diademal/nyc-tlc-wav/drawings/FF-1.pdf

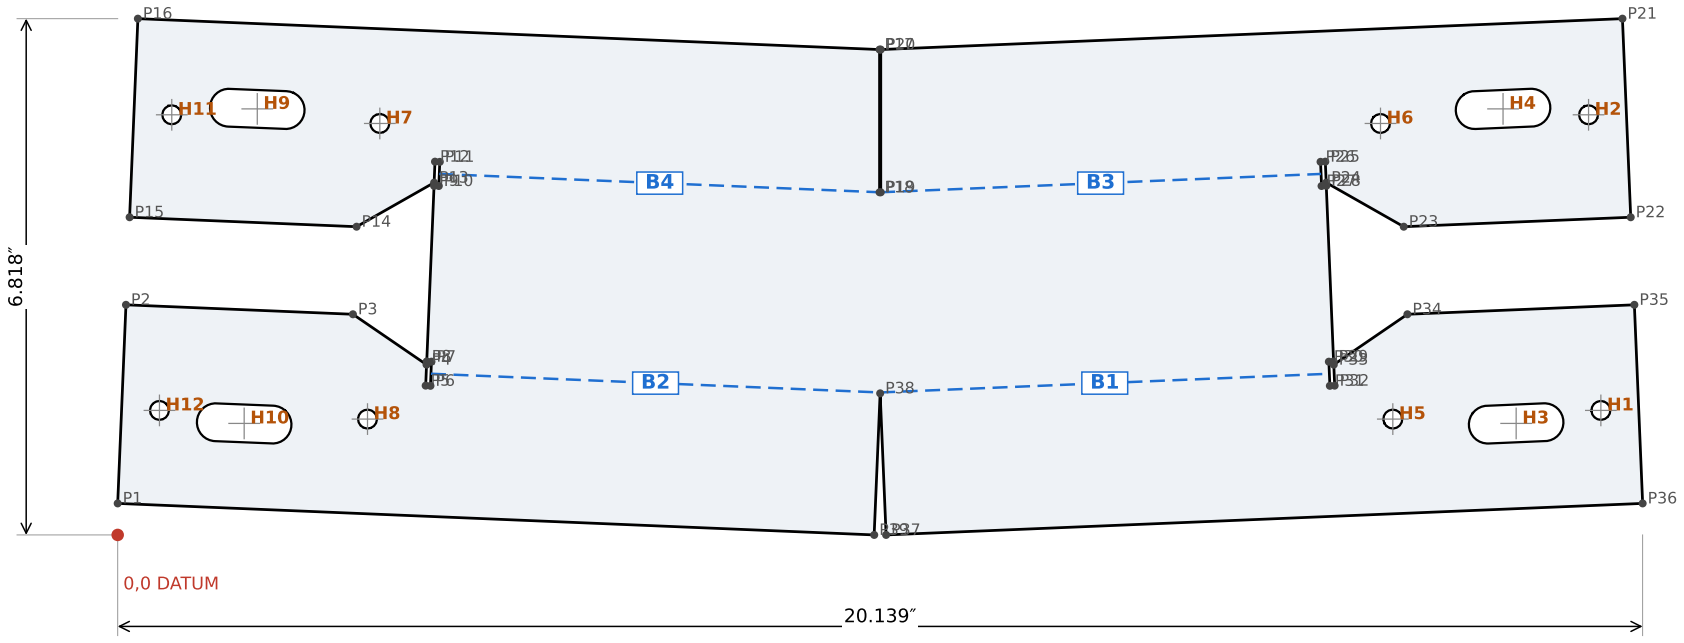
[picture p1: figure]
0,0 DATUM

FF-1 | blank 1 of 1
Channel with ears | flat pattern, one piece (4 bends 90°, web on top)

HR steel sheet 10 ga (0.135 )

QTY: 1 per vehicle

inches · flat blank, 1:1 in DXF

cut ±0.010 · bends ±1° · IR = t

Sienna WAV frame · 2026-10-02

## SHEET 1 / 1

FF-1 | blank 1 of 1
Channel with ears | flat pattern, one piece (4 bends 90°, web on top) · blank 20.139 × 6.818 · HR steel sheet 10 ga (0.135 ) · 1 per vehicle

### HOLES (centre X, Y from datum)

H1 Ø0.250 | X 19.588 | Y 1.644
H2 Ø0.250 | X 19.425 | Y 5.548
H3 slot 1.250 × 0.500 @2° X 18.469 Y 1.473 H4 slot 1.250 × 0.500 @2° X 18.296 Y 5.627
H5 Ø0.250 | X 16.840 | Y 1.530
H6 Ø0.250 | X 16.678 | Y 5.434
H7 Ø0.250 | X 3.462 | Y 5.434
H8 Ø0.250 | X 3.299 | Y 1.530
H9 slot 1.250 × 0.500 @-2° X 1.844 Y 5.627 H10 slot 1.250 × 0.500 @-2° X 1.670 Y 1.473
H11 Ø0.250 | X 0.714 | Y 5.548
H12 Ø0.250 | X 0.552 | Y 1.644

### BENDS (bend centre line, from datum) IR = t = 10 ga (0.135 )

B1 (1)/(3) 90° | (10.070, 1.881) | (16.002, 2.129)
B2 (2)/(4) 90° | (4.137, 2.129) | (10.070, 1.881)
B3 radius-bend edge | (10.070, 4.525) | (15.892, 4.768)
B4 radius-bend edge | (4.247, 4.768) | (10.070, 4.525)
radius-bend edge = start/end of a large-radius bend (bump bend between them)

### OUTLINE POINTS (X, Y from datum)

P1 | 0.000 | 0.416
P2 | 0.109 | 3.039
P3 | 3.107 | 2.914
P4 | 4.079 | 2.249
P5 | 4.067 | 1.972
P6 | 4.131 | 1.969
P7 | 4.144 | 2.288
P8 | 4.082 | 2.291
P9 | 4.178 | 4.610
P10 | 4.241 | 4.608
P11 | 4.254 | 4.927
P12 | 4.191 | 4.930
P13 | 4.179 | 4.653
P14 | 3.155 | 4.071
P15 | 0.158 | 4.196
P16 | 0.267 | 6.818
P17 | 10.062 | 6.410
P18 | 10.062 | 4.525
P19 | 10.078 | 4.525
P20 | 10.078 | 6.410
P21 | 19.873 | 6.818
P22 | 19.982 | 4.196
P23 | 16.985 | 4.071
P24 | 15.960 | 4.653
P25 | 15.949 | 4.930
P26 | 15.886 | 4.927
P27 | 15.899 | 4.608
P28 | 15.961 | 4.610
P29 | 16.058 | 2.291
P30 | 15.995 | 2.288
P31 | 16.009 | 1.969
P32 | 16.072 | 1.971
P33 | 16.061 | 2.249
P34 | 17.033 | 2.914
P35 | 20.030 | 3.039
P36 | 20.140 | 0.416
P37 | 10.148 | 0.000
P38 | 10.070 | 1.870
P39 | 9.991 | 0.000

NOTES

1. Cut from the DXF file (1:1, inches). This sheet is for checking.
2. Material: HR steel sheet 10 ga (0.135 ) (t). Inside bend radius = t.
3. Flat pattern already includes bend allowance (K = 0.44, R = t).
4. Blue dashed = bend centre lines (B1, B2 ...). = bend DOWN (away from you), no arrow = bend UP. Red dashed = drill later.
5. Deburr all edges. Curved edges: smooth arcs per DXF.
* one blank: the web is a chevron 6 +6 (ends ¼ out); bend the walls 90° down on the dashed lines, each in 2 hits (6
to the middle); outer wall has a V-notch | closes after bending, weld it; inner wall has a slit | opens ~0.16 after
bending, weld it; the ears reach past the bend line; 1/16 relief slit at the bend end
