diademal/nyc-tlc-wav/drawings/FR-2-bent.pdf

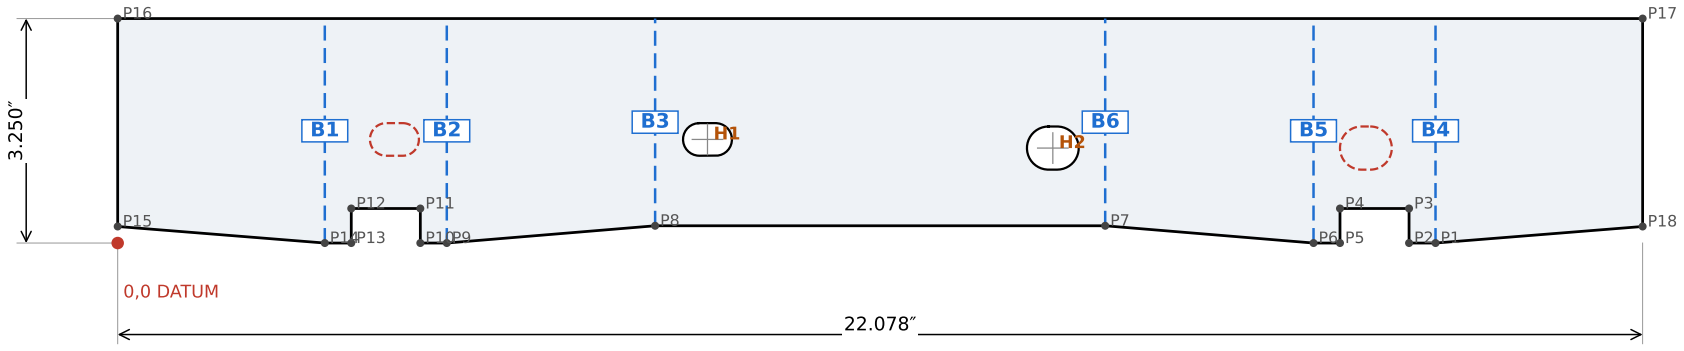
[picture p2: figure]
0,0 DATUM

## FR-2 (bent version) blank 1 of 1

FR-2 one piece (top + 2 U legs)

### HR steel sheet 10 ga (0.135 )

QTY: 1 per side · FR + FL (mirror) = 2 per vehicle inches · flat blank, 1:1 in DXF

cut ±0.010 · bends ±1° · IR = t

Sienna WAV frame · 2026-10-02

### SHEET 1 / 1

# FR-2 (bent version) blank 1 of 1

FR-2 one piece (top + 2 U legs) · blank 22.078 × 3.250 · HR steel sheet 10 ga (0.135 ) · 1 per side · FR + FL (mirror) = 2 per vehicle

HOLES (centre X, Y from datum)

## H1 slot 0.709 × 0.472 @0° X 8.539 Y 1.500 H2 slot 0.750 × 0.625 @0° X 13.539 Y 1.375

DRILL AFTER WELDING (red dashed | do NOT laser cut)
D1 slot 0.709 × 0.472 | X 4.007 Y 1.500
D2 slot 0.750 × 0.625 | X 18.072 Y 1.375

BENDS (bend centre line, from datum) IR = t = 10 ga (0.135 )
B1 (1) 90° | (2.999, 0.000) | (2.999, 3.250)
B2 (3) 90° | (4.765, 0.000) | (4.765, 3.250)
B3 (5) 90° | (7.781, 0.250) | (7.781, 3.250)
B4 (2) 90° | (19.080, 0.000) | (19.080, 3.250)
B5 (4) 90° | (17.314, 0.000) | (17.314, 3.250)
B6 (6) 90° | (14.297, 0.250) | (14.297, 3.250)

OUTLINE POINTS (X, Y from datum)
P1 | 19.080 | 0.000
P2 | 18.697 | 0.000
P3 | 18.697 | 0.500
P4 | 17.697 | 0.500
P5 | 17.697 | 0.000
P6 | 17.314 | 0.000
P7 | 14.297 | 0.250
P8 | 7.781 | 0.250
P9 | 4.765 | 0.000
P10 | 4.382 | 0.000
P11 | 4.382 | 0.500
P12 | 3.382 | 0.500
P13 | 3.382 | 0.000
P14 | 2.999 | 0.000
P15 | 0.000 | 0.240
P16 | 0.000 | 3.250
P17 | 22.078 | 3.250
P18 | 22.078 | 0.240

NOTES
1. Cut from the DXF file (1:1, inches). This sheet is for checking.
2. Material: HR steel sheet 10 ga (0.135 ) (t). Inside bend radius = t.
3. Flat pattern already includes bend allowance (K = 0.44, R = t).
4. Blue dashed = bend centre lines (B1, B2 ...). = bend DOWN (away from you), no arrow = bend UP. Red dashed = drill later.
5. Deburr all edges. Curved edges: smooth arcs per DXF.
6. FR side as drawn; FL side = mirror image (flip the blank).
* one blank, 6 bends 90° the same way (R = t): inner walls first, then the bottoms, then the outer walls; top ovals laser cut; do NOT cut the leg-bottom ovals drill after welding through the top ovals; ½ notch at the front edge of
