diademal/nyc-tlc-wav/drawings/FR-7-bent.pdf

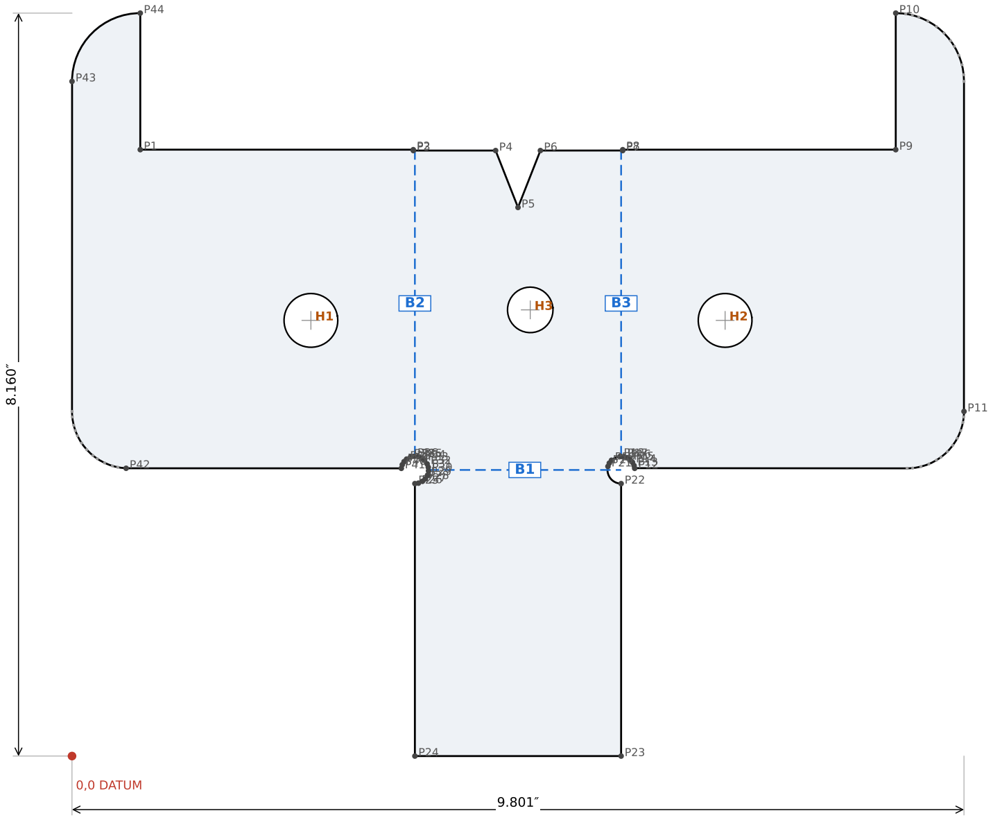
[picture p3: figure]
0,0 DATUM

## FR-7 (bent version) blank 1 of 1

FR-7 one piece (back + bottom + 2 sides)

HR steel sheet 10 ga (0.135 )

QTY: 1 per side · FR + FL (mirror) = 2 per vehicle inches · flat blank, 1:1 in DXF

cut ±0.010 · bends ±1° · IR = t

Sienna WAV frame · 2026-10-02

### SHEET 1 / 1

# FR-7 (bent version) blank 1 of 1

FR-7 one piece (back + bottom + 2 sides) · blank 9.801 × 8.160 · HR steel sheet 10 ga (0.135 ) · 1 per side · FR + FL (mirror) = 2 per vehicle

HOLES (centre X, Y from datum)
H1 Ø0.591 | X 2.625 | Y 4.785
H2 Ø0.591 | X 7.176 | Y 4.785
H3 Ø0.500 | X 5.035 | Y 4.901
BENDS (bend centre line, from datum) IR = t = 10 ga (0.135 )
B1 (1) 90° | (3.918, 3.143) | (6.034, 3.143)
B2 (2) 90° | (3.768, 3.293) | (3.768, 6.651)
B3 (3) 90° | (6.034, 3.293) | (6.034, 6.651)
CURVED EDGES (radius, centre X, Y)
R1 R 0.150 | centre 6.034, 3.143
R2 R 0.150 | centre 6.034, 3.143
R3 R 0.750 | centre 0.750, 7.410
OUTLINE POINTS (X, Y from datum)
P1 | 0.750 | 6.660
P2 | 3.750 | 6.660
P3 | 3.750 | 6.651
P4 | 4.655 | 6.651
P5 | 4.901 | 6.026
P6 | 5.147 | 6.651
P7 | 6.051 | 6.651
P8 | 6.051 | 6.660
P9 | 9.051 | 6.660
P10 | 9.052 | 8.160
P11 | 9.802 | 3.785
P12 | 6.183 | 3.160
P13 | 6.176 | 3.191
P14 | 6.159 | 3.226
P15 | 6.133 | 3.255
P16 | 6.100 | 3.277
P17 | 6.063 | 3.290
P18 | 6.024 | 3.292
P19 | 5.928 | 3.249
P20 | 5.904 | 3.218
P21 | 5.889 | 3.181
P22 | 6.034 | 2.993
P23 | 6.034 | 0.000
P24 | 3.768 | 0.000
P25 | 3.768 | 2.993
P26 | 3.806 | 2.998
P27 | 3.851 | 3.018
P28 | 3.880 | 3.044
P29 | 3.906 | 3.085
P30 | 3.917 | 3.133
P31 | 3.915 | 3.172
P32 | 3.902 | 3.209
P33 | 3.874 | 3.249
P34 | 3.843 | 3.272
P35 | 3.806 | 3.288
P36 | 3.758 | 3.292
P37 | 3.719 | 3.285
P38 | 3.676 | 3.262
P39 | 3.649 | 3.234
P40 | 3.629 | 3.200
P41 | 3.619 | 3.160
P42 | 0.594 | 3.161
P43 | 0.000 | 7.410
P44 | 0.750 | 8.160
FREE-FORM CURVE 1 (grey dots, follow DXF) | points X, Y
9.162 | 8.152
9.234 | 8.138
9.304 | 8.116
9.405 | 8.072

NOTES

1. Cut from the DXF file (1:1, inches). This sheet is for checking.
2. Material: HR steel sheet 10 ga (0.135 ) (t). Inside bend radius = t.
3. Flat pattern already includes bend allowance (K = 0.44, R = t).
4. Blue dashed = bend centre lines (B1, B2 ...). = bend DOWN (away from you), no arrow = bend UP. Red dashed = drill later.
5. Deburr all edges. Curved edges: smooth arcs per DXF.
6. FR side as drawn; FL side = mirror image (flip the blank).
* one blank, 3 bends 90° the same way (R = t): bottom first, then the sides; Ø0.3 round reliefs in the two corners; after bending weld the side-to-bottom seams; V notch and Ø0.5 hole in the back, Ø0.591 holes in the sides

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
