diademal/nyc-tlc-wav/drawings/FR-6.pdf

FR-6 tubes | | inches · flat blank, 1:1 in DXF | Sienna WAV frame · 2026-10-02
Tube 3×3 cut 14 ¼ | QTY: 1 per side · FR + FL (mirror) = 2 per vehicle | cut ±0.010 · bends ±1° · IR = t | SHEET 1 / 1

# FR-6 cut list (tubes)

# Tube 3×3 cut 14 ¼

Stock: Square tube 3 × 3 , wall 3/16 | · cut length 14.250 | · QTY 1 per side · FR + FL (mirror) = 2 per vehicle

wall 3/16

Cut square, ±1/32 . Deburr. Lengths in inches.
