diademal/nyc-tlc-wav/drawings/LASER/STAINLESS_18ga_sheet1_of1_12x24.pdf

STAINLESS 18ga — sheet 1 of 1 — 12 x 24 in — 1 parts — 1 vehicle set (RA-9) — Stainless 304 brushed (#4), 18 ga, t = 0.048 in (1.2 mm)

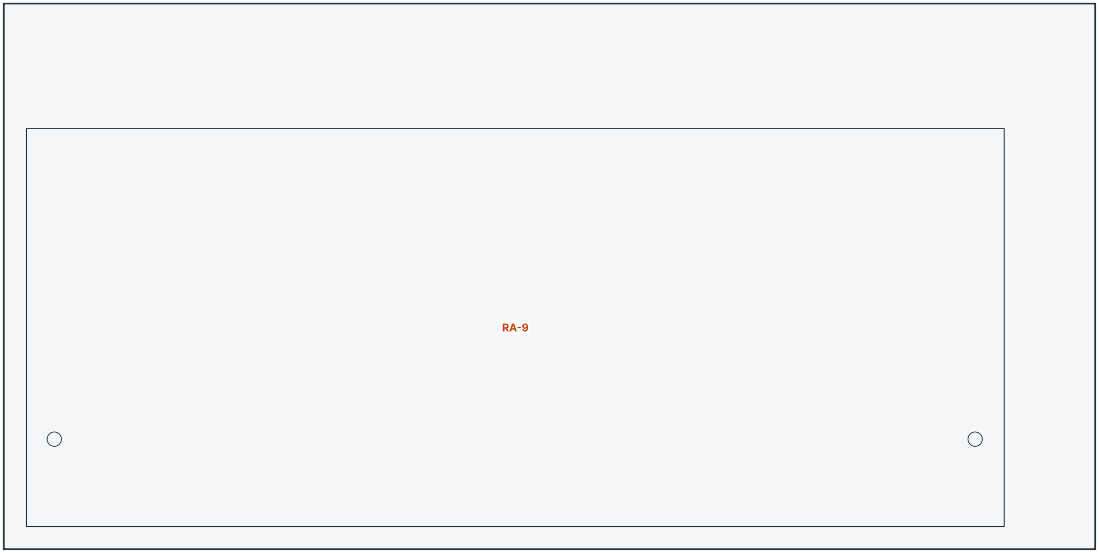
[picture p4: figure]
