diademal/nyc-tlc-wav/drawings/MFG/00_INDEX.pdf

Item | Material / thickness | Flat (in) | Bend lines | Qty / vehicle | lb each | Process
FR-1 | HR steel A1011 CS, 11 ga 0.1196″ (3.04 mm) | 8.538 × 13.853 | 2 | 1 FR + 1 FL | 2.04 | laser + 2 bends
FR-2 | HR steel A1011 CS, 11 ga 0.1196″ (3.04 mm) | 22.264 × 3.250 | 6 | 1 FR + 1 FL | 2.27 | laser + 6 bends + weld
FR-3 | HR steel A1011 CS, 11 ga 0.1196″ (3.04 mm) | 4.084 × 8.000 | 2 | 1 FR + 1 FL | 1.03 | laser + 2 bends
FR-4-1 strip | HR steel A1011 CS, 11 ga 0.1196″ (3.04 mm) | 18.827 × 2.746 | 9 | 1 FR + 1 FL | 1.63 | laser + 5 bends (2 radius)
FR-4-2 side A | HR steel A1011 CS, 11 ga 0.1196″ (3.04 mm) | 6.500 × 6.875 | 0 | 1 FR + 1 FL | 0.71 | laser
FR-4-3 side B | HR steel A1011 CS, 11 ga 0.1196″ (3.04 mm) | 6.500 × 6.875 | 0 | 1 FR + 1 FL | 0.71 | laser
FR-5 | HR steel A1011 CS, 11 ga 0.1196″ (3.04 mm) | 10.694 × 6.198 | 2 | 1 FR + 1 FL | 1.41 | laser + 2 bends
FR-7 | HR steel A1011 CS, 11 ga 0.1196″ (3.04 mm) | 9.853 × 8.186 | 3 | 1 FR + 1 FL | 1.45 | laser + 3 bends + weld
FR-8 | HR steel A1011 CS, 11 ga 0.1196″ (3.04 mm) | 6.209 × 12.000 | 2 | 1 FR + 1 FL | 1.79 | laser + 2 bends
FR-10-1 U-body | HR steel A1011 CS, 11 ga 0.1196″ (3.04 mm) | 12.374 × 11.235 | 3 | 1 FR + 1 FL | 2.29 | laser + 3 bends + drill
FR-10-2 strip | HR steel A1011 CS, 11 ga 0.1196″ (3.04 mm) | 12.560 × 2.746 | 3 | 1 FR + 1 FL | 1.05 | laser + 3 bends
FR-11 | HR steel A1011 CS, 11 ga 0.1196″ (3.04 mm) | 5.125 × 2.000 | 0 | 2 FR + 2 FL | 0.25 | laser
FF-1 | HR steel A1011 CS, 11 ga 0.1196″ (3.04 mm) | 20.142 × 6.870 | 4 | 1 | 3.89 | laser + 4 bends + weld
FF-3-1 top | HR steel A1011 CS, 11 ga 0.1196″ (3.04 mm) | 39.403 × 15.073 | 10 | 1 | 17.70 | laser + 10 bends
FF-3-2 lower | HR steel A1011 CS, 11 ga 0.1196″ (3.04 mm) | 39.000 × 14.595 | 2 | 1 | 16.12 | laser + 2 bends
FF-3-3 wall | HR steel A1011 CS, 11 ga 0.1196″ (3.04 mm) | 4.687 × 1.125 | 0 | 2 | 0.18 | laser
FF-3-4 wall | HR steel A1011 CS, 11 ga 0.1196″ (3.04 mm) | 5.013 × 1.125 | 0 | 2 | 0.19 | laser
RA-1 | Aluminum 5052-H32, 0.125″ (3.18 mm) | 22.000 × 34.566 | 2 | 1 | 8.07 | laser + bends
RA-2 | Aluminum 5052-H32, 0.125″ (3.18 mm) | 23.533 × 34.941 | 3 | 1 | 9.87 | laser + bends
RA-3 | Aluminum 5052-H32, 0.125″ (3.18 mm) | 19.658 × 45.066 | 3 | 1 | 9.10 | laser + bends
RA-4 | Aluminum 5052-H32, 0.125″ (3.18 mm) | 6.691 × 33.500 | 2 | 1 | 2.69 | laser + bends
RA-5 | Aluminum 5052-H32, 0.125″ (3.18 mm) | 9.783 × 33.500 | 1 | 1 | 2.37 | laser + bends
RA-6 | Aluminum 5052-H32, 0.125″ (3.18 mm) | 3.066 × 30.000 | 2 | 1 | 1.11 | laser + bends
RA-7 | Aluminum 5052-H32, 0.125″ (3.18 mm) | 40.631 × 22.556 | 4 | 1 | 10.30 | laser + bends
RA-8 | Aluminum 5052-H32, 0.125″ (3.18 mm) | 4.625 × 4.066 | 2 | 2 | 0.18 | laser + bends
FR-4 tube | DOM OD 1.500 × ID 1.181 (wall 0.160″) | cut 3.689 | — | 1 FR + 1 FL | | saw
FR-6 | Sq. tube 3×3 A500, wall 11 ga 0.120″ | cut 14.250 | — | 1 FR + 1 FL | | saw
FR-9 | Sq. tube 3×3 A500, wall 11 ga 0.120″ | cut 8.000 | — | 1 FR + 1 FL | | saw
FR-10 tube | DOM OD 1.500 × ID 1.181 (wall 0.160″) | cut 3.407 | — | 1 FR + 1 FL | | saw
FF-4 | Sq. tube 1½×1½ A500, wall 11 ga 0.120″ | cut 39.000 | — | 1 | | saw

# Sienna WAV — manufacturing package REV B (2026-10-31): frame + ramp

Frame: everything that was 10 ga is now 11 ga (0.1196″); square tubes 11 ga wall. Ramp: aluminum 5052-H32 0.125″. Units inch. Inside bend radius = t, K = 0.44.
