diademal/nyc-tlc-wav/drawings/MFG/FR-5_drawing.pdf

## MATERIAL: HR steel sheet A1011 CS THICKNESS: 11 ga t = 0.1196″ (3.04 mm)

2.056

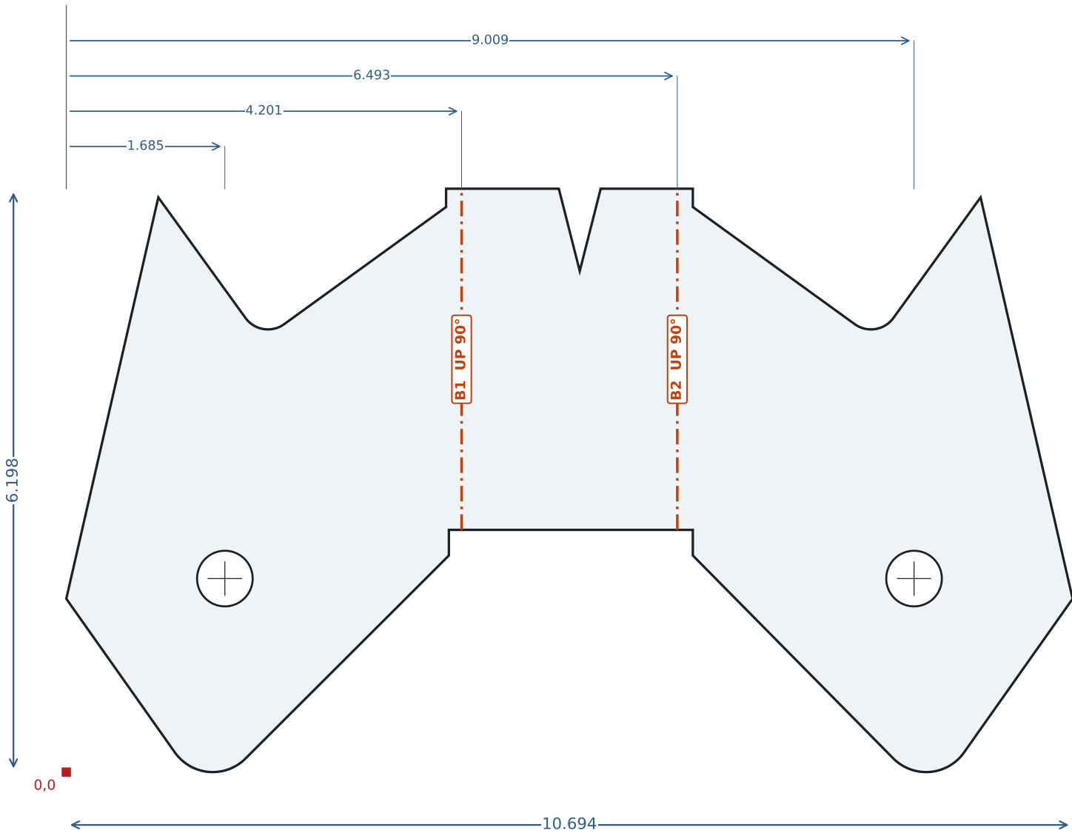
[picture p21: figure]

### FR-5 · 11 ga 0.120″ (3.04 mm) · HR steel sheet A1011 CS

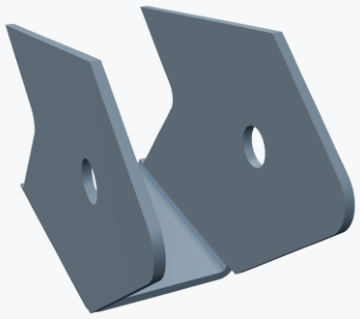
[picture p22: figure]

(shape; thickness now 11 ga 0.120″)

FR-5 | U-body bracket

FR-5 · U-body (2 sides + plate A-C)

HR steel sheet A1011 CS 11 ga 0.120″ (3.04 mm)

QTY 1 FR + 1 FL = 2 per vehicle

Units: inch · NOT TO SCALE

Tol.: cut ±0.010″ · bend ±1° · IR = t

Sienna WAV frame

2026-10-31

## REV B

### SHEET 1/1

# FR-5 · U-body (2 sides + plate A-C)

11 ga 0.120″ (3.04 mm) · HR steel sheet A1011 CS · flat blank 10.694″ × 6.198″ · ≈ 1.41 lb each · QTY 1 FR + 1 FL = 2 per vehicle

FLAT PATTERN (as laser-cut, marked side up) | FORMED PART (after bending)

## BEND TABLE

Bend | Angle | Direction | Inside R | Order | Bend line position
B1 | 90.0° | UP (toward) | R=t 0.120 | 1 | X = 4.201
B2 | 90.0° | UP (toward) | R=t 0.120 | 2 | X = 6.493

## HOLES (centre from 0,0)

Hole | Size | X | Y | Made by
H1 | Ø0.591 | 1.685 | 2.056 | laser
H2 | Ø0.591 | 9.009 | 2.056 | laser

## FILES

- FR-5_FR_cut.dxf (right, qty 1 / vehicle)
- FR-5_FL_cut.dxf (left = mirror, qty 1 / vehicle)
- FR-5_ref.dxf (reference: + bend lines, drill-later, material notes)

## NOTES

1. Laser cut from the *_cut.dxf file (1:1, inch). The DXF governs the geometry; dimensions here are for checking.
2. MATERIAL HR steel sheet A1011 CS, 11 ga t = 0.1196″ (3.04 mm). Bend allowance (K = 0.44, inside radius = t) is already in the flat.

Bend on the orange lines; UP = toward you when the part lies as drawn.
3. Holes marked DRILL LATER (red dashed) are not laser cut - drill after bending/welding.
4. Deburr all edges, remove dross.
5. Right part (FR) shown. Left part (FL) = mirror: cut *_FL_cut.dxf, bend the same UP/DOWN. * 90° bends, R = t
