diademal/nyc-tlc-wav/drawings/MFG/FR-7_drawing.pdf

## MATERIAL: HR steel sheet A1011 CS THICKNESS: 11 ga t = 0.1196″ (3.04 mm)

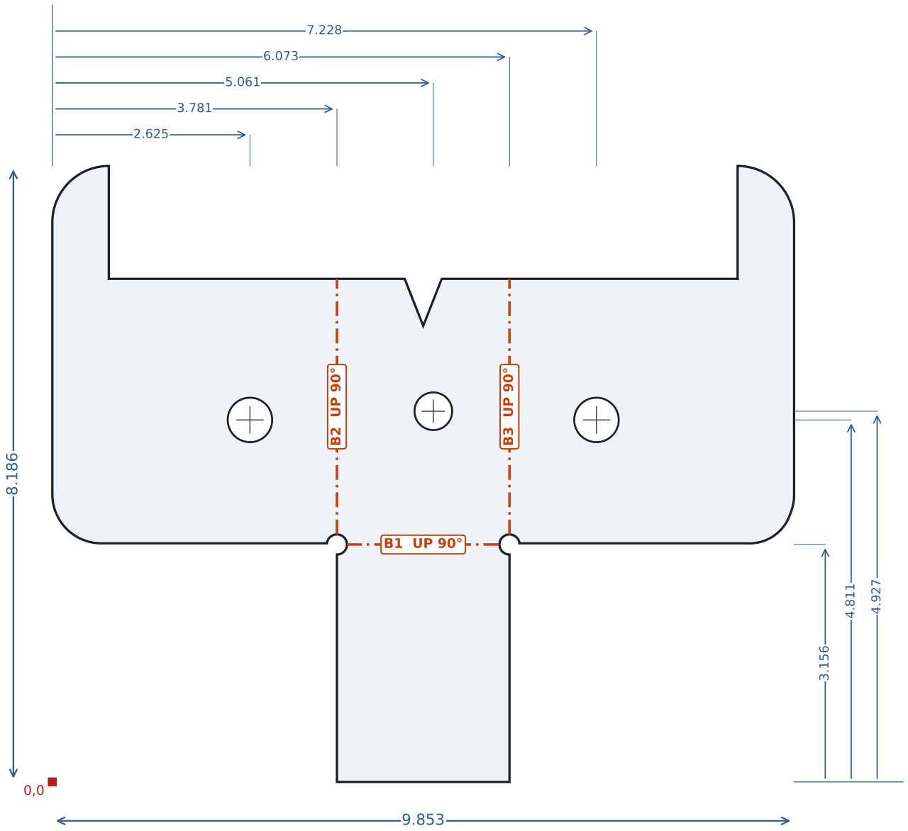
[picture p23: figure]

### FR-7 · 11 ga 0.120″ (3.04 mm) · HR steel sheet A1011 CS

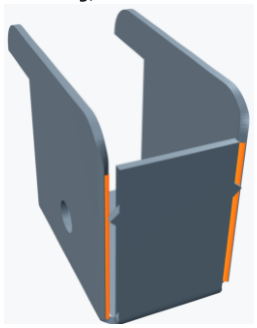
[picture p24: figure]

(shape; thickness now 11 ga 0.120″)

FR-7 | Tray bracket (back + bottom + 2 sides)

FR-7 · FR-7 one piece (back + bottom + 2 sides)

HR steel sheet A1011 CS 11 ga 0.120″ (3.04 mm)

QTY 1 FR + 1 FL = 2 per vehicle

Units: inch · NOT TO SCALE

Tol.: cut ±0.010″ · bend ±1° · IR = t

Sienna WAV frame

2026-10-31

## REV B

### SHEET 1/1

# FR-7 · FR-7 one piece (back + bottom + 2 sides)

11 ga 0.120″ (3.04 mm) · HR steel sheet A1011 CS · flat blank 9.853″ × 8.186″ · ≈ 1.45 lb each · QTY 1 FR + 1 FL = 2 per vehicle

FLAT PATTERN (as laser-cut, marked side up) | FORMED PART (after bending)

## BEND TABLE

Bend | Angle | Direction | Inside R | Order | Bend line position
B1 | 90.0° | UP (toward) | R=t 0.120 | 1 | Y = 3.156
B2 | 90.0° | UP (toward) | R=t 0.120 | 2 | X = 3.781
B3 | 90.0° | UP (toward) | R=t 0.120 | 3 | X = 6.073

## HOLES (centre from 0,0)

Hole | Size | X | Y | Made by
H1 | Ø0.591 | 2.625 | 4.811 | laser
H2 | Ø0.500 | 5.061 | 4.927 | laser
H3 | Ø0.591 | 7.228 | 4.811 | laser

## FILES

- FR-7_FR_cut.dxf (right, qty 1 / vehicle)
- FR-7_FL_cut.dxf (left = mirror, qty 1 / vehicle)
- FR-7_ref.dxf (reference: + bend lines, drill-later, material notes)

## NOTES

1. Laser cut from the *_cut.dxf file (1:1, inch). The DXF governs the geometry; dimensions here are for checking.
2. MATERIAL HR steel sheet A1011 CS, 11 ga t = 0.1196″ (3.04 mm). Bend allowance (K = 0.44, inside radius = t) is already in the flat.

Bend on the orange lines; UP = toward you when the part lies as drawn.
3. Holes marked DRILL LATER (red dashed) are not laser cut - drill after bending/welding.
4. Deburr all edges, remove dross.
5. Right part (FR) shown. Left part (FL) = mirror: cut *_FL_cut.dxf, bend the same UP/DOWN.
* one blank, 3 bends 90° the same way (R = t): bottom first, then the sides; Ø0.3 round reliefs in the two corners; after bending weld the side-to-

bottom seams; V notch and Ø0.5 hole in the back, Ø0.591 holes in the sides
