diademal/nyc-tlc-wav/drawings/LASER/ALUMINUM_0.125_sheet1_of1_48x96.webp

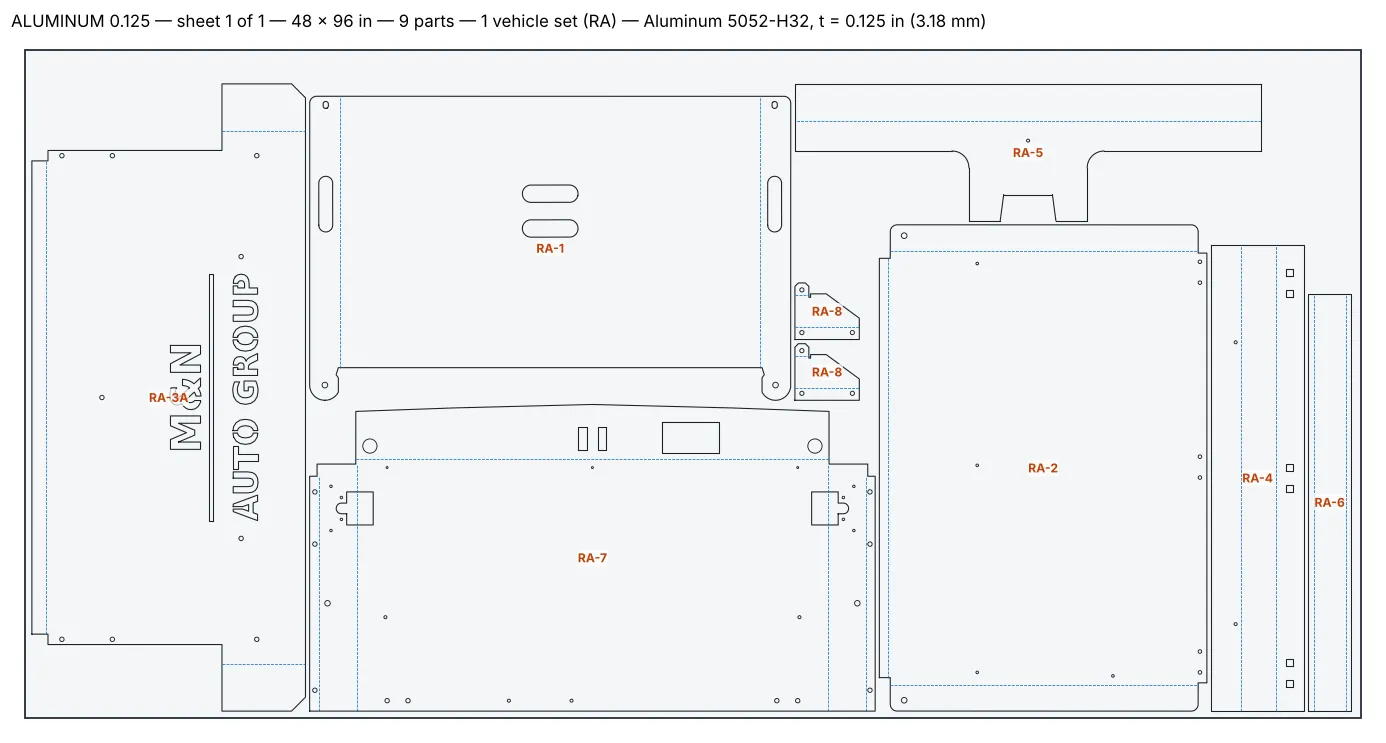
drawings/LASER/ALUMINUM_0.125_sheet1_of1_48x96.webp
