diademal/nyc-tlc-wav/drawings/LASER/STAINLESS_18ga_sheet1_of1_12x24.webp

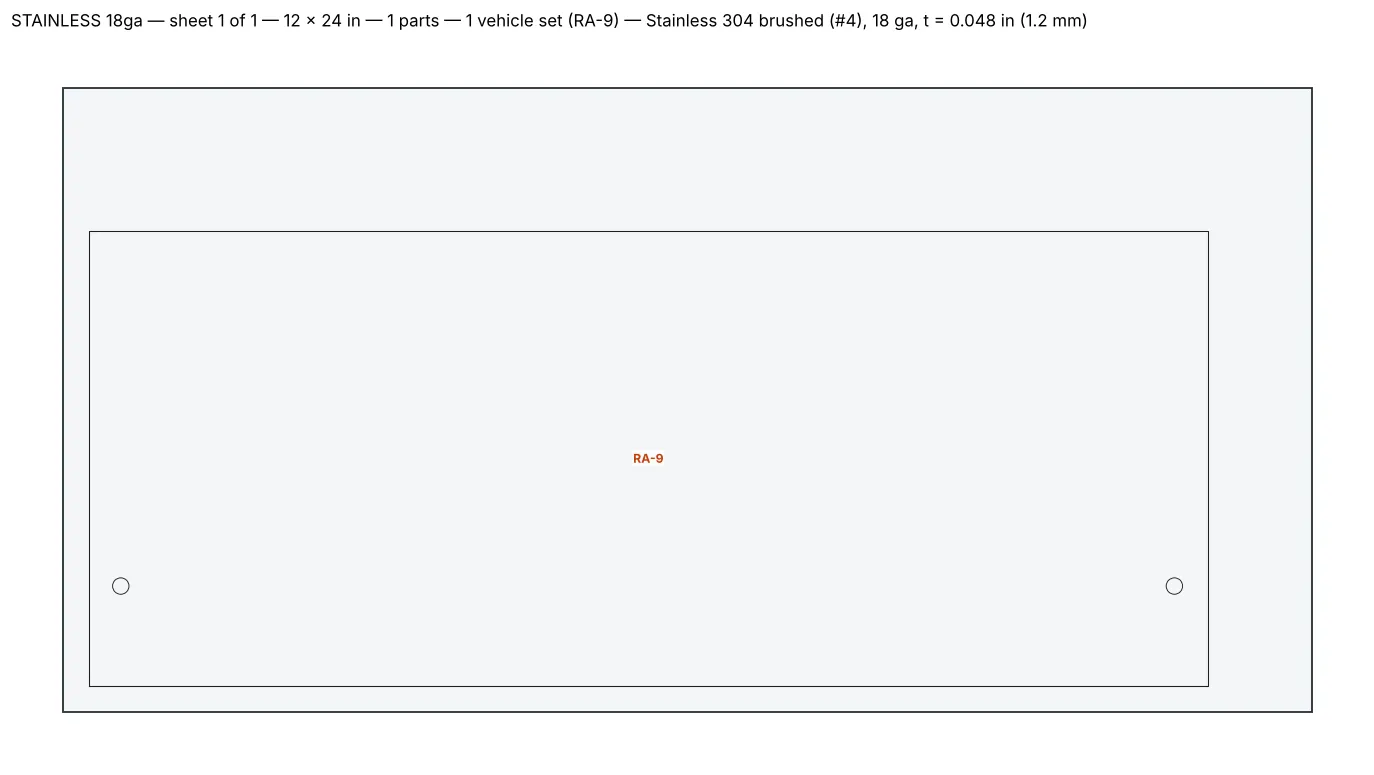
drawings/LASER/STAINLESS_18ga_sheet1_of1_12x24.webp
