diademal/nyc-tlc-wav/drawings/LASER/STEEL_11ga_sheet1_of1_48x96.webp

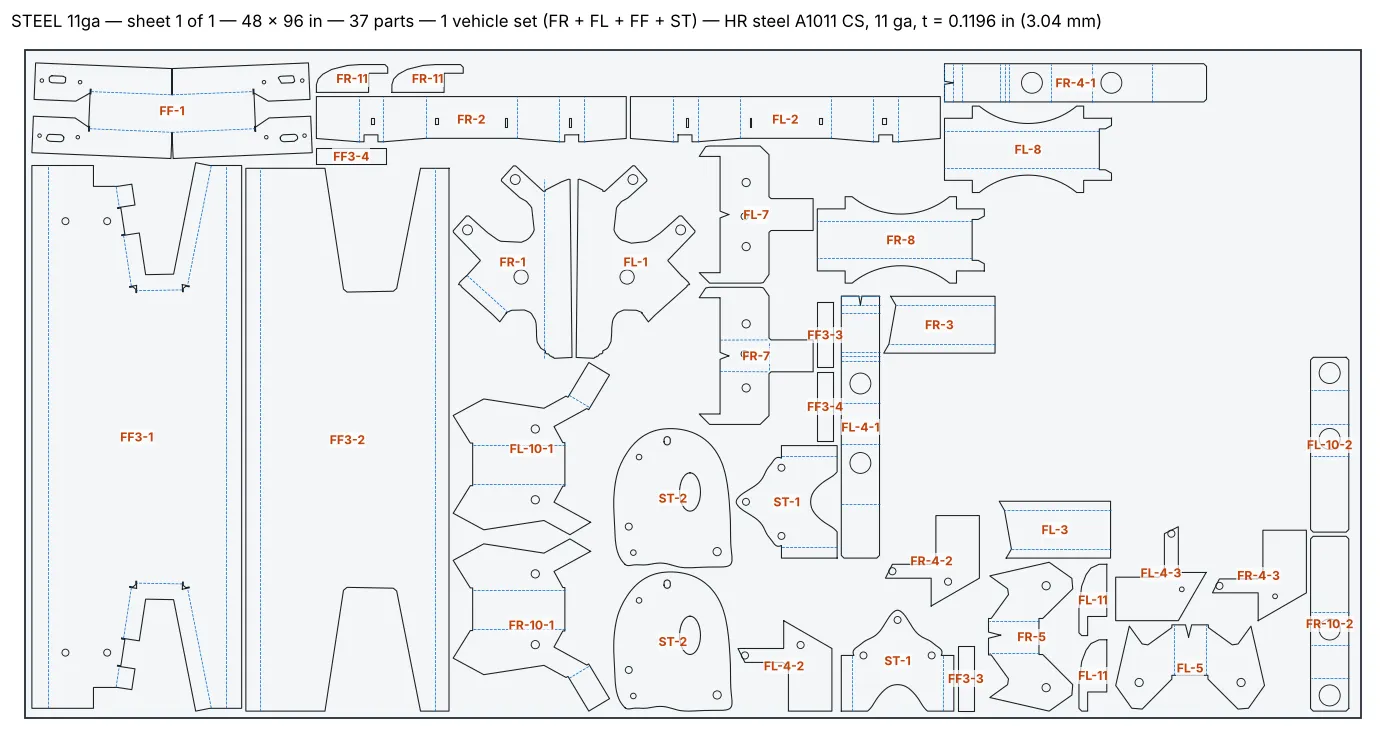
drawings/LASER/STEEL_11ga_sheet1_of1_48x96.webp
