diademal/nyc-tlc-wav/drawings/MFG/RA-1_preview.webp

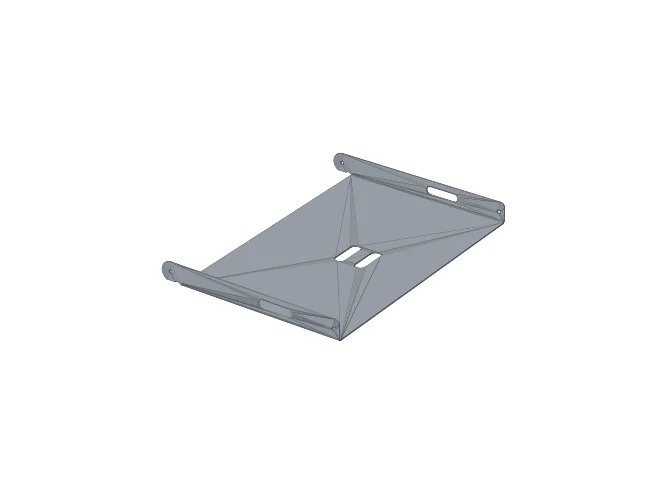
drawings/MFG/RA-1_preview.webp
