diademal/nyc-tlc-wav/drawings/MFG/RA-3_preview.webp

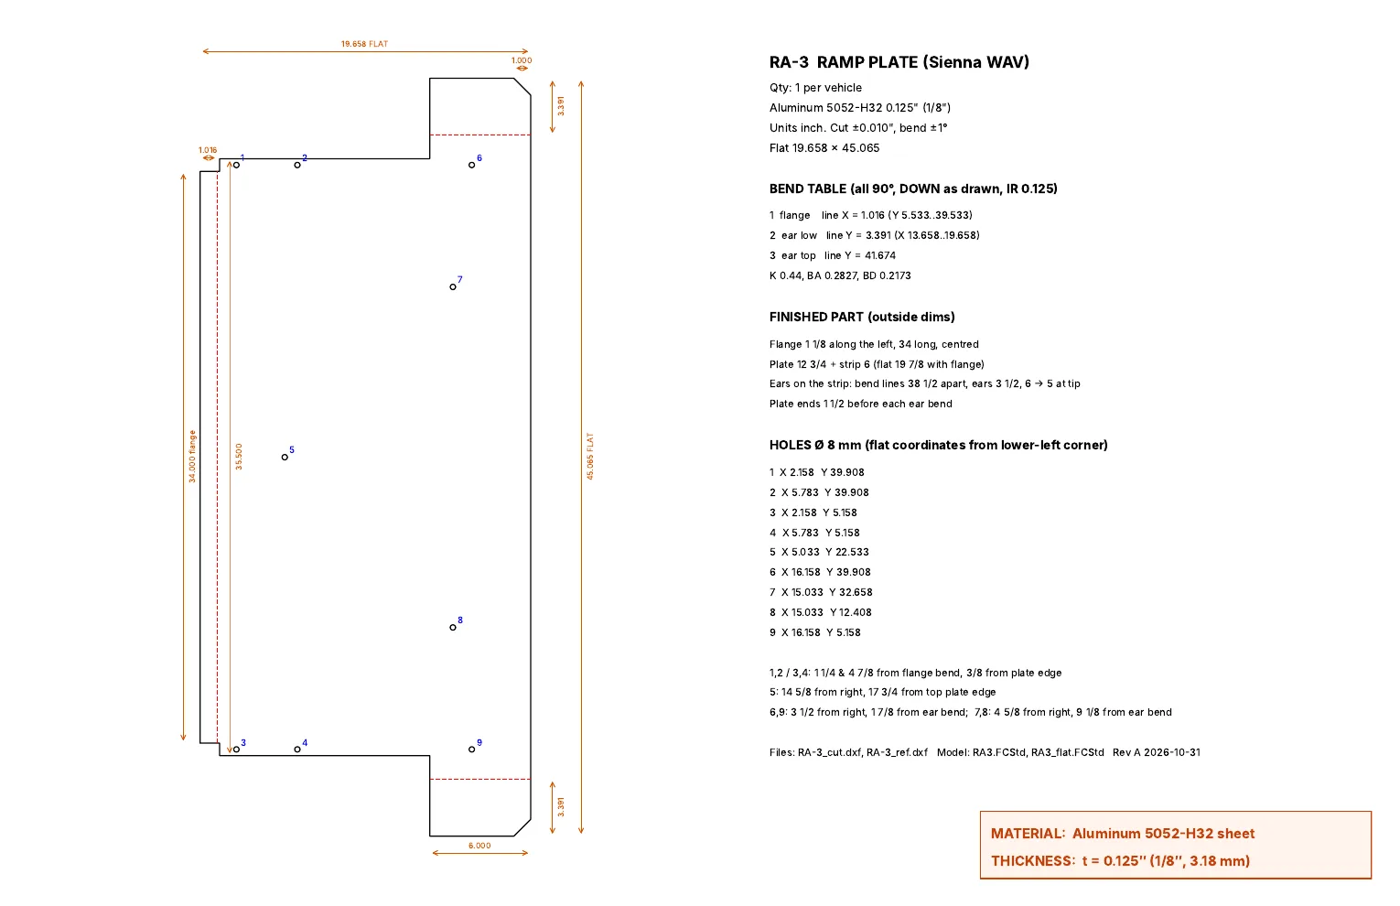
drawings/MFG/RA-3_preview.webp
