diademal/nyc-tlc-wav/drawings/MFG/RA-3A_preview.webp

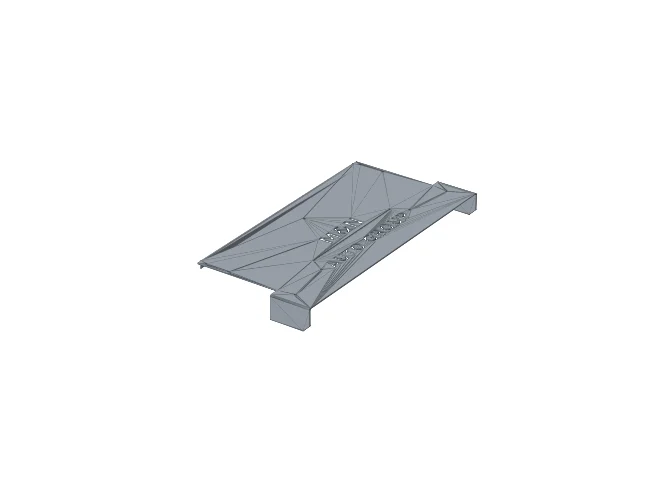
drawings/MFG/RA-3A_preview.webp
