diademal/nyc-tlc-wav/drawings/MFG/RA-4_preview.webp

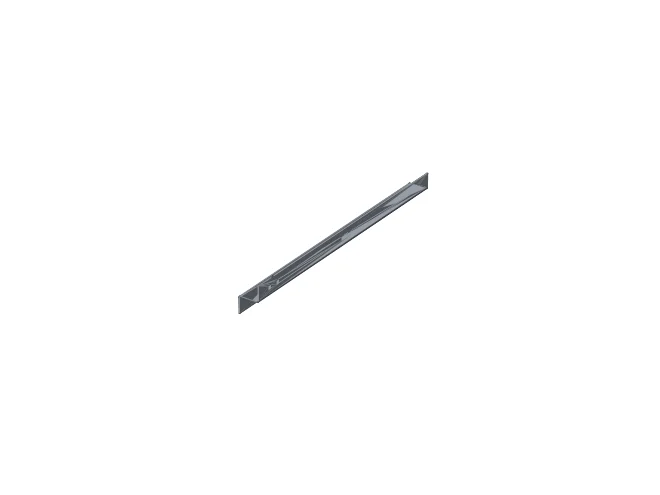
drawings/MFG/RA-4_preview.webp
