diademal/nyc-tlc-wav/drawings/MFG/RA-5_preview.webp

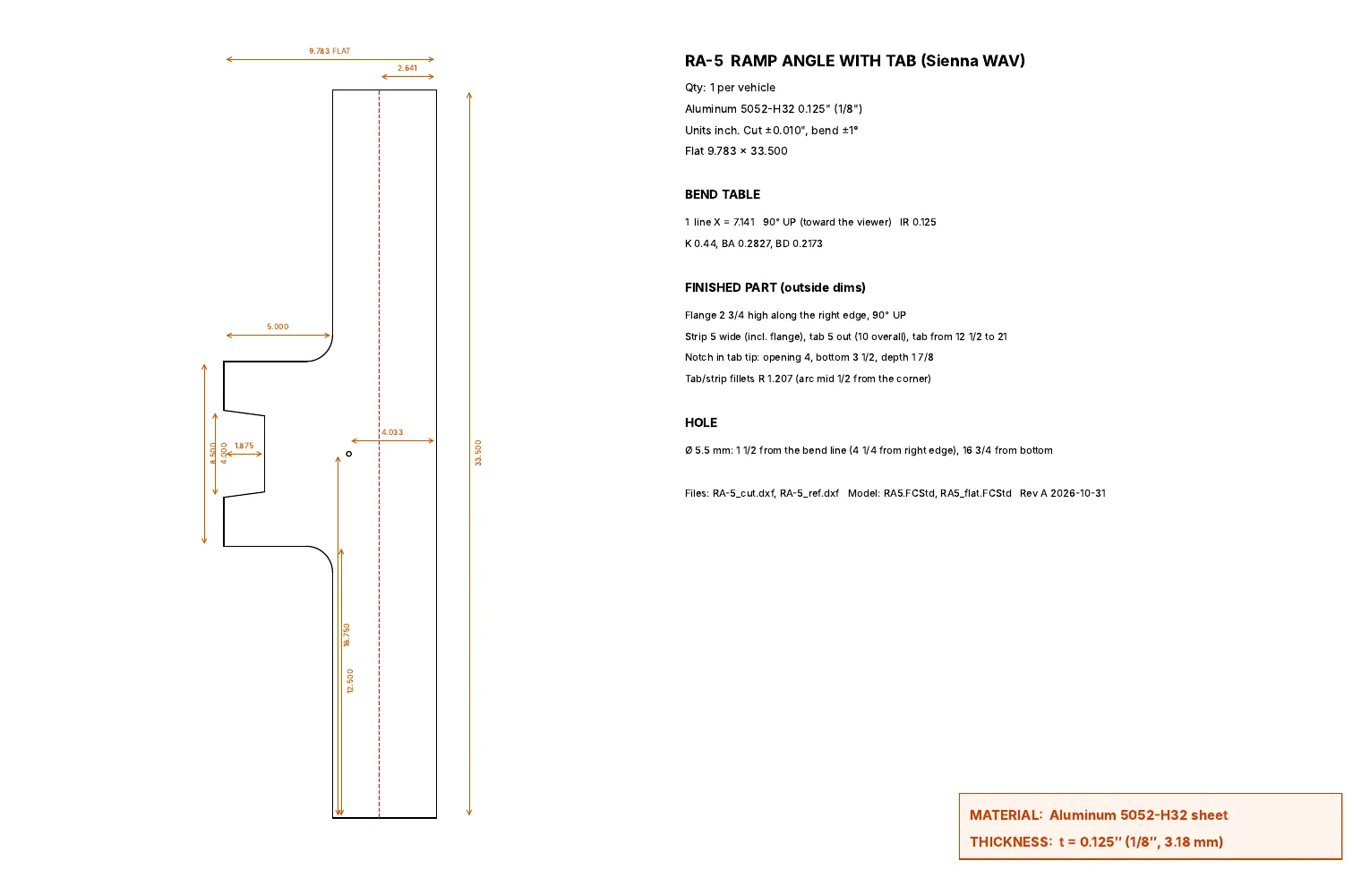
drawings/MFG/RA-5_preview.webp
