diademal/nyc-tlc-wav/drawings/MFG/RA-6_preview.webp

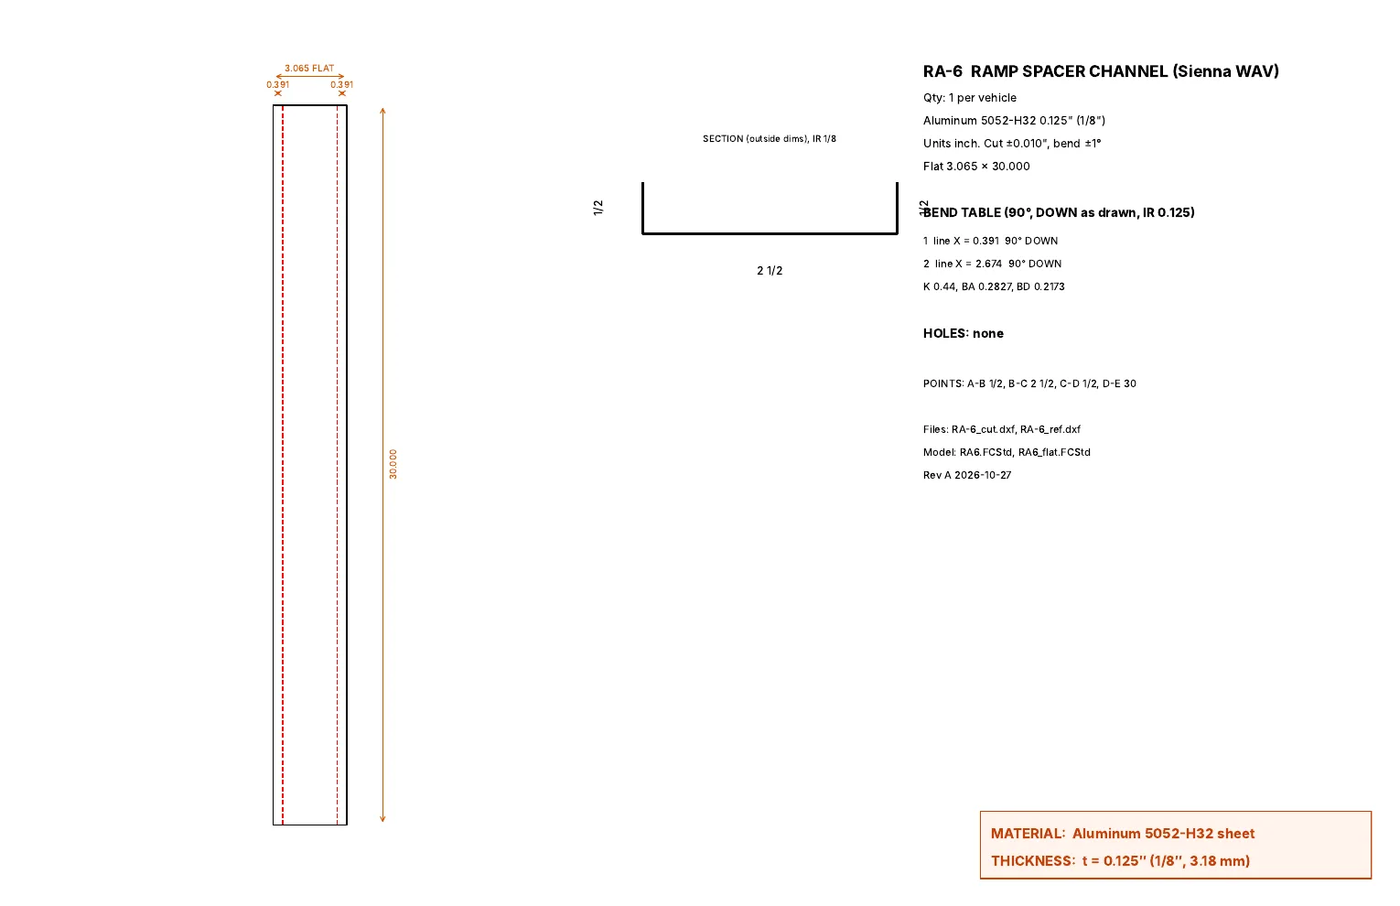
drawings/MFG/RA-6_preview.webp
