diademal/nyc-tlc-wav/drawings/MFG/RA-7_preview.webp

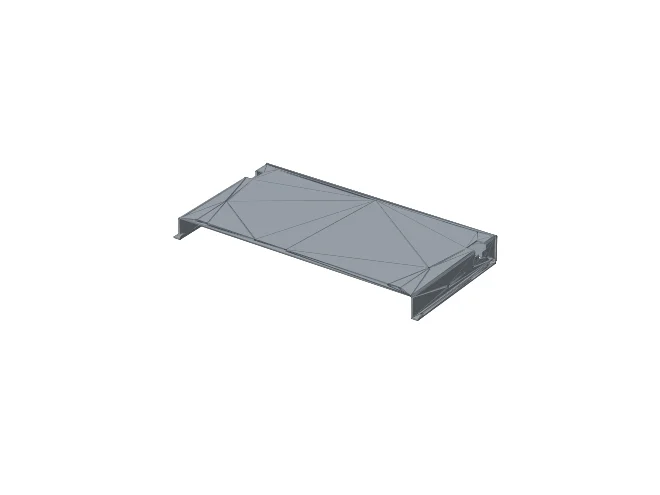
drawings/MFG/RA-7_preview.webp
