diademal/nyc-tlc-wav/drawings/MFG/RA-8_preview.webp

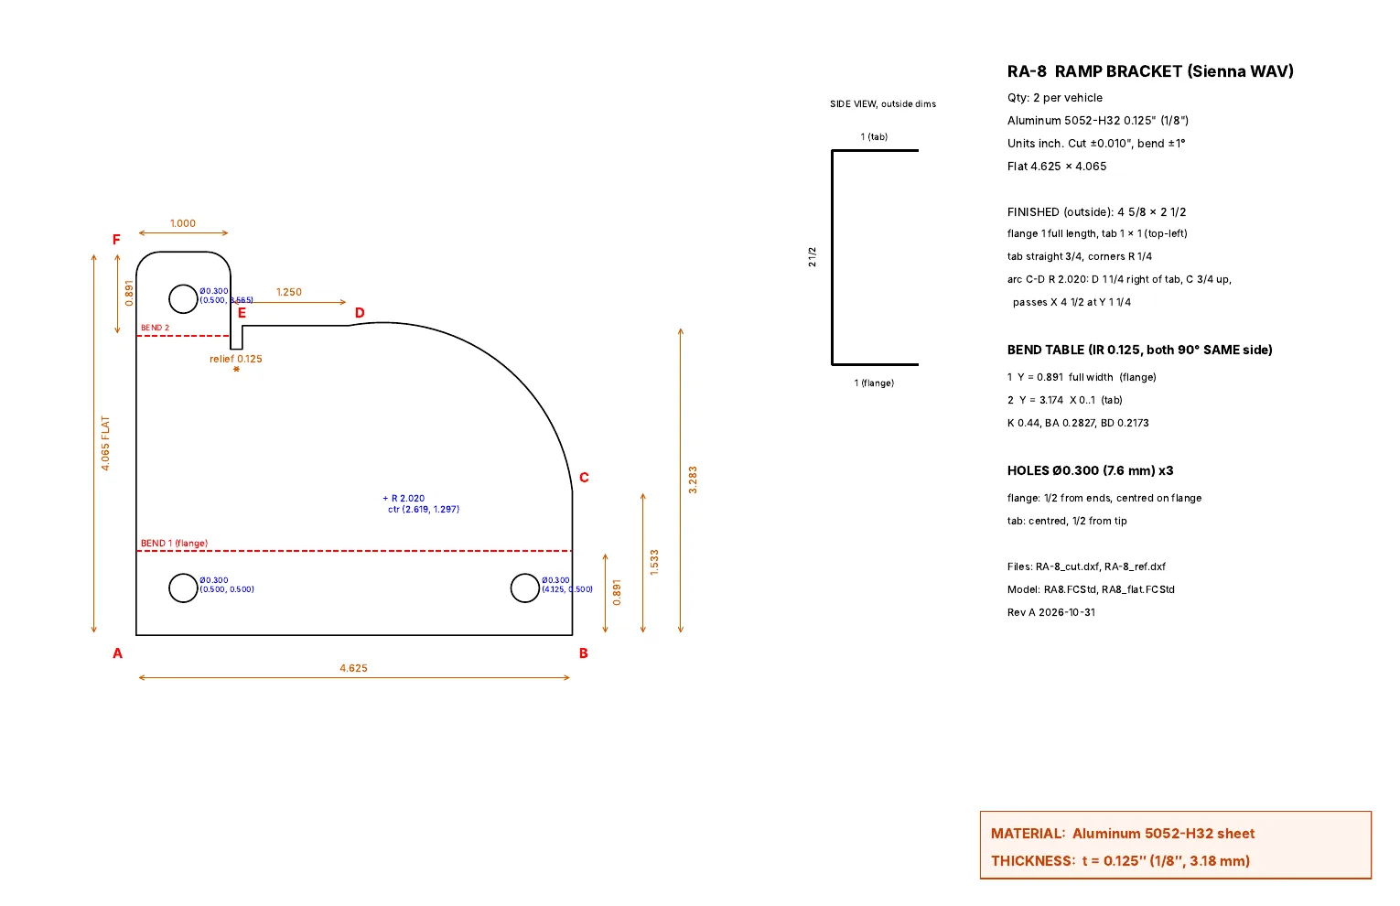
drawings/MFG/RA-8_preview.webp
