diademal/nyc-tlc-wav/drawings/LASER/ALUMINUM_0.125_parts.csv

part | qty_per_vehicle
RA-1 | 1
RA-2 | 1
RA-3A | 1
RA-4 | 1
RA-5 | 1
RA-6 | 1
RA-7 | 1
RA-8 | 2
