diademal/nyc-tlc-wav/drawings/LASER/STAINLESS_18ga_parts.csv

part | qty_per_vehicle
RA-9 | 1
