diademal/nyc-tlc-wav/drawings/LASER/STEEL_11ga_parts.csv

part | qty_per_vehicle
FR-1 | 1
FL-1 | 1
FR-2 | 1
FL-2 | 1
FR-3 | 1
FL-3 | 1
FR-4-1 | 1
FL-4-1 | 1
FR-4-2 | 1
FL-4-2 | 1
FR-4-3 | 1
FL-4-3 | 1
FR-5 | 1
FL-5 | 1
FR-7 | 1
FL-7 | 1
FR-8 | 1
FL-8 | 1
FR-10-1 | 1
FL-10-1 | 1
FR-10-2 | 1
FL-10-2 | 1
FR-11 | 2
FL-11 | 2
FF-1 | 1
FF3-1 | 1
FF3-2 | 1
FF3-3 | 2
FF3-4 | 2
ST-1 | 2
ST-2 | 2
