diademal/nyc-tlc-wav/drawings/FR-7-bent_1.dxf

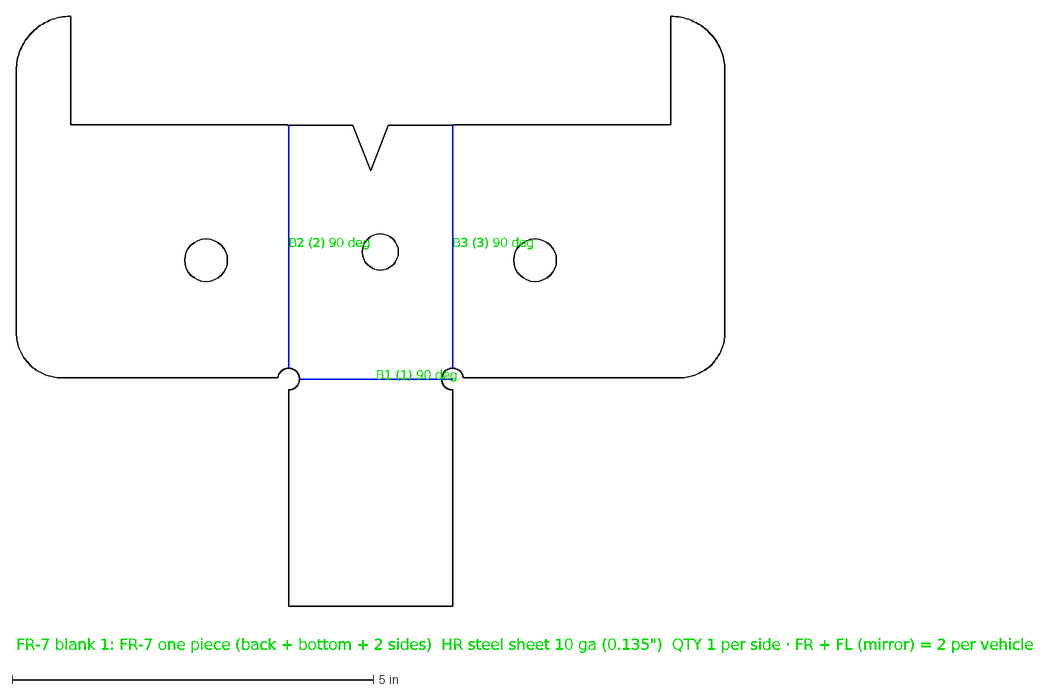
[picture p37: CAD file, 2026-10-03]
drawings/FR-7-bent_1.dxf
B1 (1) 90 deg
B2 (2) 90 deg
B3 (3) 90 deg
FR-7 blank 1: FR-7 one piece (back + bottom + 2 sides) HR steel sheet 10 ga (0.135") QTY 1 per side · FR + FL (mirror) = 2 per vehicle
