diademal/nyc-tlc-wav/drawings/FR-10_5.dxf

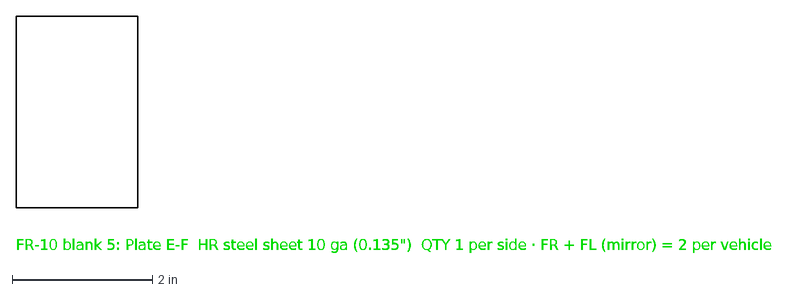
[picture p39: CAD file, 2026-10-03]
drawings/FR-10_5.dxf
FR-10 blank 5: Plate E-F HR steel sheet 10 ga (0.135") QTY 1 per side · FR + FL (mirror) = 2 per vehicle
