diademal/nyc-tlc-wav/drawings/LASER/STAINLESS_18ga_sheet1_of1_12x24_CUT.dxf

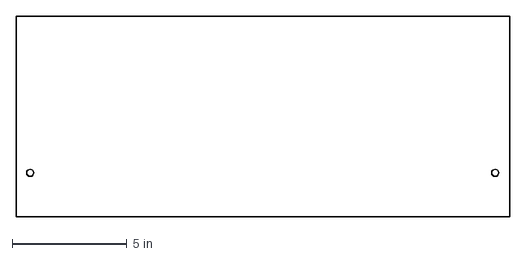
[picture p40: CAD file, 2026-11-02]
drawings/LASER/STAINLESS_18ga_sheet1_of1_12x24_CUT.dxf
21.5 x 8.75 in
