diademal/nyc-tlc-wav/drawings/FR-10_1.dxf

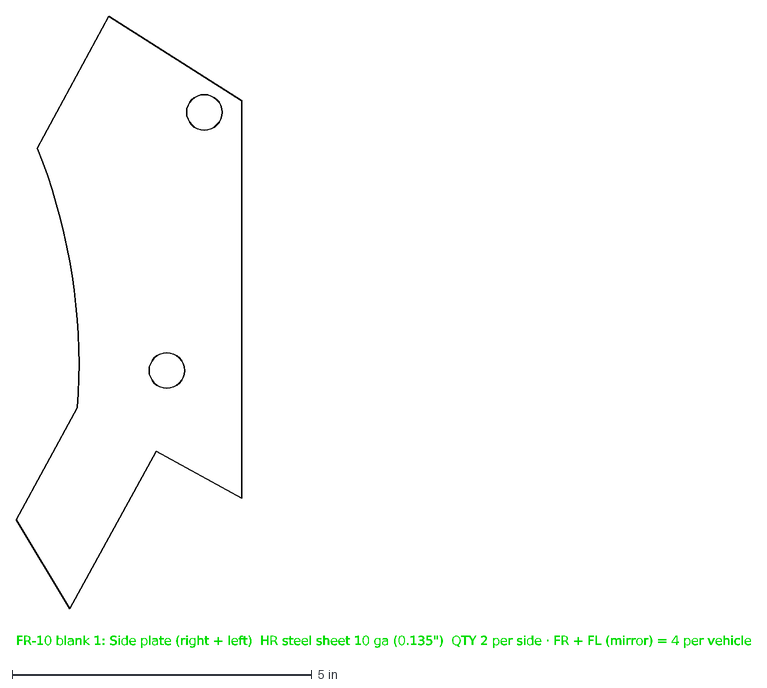
[picture p41: CAD file, 2026-10-03]
drawings/FR-10_1.dxf
FR-10 blank 1: Side plate (right + left) HR steel sheet 10 ga (0.135") QTY 2 per side · FR + FL (mirror) = 4 per vehicle
