diademal/nyc-tlc-wav/drawings/MFG/RA-9_ref.dxf

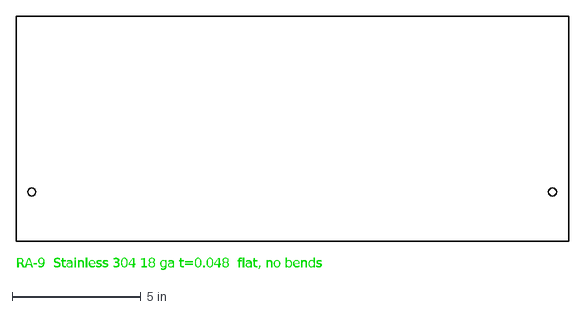
[picture p42: CAD file, 2026-11-02]
drawings/MFG/RA-9_ref.dxf
RA-9 Stainless 304 18 ga t=0.048 flat, no bends
