diademal/nyc-tlc-wav/drawings/FR-10-bent_1.dxf

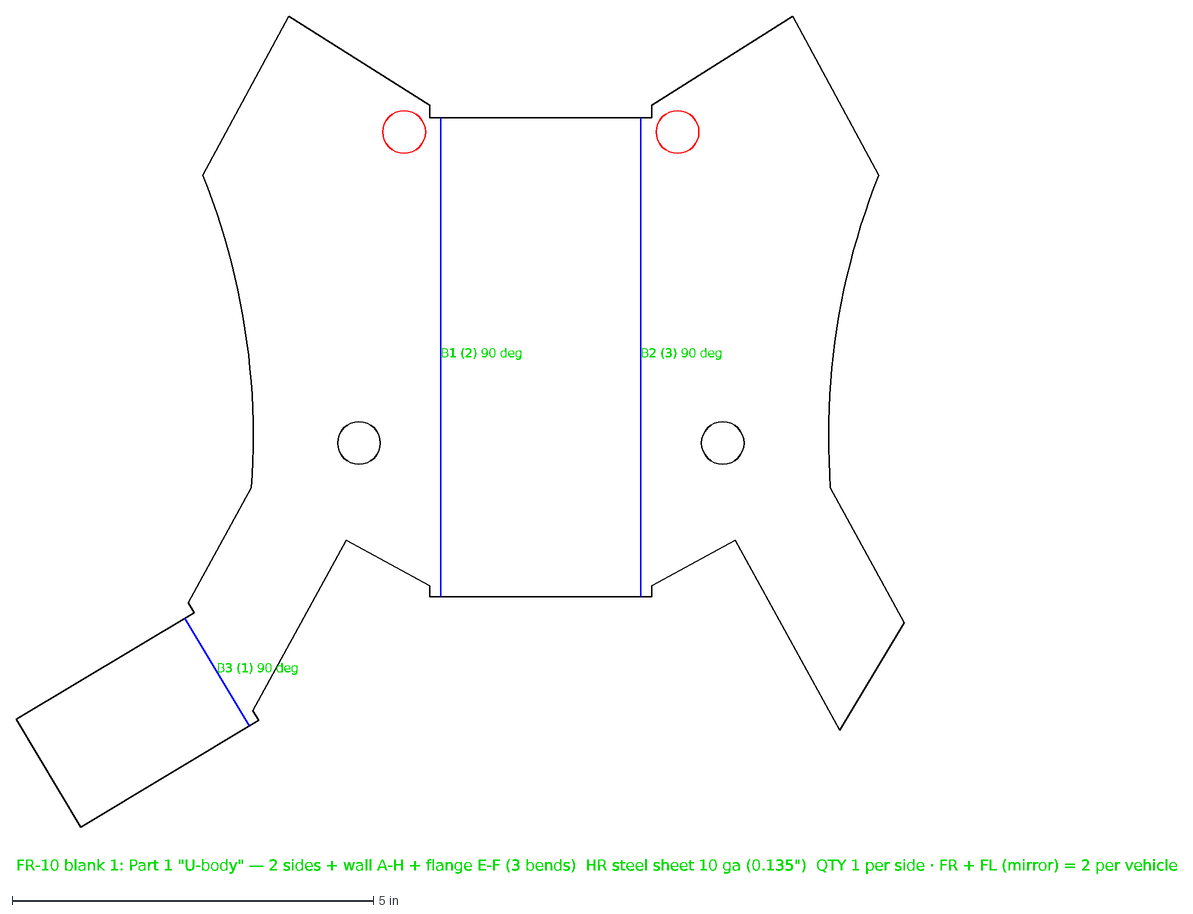
[picture p43: CAD file, 2026-10-03]
drawings/FR-10-bent_1.dxf
B1 (2) 90 deg
B2 (3) 90 deg
B3 (1) 90 deg
FR-10 blank 1: Part 1 "U-body" — 2 sides + wall A-H + flange E-F (3 bends) HR steel sheet 10 ga (0.135") QTY 1 per side · FR + FL (mirror) = 2 per vehicle
