diademal/nyc-tlc-wav/drawings/LASER/STAINLESS_18ga_sheet1_of1_12x24_MARKED.dxf

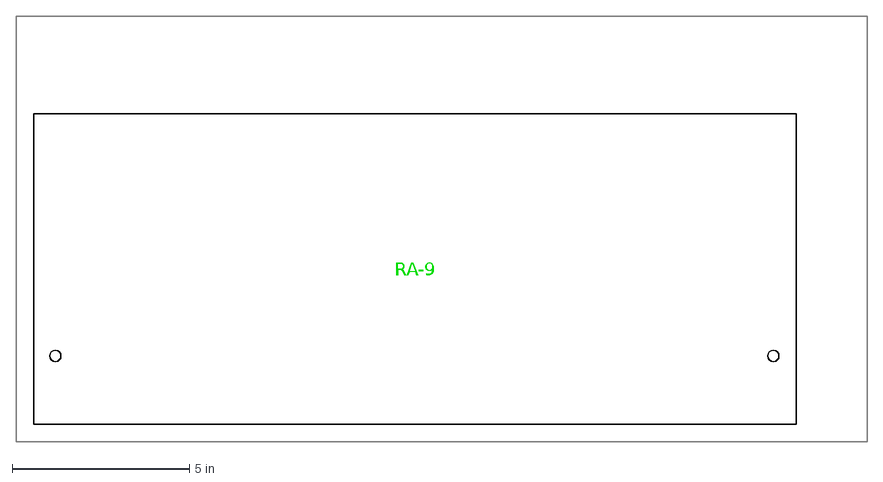
[picture p44: CAD file, 2026-11-02]
drawings/LASER/STAINLESS_18ga_sheet1_of1_12x24_MARKED.dxf
RA-9
