diademal/nyc-tlc-wav/drawings/MFG/RA-9_cut.dxf

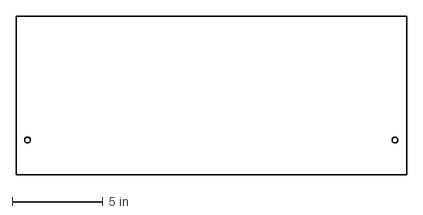
[picture p45: CAD file, 2026-11-02]
drawings/MFG/RA-9_cut.dxf
21.5 x 8.75 in
