diademal/nyc-tlc-wav/drawings/FR-2-bent_1.dxf

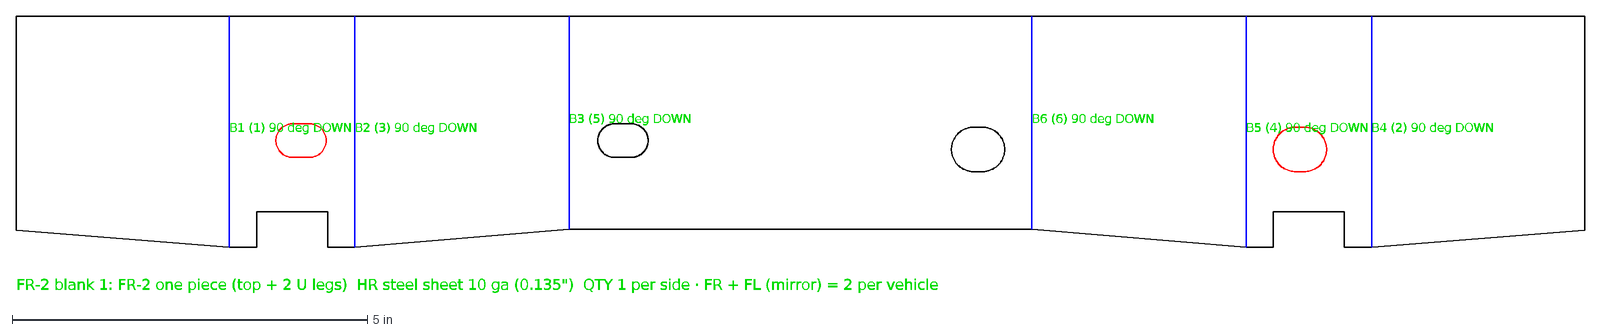
[picture p46: CAD file, 2026-10-03]
drawings/FR-2-bent_1.dxf
B1 (1) 90 deg DOWN
B2 (3) 90 deg DOWN
B3 (5) 90 deg DOWN
B4 (2) 90 deg DOWN
B5 (4) 90 deg DOWN
B6 (6) 90 deg DOWN
FR-2 blank 1: FR-2 one piece (top + 2 U legs) HR steel sheet 10 ga (0.135") QTY 1 per side · FR + FL (mirror) = 2 per vehicle
