diademal/nyc-tlc-wav/drawings/FR-10-bent_2.dxf

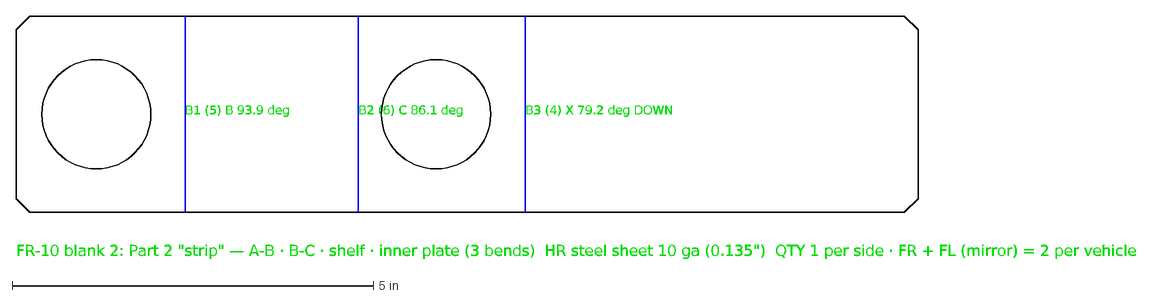
[picture p47: CAD file, 2026-10-03]
drawings/FR-10-bent_2.dxf
B1 (5) B 93.9 deg
B2 (6) C 86.1 deg
B3 (4) X 79.2 deg DOWN
FR-10 blank 2: Part 2 "strip" — A-B · B-C · shelf · inner plate (3 bends) HR steel sheet 10 ga (0.135") QTY 1 per side · FR + FL (mirror) = 2 per vehicle
