diademal/nyc-tlc-wav/drawings/FR-10_3.dxf

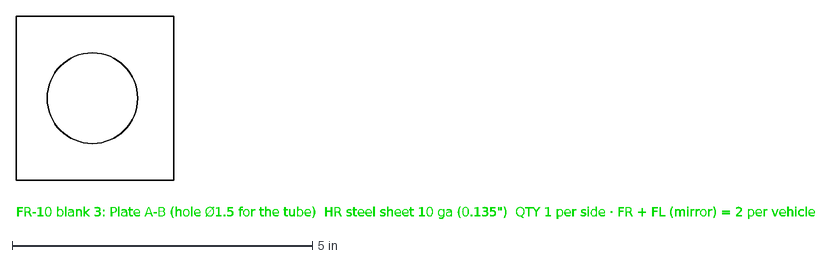
[picture p48: CAD file, 2026-10-03]
drawings/FR-10_3.dxf
FR-10 blank 3: Plate A-B (hole Ø1.5 for the tube) HR steel sheet 10 ga (0.135") QTY 1 per side · FR + FL (mirror) = 2 per vehicle
