diademal/nyc-tlc-wav/drawings/MFG/RA-1_ref.dxf

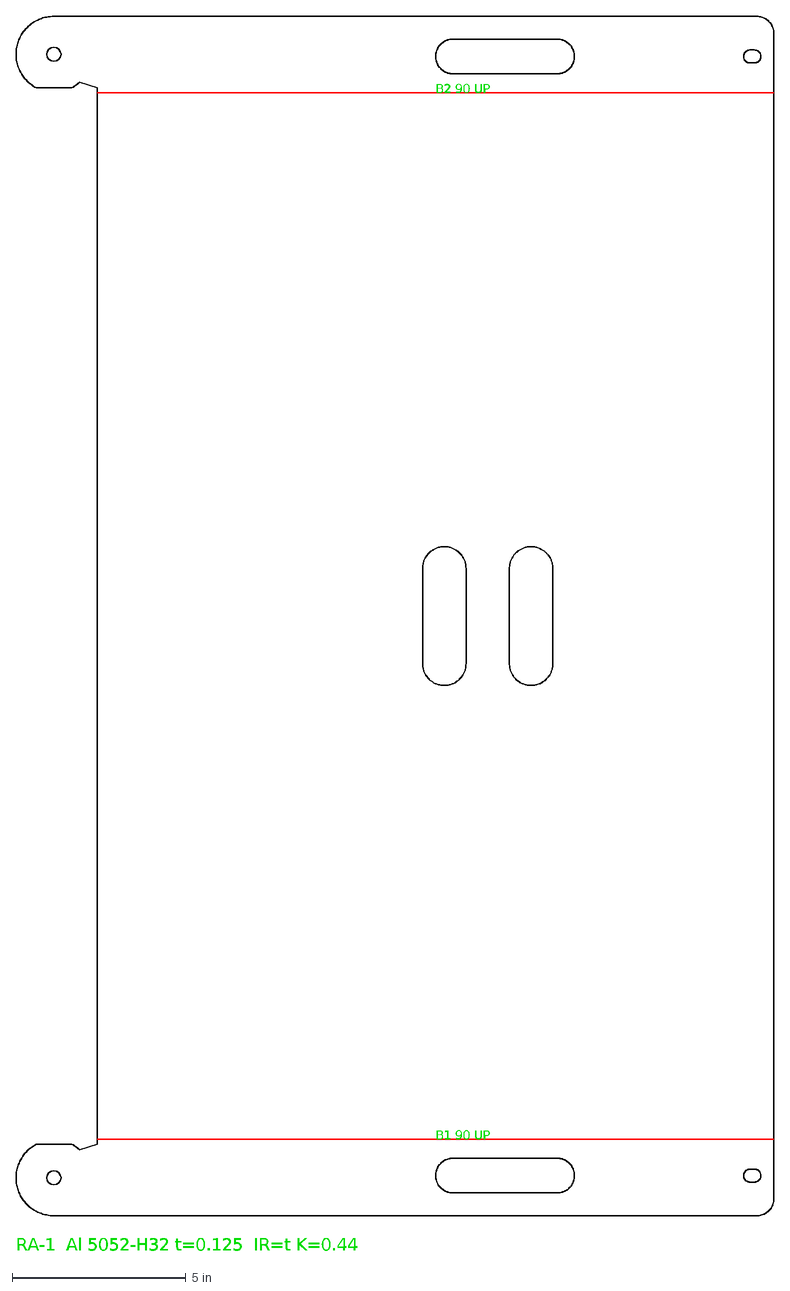
[picture p49: CAD file, 2026-11-02]
drawings/MFG/RA-1_ref.dxf
B1 90 UP
B2 90 UP
RA-1 Al 5052-H32 t=0.125 IR=t K=0.44
