diademal/nyc-tlc-wav/drawings/FF-1_1.dxf

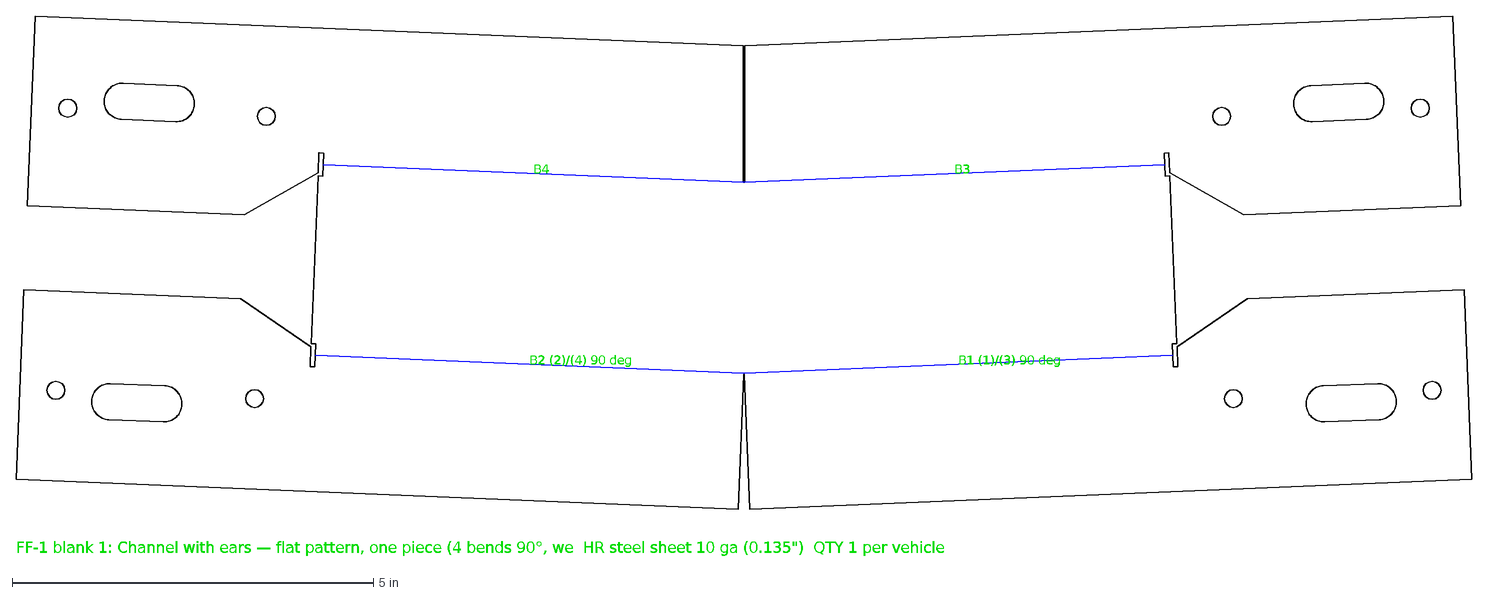
[picture p50: CAD file, 2026-10-03]
drawings/FF-1_1.dxf
B1 (1)/(3) 90 deg
B2 (2)/(4) 90 deg
B3
B4
FF-1 blank 1: Channel with ears — flat pattern, one piece (4 bends 90°, we HR steel sheet 10 ga (0.135") QTY 1 per vehicle
