diademal/nyc-tlc-wav/drawings/FR-10_2.dxf

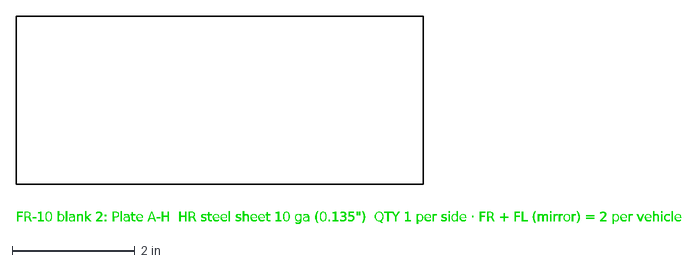
[picture p51: CAD file, 2026-10-03]
drawings/FR-10_2.dxf
FR-10 blank 2: Plate A-H HR steel sheet 10 ga (0.135") QTY 1 per side · FR + FL (mirror) = 2 per vehicle
