diademal/nyc-tlc-wav/drawings/FR-10_7.dxf

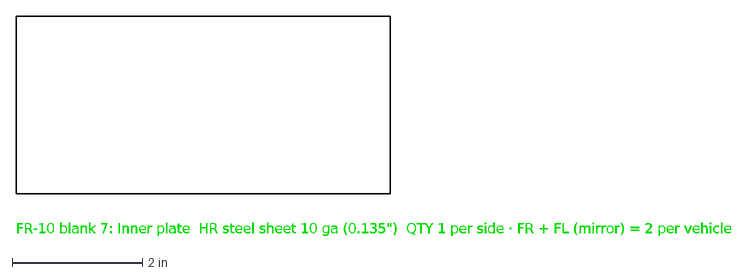
[picture p53: CAD file, 2026-10-03]
drawings/FR-10_7.dxf
FR-10 blank 7: Inner plate HR steel sheet 10 ga (0.135") QTY 1 per side · FR + FL (mirror) = 2 per vehicle
