diademal/nyc-tlc-wav/drawings/MFG/ST-1_cut.dxf

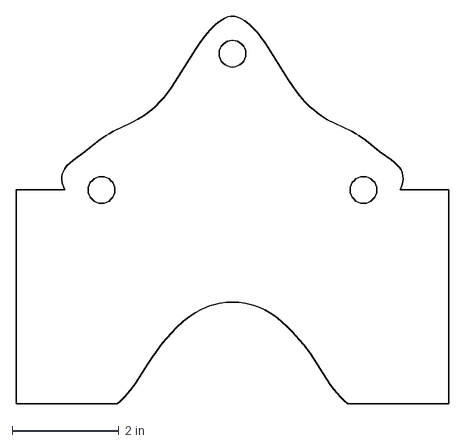
[picture p54: CAD file, 2026-11-02]
drawings/MFG/ST-1_cut.dxf
8.08 x 7.25 in
