diademal/nyc-tlc-wav/drawings/FR-4_1.dxf

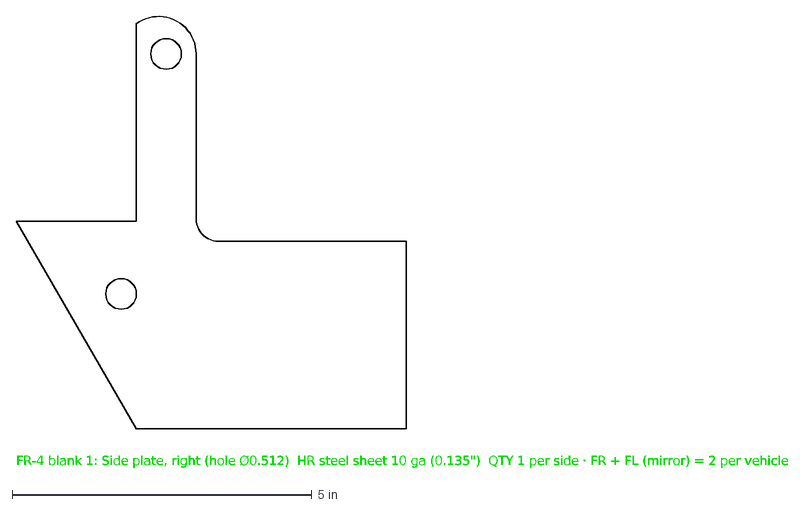
[picture p55: CAD file, 2026-10-03]
drawings/FR-4_1.dxf
FR-4 blank 1: Side plate, right (hole Ø0.512) HR steel sheet 10 ga (0.135") QTY 1 per side · FR + FL (mirror) = 2 per vehicle
