diademal/nyc-tlc-wav/drawings/MFG/RA-4_cut.dxf

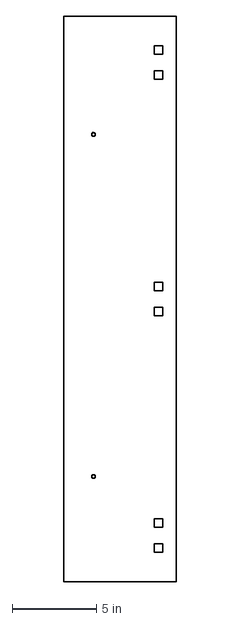
[picture p56: CAD file, 2026-11-02]
drawings/MFG/RA-4_cut.dxf
6.69 x 33.5 in
