diademal/nyc-tlc-wav/drawings/FR-8_1.dxf

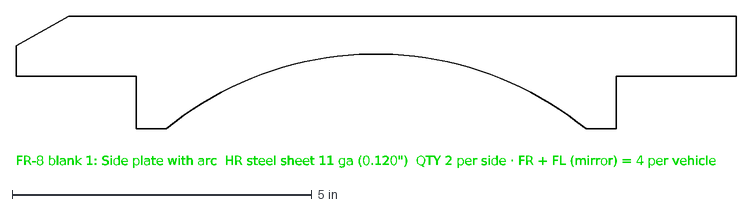
[picture p57: CAD file, 2026-10-03]
drawings/FR-8_1.dxf
FR-8 blank 1: Side plate with arc HR steel sheet 11 ga (0.120") QTY 2 per side · FR + FL (mirror) = 4 per vehicle
