diademal/nyc-tlc-wav/drawings/MFG/RA-1_cut.dxf

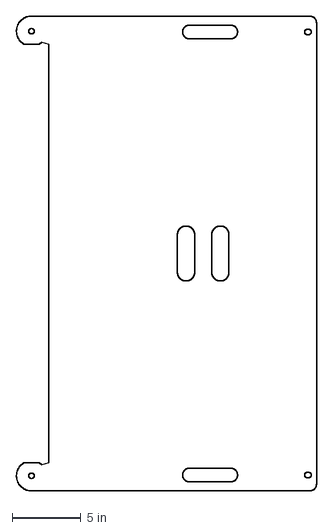
[picture p58: CAD file, 2026-11-02]
drawings/MFG/RA-1_cut.dxf
21.8 x 34.6 in
