diademal/nyc-tlc-wav/drawings/FR-2_3.dxf

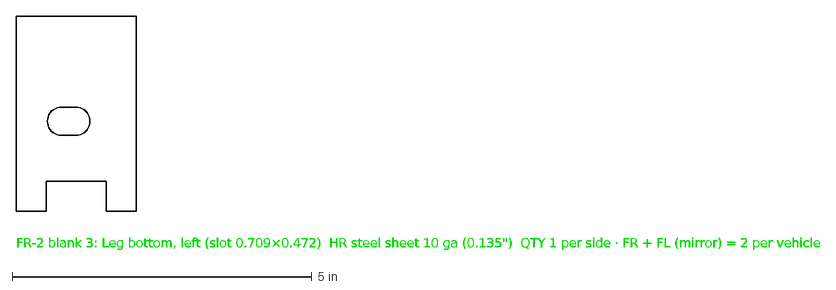
[picture p59: CAD file, 2026-10-03]
drawings/FR-2_3.dxf
FR-2 blank 3: Leg bottom, left (slot 0.709×0.472) HR steel sheet 10 ga (0.135") QTY 1 per side · FR + FL (mirror) = 2 per vehicle
