diademal/nyc-tlc-wav/drawings/MFG/RA-2_ref.dxf

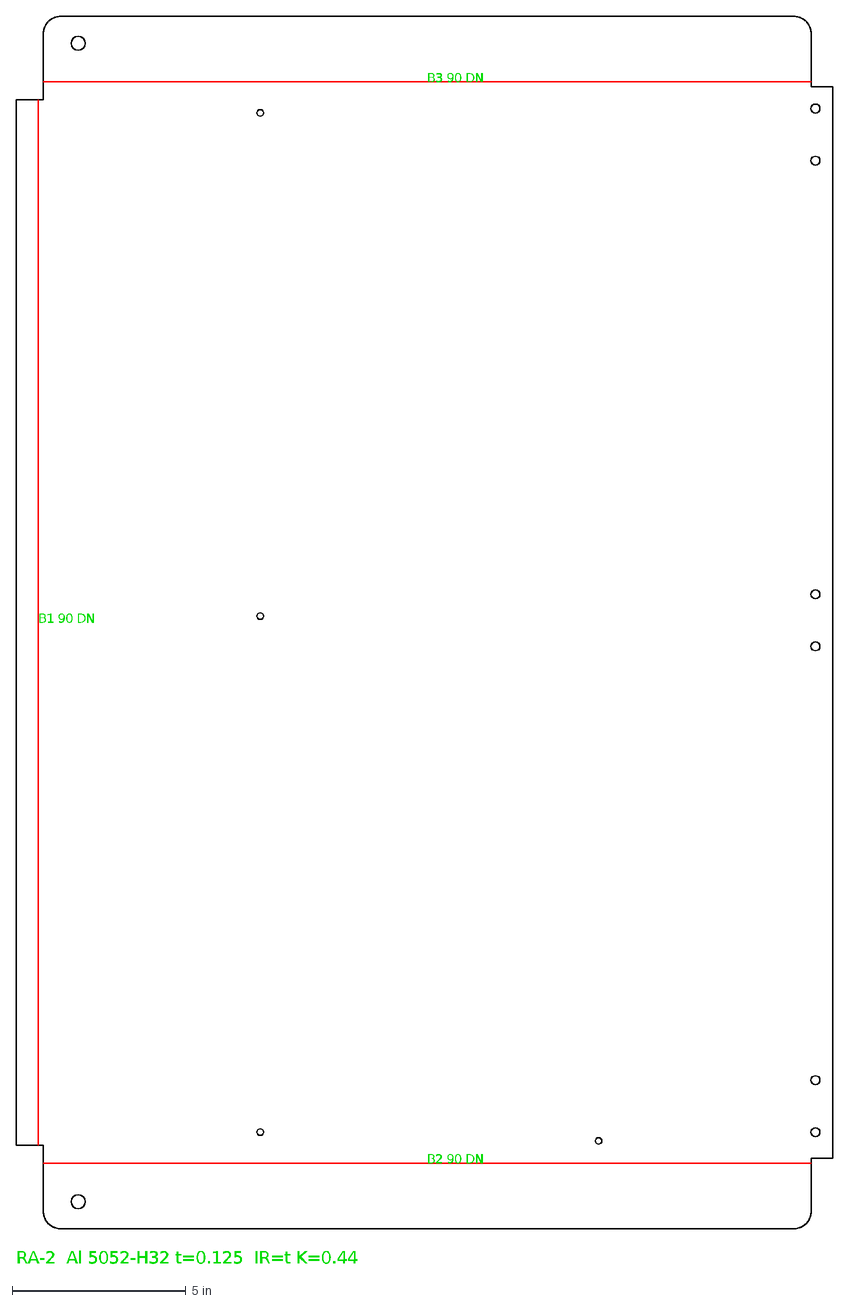
[picture p60: CAD file, 2026-11-02]
drawings/MFG/RA-2_ref.dxf
B1 90 DN
B2 90 DN
B3 90 DN
RA-2 Al 5052-H32 t=0.125 IR=t K=0.44
