diademal/nyc-tlc-wav/drawings/FR-5-bent_1.dxf

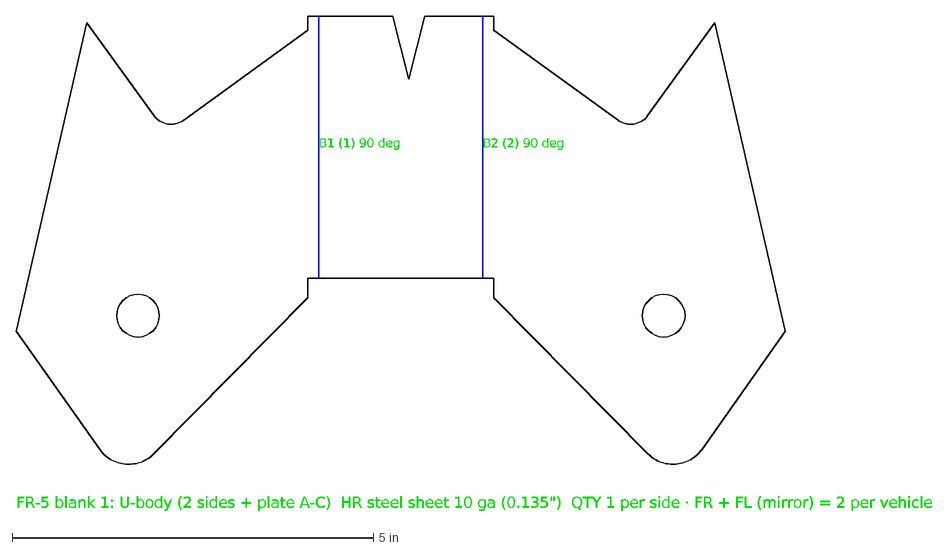
[picture p61: CAD file, 2026-10-03]
drawings/FR-5-bent_1.dxf
B1 (1) 90 deg
B2 (2) 90 deg
FR-5 blank 1: U-body (2 sides + plate A-C) HR steel sheet 10 ga (0.135") QTY 1 per side · FR + FL (mirror) = 2 per vehicle
