diademal/nyc-tlc-wav/drawings/MFG/ST-2_cut.dxf

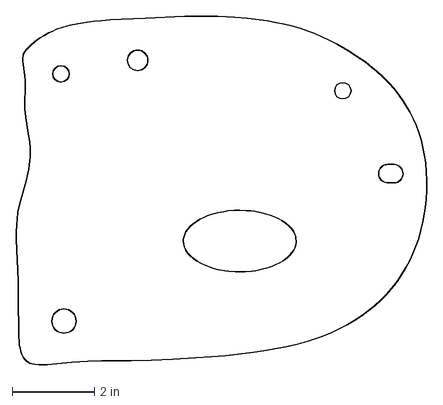
[picture p62: CAD file, 2026-11-02]
drawings/MFG/ST-2_cut.dxf
10.00 x 8.50 in
