diademal/nyc-tlc-wav/drawings/FR-1_1.dxf

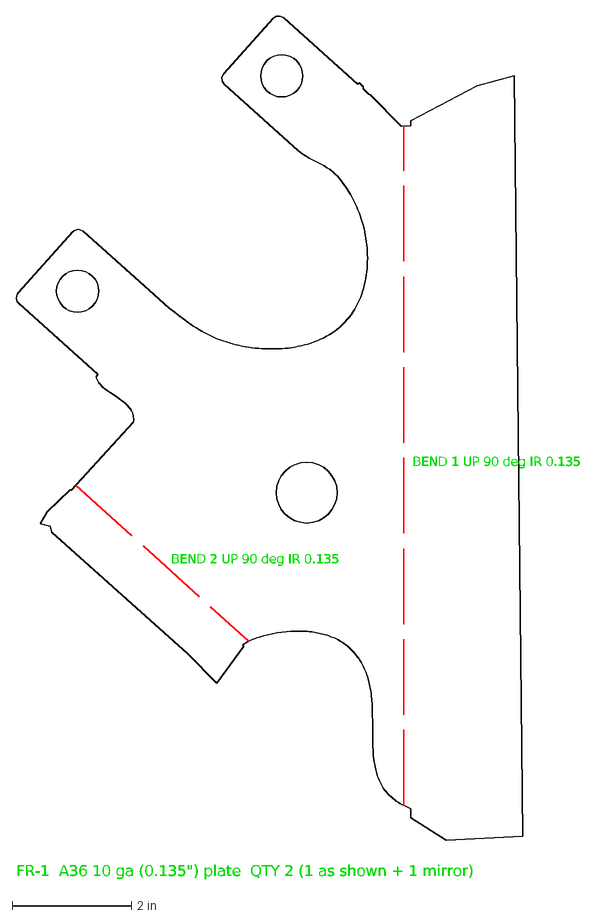
[picture p63: CAD file, 2026-10-03]
drawings/FR-1_1.dxf
BEND 1 UP 90 deg IR 0.135
BEND 2 UP 90 deg IR 0.135
FR-1 A36 10 ga (0.135") plate QTY 2 (1 as shown + 1 mirror)
