diademal/nyc-tlc-wav/drawings/MFG/RA-4_ref.dxf

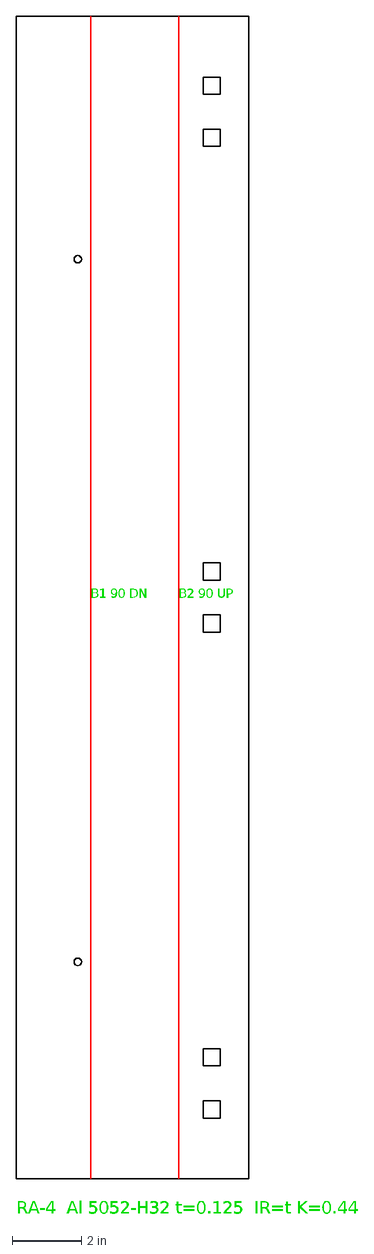
[picture p64: CAD file, 2026-11-02]
drawings/MFG/RA-4_ref.dxf
B1 90 DN
B2 90 UP
RA-4 Al 5052-H32 t=0.125 IR=t K=0.44
