diademal/nyc-tlc-wav/drawings/FR-7-bent_3.dxf

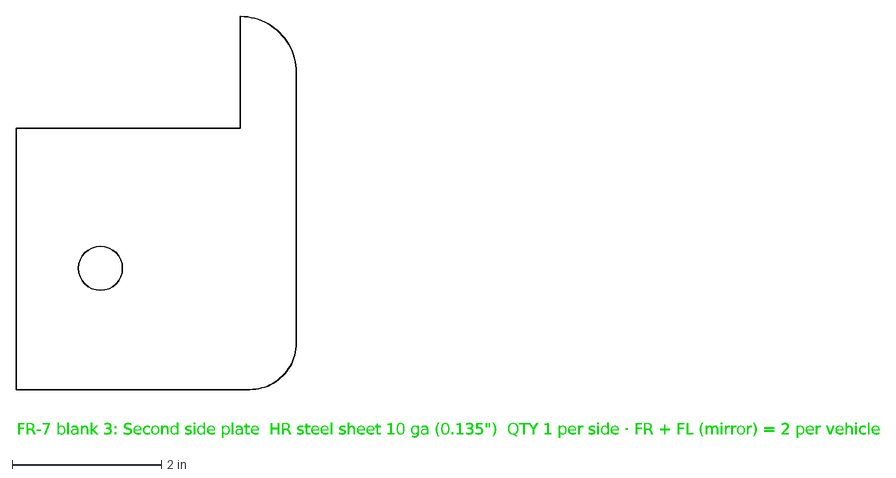
[picture p65: CAD file, 2026-10-03]
drawings/FR-7-bent_3.dxf
FR-7 blank 3: Second side plate HR steel sheet 10 ga (0.135") QTY 1 per side · FR + FL (mirror) = 2 per vehicle
