diademal/nyc-tlc-wav/drawings/MFG/ST-1_ref.dxf

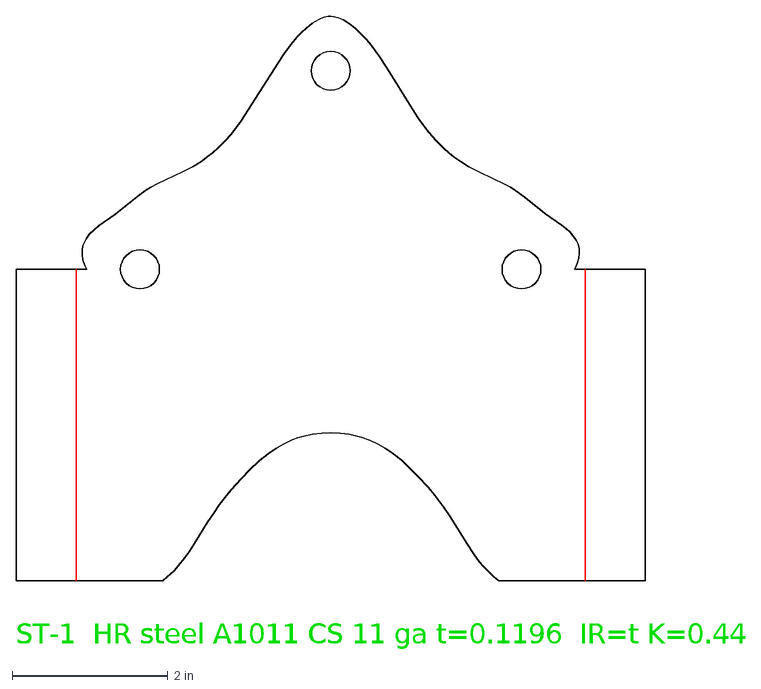
[picture p66: CAD file, 2026-11-02]
drawings/MFG/ST-1_ref.dxf
ST-1 HR steel A1011 CS 11 ga t=0.1196 IR=t K=0.44
