diademal/nyc-tlc-wav/drawings/FR-8_2.dxf

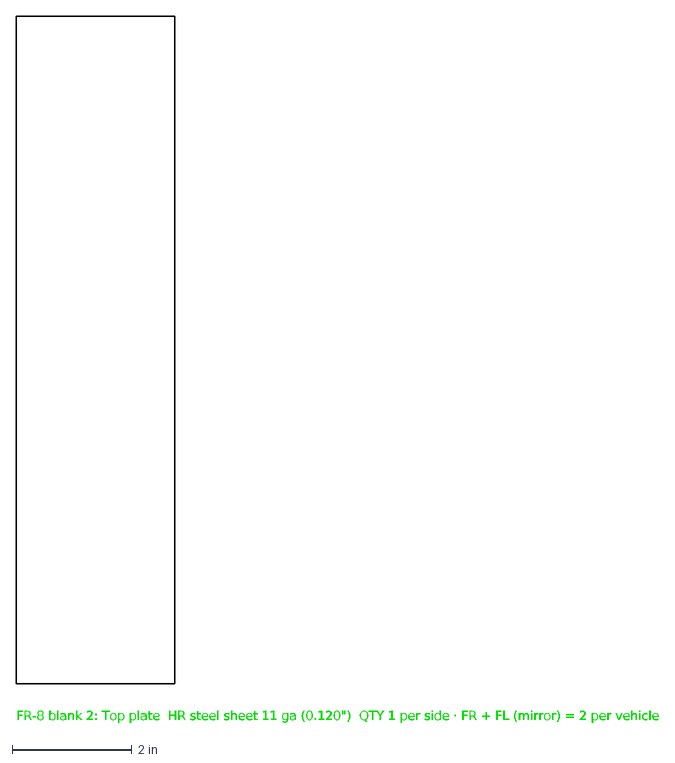
[picture p67: CAD file, 2026-10-03]
drawings/FR-8_2.dxf
FR-8 blank 2: Top plate HR steel sheet 11 ga (0.120") QTY 1 per side · FR + FL (mirror) = 2 per vehicle
