diademal/nyc-tlc-wav/drawings/MFG/RA-2_cut.dxf

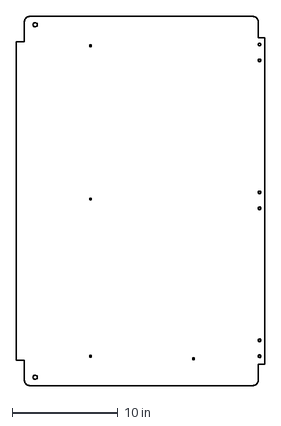
[picture p68: CAD file, 2026-11-02]
drawings/MFG/RA-2_cut.dxf
23.5 x 34.9 in
