diademal/nyc-tlc-wav/drawings/FR-4_7.dxf

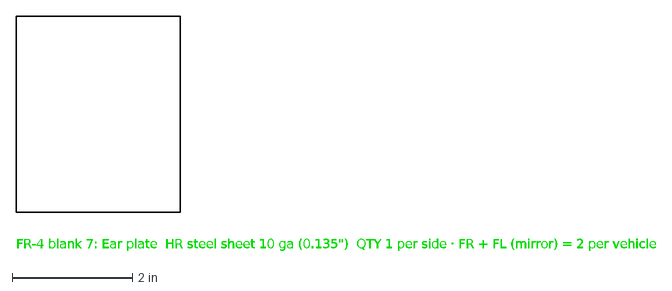
[picture p69: CAD file, 2026-10-03]
drawings/FR-4_7.dxf
FR-4 blank 7: Ear plate HR steel sheet 10 ga (0.135") QTY 1 per side · FR + FL (mirror) = 2 per vehicle
