diademal/nyc-tlc-wav/drawings/MFG/FR-8_FR_cut.dxf

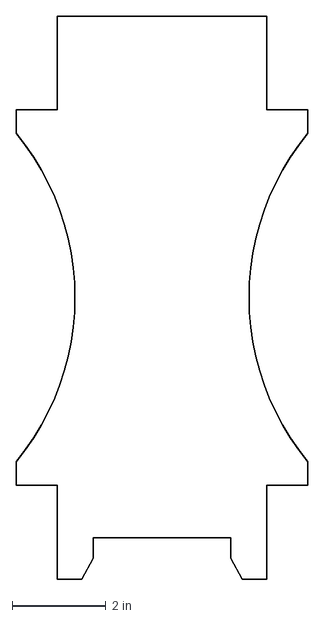
[picture p70: CAD file, 2026-10-31]
drawings/MFG/FR-8_FR_cut.dxf
6.21 x 12.0 in
