diademal/nyc-tlc-wav/drawings/FR-7_2.dxf

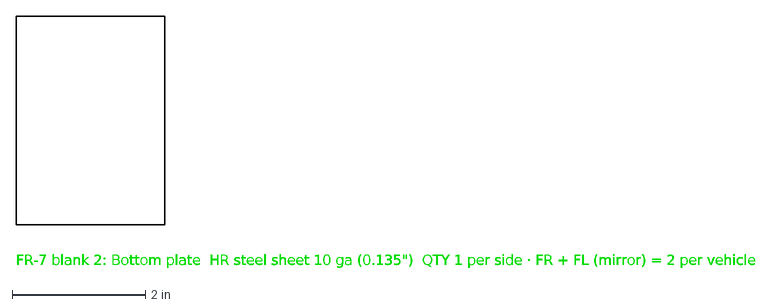
[picture p71: CAD file, 2026-10-03]
drawings/FR-7_2.dxf
FR-7 blank 2: Bottom plate HR steel sheet 10 ga (0.135") QTY 1 per side · FR + FL (mirror) = 2 per vehicle
