diademal/nyc-tlc-wav/drawings/FR-4_2.dxf

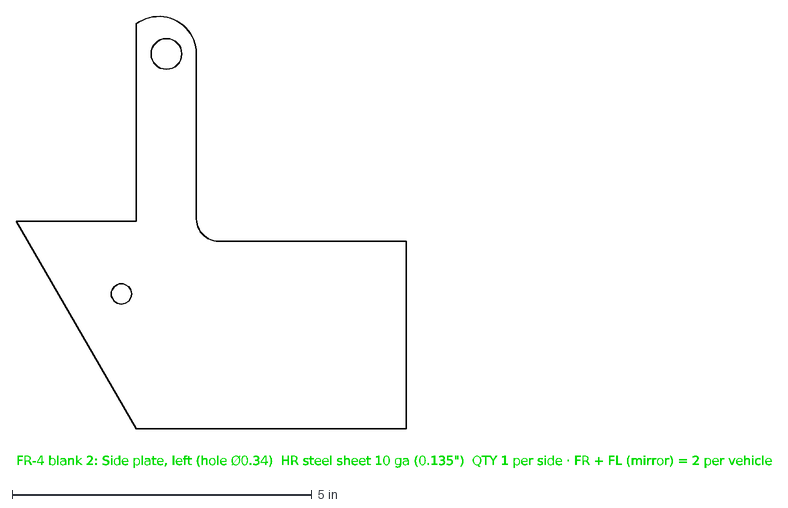
[picture p73: CAD file, 2026-10-03]
drawings/FR-4_2.dxf
FR-4 blank 2: Side plate, left (hole Ø0.34) HR steel sheet 10 ga (0.135") QTY 1 per side · FR + FL (mirror) = 2 per vehicle
