diademal/nyc-tlc-wav/drawings/FR-5_1.dxf

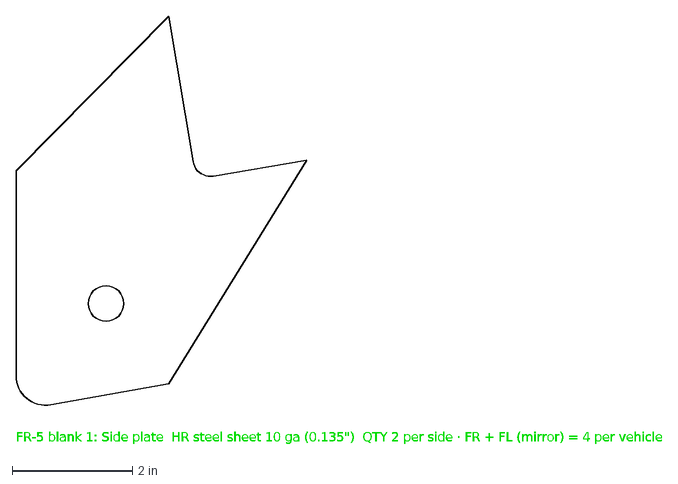
[picture p75: CAD file, 2026-10-03]
drawings/FR-5_1.dxf
FR-5 blank 1: Side plate HR steel sheet 10 ga (0.135") QTY 2 per side · FR + FL (mirror) = 4 per vehicle
