diademal/nyc-tlc-wav/drawings/MFG/FR-2_FR_cut.dxf

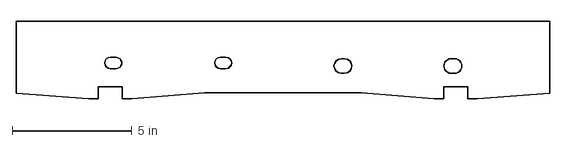
[picture p76: CAD file, 2026-10-31]
drawings/MFG/FR-2_FR_cut.dxf
22.3 x 3.25 in
