diademal/nyc-tlc-wav/drawings/FF-3_4.dxf

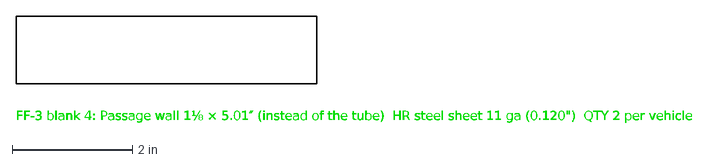
[picture p77: CAD file, 2026-10-03]
drawings/FF-3_4.dxf
FF-3 blank 4: Passage wall 1⅛ × 5.01″ (instead of the tube) HR steel sheet 11 ga (0.120") QTY 2 per vehicle
