diademal/nyc-tlc-wav/drawings/FR-4_6.dxf

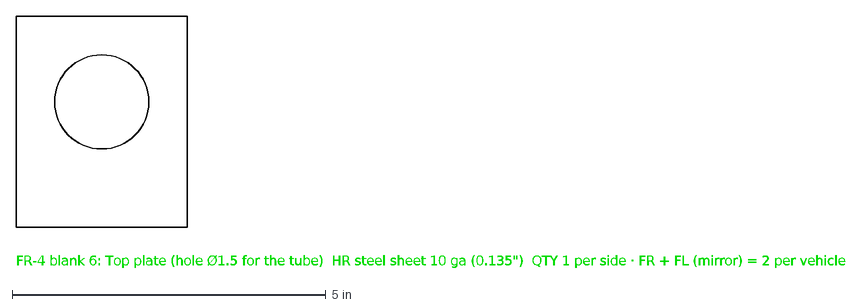
[picture p78: CAD file, 2026-10-03]
drawings/FR-4_6.dxf
FR-4 blank 6: Top plate (hole Ø1.5 for the tube) HR steel sheet 10 ga (0.135") QTY 1 per side · FR + FL (mirror) = 2 per vehicle
