diademal/nyc-tlc-wav/drawings/FR-2_4.dxf

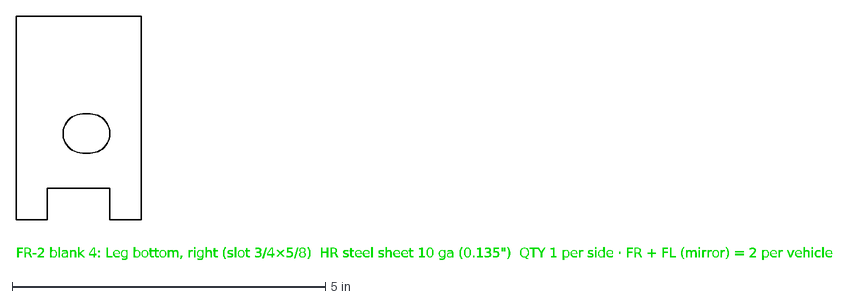
[picture p80: CAD file, 2026-10-03]
drawings/FR-2_4.dxf
FR-2 blank 4: Leg bottom, right (slot 3/4×5/8) HR steel sheet 10 ga (0.135") QTY 1 per side · FR + FL (mirror) = 2 per vehicle
