diademal/nyc-tlc-wav/drawings/MFG/FR-5_FR_cut.dxf

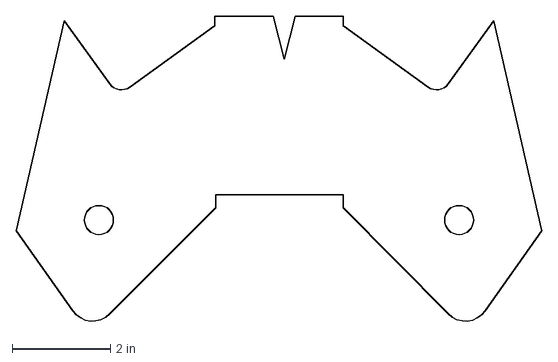
[picture p81: CAD file, 2026-10-31]
drawings/MFG/FR-5_FR_cut.dxf
10.7 x 6.21 in
