diademal/nyc-tlc-wav/drawings/FR-5_2.dxf

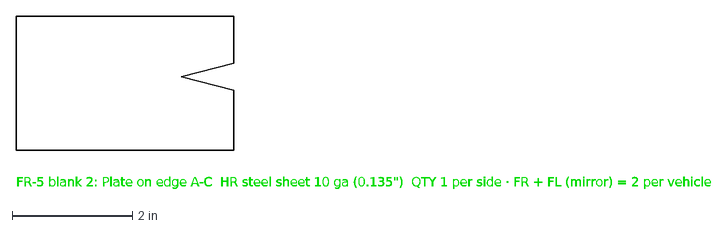
[picture p82: CAD file, 2026-10-03]
drawings/FR-5_2.dxf
FR-5 blank 2: Plate on edge A-C HR steel sheet 10 ga (0.135") QTY 1 per side · FR + FL (mirror) = 2 per vehicle
