diademal/nyc-tlc-wav/drawings/MFG/FR-5_ref.dxf

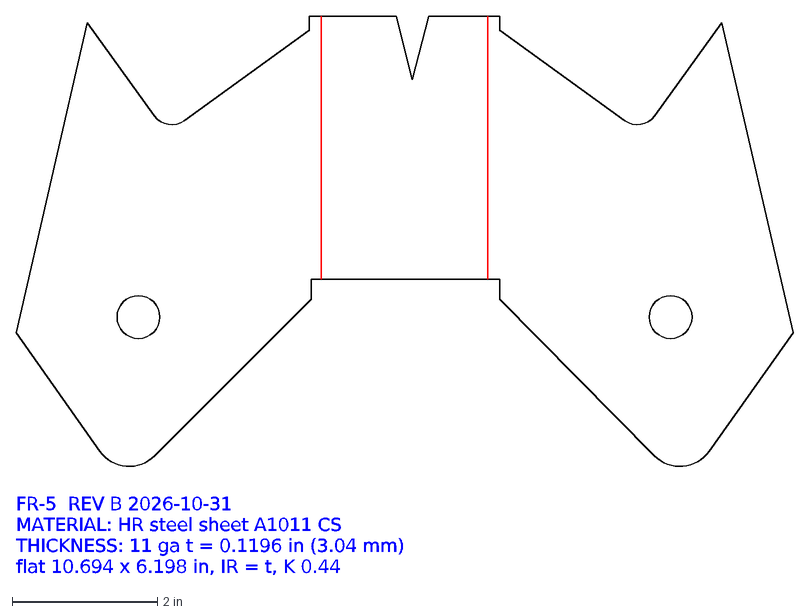
[picture p83: CAD file, 2026-10-31]
drawings/MFG/FR-5_ref.dxf
FR-5 REV B 2026-10-31
MATERIAL: HR steel sheet A1011 CS
THICKNESS: 11 ga t = 0.1196 in (3.04 mm)
flat 10.694 x 6.198 in, IR = t, K 0.44
