diademal/nyc-tlc-wav/drawings/FR-2-bent_2.dxf

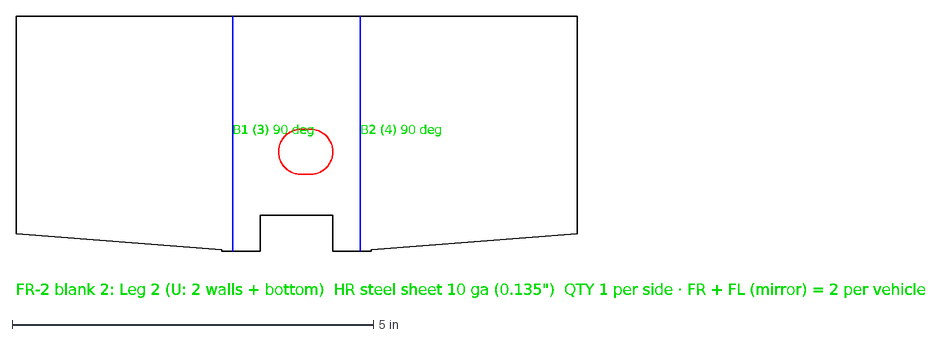
[picture p84: CAD file, 2026-10-03]
drawings/FR-2-bent_2.dxf
B1 (3) 90 deg
B2 (4) 90 deg
FR-2 blank 2: Leg 2 (U: 2 walls + bottom) HR steel sheet 10 ga (0.135") QTY 1 per side · FR + FL (mirror) = 2 per vehicle
