diademal/nyc-tlc-wav/drawings/MFG/FF-1_ref.dxf

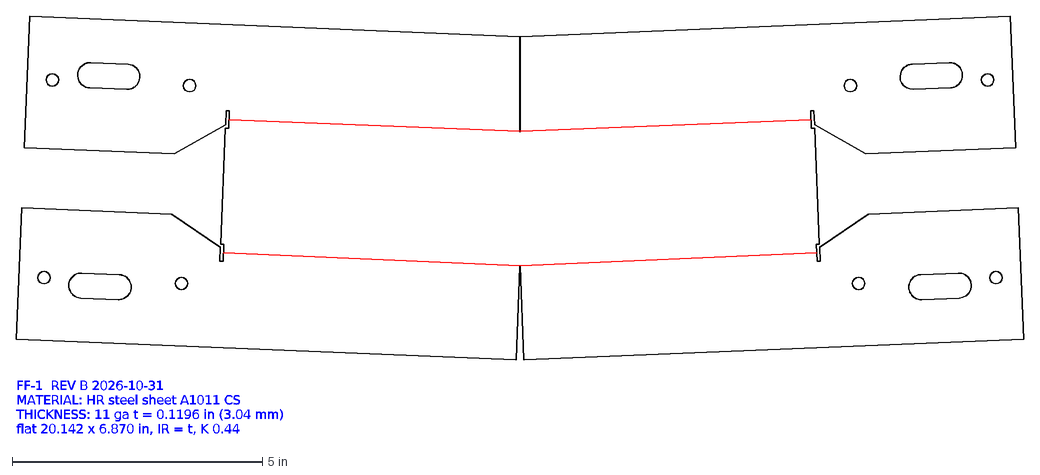
[picture p85: CAD file, 2026-10-31]
drawings/MFG/FF-1_ref.dxf
FF-1 REV B 2026-10-31
MATERIAL: HR steel sheet A1011 CS
THICKNESS: 11 ga t = 0.1196 in (3.04 mm)
flat 20.142 x 6.870 in, IR = t, K 0.44
