diademal/nyc-tlc-wav/drawings/FR-4_8.dxf

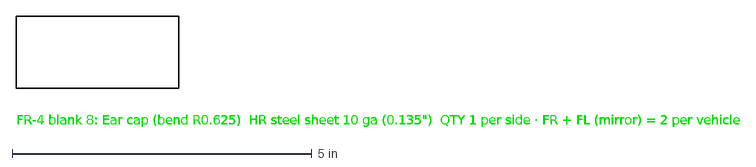
[picture p86: CAD file, 2026-10-03]
drawings/FR-4_8.dxf
FR-4 blank 8: Ear cap (bend R0.625) HR steel sheet 10 ga (0.135") QTY 1 per side · FR + FL (mirror) = 2 per vehicle
