diademal/nyc-tlc-wav/drawings/MFG/FR-10-1_FL_cut.dxf

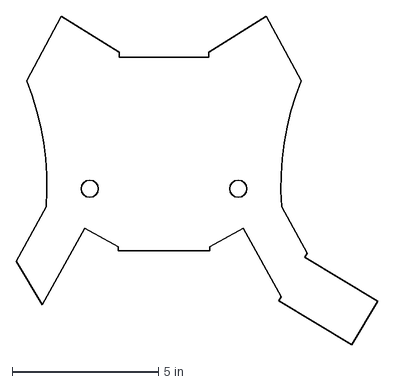
[picture p87: CAD file, 2026-10-31]
drawings/MFG/FR-10-1_FL_cut.dxf
12.4 x 11.2 in
