diademal/nyc-tlc-wav/drawings/FR-4_3.dxf

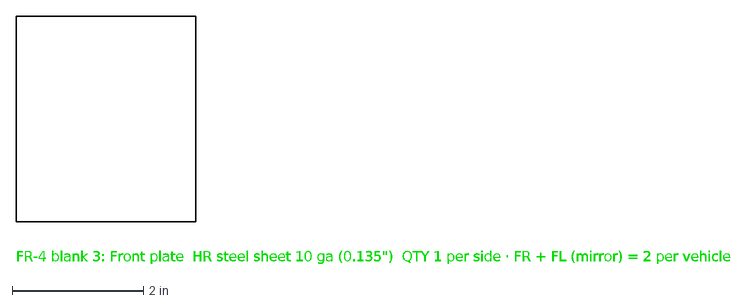
[picture p88: CAD file, 2026-10-03]
drawings/FR-4_3.dxf
FR-4 blank 3: Front plate HR steel sheet 10 ga (0.135") QTY 1 per side · FR + FL (mirror) = 2 per vehicle
