diademal/nyc-tlc-wav/drawings/MFG/FR-3_ref.dxf

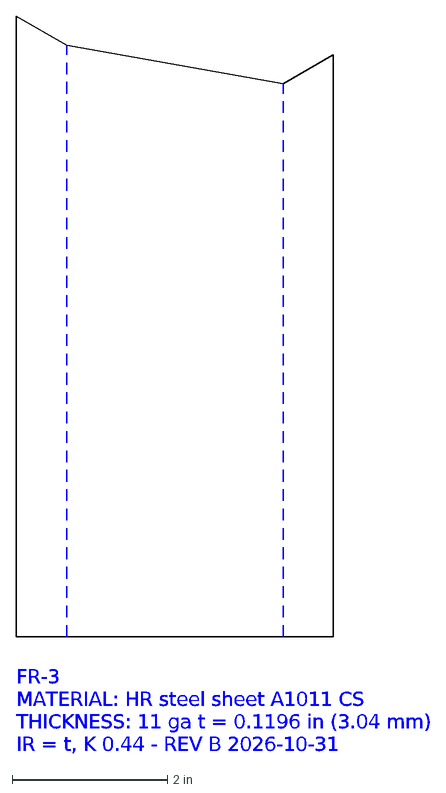
[picture p89: CAD file, 2026-10-31]
drawings/MFG/FR-3_ref.dxf
FR-3
MATERIAL: HR steel sheet A1011 CS
THICKNESS: 11 ga t = 0.1196 in (3.04 mm)
IR = t, K 0.44 - REV B 2026-10-31
