diademal/nyc-tlc-wav/drawings/FR-2_1.dxf

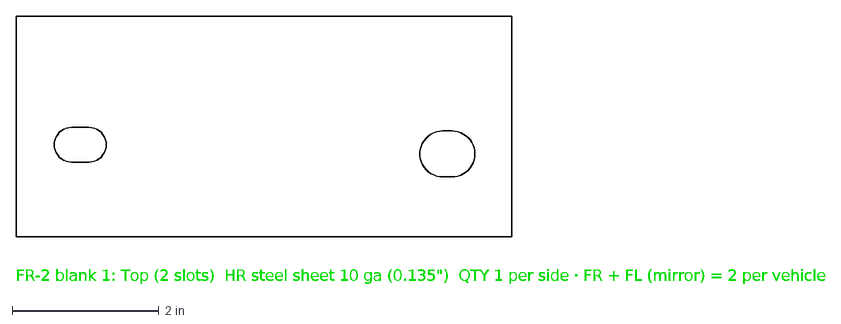
[picture p90: CAD file, 2026-10-03]
drawings/FR-2_1.dxf
FR-2 blank 1: Top (2 slots) HR steel sheet 10 ga (0.135") QTY 1 per side · FR + FL (mirror) = 2 per vehicle
