diademal/nyc-tlc-wav/drawings/MFG/FF-3-4_cut.dxf

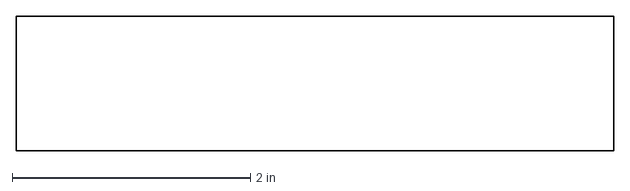
[picture p91: CAD file, 2026-10-31]
drawings/MFG/FF-3-4_cut.dxf
5.01 x 1.12 in
