diademal/nyc-tlc-wav/drawings/MFG/RA-8_ref.dxf

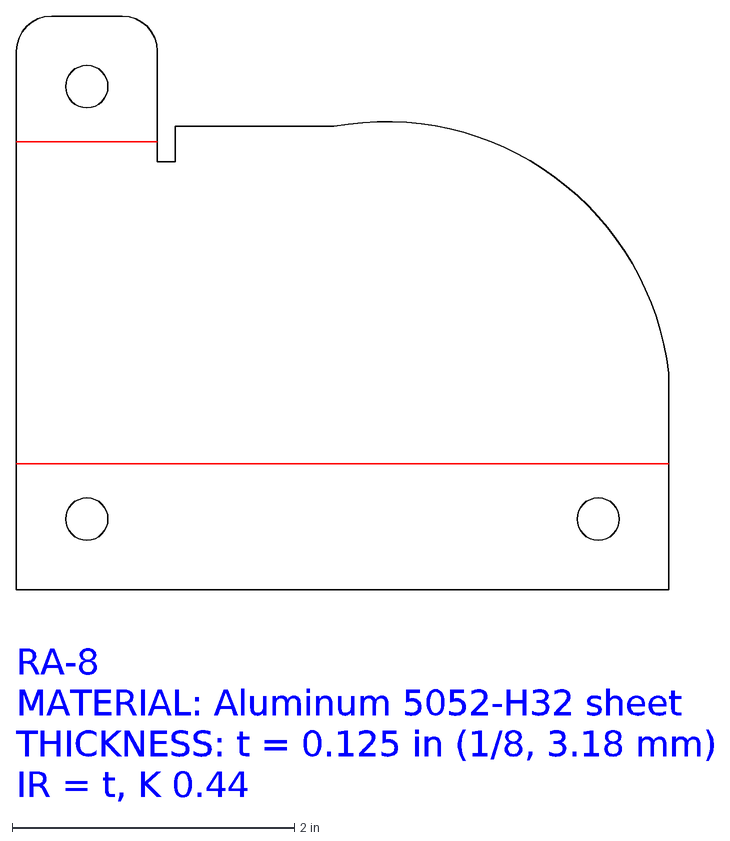
[picture p93: CAD file, 2026-10-31]
drawings/MFG/RA-8_ref.dxf
RA-8
MATERIAL: Aluminum 5052-H32 sheet
THICKNESS: t = 0.125 in (1/8, 3.18 mm)
IR = t, K 0.44
