diademal/nyc-tlc-wav/drawings/FR-2_2.dxf

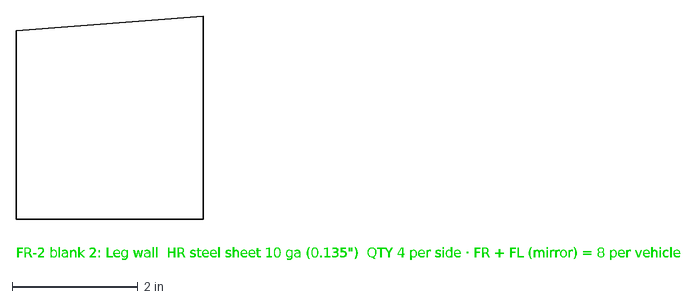
[picture p94: CAD file, 2026-10-03]
drawings/FR-2_2.dxf
FR-2 blank 2: Leg wall HR steel sheet 10 ga (0.135") QTY 4 per side · FR + FL (mirror) = 8 per vehicle
