diademal/nyc-tlc-wav/drawings/MFG/FR-7_ref.dxf

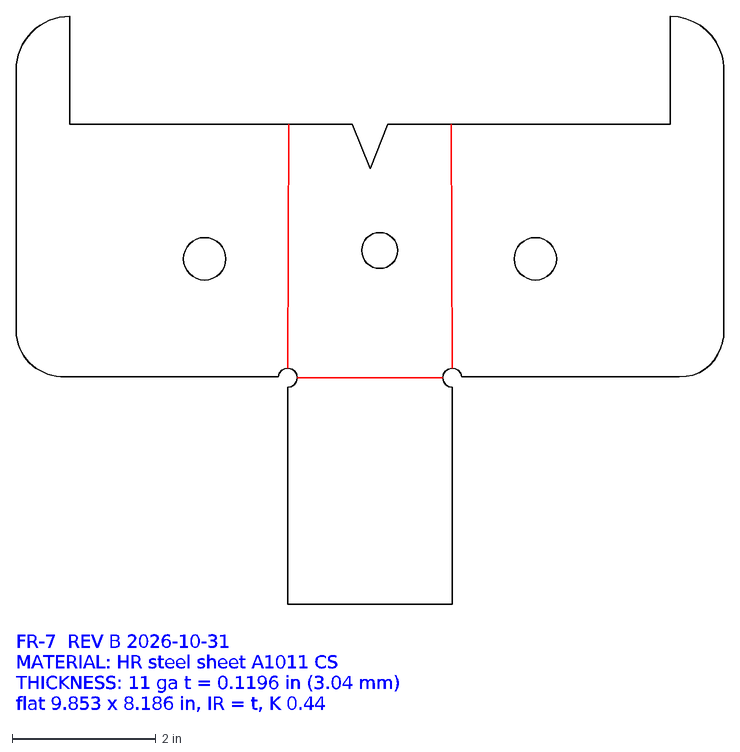
[picture p95: CAD file, 2026-10-31]
drawings/MFG/FR-7_ref.dxf
FR-7 REV B 2026-10-31
MATERIAL: HR steel sheet A1011 CS
THICKNESS: 11 ga t = 0.1196 in (3.04 mm)
flat 9.853 x 8.186 in, IR = t, K 0.44
