diademal/nyc-tlc-wav/drawings/FR-4_4.dxf

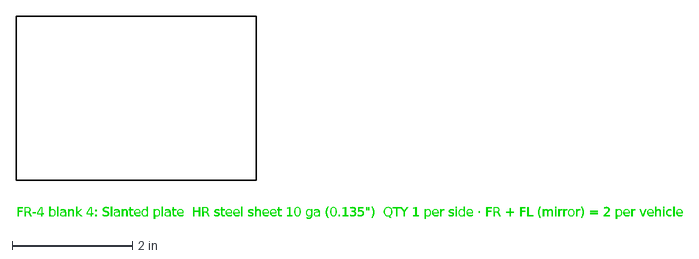
[picture p96: CAD file, 2026-10-03]
drawings/FR-4_4.dxf
FR-4 blank 4: Slanted plate HR steel sheet 10 ga (0.135") QTY 1 per side · FR + FL (mirror) = 2 per vehicle
