diademal/nyc-tlc-wav/drawings/FF-3_3.dxf

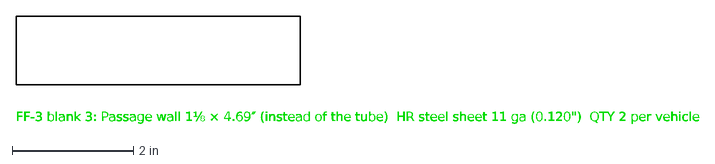
[picture p98: CAD file, 2026-10-03]
drawings/FF-3_3.dxf
FF-3 blank 3: Passage wall 1⅛ × 4.69″ (instead of the tube) HR steel sheet 11 ga (0.120") QTY 2 per vehicle
