diademal/nyc-tlc-wav/drawings/MFG/FF-3-1_cut.dxf

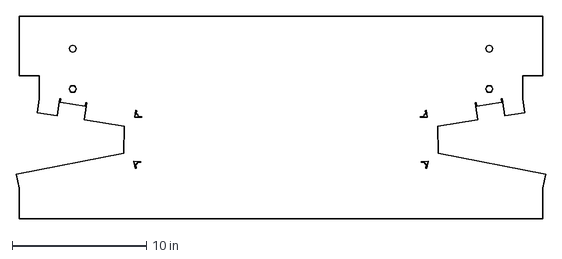
[picture p99: CAD file, 2026-10-31]
drawings/MFG/FF-3-1_cut.dxf
39.4 x 15.1 in
