diademal/nyc-tlc-wav/drawings/FR-8-bent_1.dxf

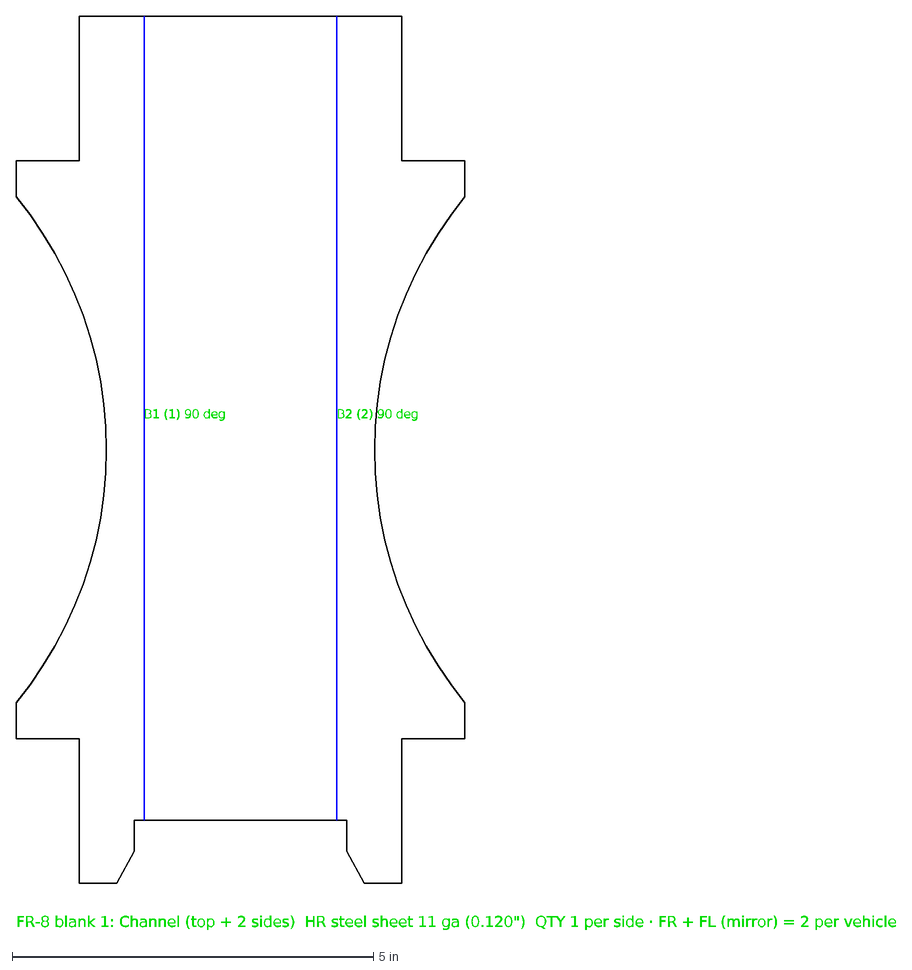
[picture p100: CAD file, 2026-10-03]
drawings/FR-8-bent_1.dxf
B1 (1) 90 deg
B2 (2) 90 deg
FR-8 blank 1: Channel (top + 2 sides) HR steel sheet 11 ga (0.120") QTY 1 per side · FR + FL (mirror) = 2 per vehicle
