diademal/nyc-tlc-wav/drawings/MFG/FR-7_FL_cut.dxf

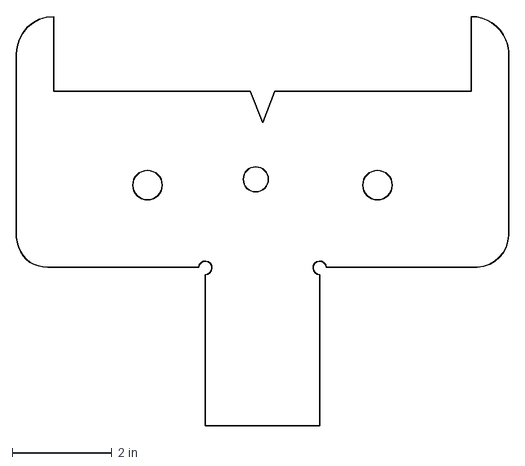
[picture p101: CAD file, 2026-10-31]
drawings/MFG/FR-7_FL_cut.dxf
9.85 x 8.19 in
