diademal/nyc-tlc-wav/drawings/FR-4-bent_3.dxf

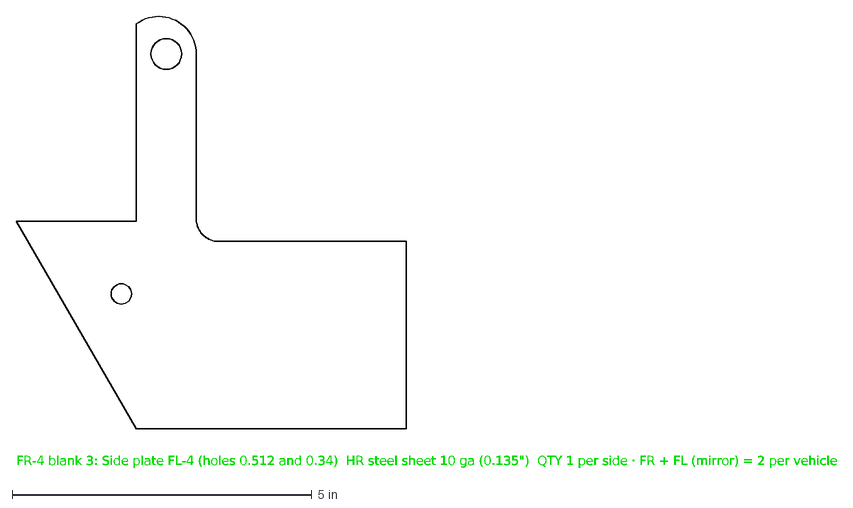
[picture p102: CAD file, 2026-10-03]
drawings/FR-4-bent_3.dxf
FR-4 blank 3: Side plate FL-4 (holes 0.512 and 0.34) HR steel sheet 10 ga (0.135") QTY 1 per side · FR + FL (mirror) = 2 per vehicle
