diademal/nyc-tlc-wav/drawings/MFG/FF-3-3_cut.dxf

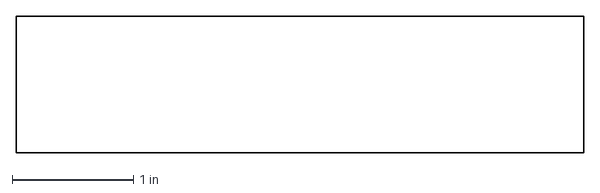
[picture p103: CAD file, 2026-10-31]
drawings/MFG/FF-3-3_cut.dxf
4.69 x 1.12 in
