diademal/nyc-tlc-wav/drawings/FR-7_1.dxf

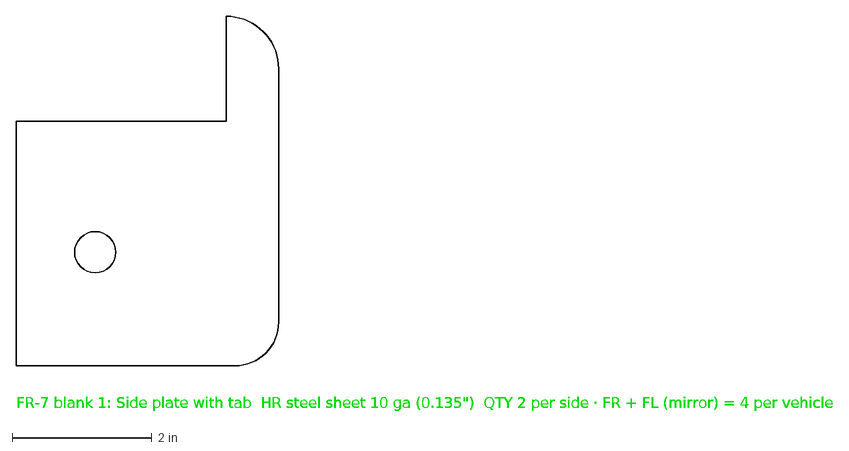
[picture p104: CAD file, 2026-10-03]
drawings/FR-7_1.dxf
FR-7 blank 1: Side plate with tab HR steel sheet 10 ga (0.135") QTY 2 per side · FR + FL (mirror) = 4 per vehicle
