diademal/nyc-tlc-wav/drawings/MFG/FR-4-2_FR_cut.dxf

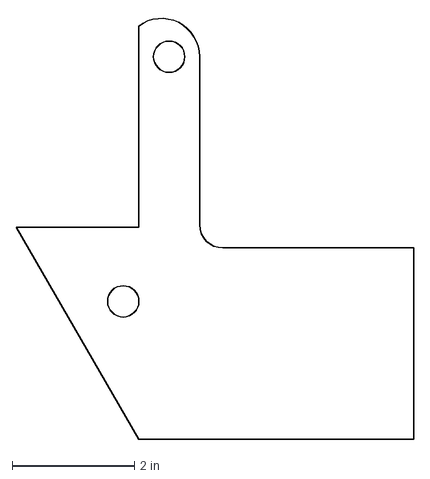
[picture p105: CAD file, 2026-10-31]
drawings/MFG/FR-4-2_FR_cut.dxf
6.50 x 6.91 in
