diademal/nyc-tlc-wav/drawings/MFG/FF-3-2_cut.dxf

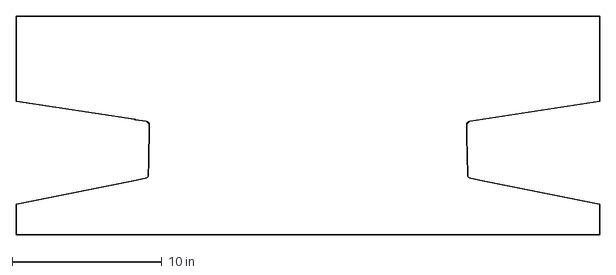
[picture p107: CAD file, 2026-10-31]
drawings/MFG/FF-3-2_cut.dxf
39.0 x 14.6 in
