diademal/nyc-tlc-wav/drawings/MFG/FR-2_FL_cut.dxf

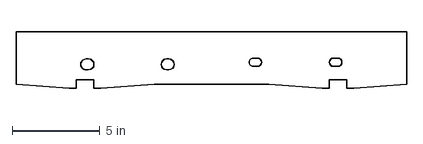
[picture p108: CAD file, 2026-10-31]
drawings/MFG/FR-2_FL_cut.dxf
22.3 x 3.25 in
