diademal/nyc-tlc-wav/drawings/FR-2-bent_3.dxf

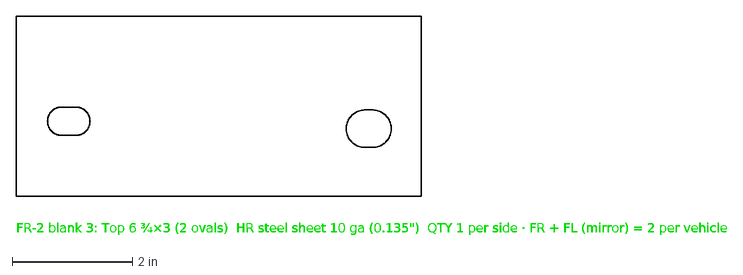
[picture p109: CAD file, 2026-10-03]
drawings/FR-2-bent_3.dxf
FR-2 blank 3: Top 6 ¾×3 (2 ovals) HR steel sheet 10 ga (0.135") QTY 1 per side · FR + FL (mirror) = 2 per vehicle
