diademal/nyc-tlc-wav/drawings/MFG/FR-11_FR_cut.dxf

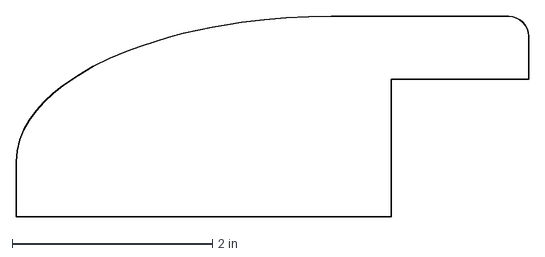
[picture p110: CAD file, 2026-10-31]
drawings/MFG/FR-11_FR_cut.dxf
5.12 x 2.00 in
