diademal/nyc-tlc-wav/drawings/FR-4-bent_1.dxf

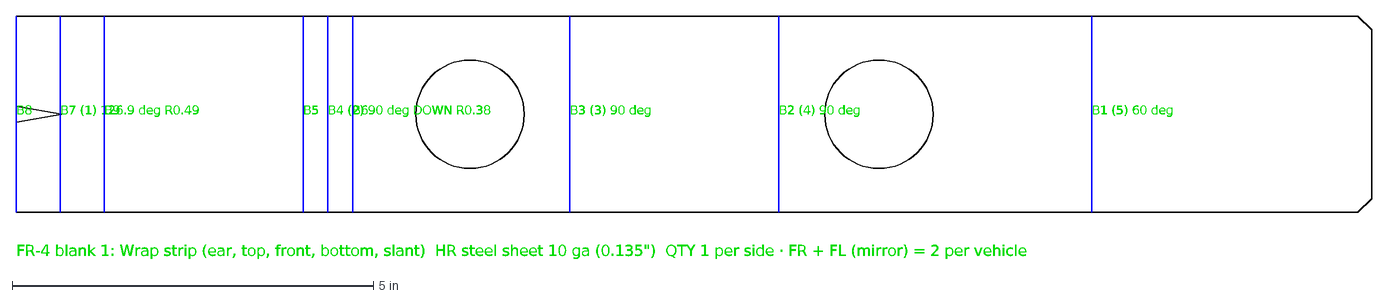
[picture p111: CAD file, 2026-10-03]
drawings/FR-4-bent_1.dxf
B1 (5) 60 deg
B2 (4) 90 deg
B3 (3) 90 deg
B4 (2) 90 deg DOWN R0.38
B5
B6
B7 (1) 126.9 deg R0.49
B8
B9
FR-4 blank 1: Wrap strip (ear, top, front, bottom, slant) HR steel sheet 10 ga (0.135") QTY 1 per side · FR + FL (mirror) = 2 per vehicle
