diademal/nyc-tlc-wav/drawings/FR-7-bent_2.dxf

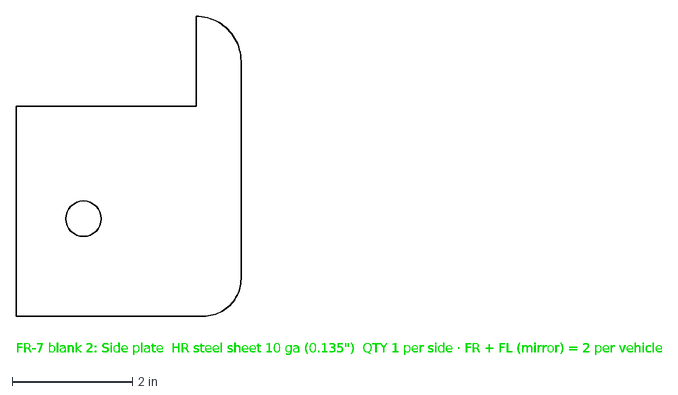
[picture p113: CAD file, 2026-10-03]
drawings/FR-7-bent_2.dxf
FR-7 blank 2: Side plate HR steel sheet 10 ga (0.135") QTY 1 per side · FR + FL (mirror) = 2 per vehicle
