diademal/nyc-tlc-wav/drawings/FR-7_3.dxf

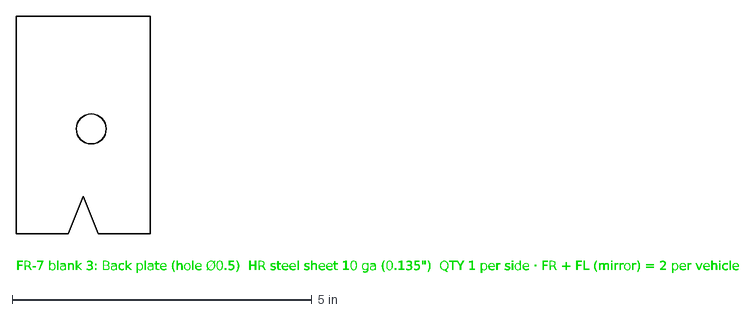
[picture p115: CAD file, 2026-10-03]
drawings/FR-7_3.dxf
FR-7 blank 3: Back plate (hole Ø0.5) HR steel sheet 10 ga (0.135") QTY 1 per side · FR + FL (mirror) = 2 per vehicle
