diademal/nyc-tlc-wav/drawings/MFG/FR-4-1_FL_cut.dxf

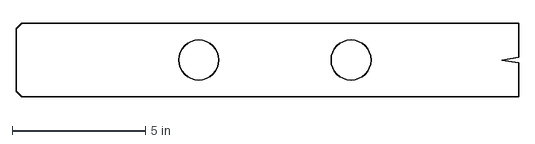
[picture p116: CAD file, 2026-10-31]
drawings/MFG/FR-4-1_FL_cut.dxf
18.8 x 2.75 in
