diademal/nyc-tlc-wav/drawings/FR-3_1.dxf

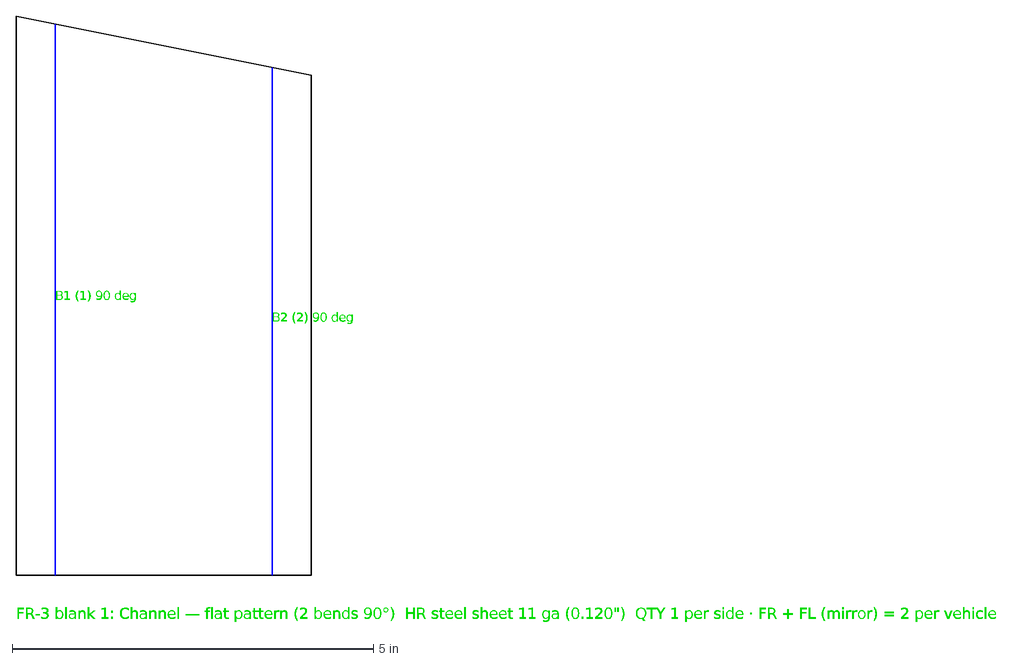
[picture p117: CAD file, 2026-10-03]
drawings/FR-3_1.dxf
B1 (1) 90 deg
B2 (2) 90 deg
FR-3 blank 1: Channel — flat pattern (2 bends 90°) HR steel sheet 11 ga (0.120") QTY 1 per side · FR + FL (mirror) = 2 per vehicle
