diademal/nyc-tlc-wav/drawings/MFG/RA-8_cut.dxf

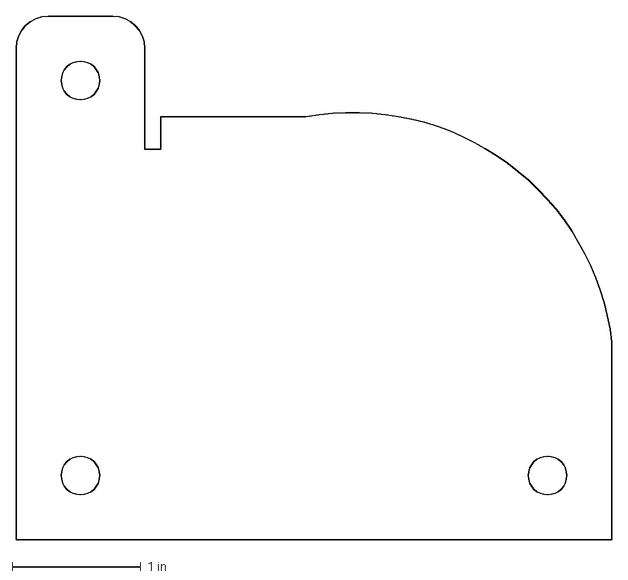
[picture p118: CAD file, 2026-10-31]
drawings/MFG/RA-8_cut.dxf
4.62 x 4.07 in
