diademal/nyc-tlc-wav/drawings/MFG/FR-3_FR_cut.dxf

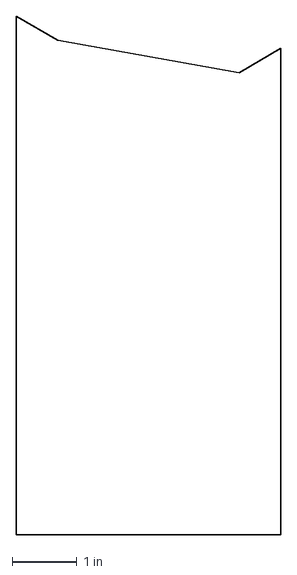
[picture p119: CAD file, 2026-10-31]
drawings/MFG/FR-3_FR_cut.dxf
4.08 x 8.00 in
