diademal/nyc-tlc-wav/drawings/MFG/FR-11_FL_cut.dxf

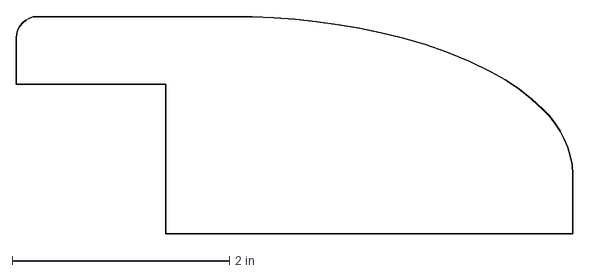
[picture p120: CAD file, 2026-10-31]
drawings/MFG/FR-11_FL_cut.dxf
5.12 x 2.00 in
