diademal/nyc-tlc-wav/drawings/MFG/FR-4-3_ref.dxf

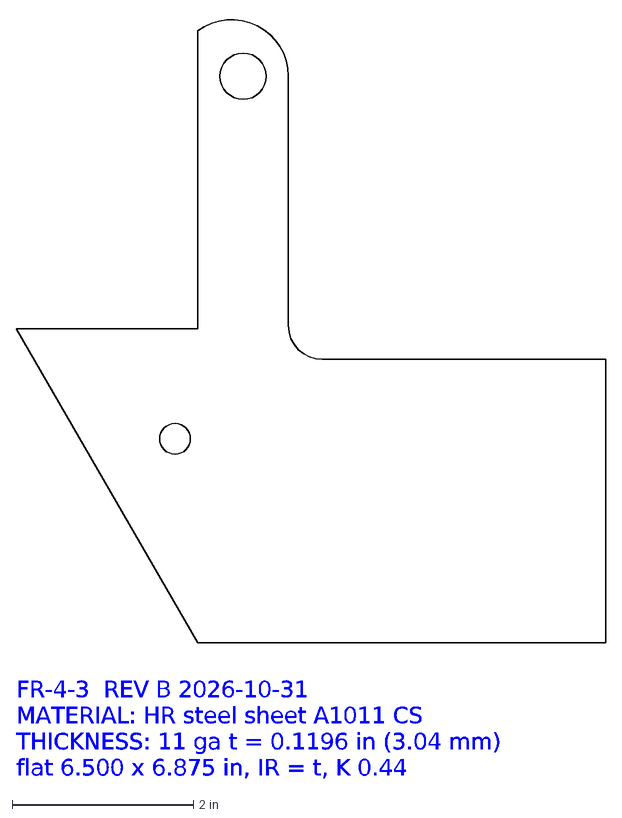
[picture p121: CAD file, 2026-10-31]
drawings/MFG/FR-4-3_ref.dxf
FR-4-3 REV B 2026-10-31
MATERIAL: HR steel sheet A1011 CS
THICKNESS: 11 ga t = 0.1196 in (3.04 mm)
flat 6.500 x 6.875 in, IR = t, K 0.44
