diademal/nyc-tlc-wav/drawings/MFG/RA-6_cut.dxf

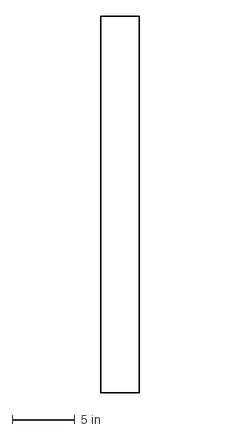
[picture p122: CAD file, 2026-10-31]
drawings/MFG/RA-6_cut.dxf
3.07 x 30.0 in
