diademal/nyc-tlc-wav/drawings/MFG/FR-10-1_ref.dxf

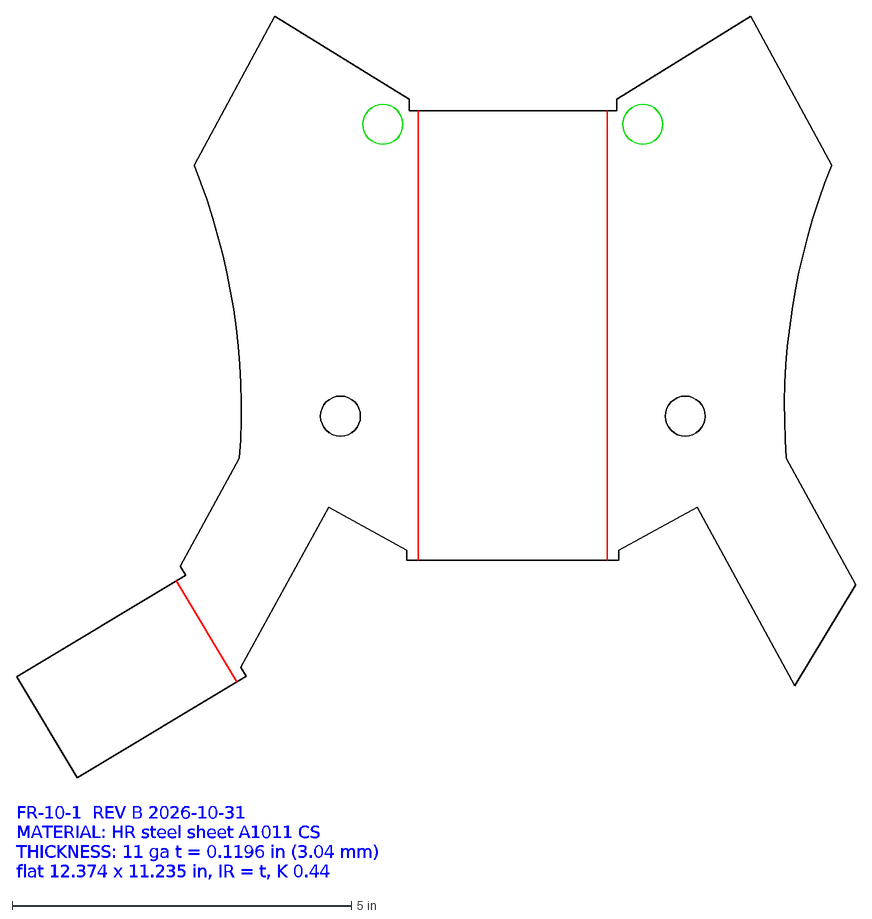
[picture p123: CAD file, 2026-10-31]
drawings/MFG/FR-10-1_ref.dxf
FR-10-1 REV B 2026-10-31
MATERIAL: HR steel sheet A1011 CS
THICKNESS: 11 ga t = 0.1196 in (3.04 mm)
flat 12.374 x 11.235 in, IR = t, K 0.44
