diademal/nyc-tlc-wav/drawings/MFG/FR-7_FR_cut.dxf

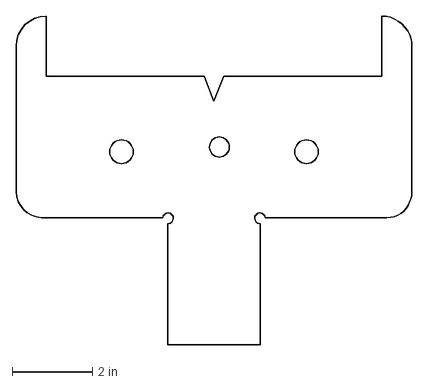
[picture p124: CAD file, 2026-10-31]
drawings/MFG/FR-7_FR_cut.dxf
9.85 x 8.19 in
