diademal/nyc-tlc-wav/drawings/MFG/FF-1_cut.dxf

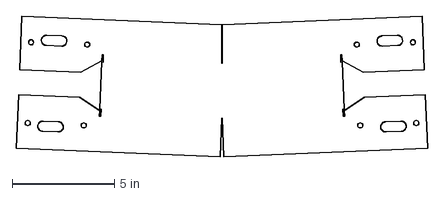
[picture p125: CAD file, 2026-10-31]
drawings/MFG/FF-1_cut.dxf
20.1 x 6.87 in
