diademal/nyc-tlc-wav/drawings/MFG/FR-4-3_FL_cut.dxf

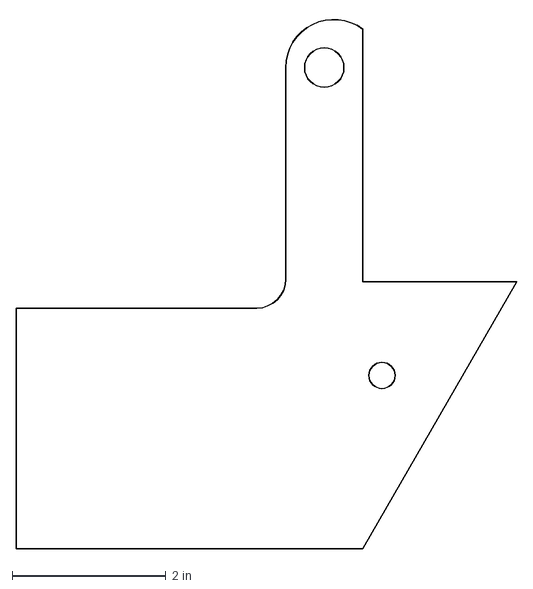
[picture p126: CAD file, 2026-10-31]
drawings/MFG/FR-4-3_FL_cut.dxf
6.50 x 6.91 in
