diademal/nyc-tlc-wav/drawings/MFG/FR-10-2_FR_cut.dxf

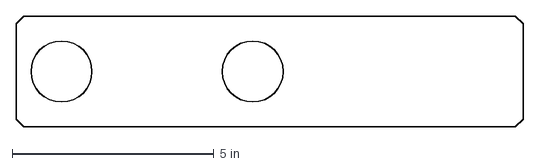
[picture p127: CAD file, 2026-10-31]
drawings/MFG/FR-10-2_FR_cut.dxf
12.6 x 2.75 in
