diademal/nyc-tlc-wav/drawings/MFG/RA-5_cut.dxf

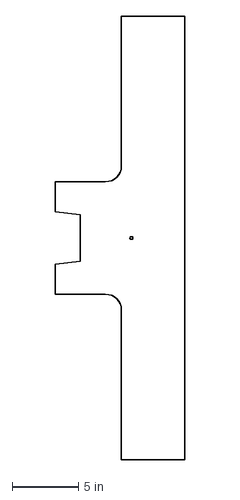
[picture p128: CAD file, 2026-10-31]
drawings/MFG/RA-5_cut.dxf
9.78 x 33.5 in
