diademal/nyc-tlc-wav/drawings/MFG/FR-2_ref.dxf

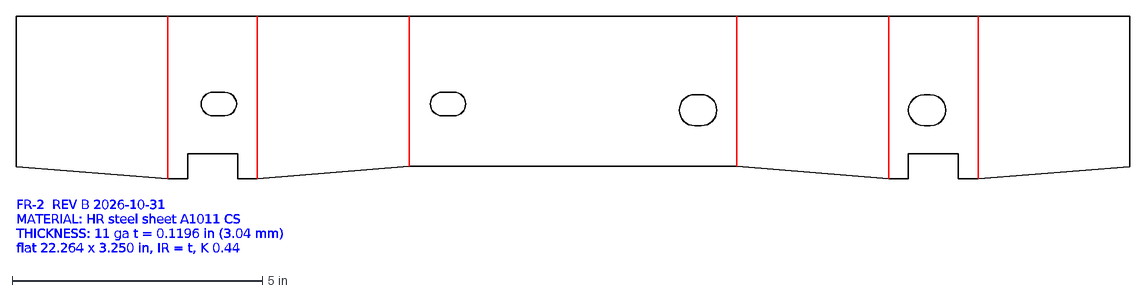
[picture p130: CAD file, 2026-10-31]
drawings/MFG/FR-2_ref.dxf
FR-2 REV B 2026-10-31
MATERIAL: HR steel sheet A1011 CS
THICKNESS: 11 ga t = 0.1196 in (3.04 mm)
flat 22.264 x 3.250 in, IR = t, K 0.44
