diademal/nyc-tlc-wav/drawings/MFG/FR-10-2_ref.dxf

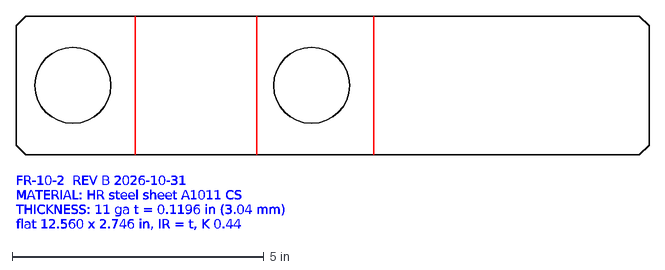
[picture p132: CAD file, 2026-10-31]
drawings/MFG/FR-10-2_ref.dxf
FR-10-2 REV B 2026-10-31
MATERIAL: HR steel sheet A1011 CS
THICKNESS: 11 ga t = 0.1196 in (3.04 mm)
flat 12.560 x 2.746 in, IR = t, K 0.44
