diademal/nyc-tlc-wav/drawings/MFG/FR-8_ref.dxf

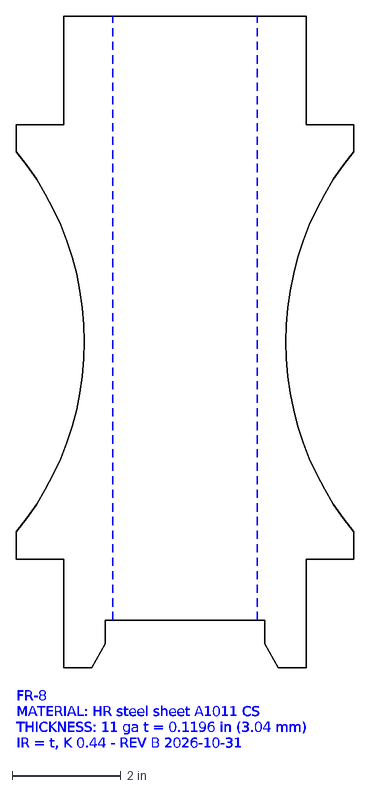
[picture p133: CAD file, 2026-10-31]
drawings/MFG/FR-8_ref.dxf
FR-8
MATERIAL: HR steel sheet A1011 CS
THICKNESS: 11 ga t = 0.1196 in (3.04 mm)
IR = t, K 0.44 - REV B 2026-10-31
