diademal/nyc-tlc-wav/drawings/MFG/FR-10-1_FR_cut.dxf

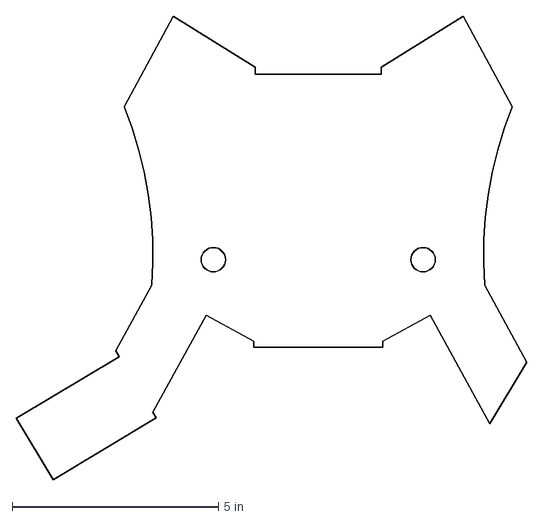
[picture p138: CAD file, 2026-10-31]
drawings/MFG/FR-10-1_FR_cut.dxf
12.4 x 11.2 in
