diademal/nyc-tlc-wav/drawings/MFG/FR-1_FR_cut.dxf

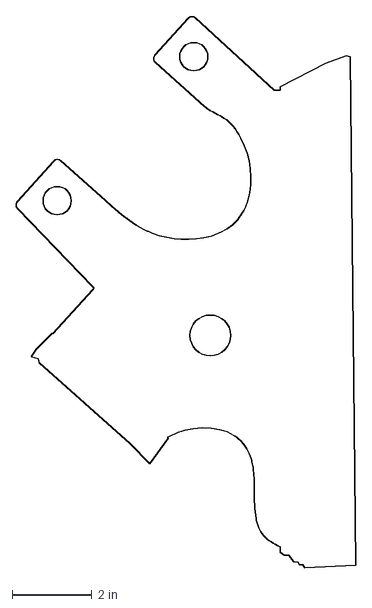
[picture p141: CAD file, 2026-10-31]
drawings/MFG/FR-1_FR_cut.dxf
8.54 x 13.9 in
