diademal/nyc-tlc-wav/(list of files, cad)

Other CAD files:
drawings/LASER/ALUMINUM_0.125_sheet1_of1_48x96_MARKED.dxf
drawings/MFG/RA-3A_cut.dxf
drawings/LASER/STEEL_11ga_sheet1_of1_48x96_MARKED.dxf
drawings/MFG/RA-3A_ref.dxf
drawings/LASER/STEEL_11ga_sheet1_of1_48x96_CUT.dxf
drawings/MFG/RA-3B_cut.dxf
drawings/MFG/RA-3B_ref.dxf
drawings/LASER/ALUMINUM_0.125_sheet1_of1_48x96_CUT.dxf
drawings/MFG/RA-3L_cut.dxf
drawings/MFG/RA-3L_ref.dxf
drawings/MFG/RA-7_ref.dxf
drawings/MFG/RA-7_cut.dxf
drawings/FF-3_1.dxf
drawings/MFG/RA-3_cut.dxf
drawings/FF-3_2.dxf
drawings/MFG/RA-3_ref.dxf
