diademal/nyc-tlc-wav/build.txt

build 2026-10-31T18:35:33Z v32: ramp 3D overview + 3D/Flat toggle like frame
