diademal/nyc-tlc-wav/drawings/ALL_shop_drawings.pdf

0,0 DATUM

FF-1 | blank 1 of 1
Channel with ears | flat pattern, one piece (4 bends 90°, web on top)

### HR steel sheet 10 ga (0.135 )

QTY: 1 per vehicle

inches · flat blank, 1:1 in DXF

cut ±0.010 · bends ±1° · IR = t

Sienna WAV frame · 2026-10-02

# SHEET 1 / 1

FF-1 | blank 1 of 1
Channel with ears | flat pattern, one piece (4 bends 90°, web on top) · blank 20.139 × 6.818 · HR steel sheet 10 ga (0.135 ) · 1 per vehicle

## HOLES (centre X, Y from datum)

H1 Ø0.250 | X 19.588 | Y 1.644
H2 Ø0.250 | X 19.425 | Y 5.548

### H3 slot 1.250 × 0.500 @2° X 18.469 Y 1.473 H4 slot 1.250 × 0.500 @2° X 18.296 Y 5.627

H5 Ø0.250 | X 16.840 | Y 1.530
H6 Ø0.250 | X 16.678 | Y 5.434
H7 Ø0.250 | X 3.462 | Y 5.434
H8 Ø0.250 | X 3.299 | Y 1.530

### H9 slot 1.250 × 0.500 @-2° X 1.844 Y 5.627 H10 slot 1.250 × 0.500 @-2° X 1.670 Y 1.473

H11 Ø0.250 | X 0.714 | Y 5.548
H12 Ø0.250 | X 0.552 | Y 1.644

## BENDS (bend centre line, from datum) IR = t = 10 ga (0.135 )

B1 (1)/(3) 90° | (10.070, 1.881) | (16.002, 2.129)
B2 (2)/(4) 90° | (4.137, 2.129) | (10.070, 1.881)
B3 radius-bend edge | (10.070, 4.525) | (15.892, 4.768)
B4 radius-bend edge | (4.247, 4.768) | (10.070, 4.525)

### radius-bend edge = start/end of a large-radius bend (bump bend between them)

## OUTLINE POINTS (X, Y from datum)

P1 | 0.000 | 0.416
P2 | 0.109 | 3.039
P3 | 3.107 | 2.914
P4 | 4.079 | 2.249
P5 | 4.067 | 1.972
P6 | 4.131 | 1.969
P7 | 4.144 | 2.288
P8 | 4.082 | 2.291
P9 | 4.178 | 4.610
P10 | 4.241 | 4.608
P11 | 4.254 | 4.927
P12 | 4.191 | 4.930
P13 | 4.179 | 4.653
P14 | 3.155 | 4.071
P15 | 0.158 | 4.196
P16 | 0.267 | 6.818
P17 | 10.062 | 6.410
P18 | 10.062 | 4.525
P19 | 10.078 | 4.525
P20 | 10.078 | 6.410
P21 | 19.873 | 6.818
P22 | 19.982 | 4.196
P23 | 16.985 | 4.071
P24 | 15.960 | 4.653
P25 | 15.949 | 4.930
P26 | 15.886 | 4.927
P27 | 15.899 | 4.608
P28 | 15.961 | 4.610
P29 | 16.058 | 2.291
P30 | 15.995 | 2.288
P31 | 16.009 | 1.969
P32 | 16.072 | 1.971
P33 | 16.061 | 2.249
P34 | 17.033 | 2.914
P35 | 20.030 | 3.039
P36 | 20.140 | 0.416
P37 | 10.148 | 0.000
P38 | 10.070 | 1.870
P39 | 9.991 | 0.000

## NOTES

1. Cut from the DXF file (1:1, inches). This sheet is for checking.
2. Material: HR steel sheet 10 ga (0.135 ) (t). Inside bend radius = t.
3. Flat pattern already includes bend allowance (K = 0.44, R = t).
4. Blue dashed = bend centre lines (B1, B2 ...). = bend DOWN (away from you), no arrow = bend UP. Red dashed = drill later.
5. Deburr all edges. Curved edges: smooth arcs per DXF.
* one blank: the web is a chevron 6 +6 (ends ¼ out); bend the walls 90° down on the dashed lines, each in 2 hits (6
to the middle); outer wall has a V-notch | closes after bending, weld it; inner wall has a slit | opens ~0.16 after
bending, weld it; the ears reach past the bend line; 1/16 relief slit at the bend end

FF-3 | blank 1 of 4
FF3-1 top plate | flat pattern, 10 bends 90° down · blank 39.403 × 15.073 · HR steel sheet 11 ga (0.120 ) · 1 per vehicle

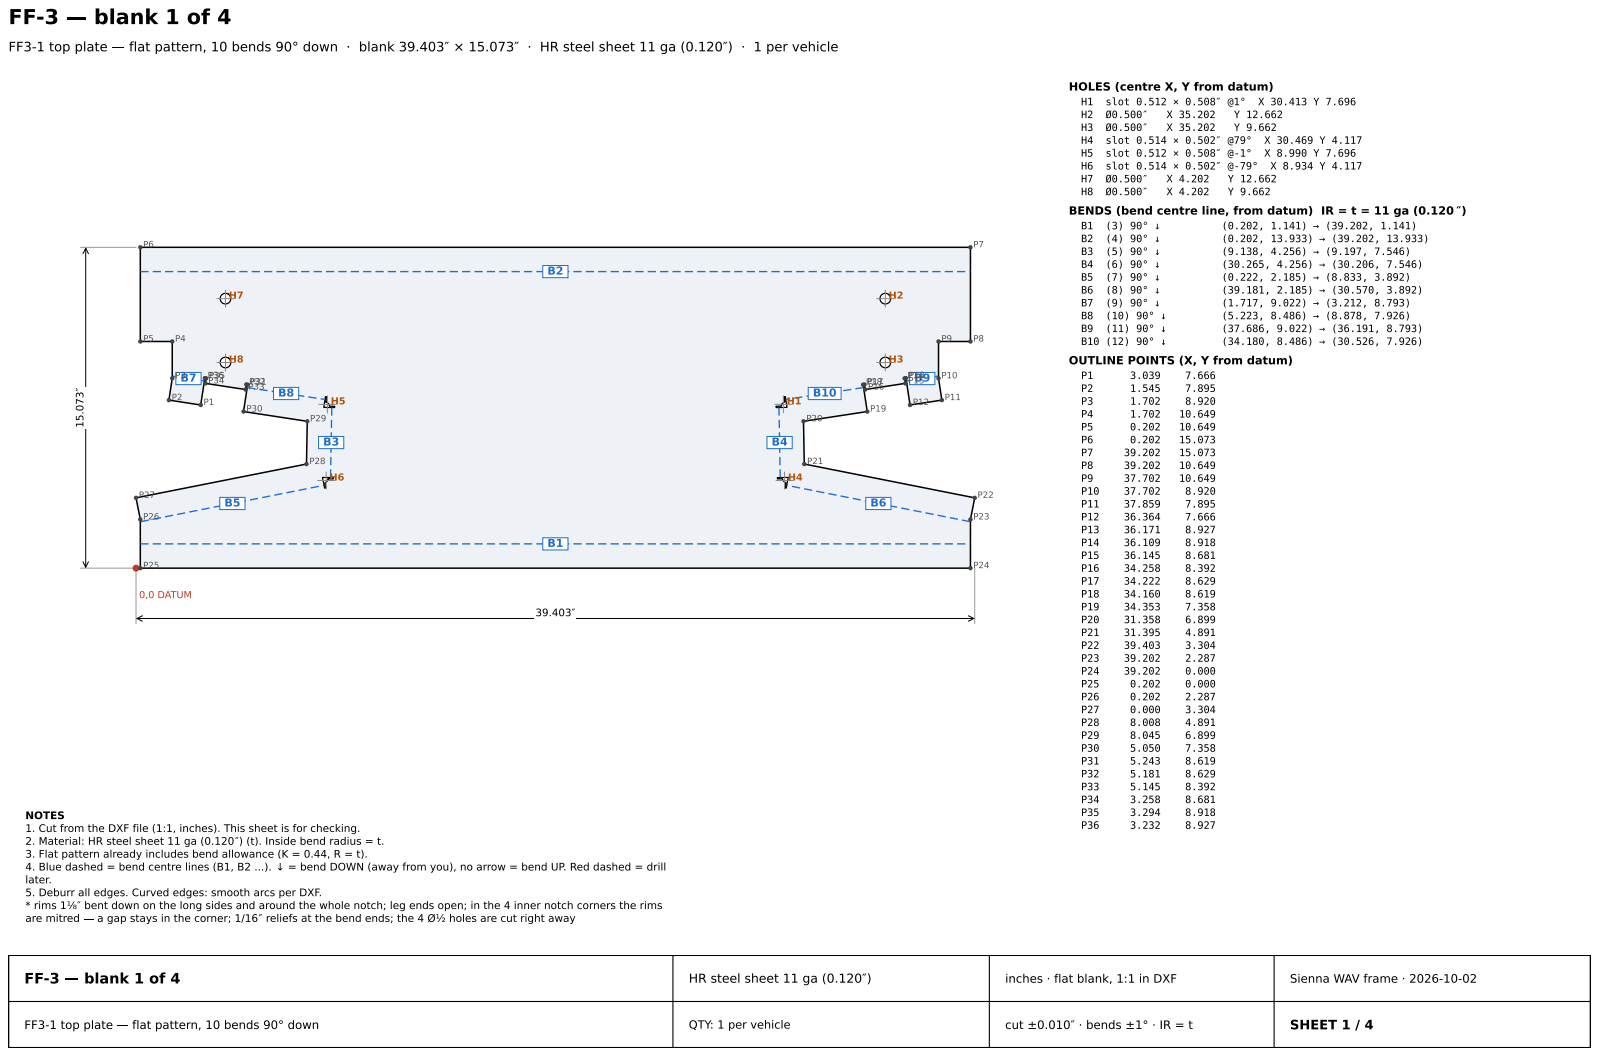
[picture p143: page 2]

HOLES (centre X, Y from datum)
H1 slot 0.512 × 0.508 @1° X 30.413 Y 7.696
H4 slot 0.514 × 0.502 @79° X 30.469 Y 4.117
H5 slot 0.512 × 0.508 @-1° X 8.990 Y 7.696
H6 slot 0.514 × 0.502 @-79° X 8.934 Y 4.117
BENDS (bend centre line, from datum) IR = t = 11 ga (0.120 )
OUTLINE POINTS (X, Y from datum)

NOTES
1. Cut from the DXF file (1:1, inches). This sheet is for checking.
2. Material: HR steel sheet 11 ga (0.120 ) (t). Inside bend radius = t.
3. Flat pattern already includes bend allowance (K = 0.44, R = t).
later.
5. Deburr all edges. Curved edges: smooth arcs per DXF.

HR steel sheet 11 ga (0.120 )

inches · flat blank, 1:1 in DXF

FF-3 | blank 2 of 4
FF3-2 lower plate | flat pattern, 2 bends 90° up · blank 39.000 × 14.595 · HR steel sheet 11 ga (0.120 ) · 1 per vehicle

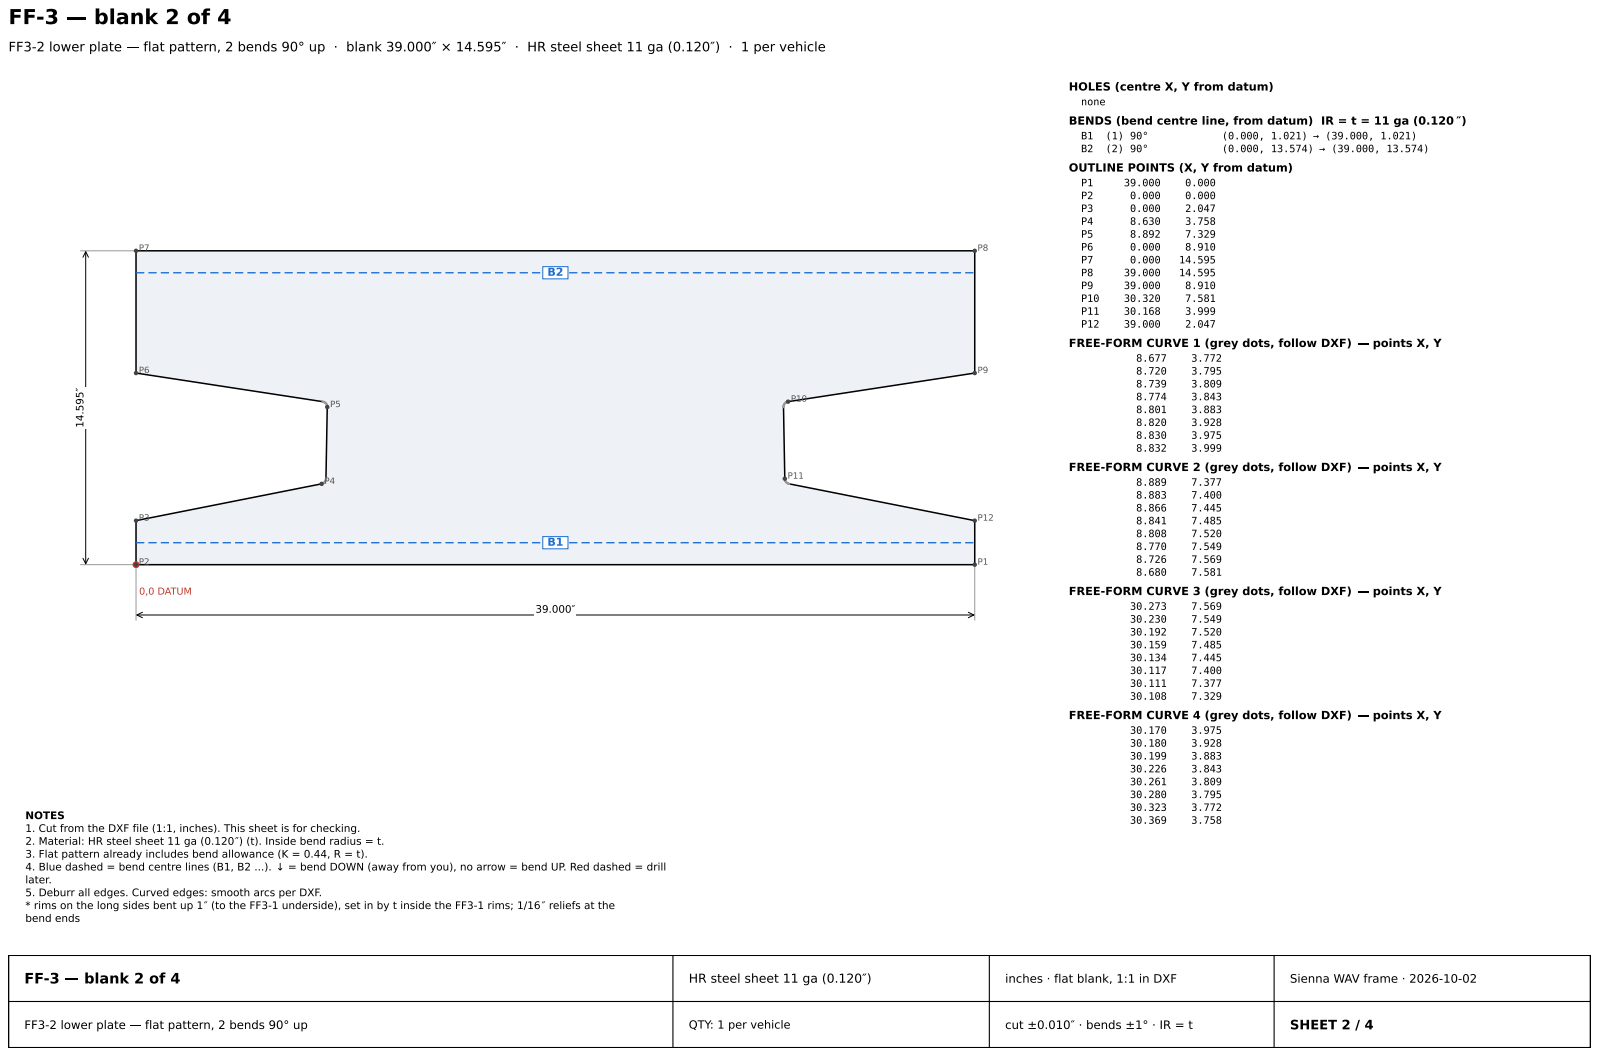
[picture p144: page 3]

HOLES (centre X, Y from datum)
none
BENDS (bend centre line, from datum) IR = t = 11 ga (0.120 )
OUTLINE POINTS (X, Y from datum)

1. Cut from the DXF file (1:1, inches). This sheet is for checking.
2. Material: HR steel sheet 11 ga (0.120 ) (t). Inside bend radius = t.
3. Flat pattern already includes bend allowance (K = 0.44, R = t).
later.
5. Deburr all edges. Curved edges: smooth arcs per DXF.
* rims on the long sides bent up 1 (to the FF3-1 underside), set in by t inside the FF3-1 rims; 1/16 reliefs at the
bend ends

FF-3 blank 2 of 4 | HR steel sheet 11 ga (0.120 ) | inches · flat blank, 1:1 in DXF | Sienna WAV frame · 2026-10-02

FF3-2 lower plate flat pattern, 2 bends 90° up | QTY: 1 per vehicle | | SHEET 2 / 4

FF-3 | blank 3 of 4
Passage wall 1 | × 4.69 (instead of the tube) · blank 4.687 × 1.125 · HR steel sheet 11 ga (0.120 ) · 2 per vehicle

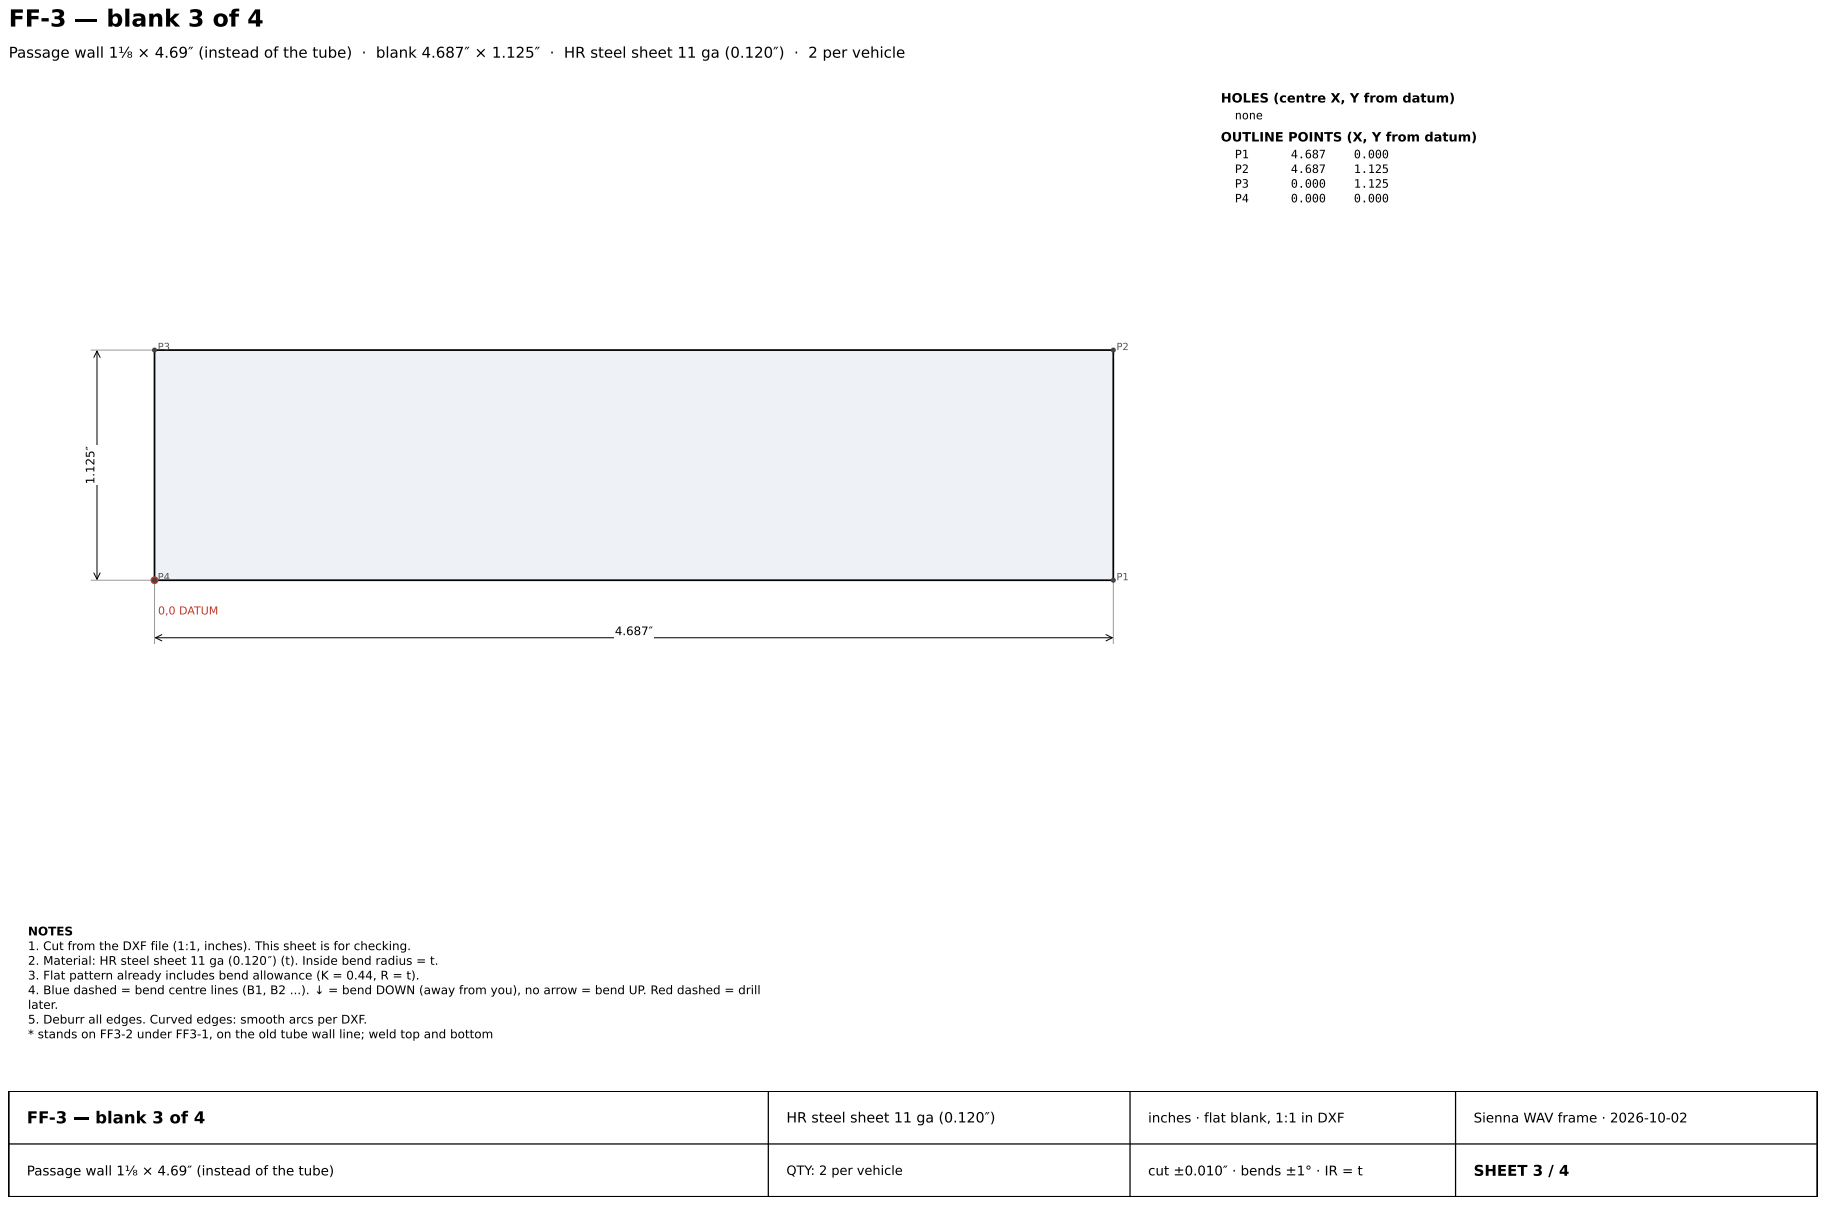
[picture p145: page 4]
0,0 DATUM; 4. Blue dashed = bend centre lines (B1, B2 ...).; = bend DOWN (away from you), no arrow = bend UP. Red dashed = drill

HOLES (centre X, Y from datum)
none
OUTLINE POINTS (X, Y from datum)

NOTES
1. Cut from the DXF file (1:1, inches). This sheet is for checking.
2. Material: HR steel sheet 11 ga (0.120 ) (t). Inside bend radius = t.
3. Flat pattern already includes bend allowance (K = 0.44, R = t).
later.
5. Deburr all edges. Curved edges: smooth arcs per DXF.
* stands on FF3-2 under FF3-1, on the old tube wall line; weld top and bottom

FF-3 blank 3 of 4 | HR steel sheet 11 ga (0.120 ) | inches · flat blank, 1:1 in DXF | Sienna WAV frame · 2026-10-02

Passage wall 1 × 4.69 (instead of the tube) | QTY: 2 per vehicle | | SHEET 3 / 4

FF-3 | blank 4 of 4
Passage wall 1 | × 5.01 (instead of the tube) · blank 5.013 × 1.125 · HR steel sheet 11 ga (0.120 ) · 2 per vehicle

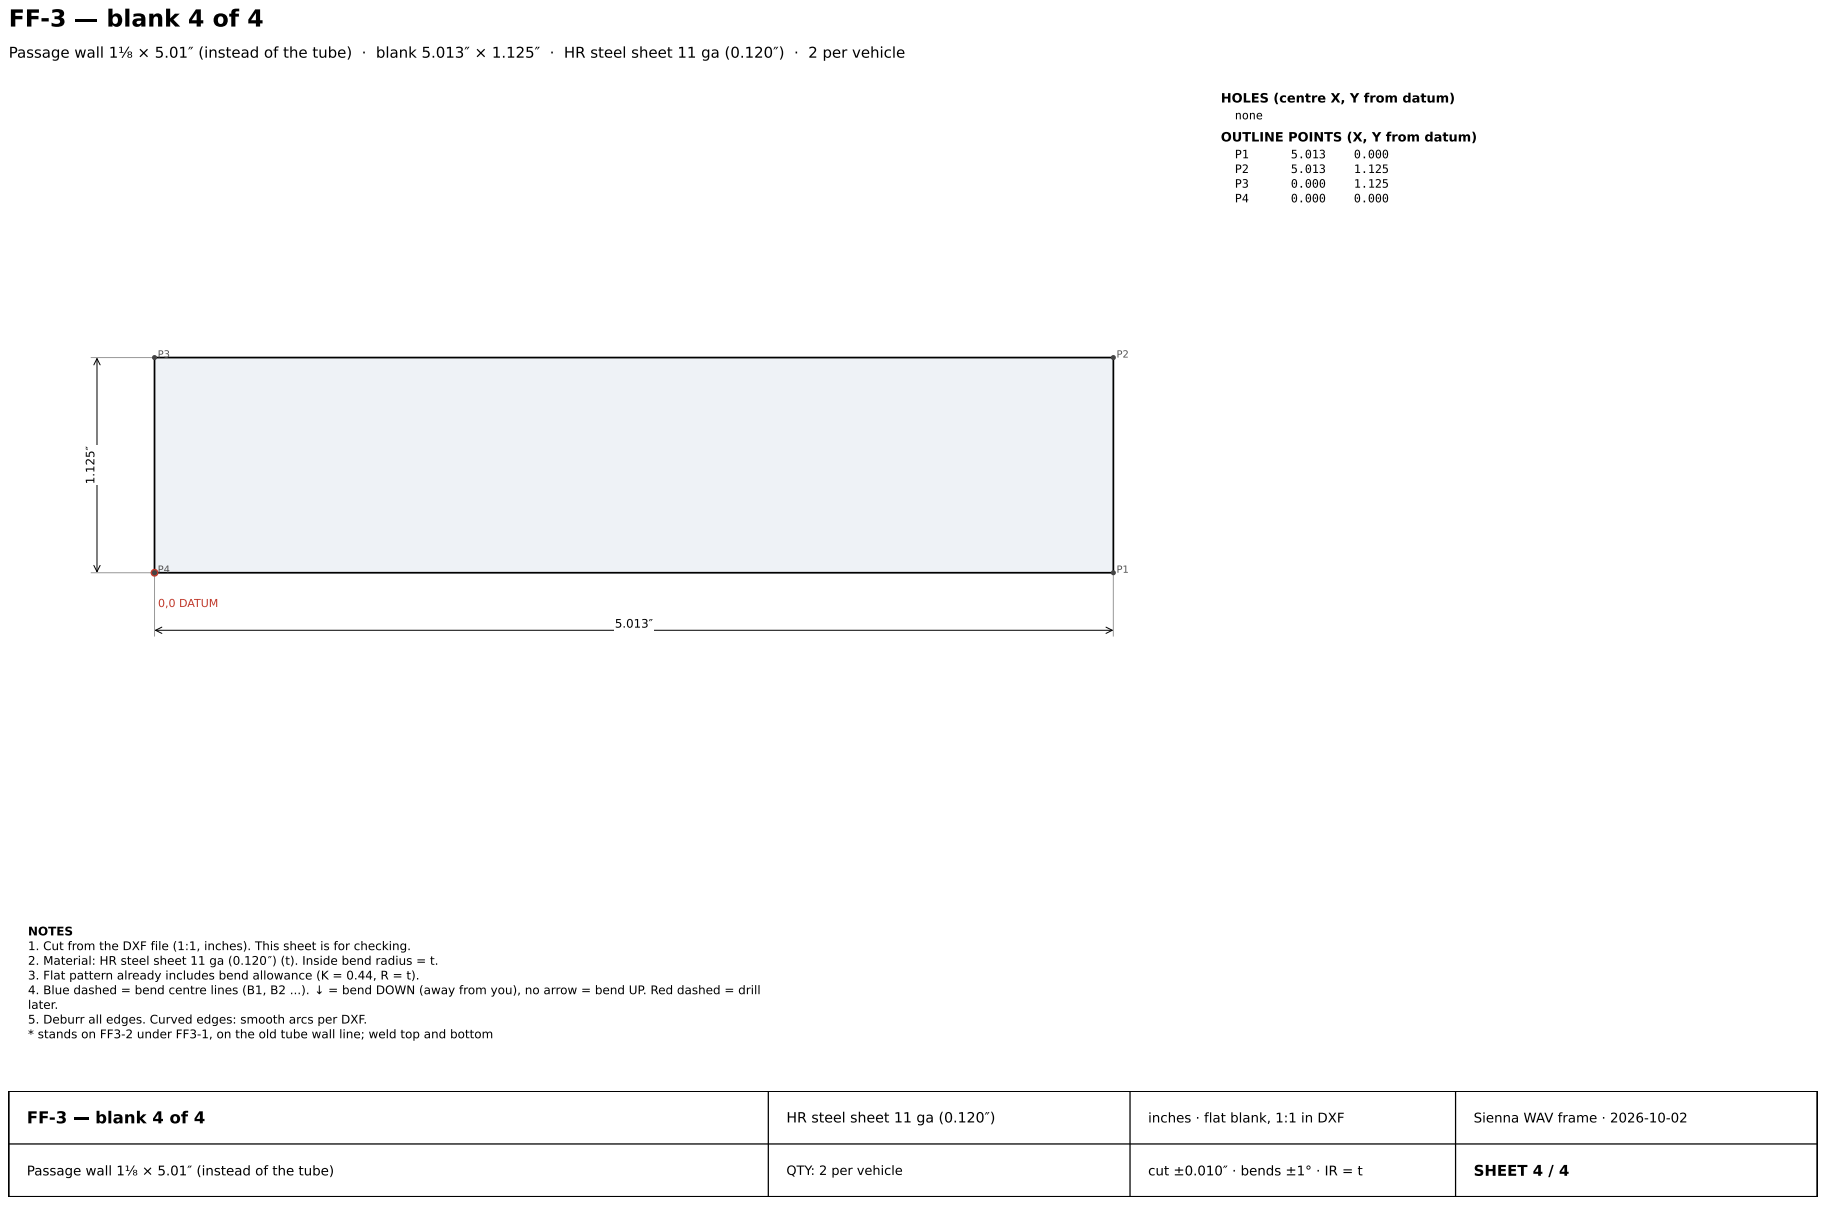
[picture p146: page 5]
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

HOLES (centre X, Y from datum)
none
OUTLINE POINTS (X, Y from datum)

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

FF-3 blank 4 of 4 | HR steel sheet 11 ga (0.120 ) | inches · flat blank, 1:1 in DXF | Sienna WAV frame · 2026-10-02

Passage wall 1 × 5.01 (instead of the tube) | QTY: 2 per vehicle | | SHEET 4 / 4

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

FR-1 | FLAT PATTERN / | (scale 3:4 / | 3:4)

## blank 8.512" × 13.851" · 10 ga (0.135") plate · 2 bends 90° up · IR 0.135"

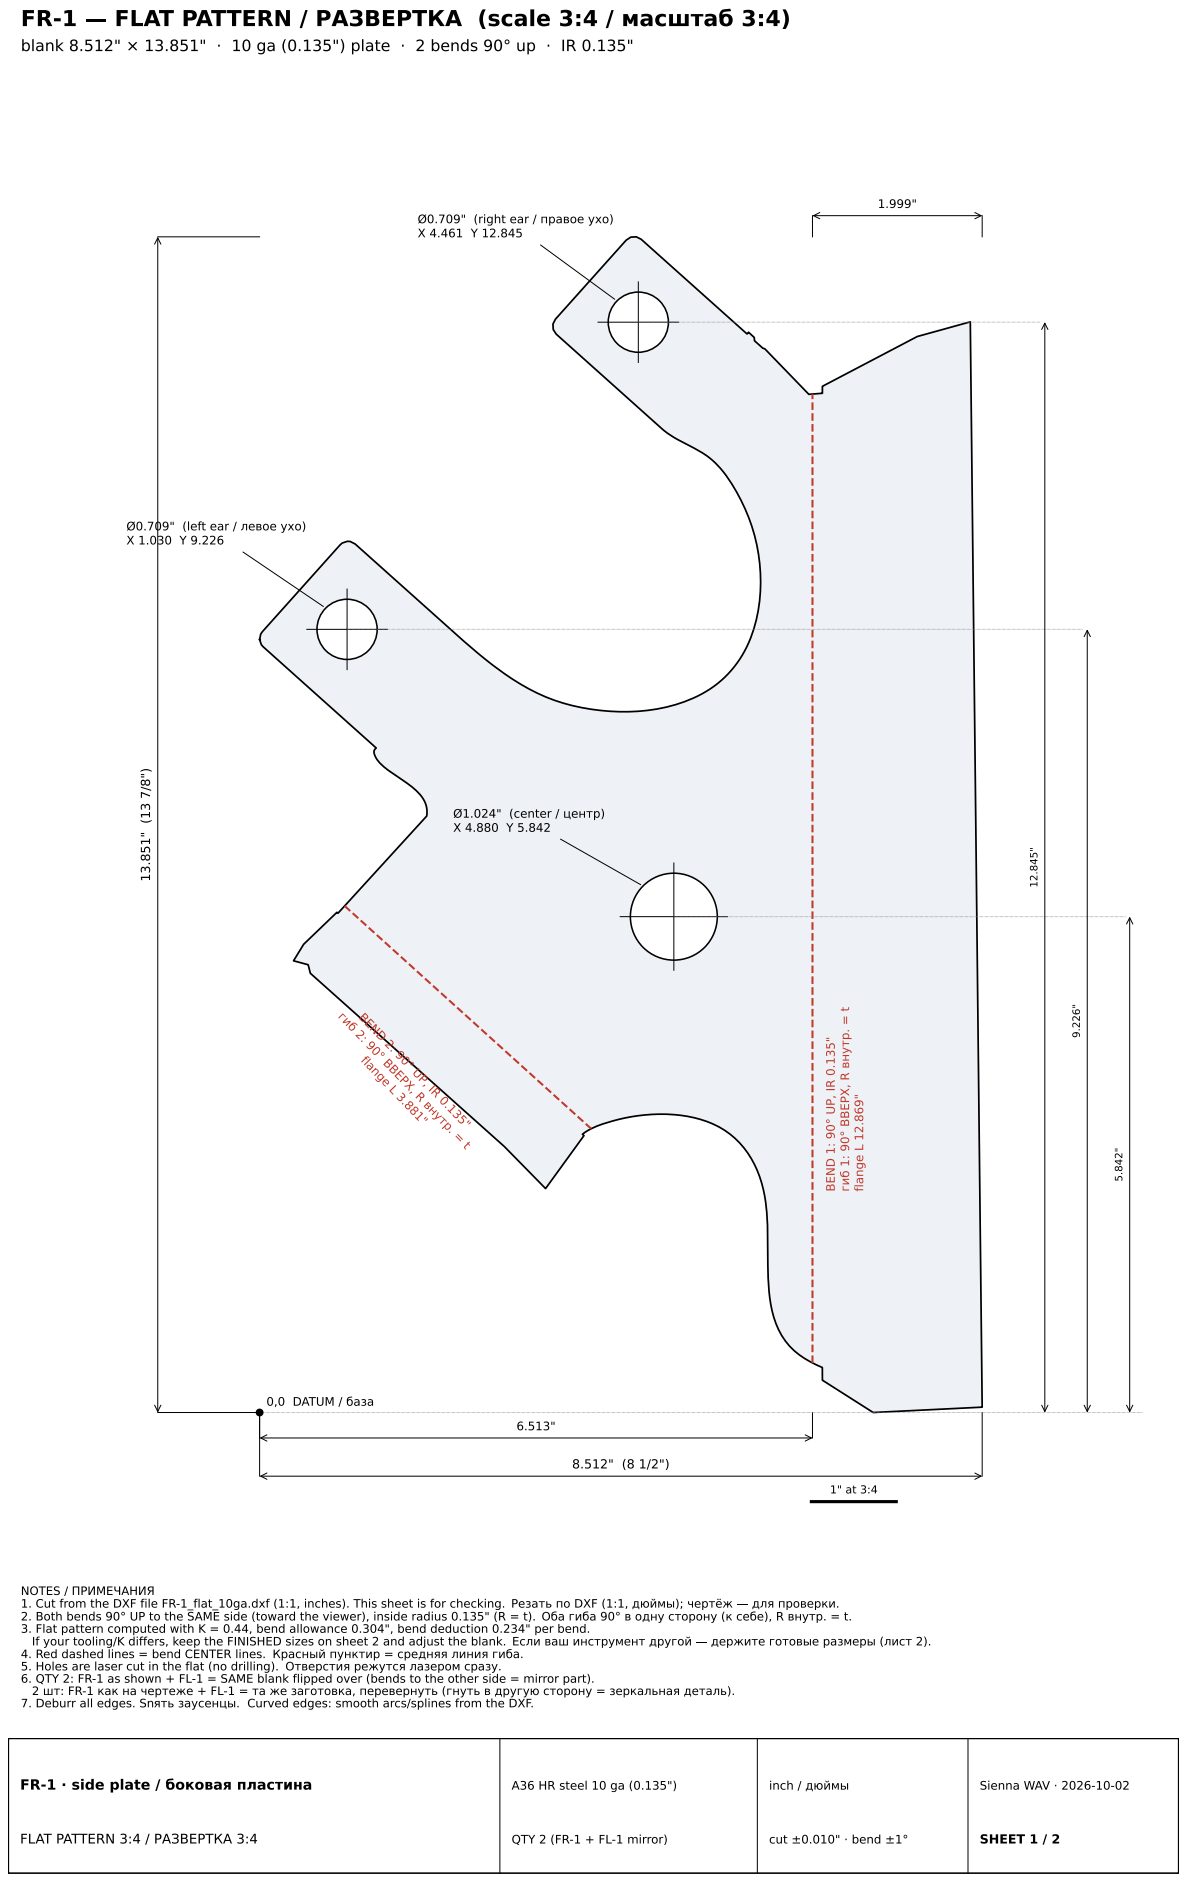
[picture p147: page 7]
Ø0.709" (right ear /; Ø0.709" (left ear /; Ø1.024" (center /; flange L 12.869"; flange L 3.881"; 0,0 DATUM /; FLAT PATTERN 3:4 /; inch /; cut ±0.010" · bend ±1°; Sienna WAV · 2026-10-02; SHEET 1 / 2; 1. Cut from the DXF file FR-1_flat_10ga.dxf (1:1, inches). This sheet is for checking.; DXF (1:1,; 2. Both bends 90° UP to the SAME side (toward the viewer), inside radius 0.135" (R = t).; If your tooling/K differs, keep the FINISHED sizes on sheet 2 and adjust the blank.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

BEND 2: 90° UP, IR 0.135"

BEND 1: 90° UP, IR 0.135"

NOTES /
3. Flat pattern computed with K = 0.44, bend allowance 0.304", bend deduction 0.234" per bend.
6. QTY 2: FR-1 as shown + FL-1 = SAME blank flipped over (bends to the other side = mirror part).

FR-1 · side plate /

A36 HR steel 10 ga (0.135")

QTY 2 (FR-1 + FL-1 mirror)

# FR-1 FINISHED PART /

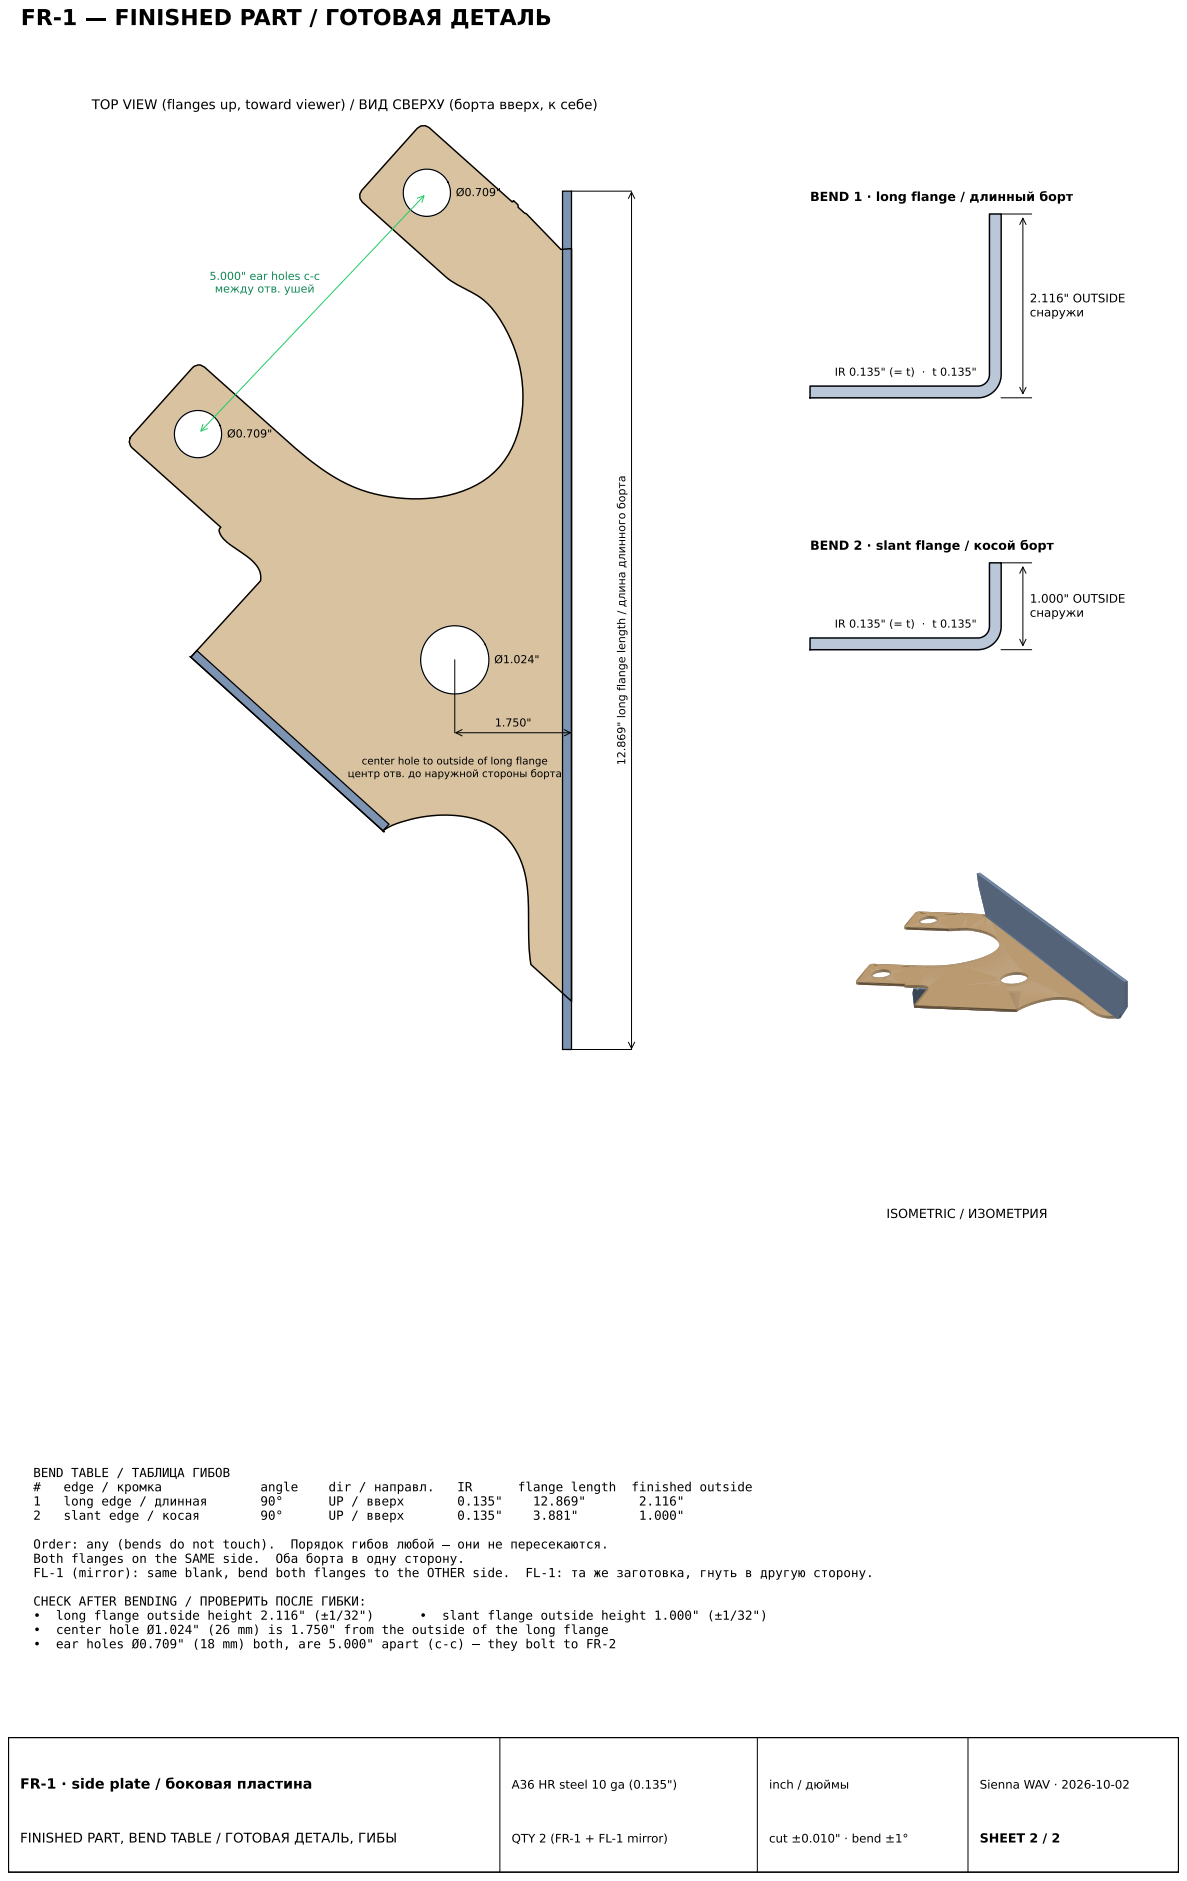
[picture p148: page 8]
TOP VIEW (flanges up, toward viewer) /; 5.000" ear holes c-c .; 2.116" OUTSIDE; 1.000" OUTSIDE; FINISHED PART, BEND TABLE /; inch /; cut ±0.010" · bend ±1°; Sienna WAV · 2026-10-02; SHEET 2 / 2; ISOMETRIC /; BEND TABLE /; edge /; angle; dir /; flange length; finished outside; long edge /; slant edge /; Order: any (bends do not touch).; Both flanges on the SAME side.; FL-1 (mirror): same blank, bend both flanges to the OTHER side.; CHECK AFTER BENDING /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

BEND 1 · long flange /

BEND 2 · slant flange /

12.869" long flange length /

center hole to outside of long flange

center hole Ø1.024" (26 mm) is 1.750" from the outside of the long flange

FR-1 · side plate /

A36 HR steel 10 ga (0.135")

QTY 2 (FR-1 + FL-1 mirror)

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

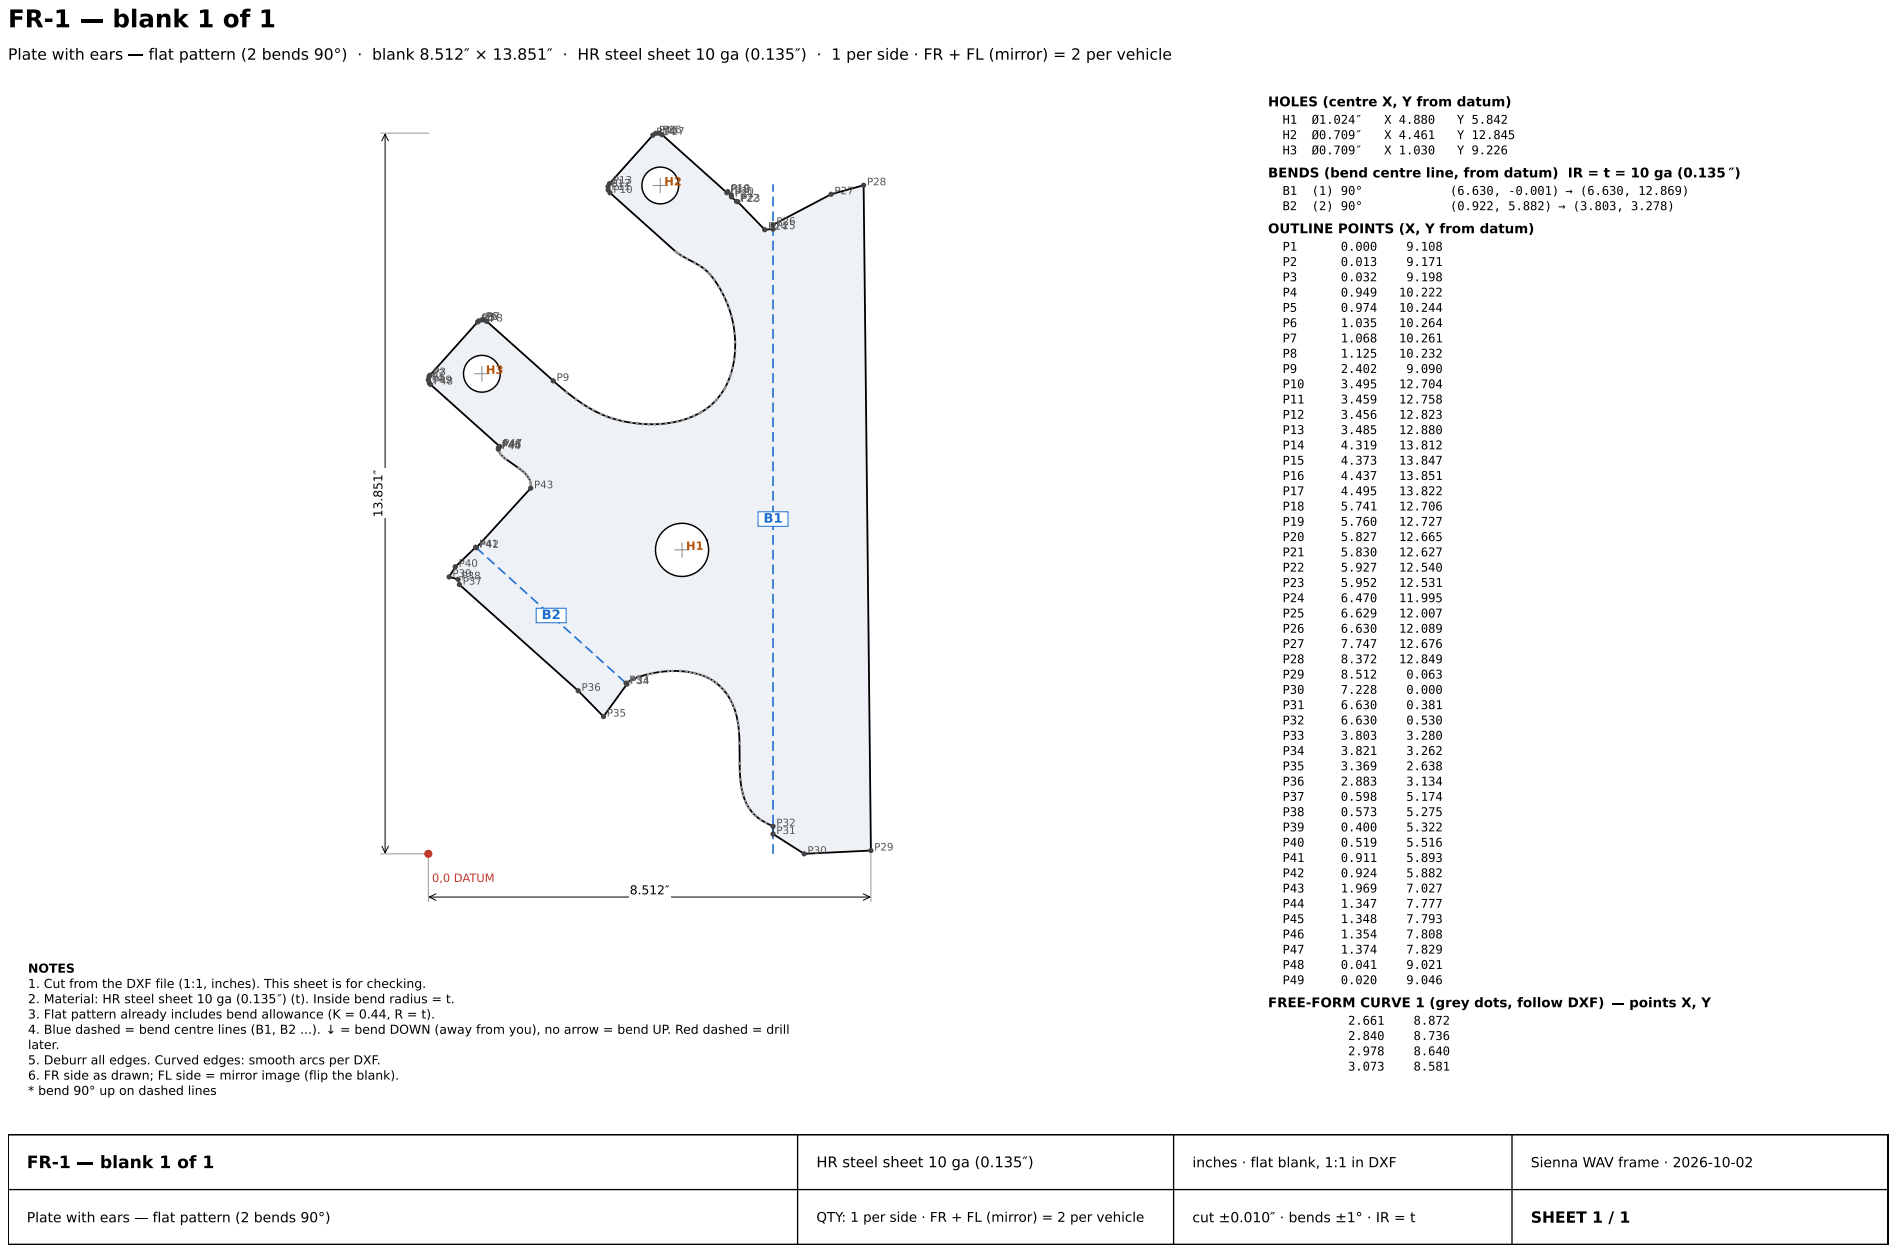
[picture p149: page 9]

FR-1 blank 1 of 1 | HR steel sheet 10 ga (0.135 ) | inches · flat blank, 1:1 in DXF | Sienna WAV frame · 2026-10-02
Plate with ears flat pattern (2 bends 90°) | QTY: 1 per side · FR + FL (mirror) = 2 per vehicle | | SHEET 1 / 1
FR-1 | blank 1 of 1 | tables (continued)
3.170 | 8.527
3.318 | 8.453
3.421 | 8.410
3.525 | 8.373
3.632 | 8.341
3.740 | 8.315
3.905 | 8.285
4.016 | 8.271
4.127 | 8.261
4.238 | 8.256
4.350 | 8.256
4.461 | 8.261
4.572 | 8.271
4.682 | 8.288
4.791 | 8.310
4.899 | 8.339
5.005 | 8.374
5.109 | 8.416
5.209 | 8.465
5.258 | 8.493
5.351 | 8.554
5.438 | 8.624
5.519 | 8.701
5.556 | 8.743
5.626 | 8.830
5.687 | 8.924
5.715 | 8.972
5.763 | 9.073
5.804 | 9.177
5.822 | 9.230
5.851 | 9.338
5.883 | 9.502
5.899 | 9.668
5.902 | 9.835
5.891 | 10.003
5.868 | 10.168
5.831 | 10.331
5.782 | 10.490
5.742 | 10.594
5.696 | 10.695
5.646 | 10.796
5.591 | 10.894
5.498 | 11.036
5.428 | 11.123
5.391 | 11.164
5.309 | 11.239
5.220 | 11.303
5.123 | 11.359
4.973 | 11.436
4.876 | 11.491
4.806 | 11.536
4.762 | 11.570
FREE-FORM CURVE 2 (grey dots, follow DXF) | points X, Y
6.490 | 0.596
6.389 | 0.657
6.297 | 0.728
6.242 | 0.783
6.171 | 0.875
6.131 | 0.942
6.097 | 1.012
6.057 | 1.122
6.037 | 1.197

FR-1 blank 1 of 1 | HR steel sheet 10 ga (0.135 ) | inches · flat blank, 1:1 in DXF | Sienna WAV frame · 2026-10-02
Plate with ears flat pattern (2 bends 90°) | | | SHEET 1 / 1
FR-1 | blank 1 of 1 | tables (continued)
6.022 | 1.273
6.001 | 1.427
5.991 | 1.583
5.987 | 1.738
5.985 | 2.127
5.974 | 2.360
5.962 | 2.475
5.950 | 2.552
5.915 | 2.704
5.877 | 2.814
5.847 | 2.886
5.812 | 2.955
5.752 | 3.055
5.681 | 3.148
5.628 | 3.204
5.540 | 3.281
5.476 | 3.326
5.409 | 3.366
5.340 | 3.400
5.267 | 3.429
5.193 | 3.453
5.118 | 3.473
5.042 | 3.489
4.965 | 3.501
4.849 | 3.511
4.694 | 3.515
4.616 | 3.511
4.461 | 3.497
4.308 | 3.471
4.232 | 3.454
4.045 | 3.400
3.972 | 3.374
3.901 | 3.341
3.834 | 3.302
FREE-FORM CURVE 3 (grey dots, follow DXF) | points X, Y
1.972 | 7.061
1.970 | 7.111
1.959 | 7.161
1.931 | 7.222
1.892 | 7.277
1.846 | 7.326
1.795 | 7.370
1.741 | 7.411
1.491 | 7.585
1.440 | 7.628
1.394 | 7.678
1.367 | 7.720
1.353 | 7.752

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

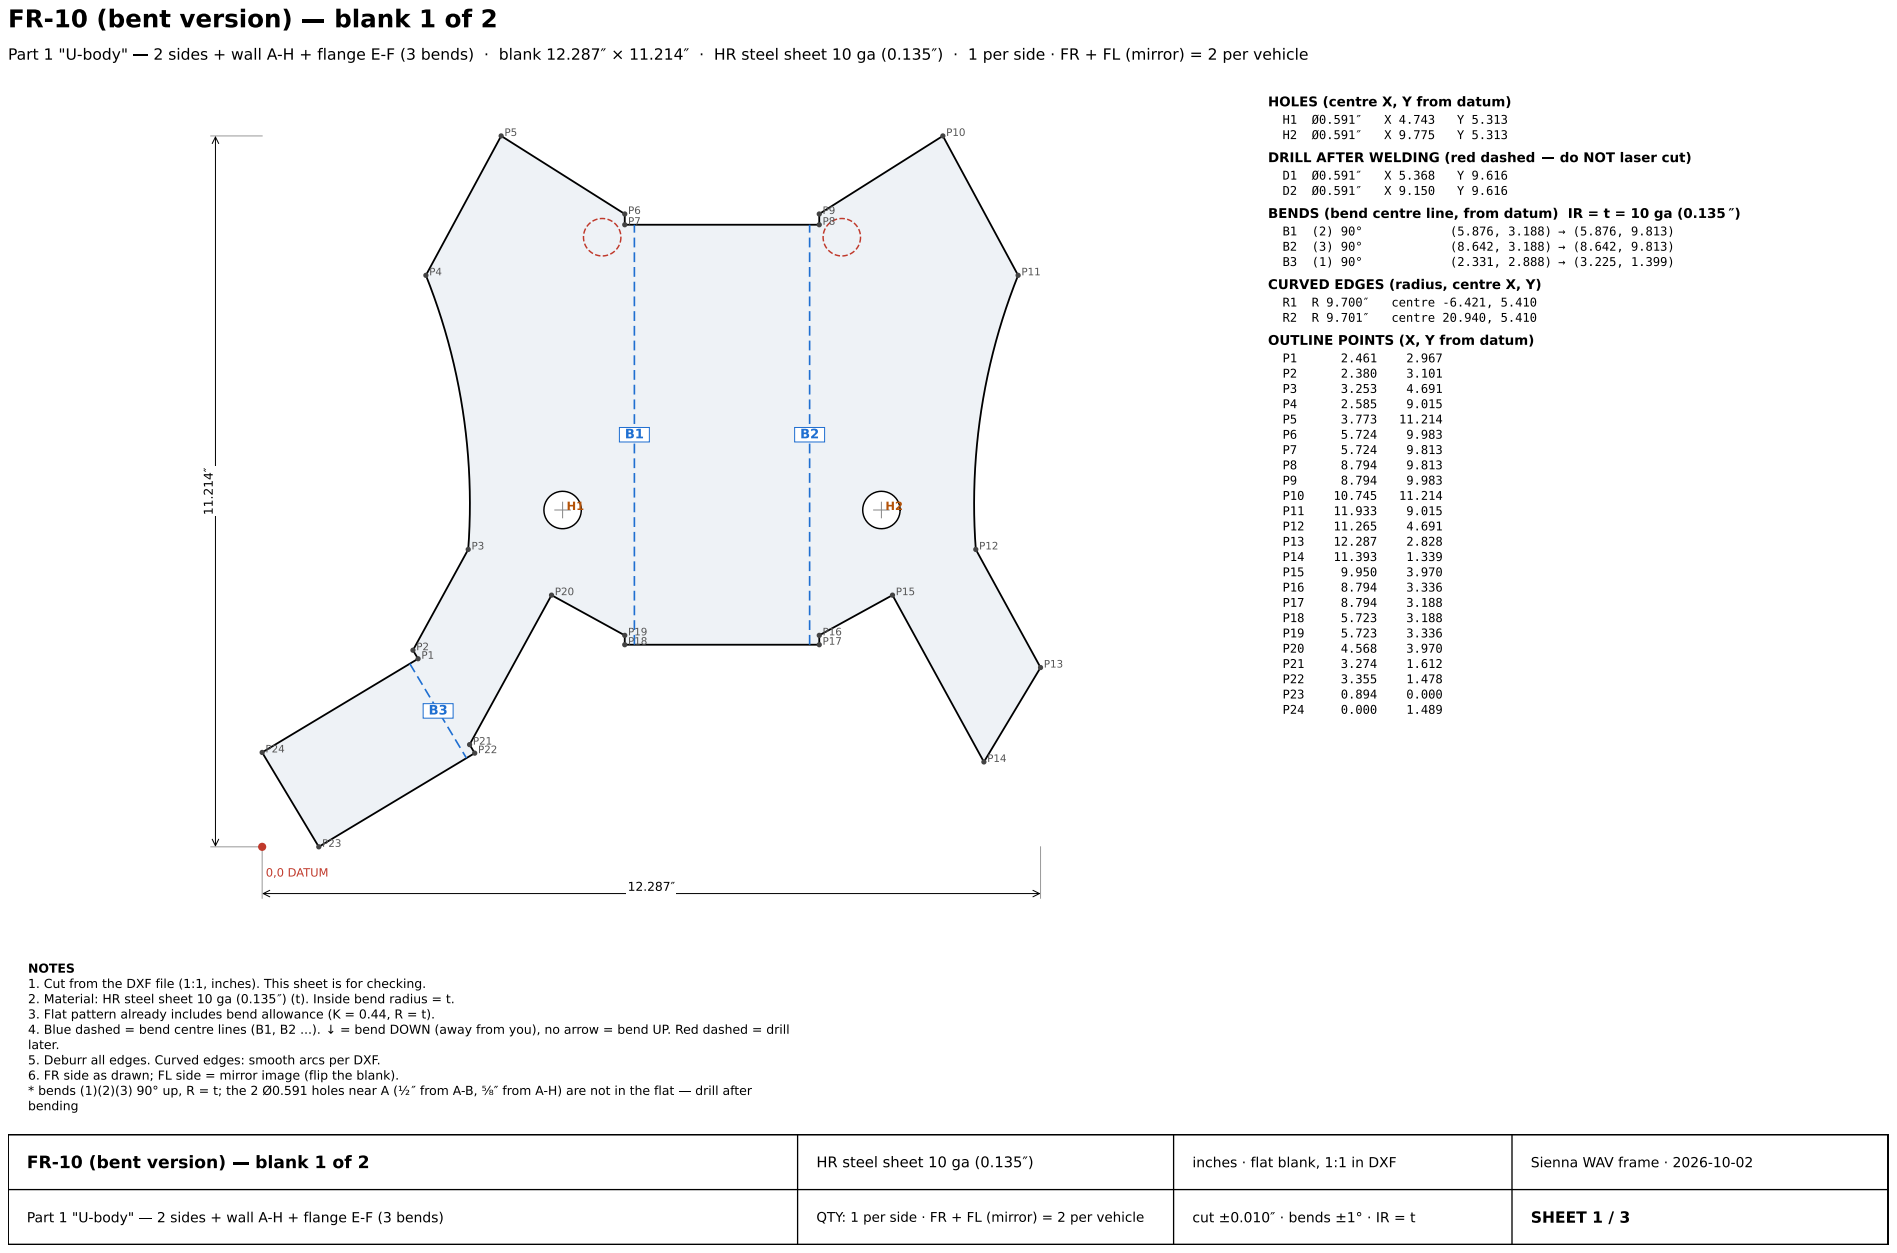
[picture p150: page 12]

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

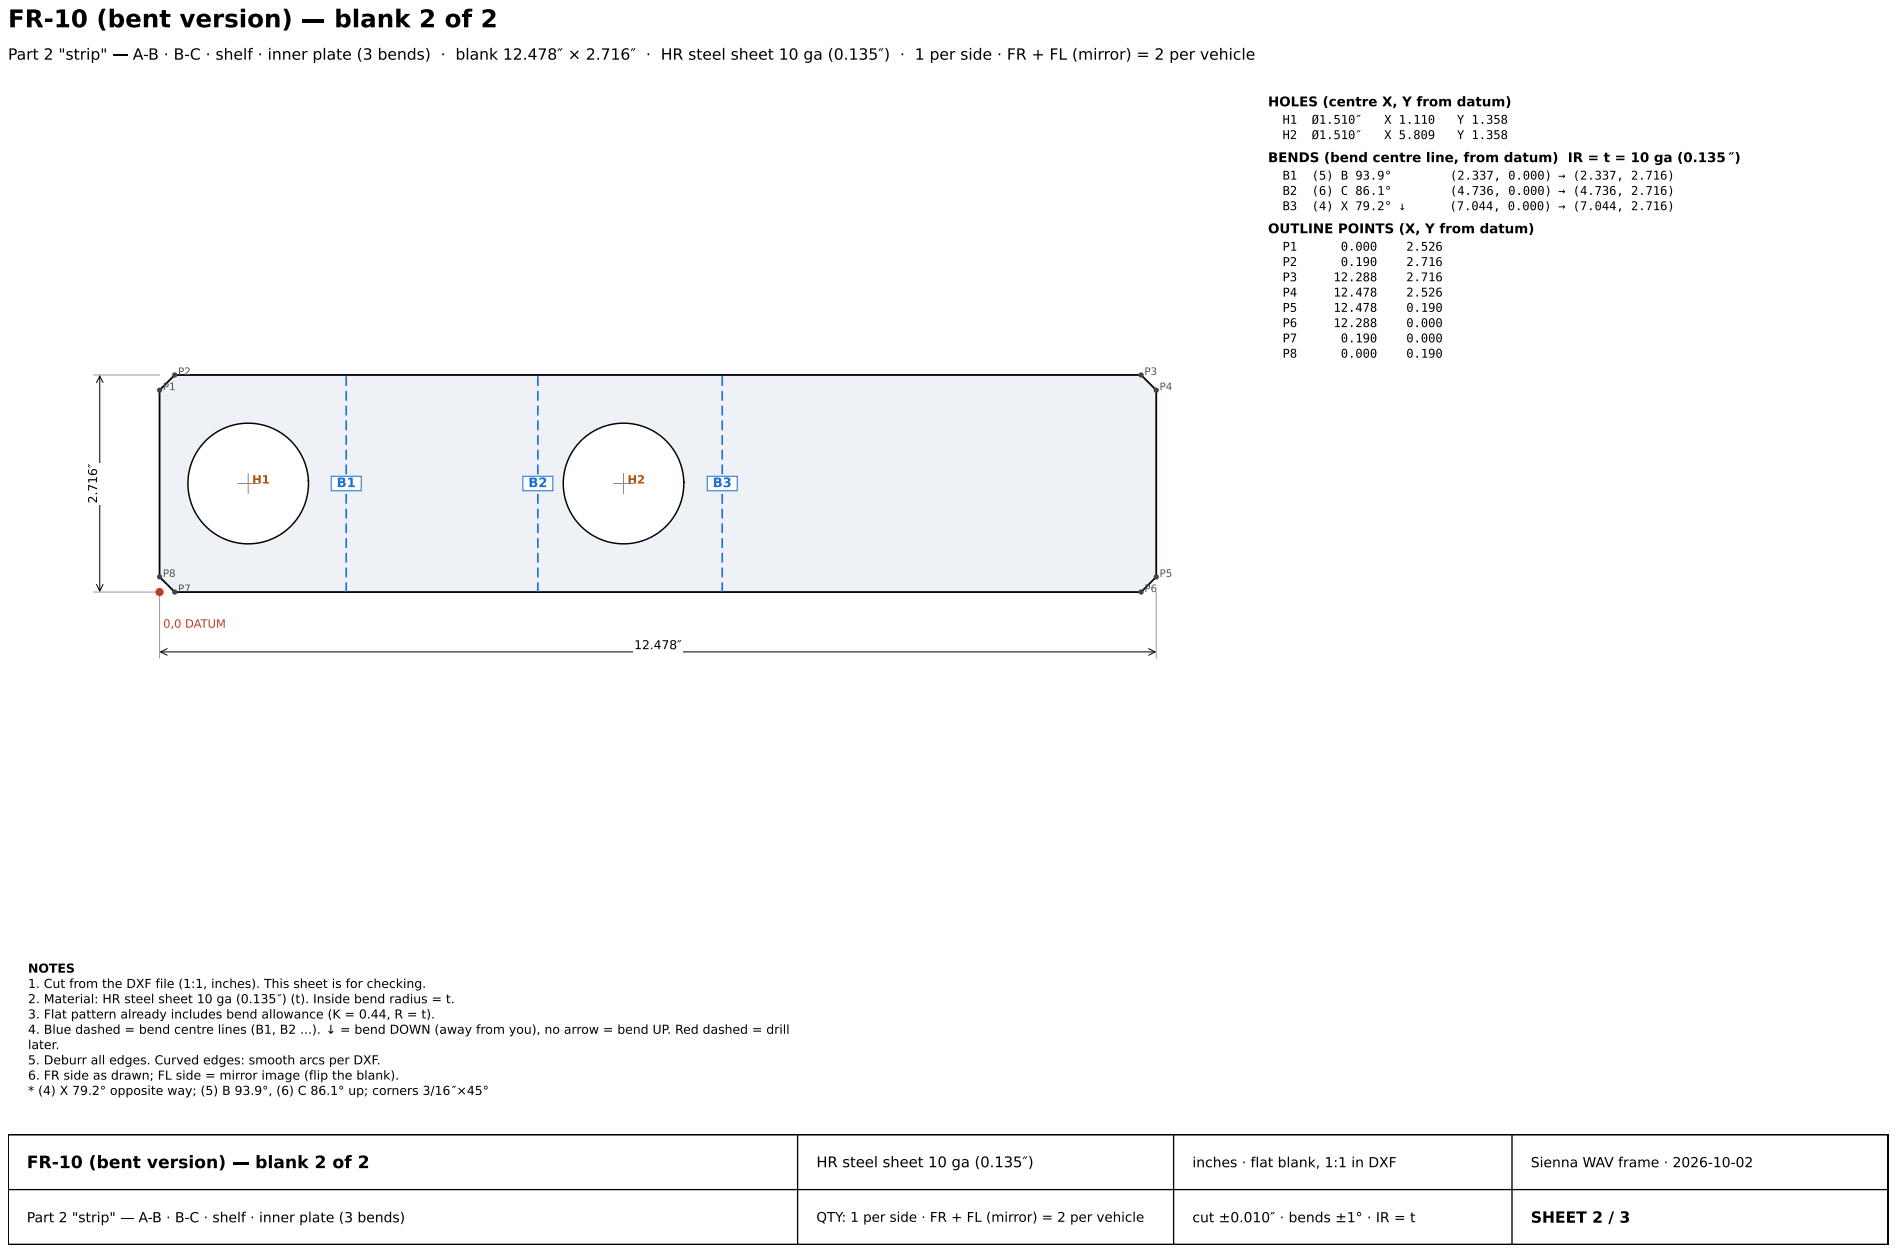
[picture p151: page 13]

FR-10 tubes | | inches · flat blank, 1:1 in DXF | Sienna WAV frame · 2026-10-02
Tube OD 1.5 / ID 1.181 cut 3.42 (through A-B and the shelf) | QTY: 1 per side · FR + FL (mirror) = 2 per vehicle | | SHEET 3 / 3
FR-10 (bent version) | cut list (tubes)
Tube OD 1.5 / ID 1.181 | cut 3.42 (through A-B and the shelf)
Stock: DOM round tube · cut length 3.420 | · QTY 1 per side · FR + FL (mirror) = 2 per vehicle

Cut square, ±1/32 . Deburr. Lengths in inches.

H1

# FR-10 (welded version) blank 1 of 7

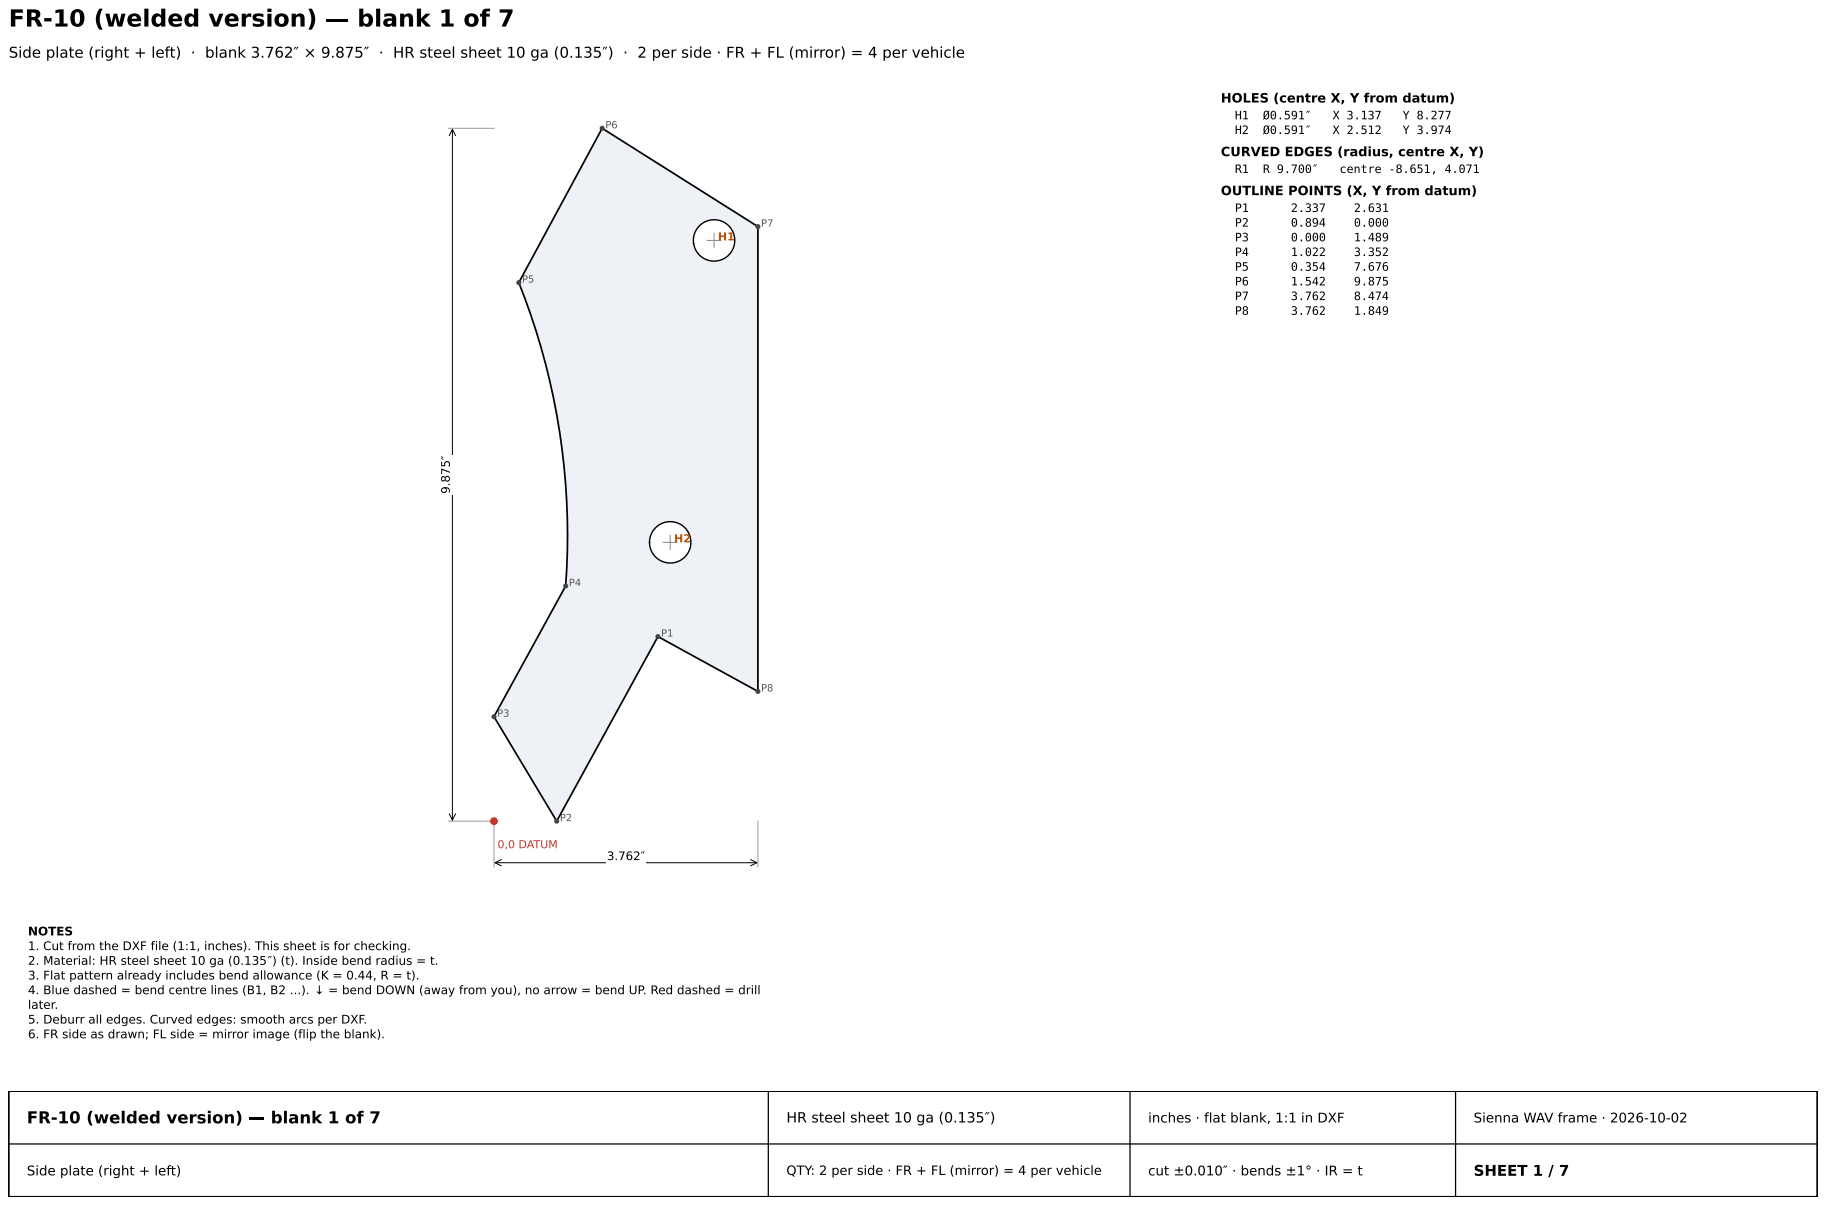
[picture p152: page 15]

Side plate (right + left) · blank 3.762 × 9.875 · HR steel sheet 10 ga (0.135 ) · 2 per side · FR + FL (mirror) = 4 per vehicle

HOLES (centre X, Y from datum)
CURVED EDGES (radius, centre X, Y)
OUTLINE POINTS (X, Y from datum)

NOTES
1. Cut from the DXF file (1:1, inches). This sheet is for checking.
2. Material: HR steel sheet 10 ga (0.135 ) (t). Inside bend radius = t.
3. Flat pattern already includes bend allowance (K = 0.44, R = t).
later.
5. Deburr all edges. Curved edges: smooth arcs per DXF.
6. FR side as drawn; FL side = mirror image (flip the blank).

FR-10 (welded version) blank 1 of 7

HR steel sheet 10 ga (0.135 )

inches · flat blank, 1:1 in DXF

Side plate (right + left)

QTY: 2 per side · FR + FL (mirror) = 4 per vehicle

# FR-10 (welded version) blank 2 of 7

Plate A-H · blank 6.625 × 2.731 · HR steel sheet 10 ga (0.135 ) · 1 per side · FR + FL (mirror) = 2 per vehicle

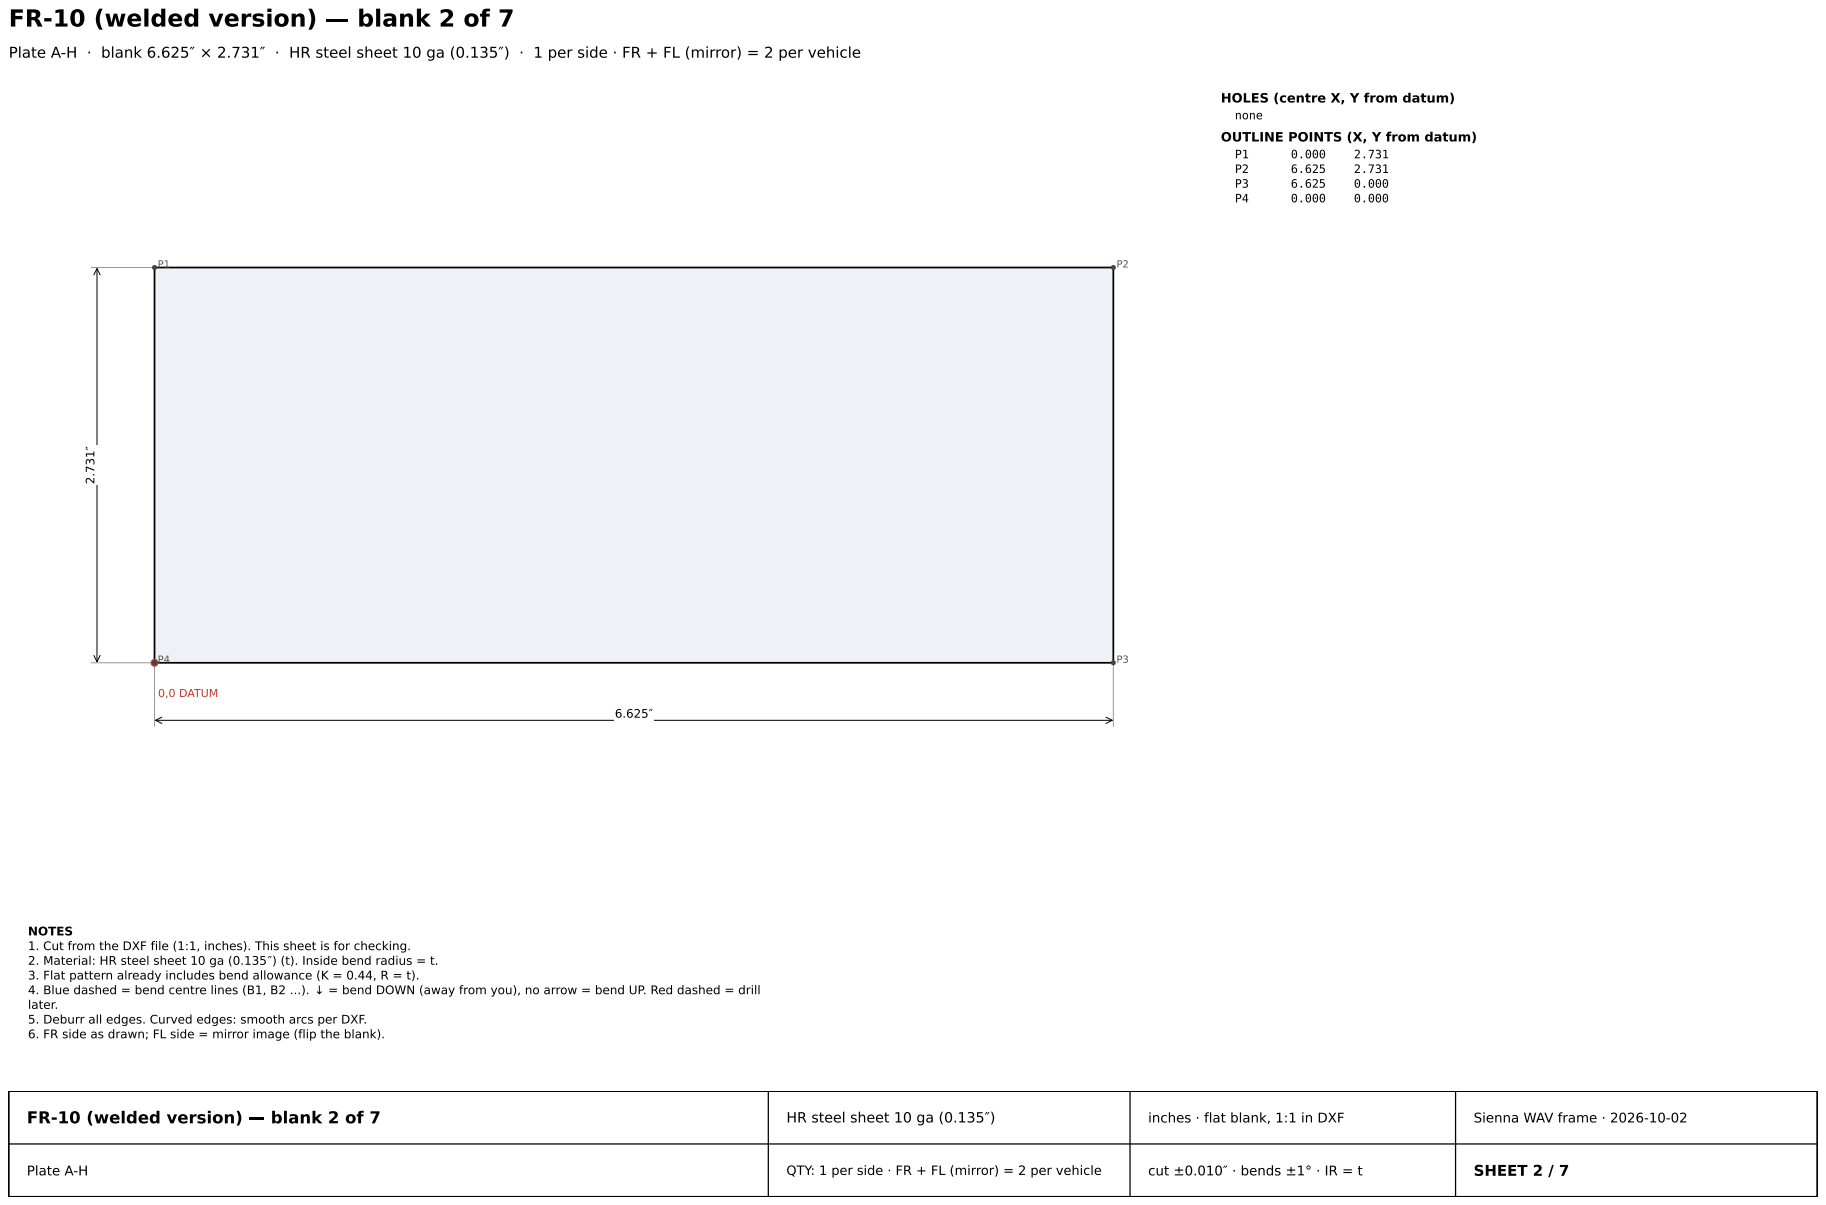
[picture p153: page 16]
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

HOLES (centre X, Y from datum)
none
OUTLINE POINTS (X, Y from datum)

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

FR-10 (welded version) blank 2 of 7 | HR steel sheet 10 ga (0.135 ) | inches · flat blank, 1:1 in DXF | Sienna WAV frame · 2026-10-02

Plate A-H | | | SHEET 2 / 7

# FR-10 (welded version) blank 3 of 7

Plate A-B (hole Ø1.5 for the tube) · blank 2.625 × 2.731 · HR steel sheet 10 ga (0.135 ) · 1 per side · FR + FL (mirror) = 2 per vehicle

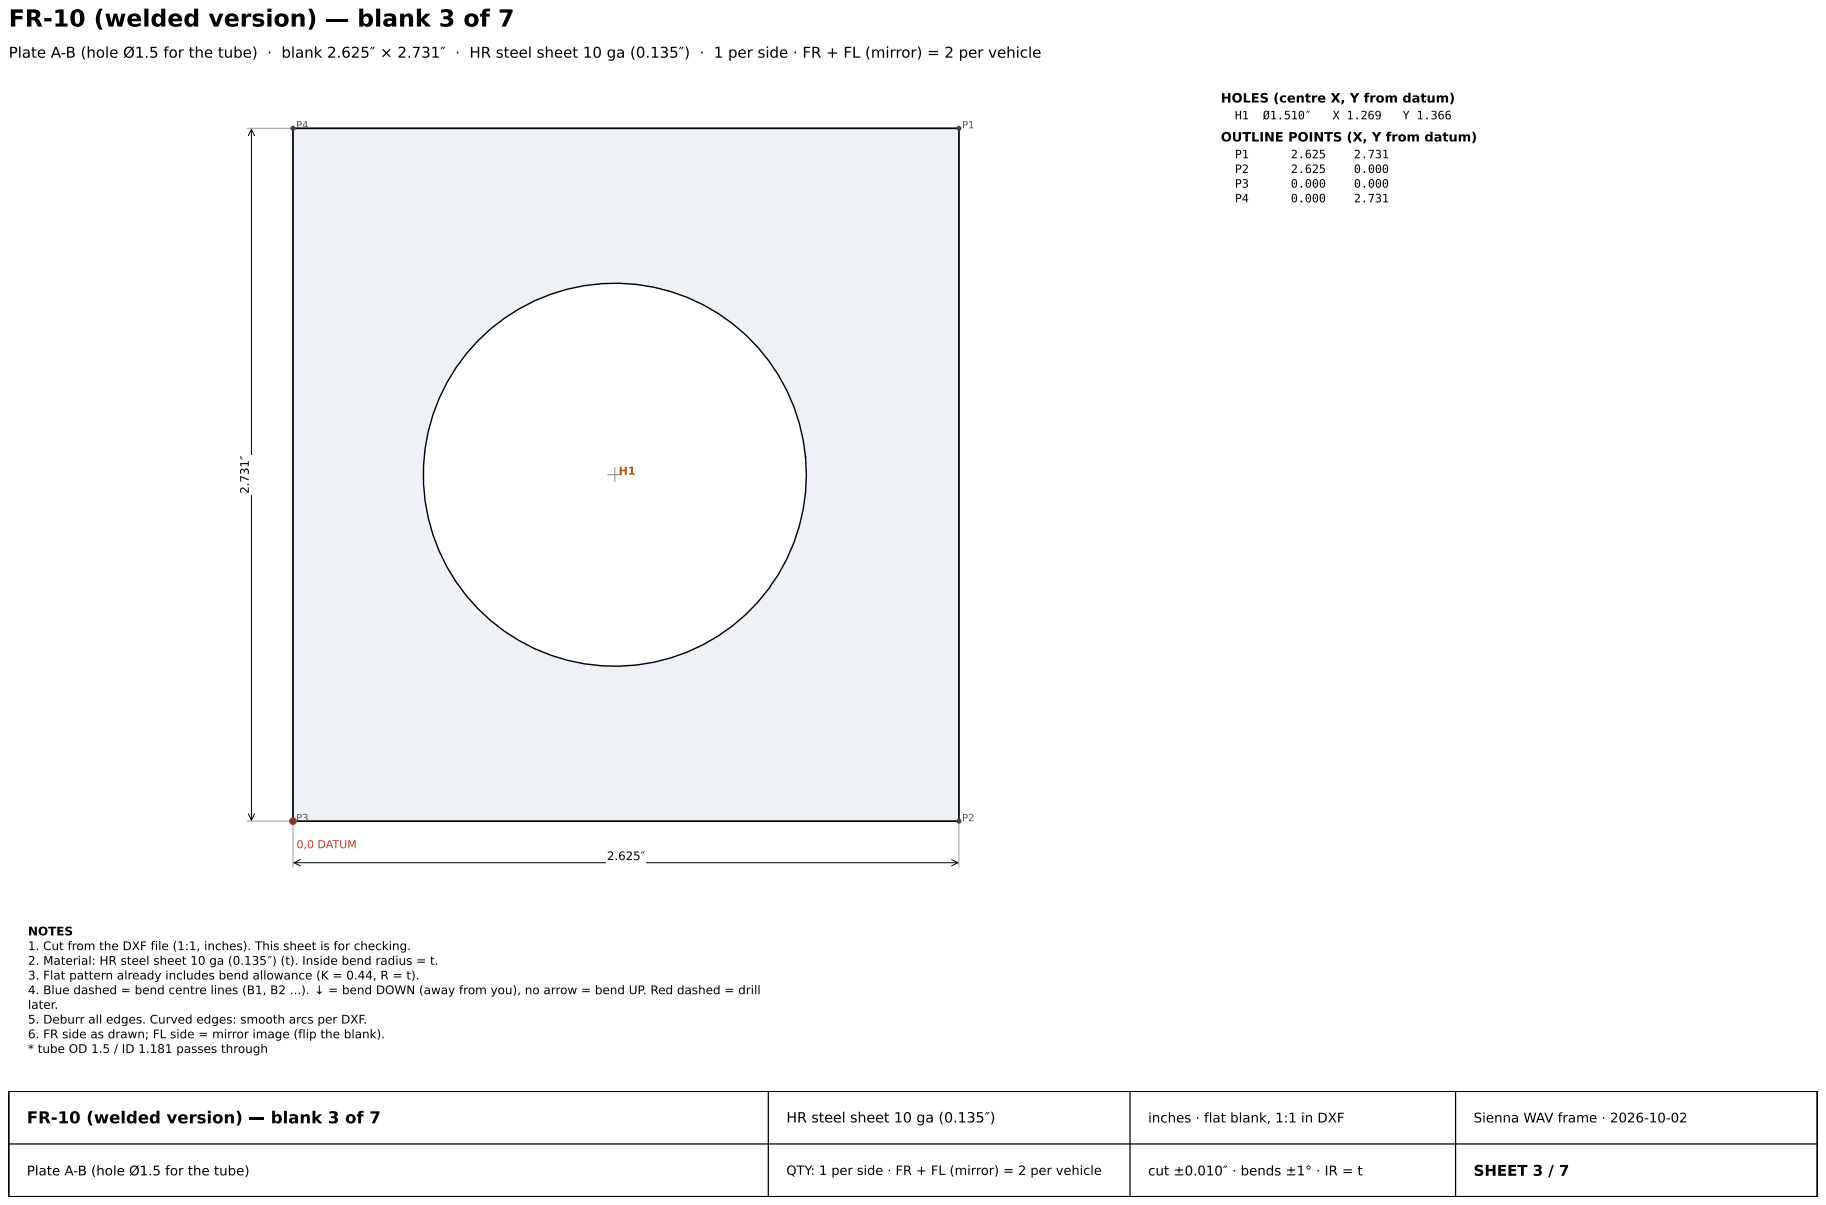
[picture p154: page 17]
0,0 DATUM; SHEET 3 / 7; 4. Blue dashed = bend centre lines (B1, B2 ...).; = bend DOWN (away from you), no arrow = bend UP. Red dashed = drill

HOLES (centre X, Y from datum)
OUTLINE POINTS (X, Y from datum)

NOTES
1. Cut from the DXF file (1:1, inches). This sheet is for checking.
2. Material: HR steel sheet 10 ga (0.135 ) (t). Inside bend radius = t.
3. Flat pattern already includes bend allowance (K = 0.44, R = t).
later.
5. Deburr all edges. Curved edges: smooth arcs per DXF.
6. FR side as drawn; FL side = mirror image (flip the blank).
* tube OD 1.5 / ID 1.181 passes through

FR-10 (welded version) blank 3 of 7

HR steel sheet 10 ga (0.135 )

inches · flat blank, 1:1 in DXF

Sienna WAV frame · 2026-10-02

Plate A-B (hole Ø1.5 for the tube)

# FR-10 (welded version) blank 4 of 7

Plate B-C · blank 2.499 × 2.731 · HR steel sheet 10 ga (0.135 ) · 1 per side · FR + FL (mirror) = 2 per vehicle

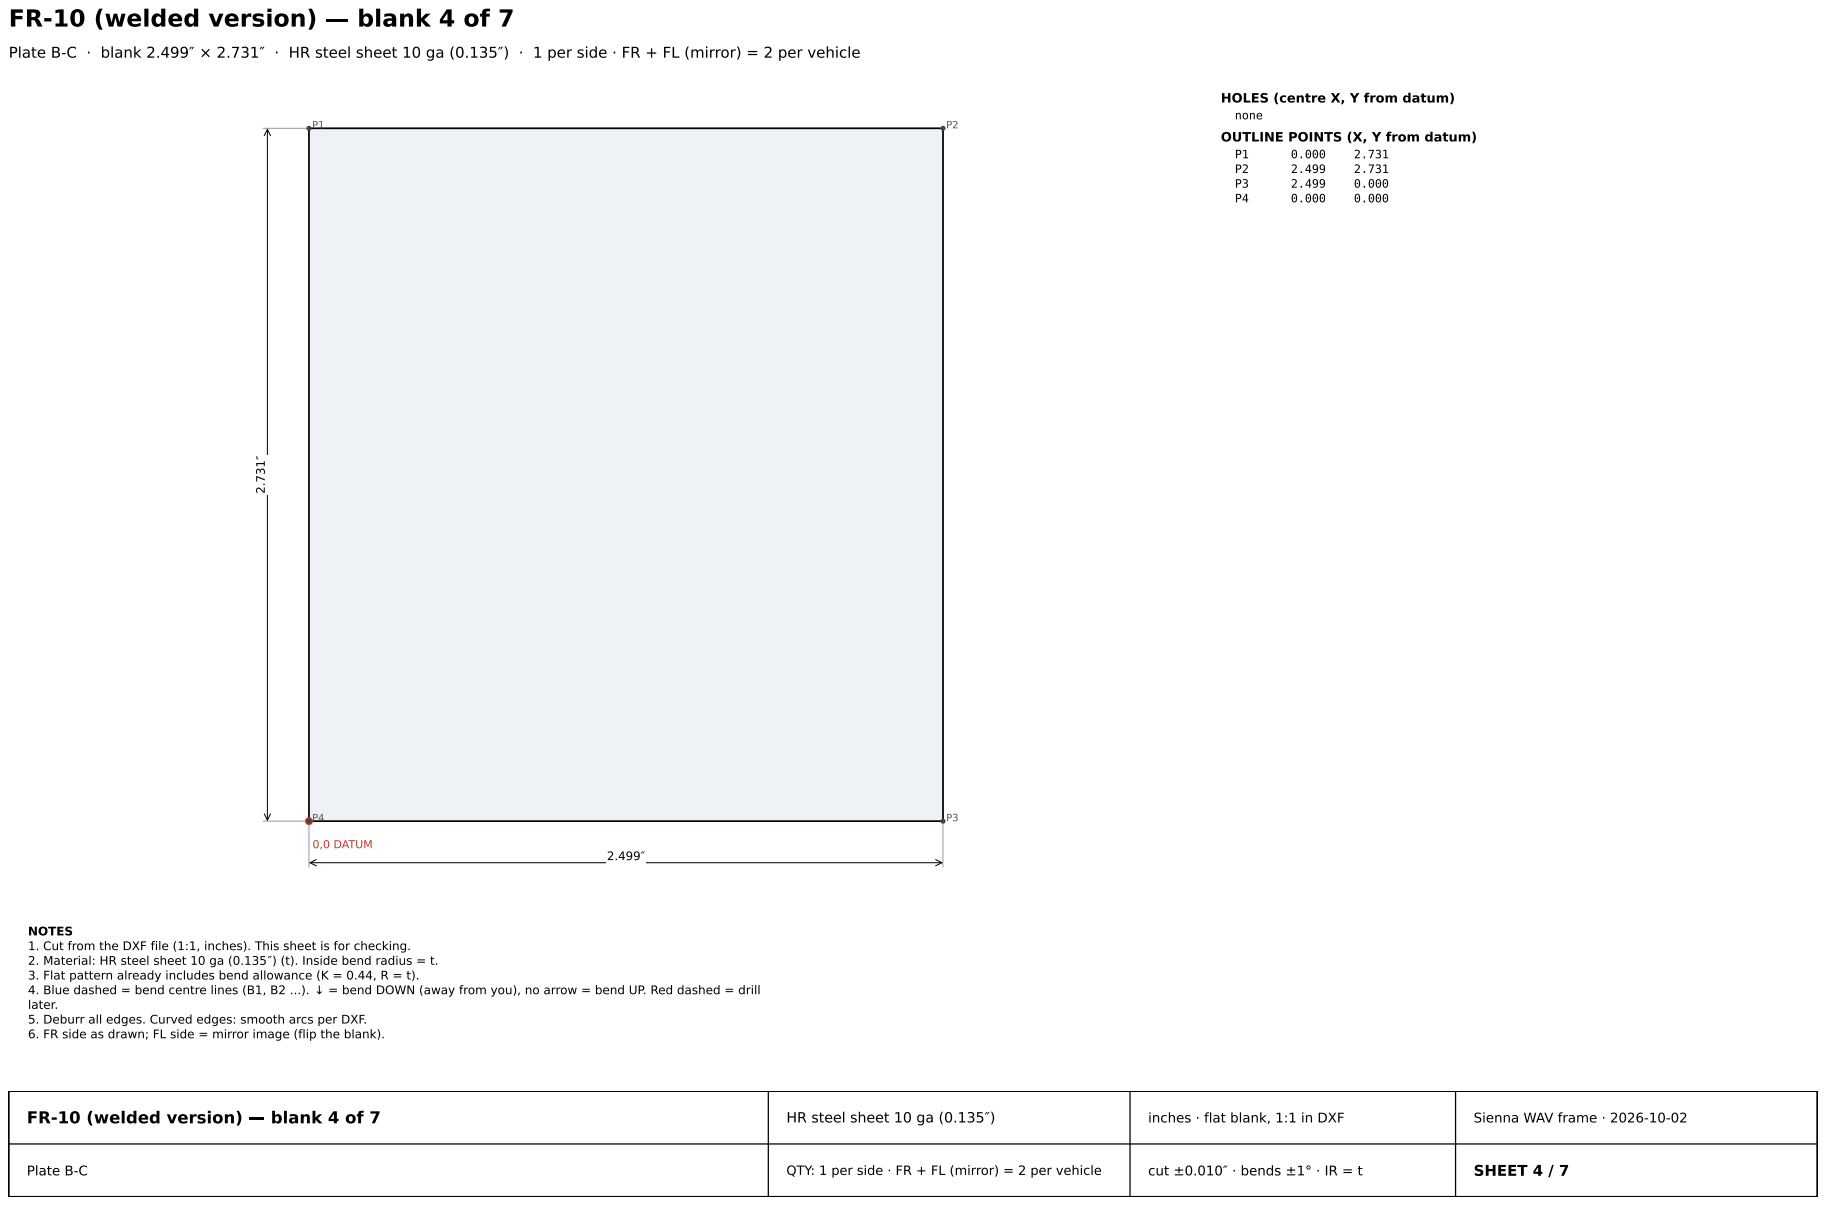
[picture p155: page 18]
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

HOLES (centre X, Y from datum)
none
OUTLINE POINTS (X, Y from datum)

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

FR-10 (welded version) blank 4 of 7 | HR steel sheet 10 ga (0.135 ) | inches · flat blank, 1:1 in DXF | Sienna WAV frame · 2026-10-02

Plate B-C | | | SHEET 4 / 7

# FR-10 (welded version) blank 5 of 7

Plate E-F · blank 1.737 × 2.731 · HR steel sheet 10 ga (0.135 ) · 1 per side · FR + FL (mirror) = 2 per vehicle

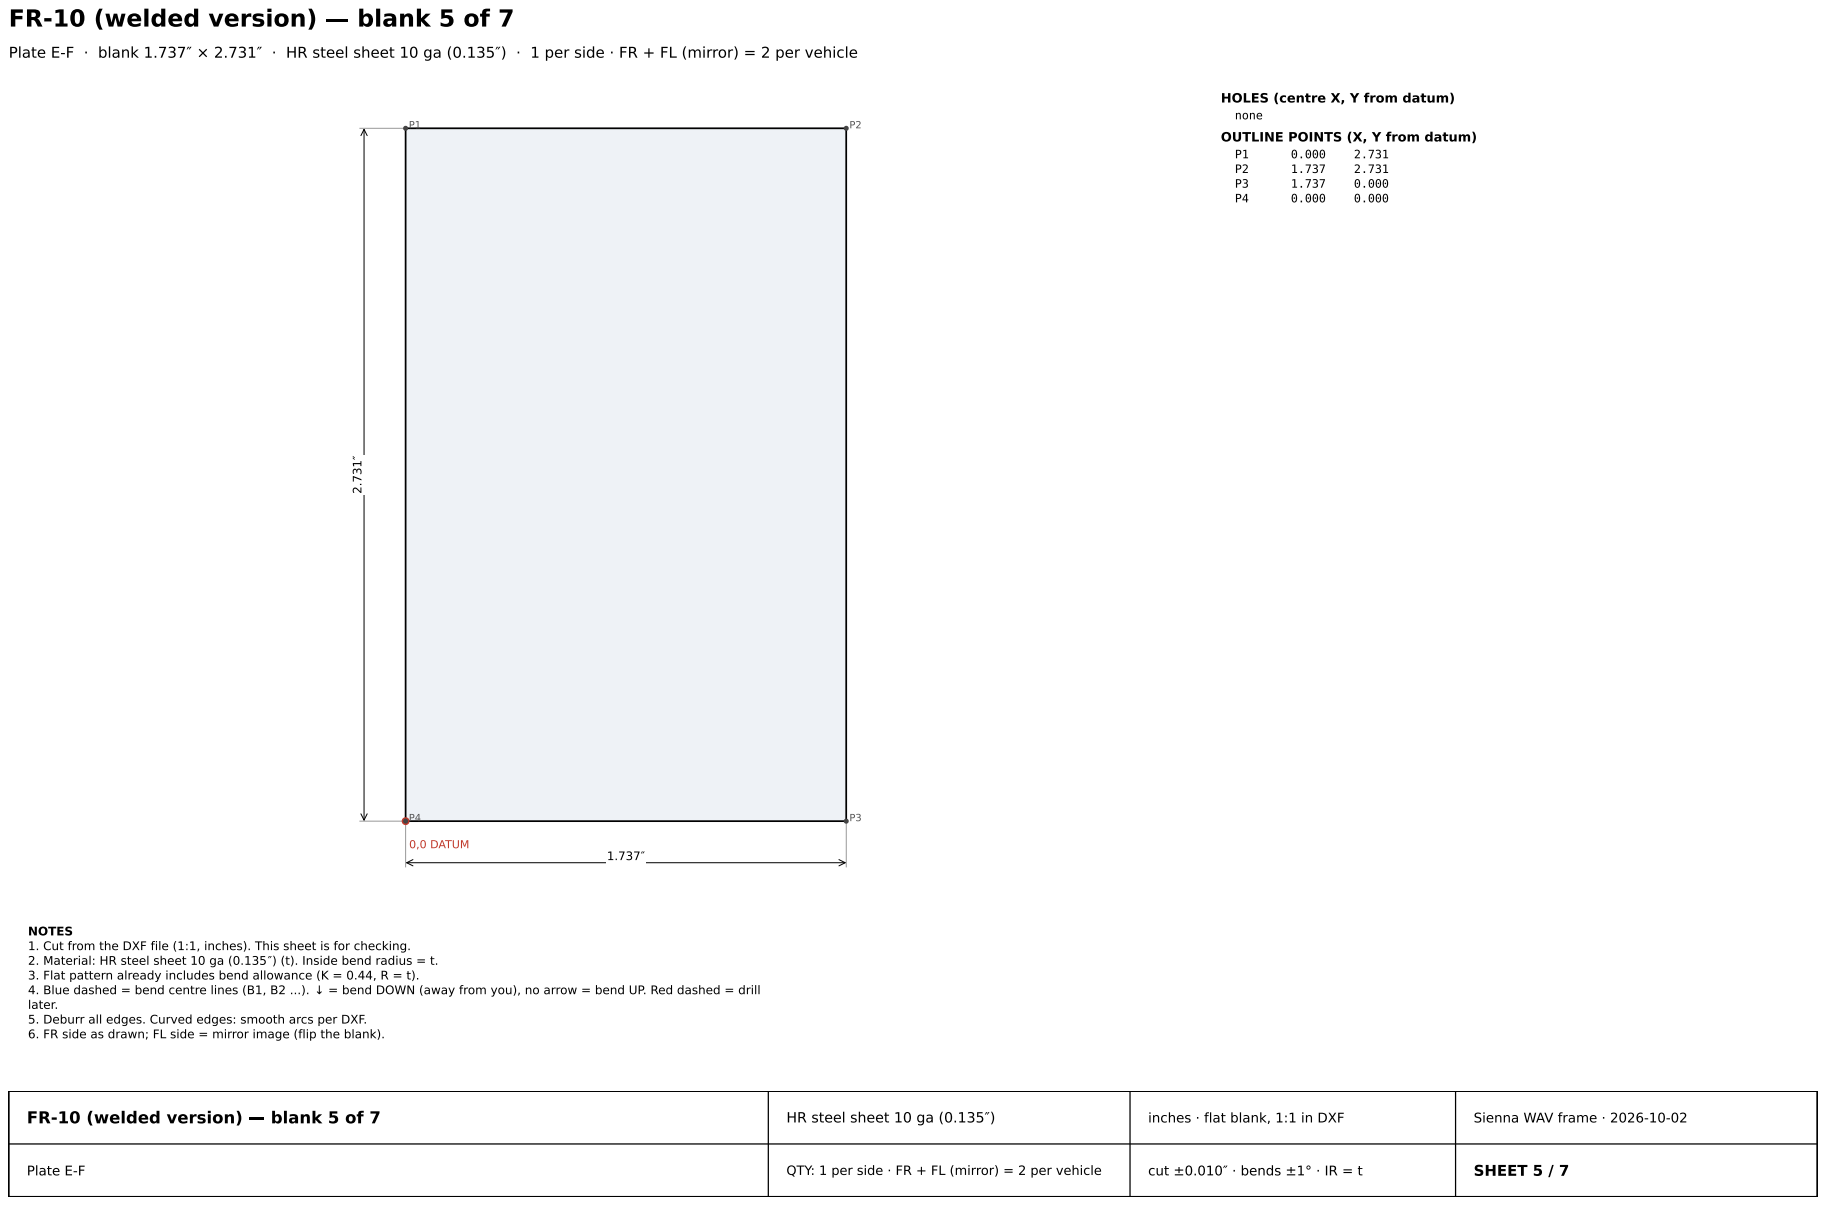
[picture p156: page 19]
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

HOLES (centre X, Y from datum)
none
OUTLINE POINTS (X, Y from datum)

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

FR-10 (welded version) blank 5 of 7 | HR steel sheet 10 ga (0.135 ) | inches · flat blank, 1:1 in DXF | Sienna WAV frame · 2026-10-02

Plate E-F | | | SHEET 5 / 7

# FR-10 (welded version) blank 6 of 7

Shelf (hole Ø1.5 for the tube) · blank 2.375 × 2.731 · HR steel sheet 10 ga (0.135 ) · 1 per side · FR + FL (mirror) = 2 per vehicle

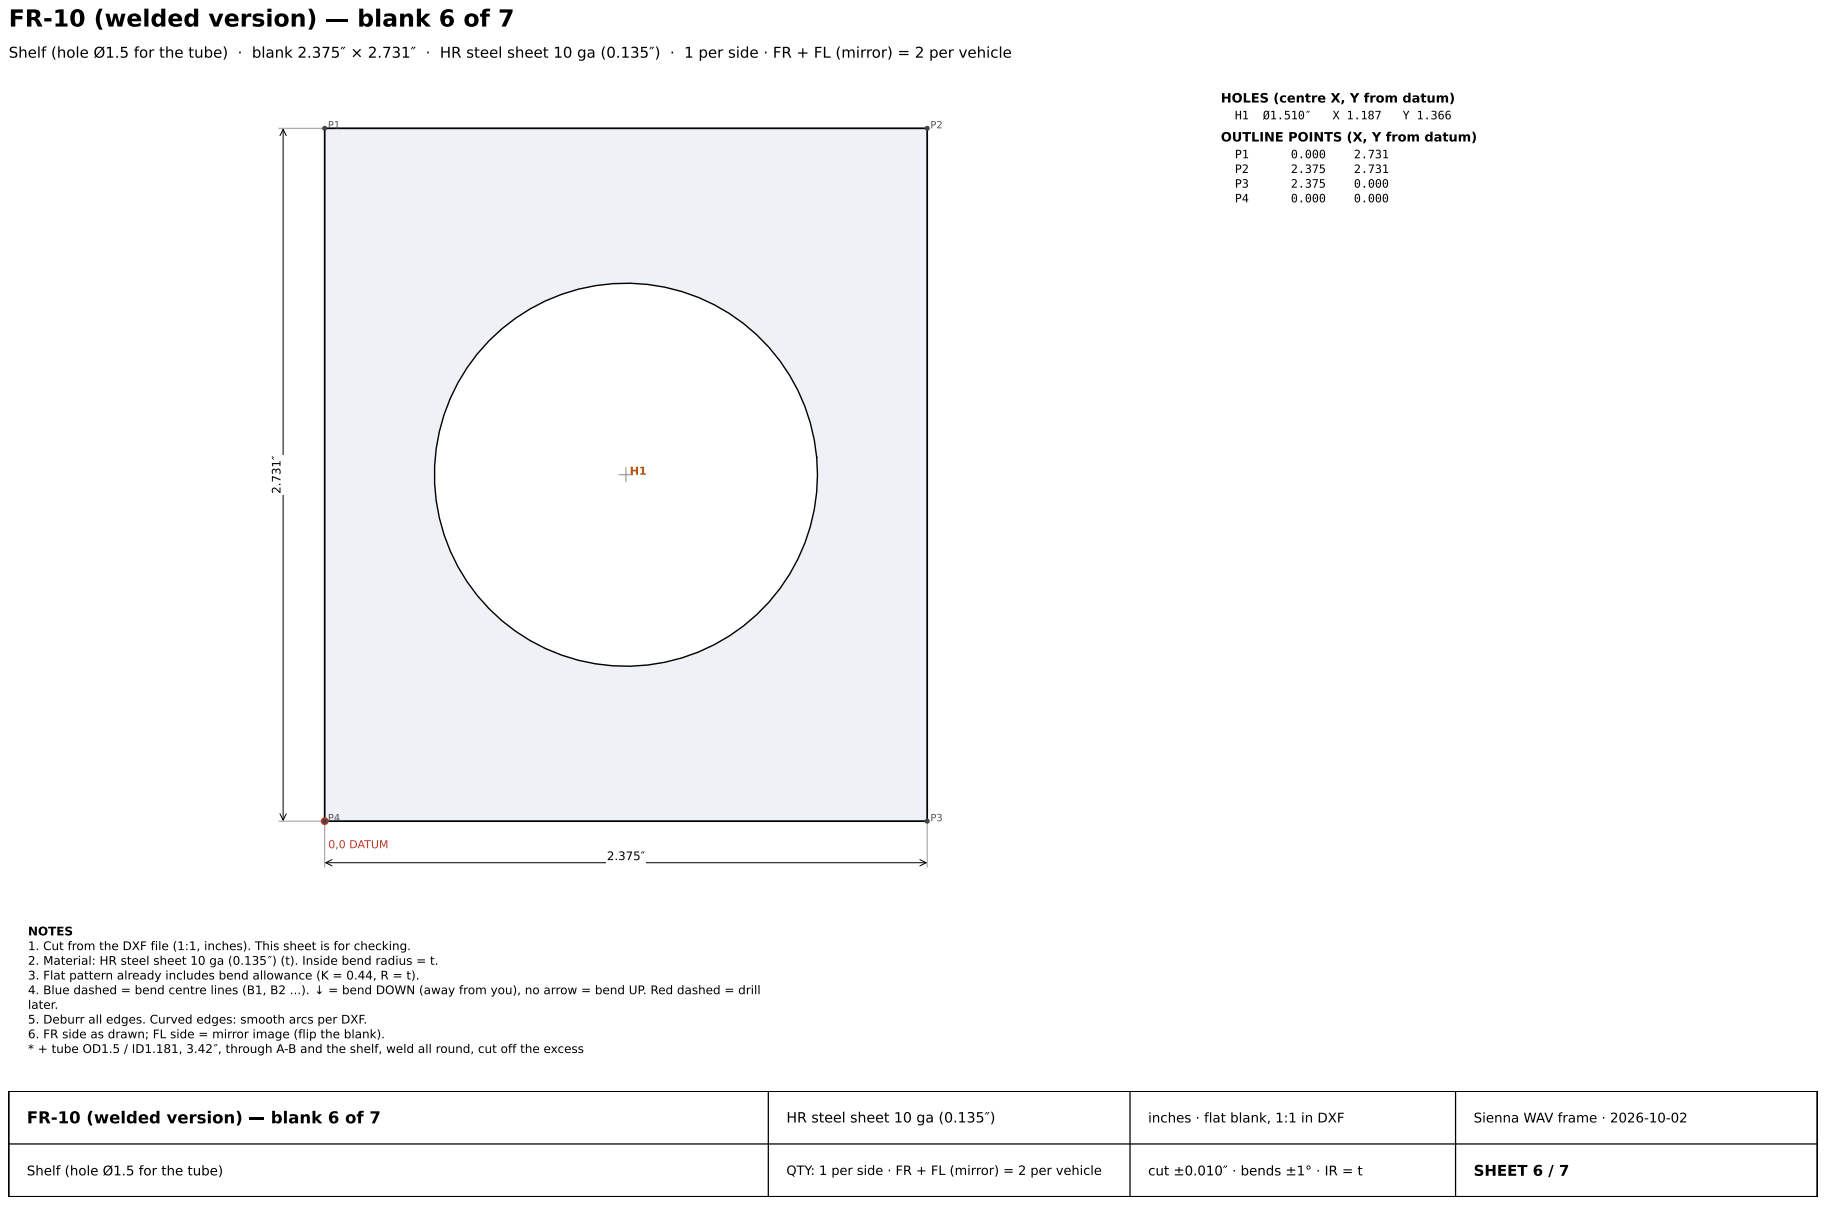
[picture p157: page 20]
0,0 DATUM; SHEET 6 / 7; 4. Blue dashed = bend centre lines (B1, B2 ...).; = bend DOWN (away from you), no arrow = bend UP. Red dashed = drill

HOLES (centre X, Y from datum)
OUTLINE POINTS (X, Y from datum)

NOTES
1. Cut from the DXF file (1:1, inches). This sheet is for checking.
2. Material: HR steel sheet 10 ga (0.135 ) (t). Inside bend radius = t.
3. Flat pattern already includes bend allowance (K = 0.44, R = t).
later.
5. Deburr all edges. Curved edges: smooth arcs per DXF.
6. FR side as drawn; FL side = mirror image (flip the blank).
* + tube OD1.5 / ID1.181, 3.42 , through A-B and the shelf, weld all round, cut off the excess

FR-10 (welded version) blank 6 of 7

HR steel sheet 10 ga (0.135 )

inches · flat blank, 1:1 in DXF

Sienna WAV frame · 2026-10-02

Shelf (hole Ø1.5 for the tube)

# FR-10 (welded version) blank 7 of 7

Inner plate · blank 5.748 × 2.731 · HR steel sheet 10 ga (0.135 ) · 1 per side · FR + FL (mirror) = 2 per vehicle

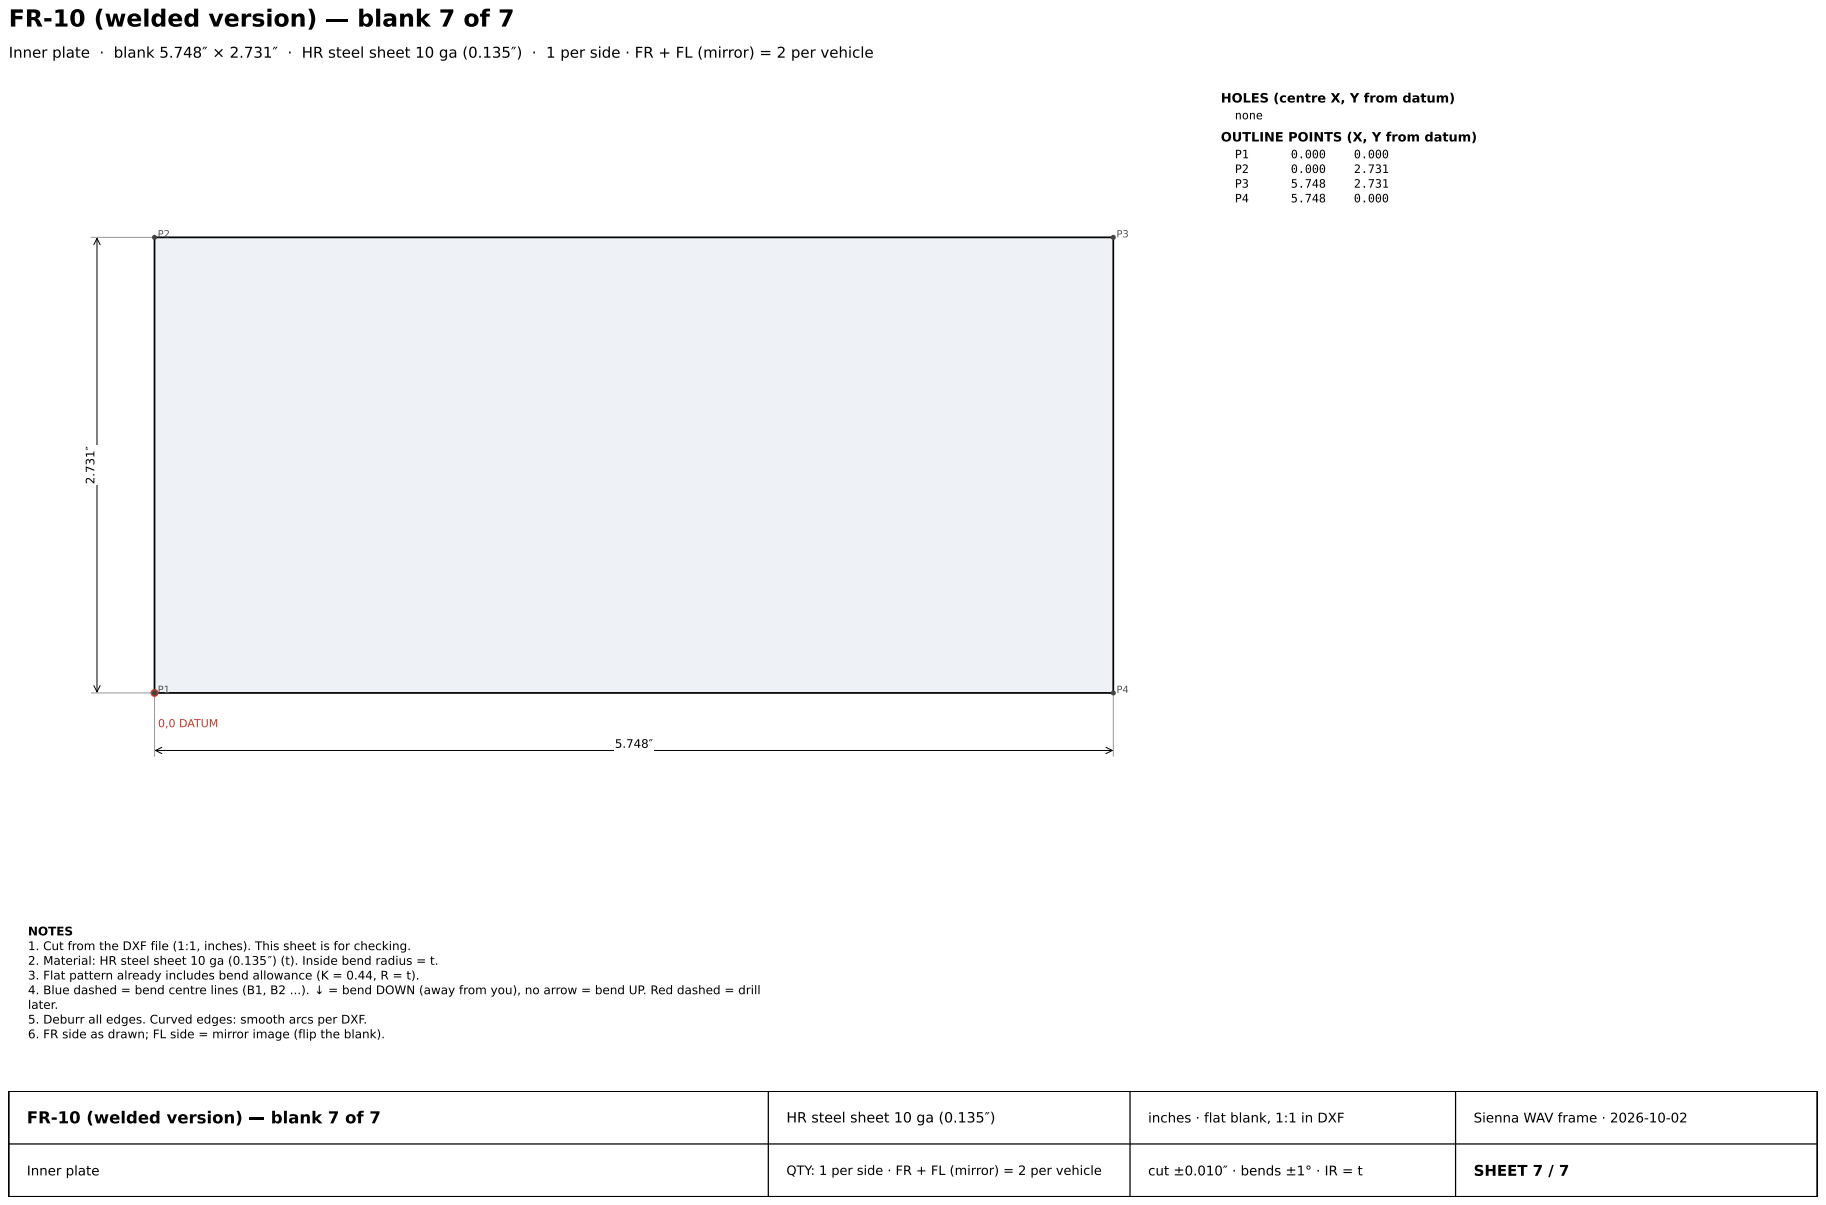
[picture p158: page 21]
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

HOLES (centre X, Y from datum)
none
OUTLINE POINTS (X, Y from datum)

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

FR-10 (welded version) blank 7 of 7 | HR steel sheet 10 ga (0.135 ) | inches · flat blank, 1:1 in DXF | Sienna WAV frame · 2026-10-02

Inner plate | | | SHEET 7 / 7

0,0 DATUM

## FR-2 (bent version) blank 1 of 1

FR-2 one piece (top + 2 U legs)

### HR steel sheet 10 ga (0.135 )

inches · flat blank, 1:1 in DXF

Sienna WAV frame · 2026-10-02

### SHEET 1 / 1

# FR-2 (bent version) blank 1 of 1

FR-2 one piece (top + 2 U legs) · blank 22.078 × 3.250 · HR steel sheet 10 ga (0.135 ) · 1 per side · FR + FL (mirror) = 2 per vehicle

HOLES (centre X, Y from datum)

## H1 slot 0.709 × 0.472 @0° X 8.539 Y 1.500 H2 slot 0.750 × 0.625 @0° X 13.539 Y 1.375

DRILL AFTER WELDING (red dashed | do NOT laser cut)
D1 slot 0.709 × 0.472 | X 4.007 Y 1.500
D2 slot 0.750 × 0.625 | X 18.072 Y 1.375

BENDS (bend centre line, from datum) IR = t = 10 ga (0.135 )
B1 (1) 90° | (2.999, 0.000) | (2.999, 3.250)
B2 (3) 90° | (4.765, 0.000) | (4.765, 3.250)
B3 (5) 90° | (7.781, 0.250) | (7.781, 3.250)
B4 (2) 90° | (19.080, 0.000) | (19.080, 3.250)
B5 (4) 90° | (17.314, 0.000) | (17.314, 3.250)
B6 (6) 90° | (14.297, 0.250) | (14.297, 3.250)

OUTLINE POINTS (X, Y from datum)
P1 | 19.080 | 0.000
P2 | 18.697 | 0.000
P3 | 18.697 | 0.500
P4 | 17.697 | 0.500
P5 | 17.697 | 0.000
P6 | 17.314 | 0.000
P7 | 14.297 | 0.250
P8 | 7.781 | 0.250
P9 | 4.765 | 0.000
P10 | 4.382 | 0.000
P11 | 4.382 | 0.500
P12 | 3.382 | 0.500
P13 | 3.382 | 0.000
P14 | 2.999 | 0.000
P15 | 0.000 | 0.240
P16 | 0.000 | 3.250
P17 | 22.078 | 3.250
P18 | 22.078 | 0.240

NOTES
1. Cut from the DXF file (1:1, inches). This sheet is for checking.
2. Material: HR steel sheet 10 ga (0.135 ) (t). Inside bend radius = t.
3. Flat pattern already includes bend allowance (K = 0.44, R = t).
4. Blue dashed = bend centre lines (B1, B2 ...). = bend DOWN (away from you), no arrow = bend UP. Red dashed = drill later.
5. Deburr all edges. Curved edges: smooth arcs per DXF.
6. FR side as drawn; FL side = mirror image (flip the blank).
* one blank, 6 bends 90° the same way (R = t): inner walls first, then the bottoms, then the outer walls; top ovals laser cut; do NOT cut the leg-bottom ovals drill after welding through the top ovals; ½ notch at the front edge of

# FR-2 (welded version) blank 1 of 4

Top (2 slots) · blank 6.750 × 3.000 · HR steel sheet 10 ga (0.135 ) · 1 per side · FR + FL (mirror) = 2 per vehicle

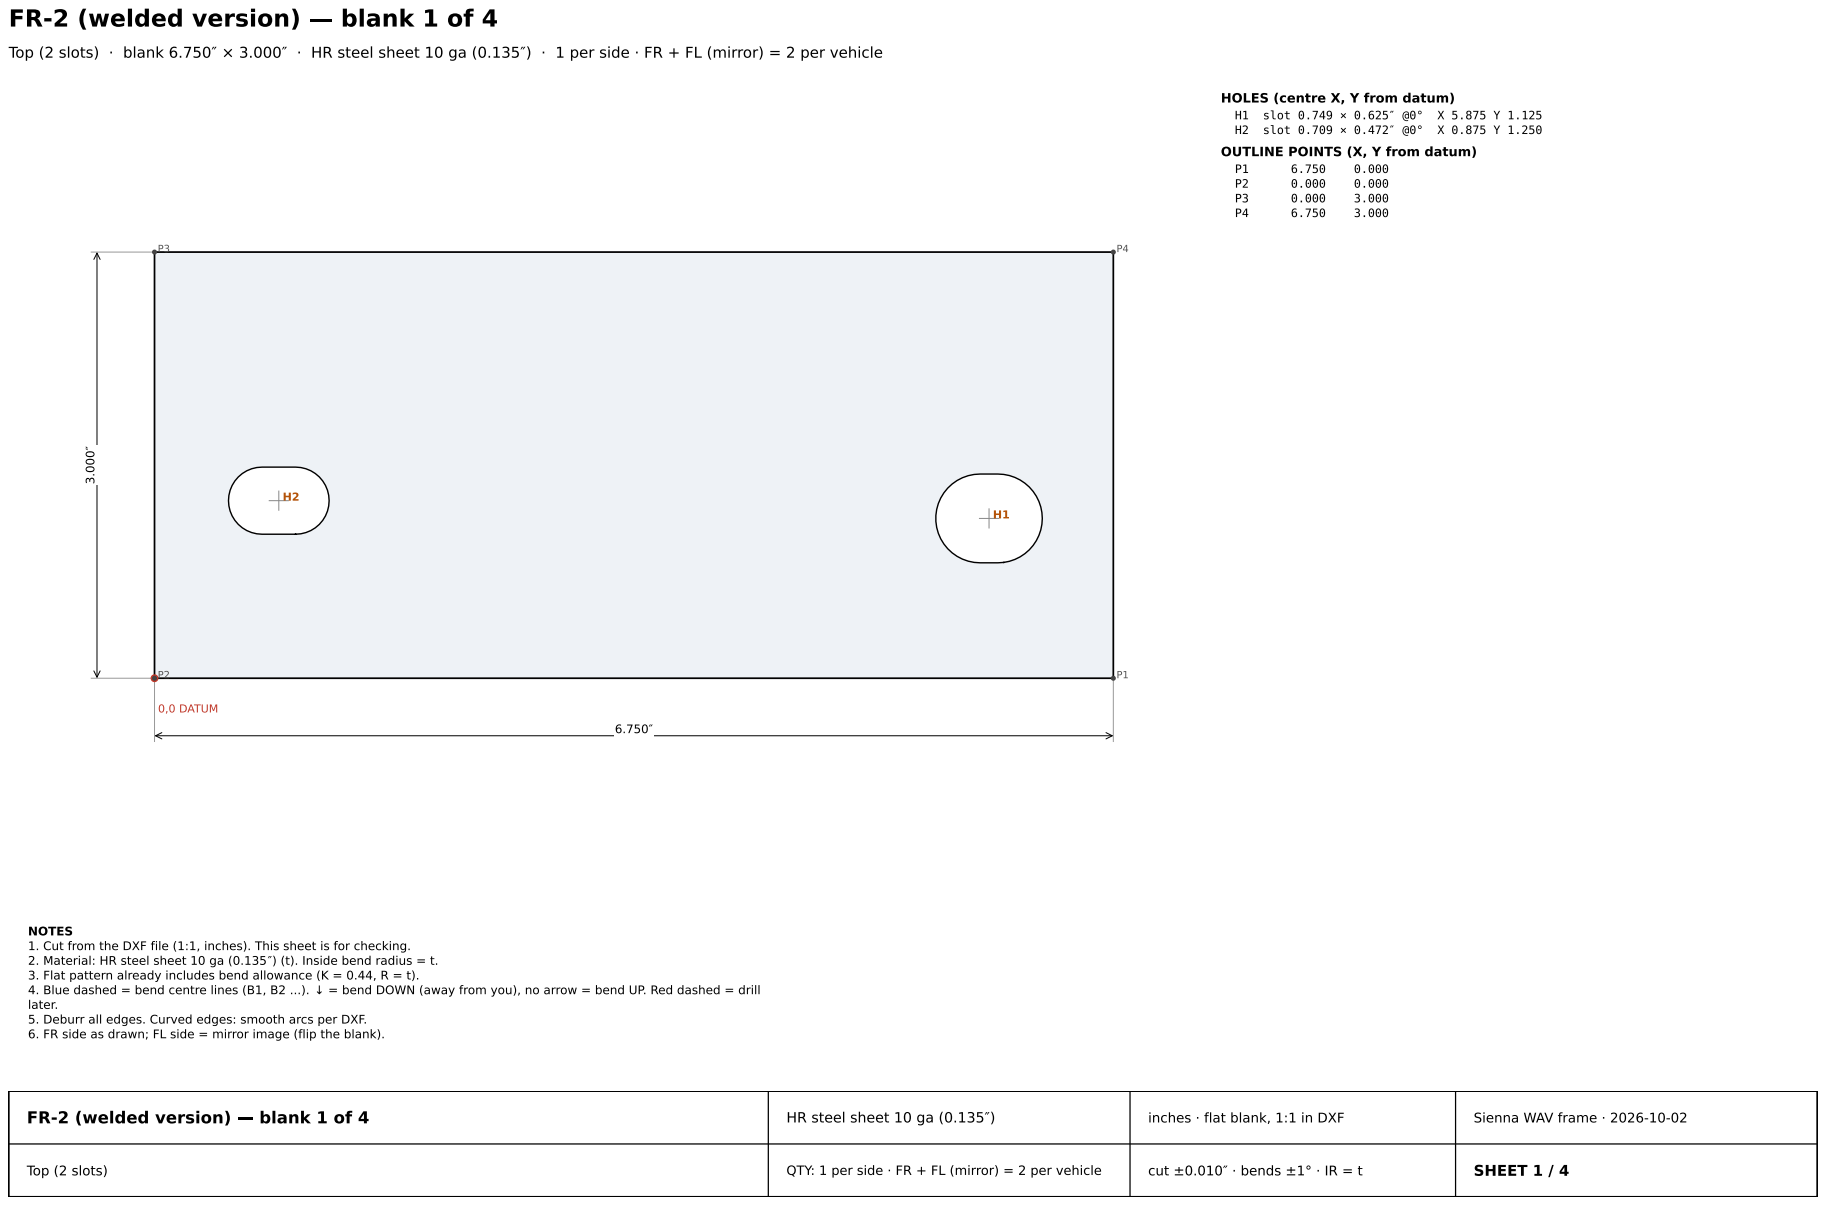
[picture p159: page 23]
0,0 DATUM; Top (2 slots); SHEET 1 / 4; 4. Blue dashed = bend centre lines (B1, B2 ...).; = bend DOWN (away from you), no arrow = bend UP. Red dashed = drill

HOLES (centre X, Y from datum)
H1 slot 0.749 × 0.625 @0° X 5.875 Y 1.125
H2 slot 0.709 × 0.472 @0° X 0.875 Y 1.250
OUTLINE POINTS (X, Y from datum)

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

FR-2 (welded version) blank 1 of 4

HR steel sheet 10 ga (0.135 )

inches · flat blank, 1:1 in DXF

Sienna WAV frame · 2026-10-02

# FR-2 (welded version) blank 2 of 4

Leg wall · blank 2.981 × 3.240 · HR steel sheet 10 ga (0.135 ) · 4 per side · FR + FL (mirror) = 8 per vehicle

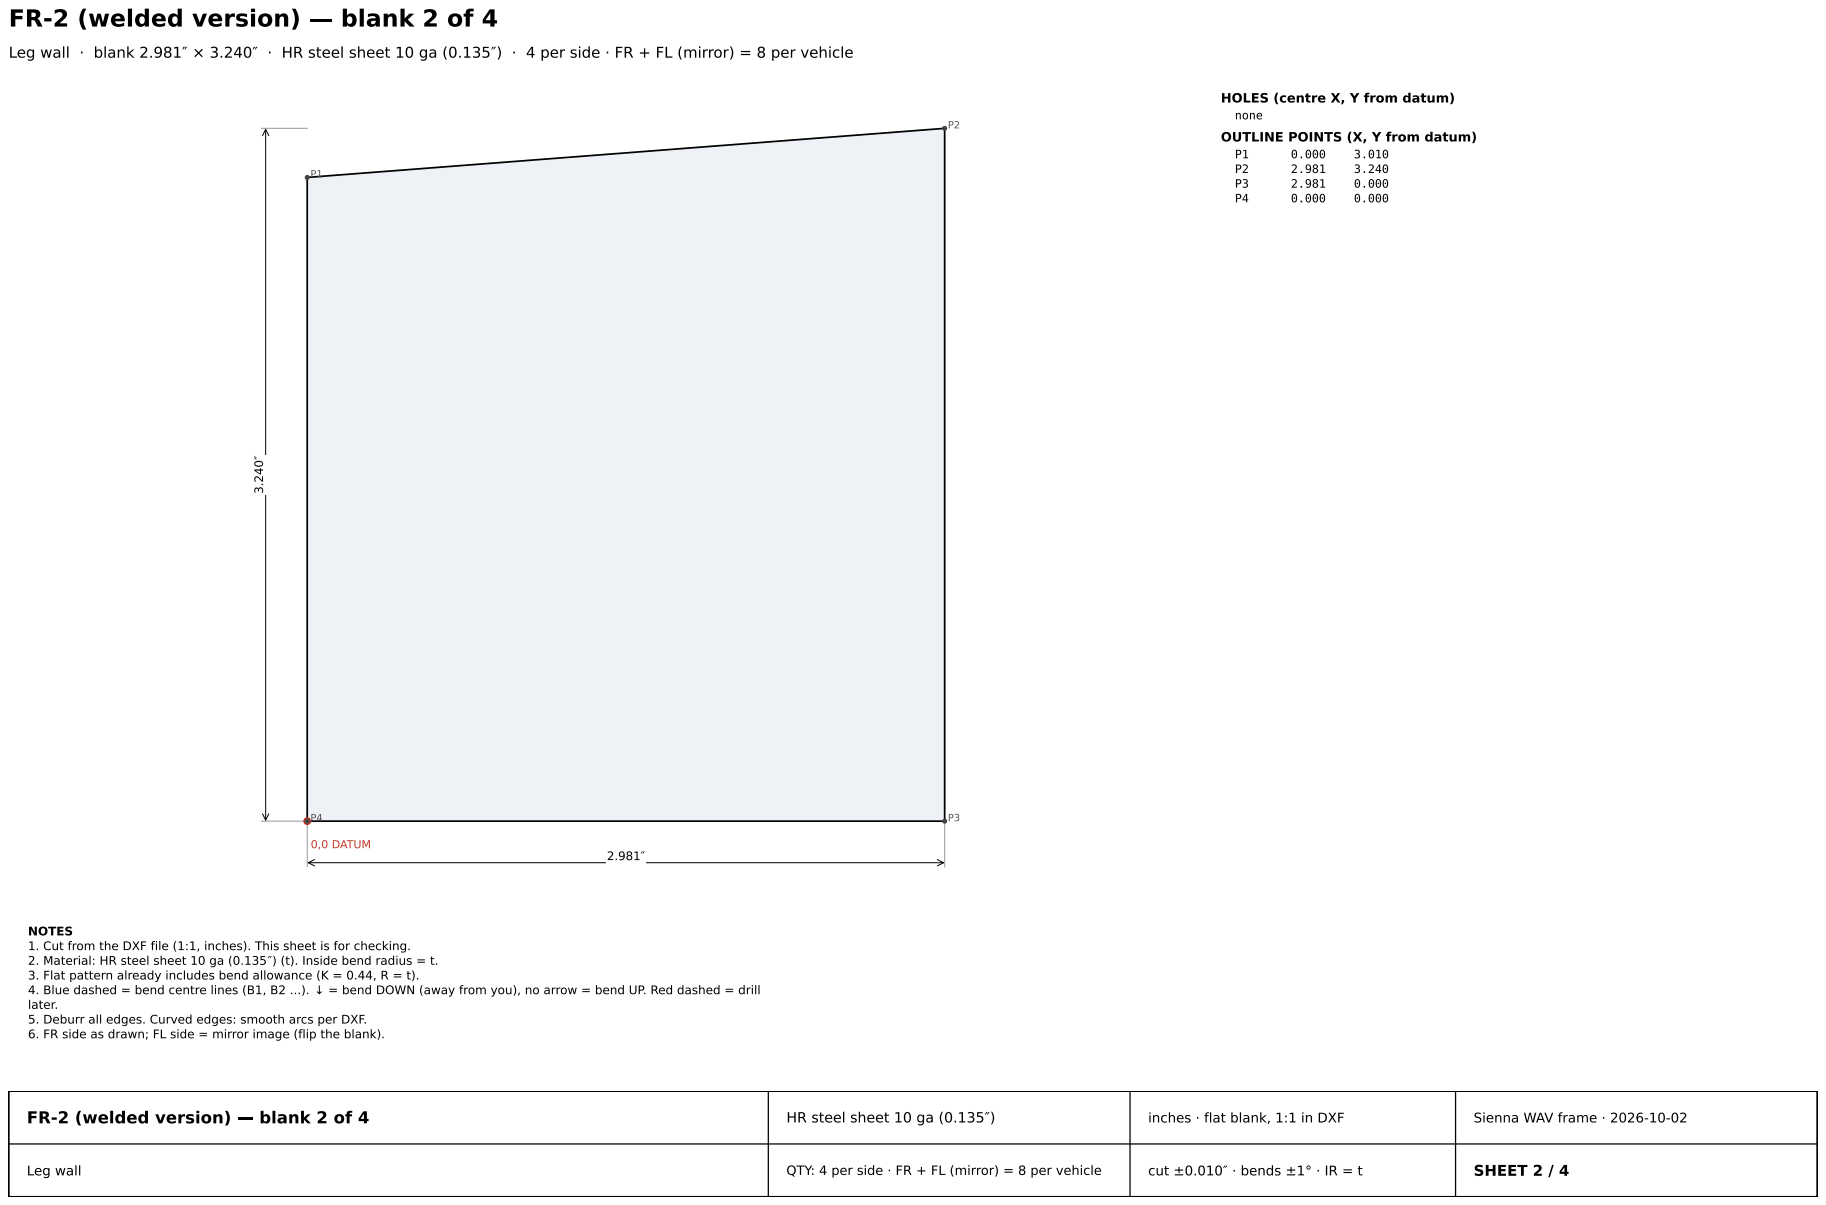
[picture p160: page 24]
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

HOLES (centre X, Y from datum)
none
OUTLINE POINTS (X, Y from datum)

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

FR-2 (welded version) blank 2 of 4 | HR steel sheet 10 ga (0.135 ) | inches · flat blank, 1:1 in DXF | Sienna WAV frame · 2026-10-02

Leg wall | QTY: 4 per side · FR + FL (mirror) = 8 per vehicle | | SHEET 2 / 4

# FR-2 (welded version) blank 3 of 4

Leg bottom, left (slot 0.709×0.472) · blank 2.000 × 3.250 · HR steel sheet 10 ga (0.135 ) · 1 per side · FR + FL (mirror) = 2 per vehicle

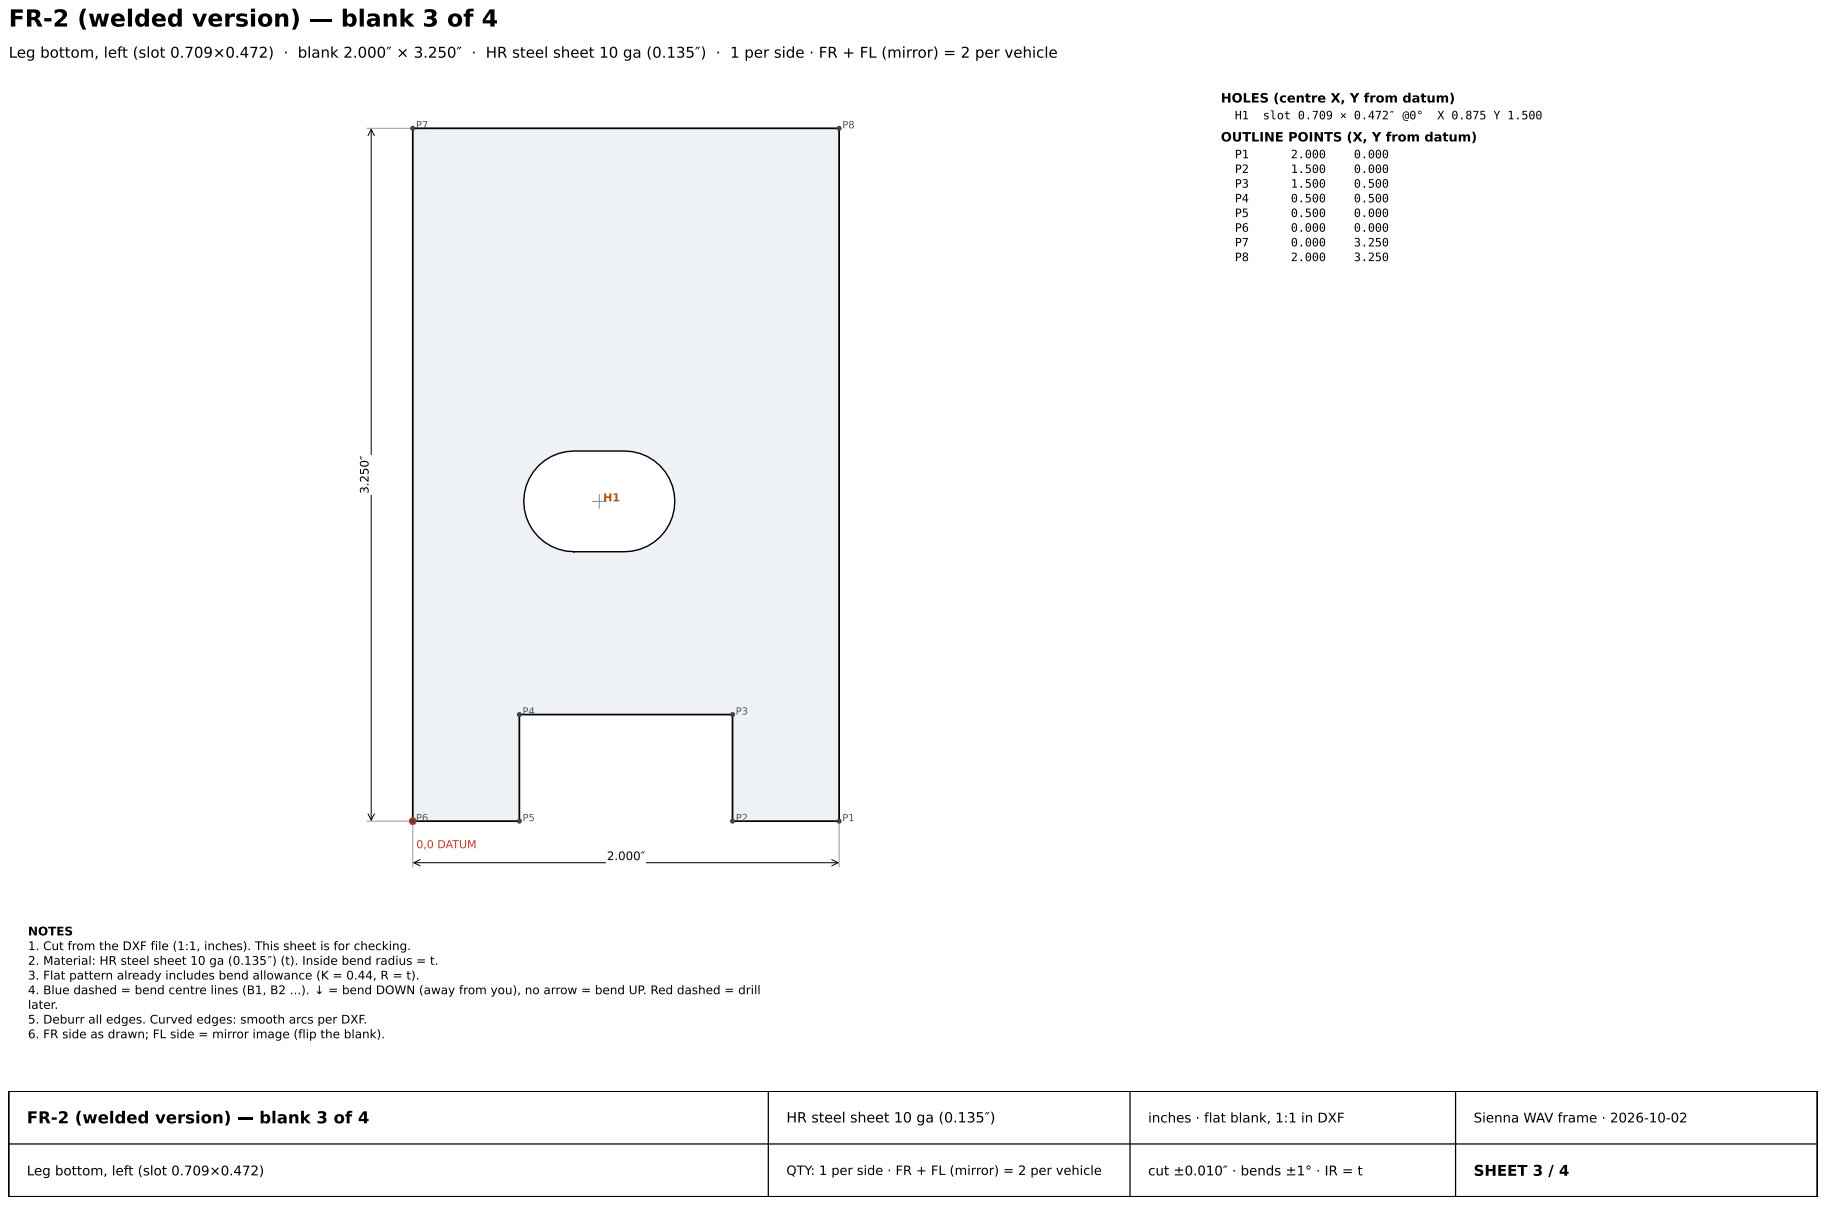
[picture p161: page 25]

HOLES (centre X, Y from datum)
H1 slot 0.709 × 0.472 @0° X 0.875 Y 1.500
OUTLINE POINTS (X, Y from datum)

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

FR-2 (welded version) blank 3 of 4

HR steel sheet 10 ga (0.135 )

inches · flat blank, 1:1 in DXF

Leg bottom, left (slot 0.709×0.472)

# FR-2 (welded version) blank 4 of 4

Leg bottom, right (slot 3/4×5/8) · blank 2.000 × 3.250 · HR steel sheet 10 ga (0.135 ) · 1 per side · FR + FL (mirror) = 2 per vehicle

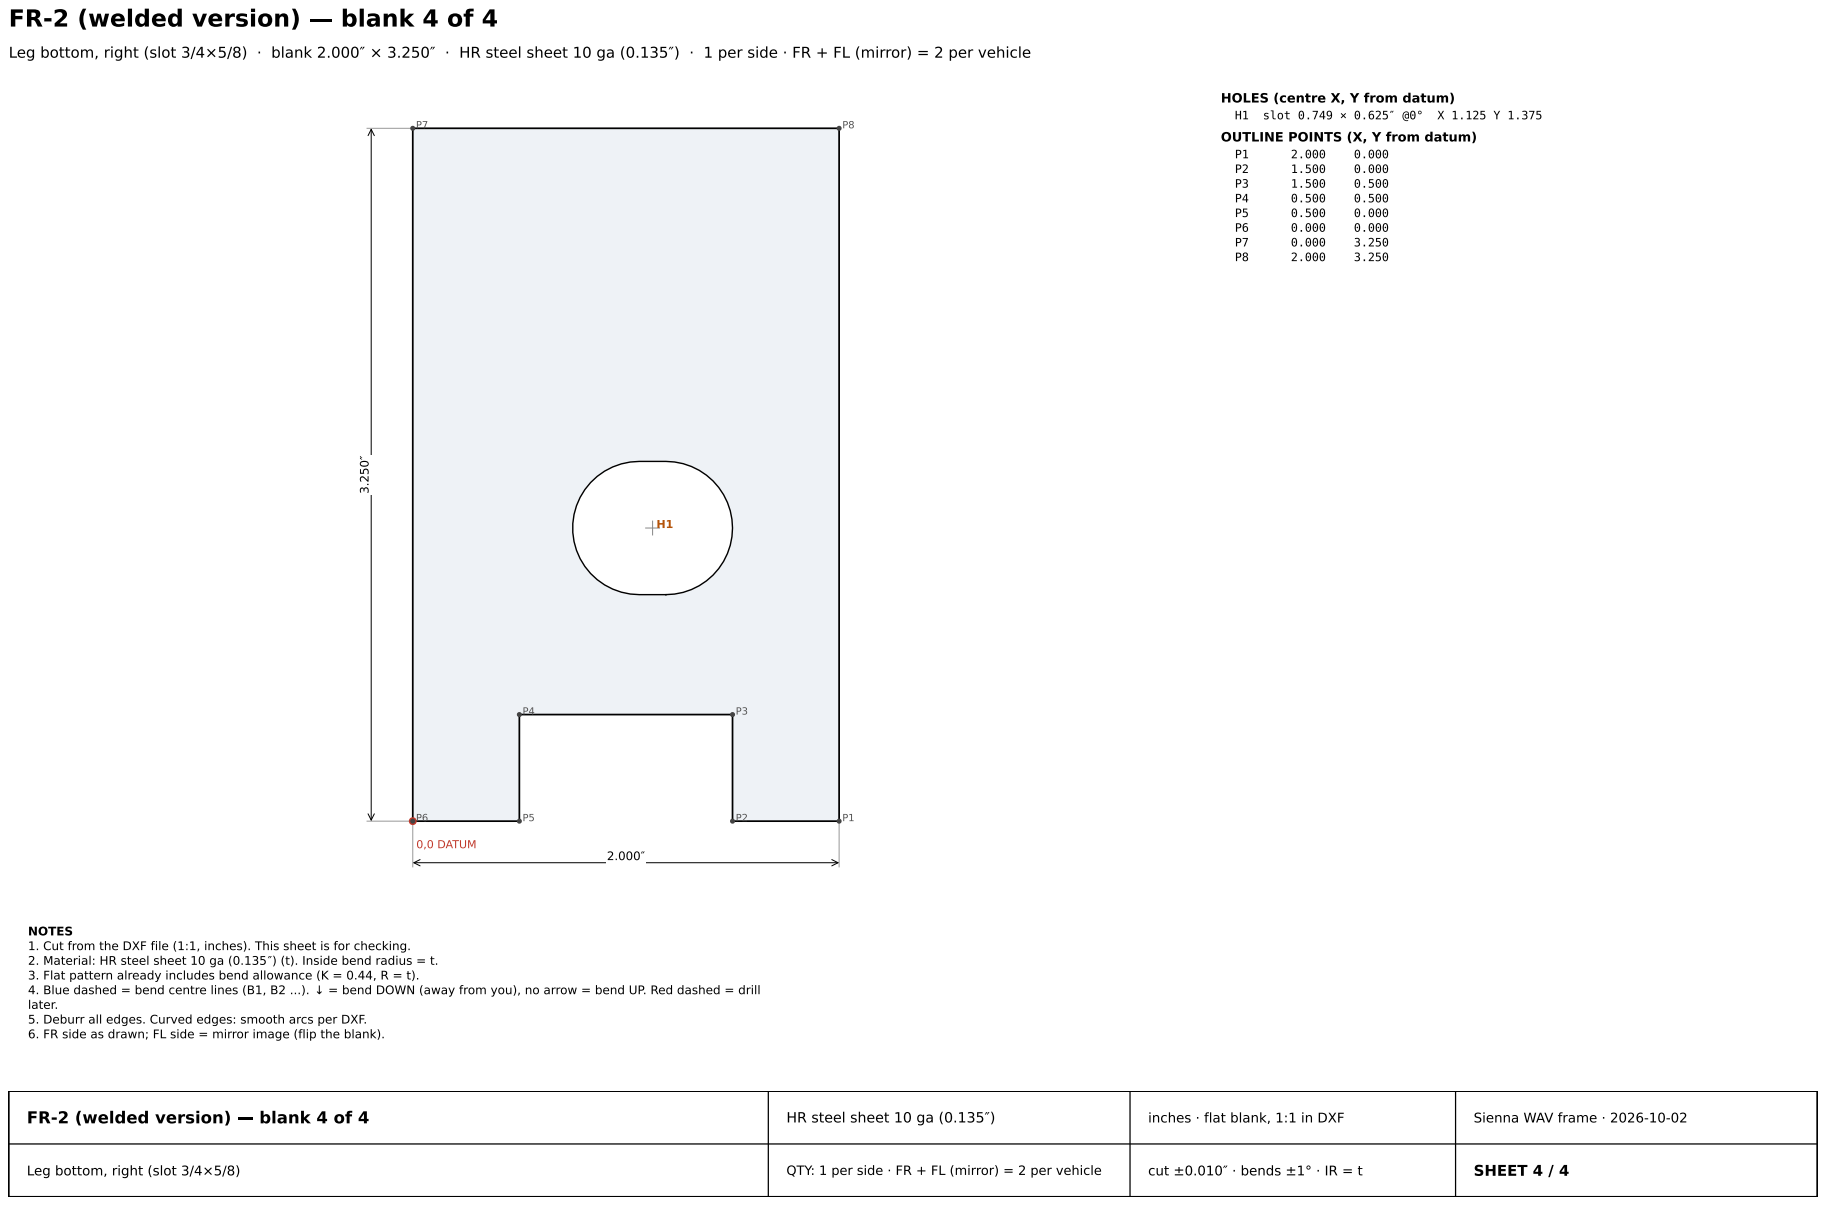
[picture p162: page 26]

HOLES (centre X, Y from datum)
H1 slot 0.749 × 0.625 @0° X 1.125 Y 1.375
OUTLINE POINTS (X, Y from datum)

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

FR-2 (welded version) blank 4 of 4

HR steel sheet 10 ga (0.135 )

inches · flat blank, 1:1 in DXF

Leg bottom, right (slot 3/4×5/8)

FR-3 | blank 1 of 1
Channel | flat pattern (2 bends 90°) · blank 4.084 × 7.734 · HR steel sheet 11 ga (0.120 ) · 1 per side · FR + FL (mirror) = 2 per vehicle

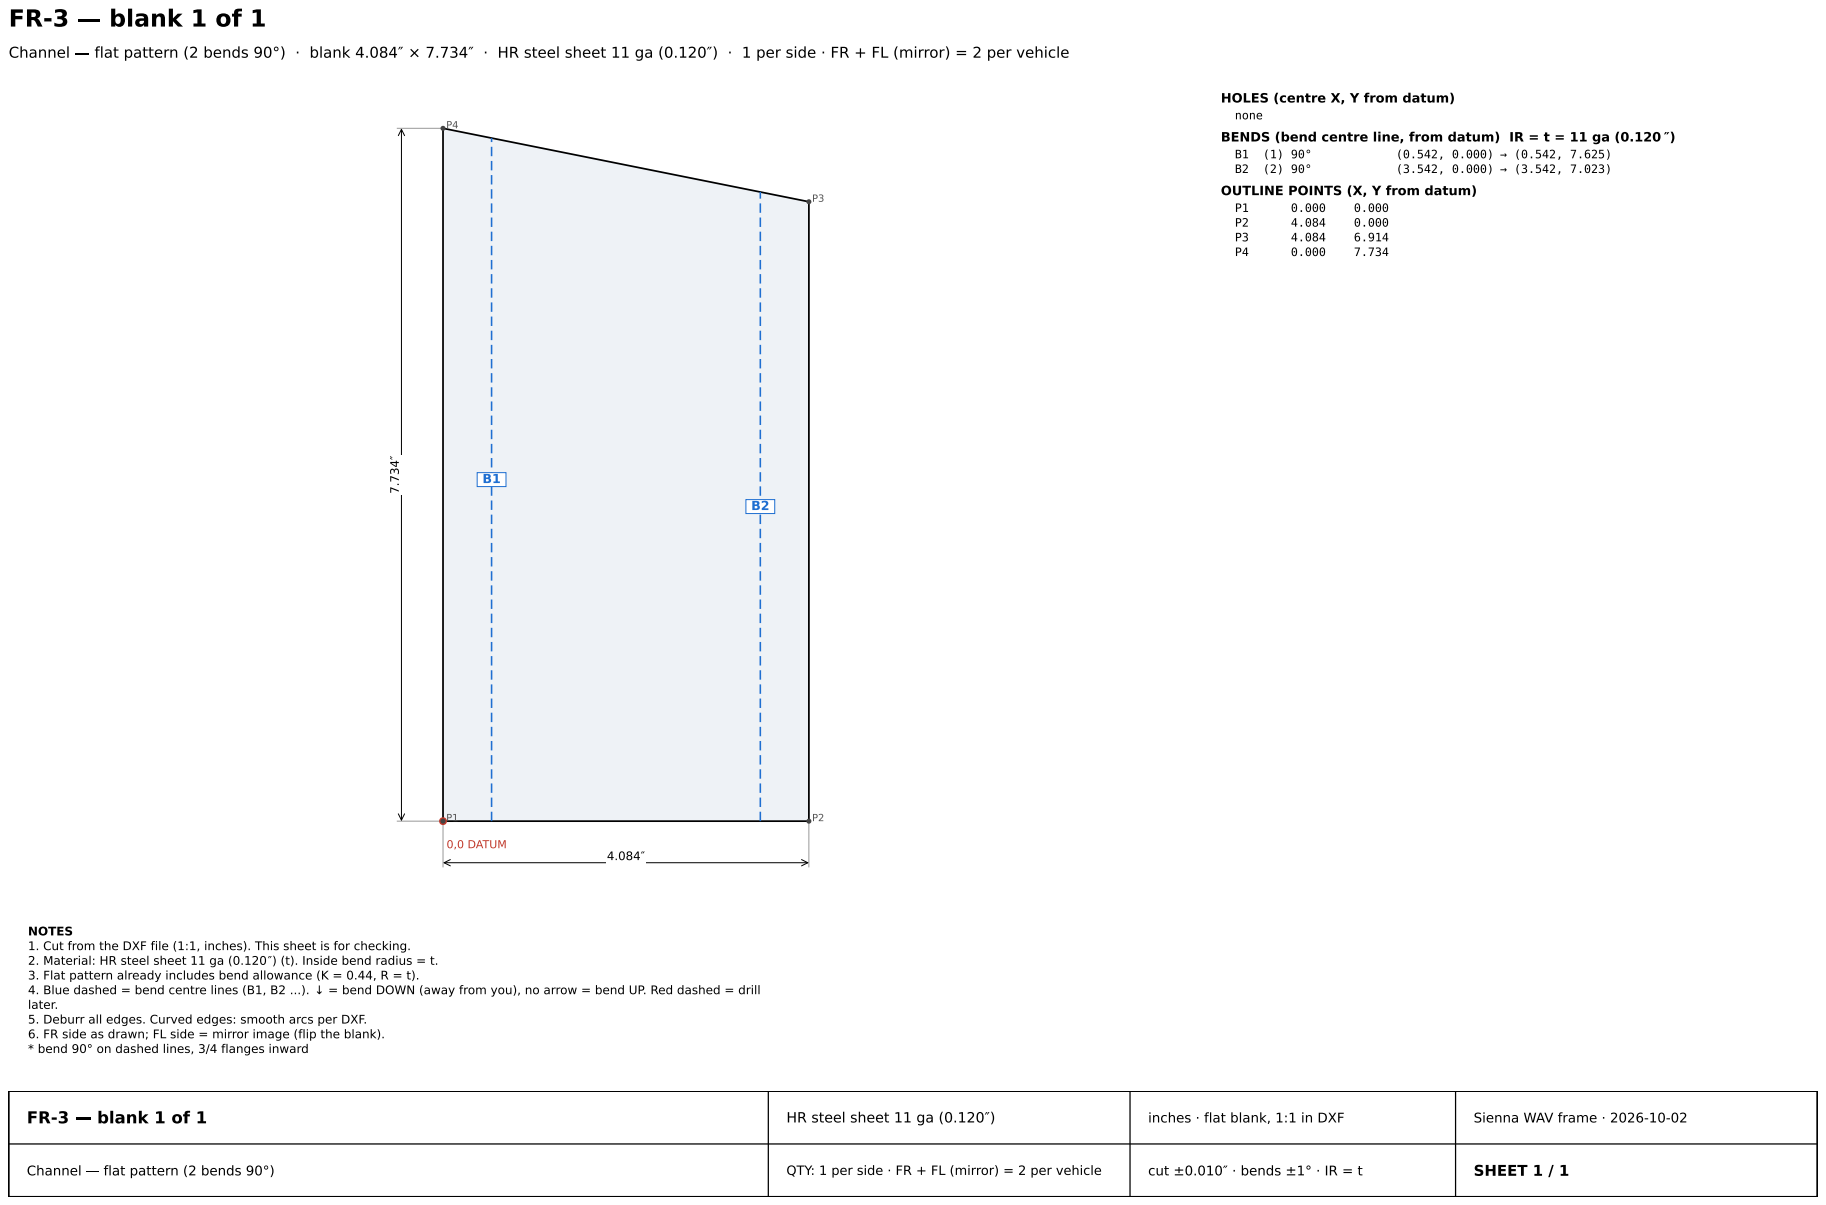
[picture p163: page 27]
0,0 DATUM; blank 1 of 1; Channel; flat pattern (2 bends 90°); SHEET 1 / 1; 4. Blue dashed = bend centre lines (B1, B2 ...).; = bend DOWN (away from you), no arrow = bend UP. Red dashed = drill

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

NOTES
1. Cut from the DXF file (1:1, inches). This sheet is for checking.
2. Material: HR steel sheet 11 ga (0.120 ) (t). Inside bend radius = t.
3. Flat pattern already includes bend allowance (K = 0.44, R = t).
later.
5. Deburr all edges. Curved edges: smooth arcs per DXF.
6. FR side as drawn; FL side = mirror image (flip the blank).
* bend 90° on dashed lines, 3/4 flanges inward

HR steel sheet 11 ga (0.120 )

inches · flat blank, 1:1 in DXF

Sienna WAV frame · 2026-10-02

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

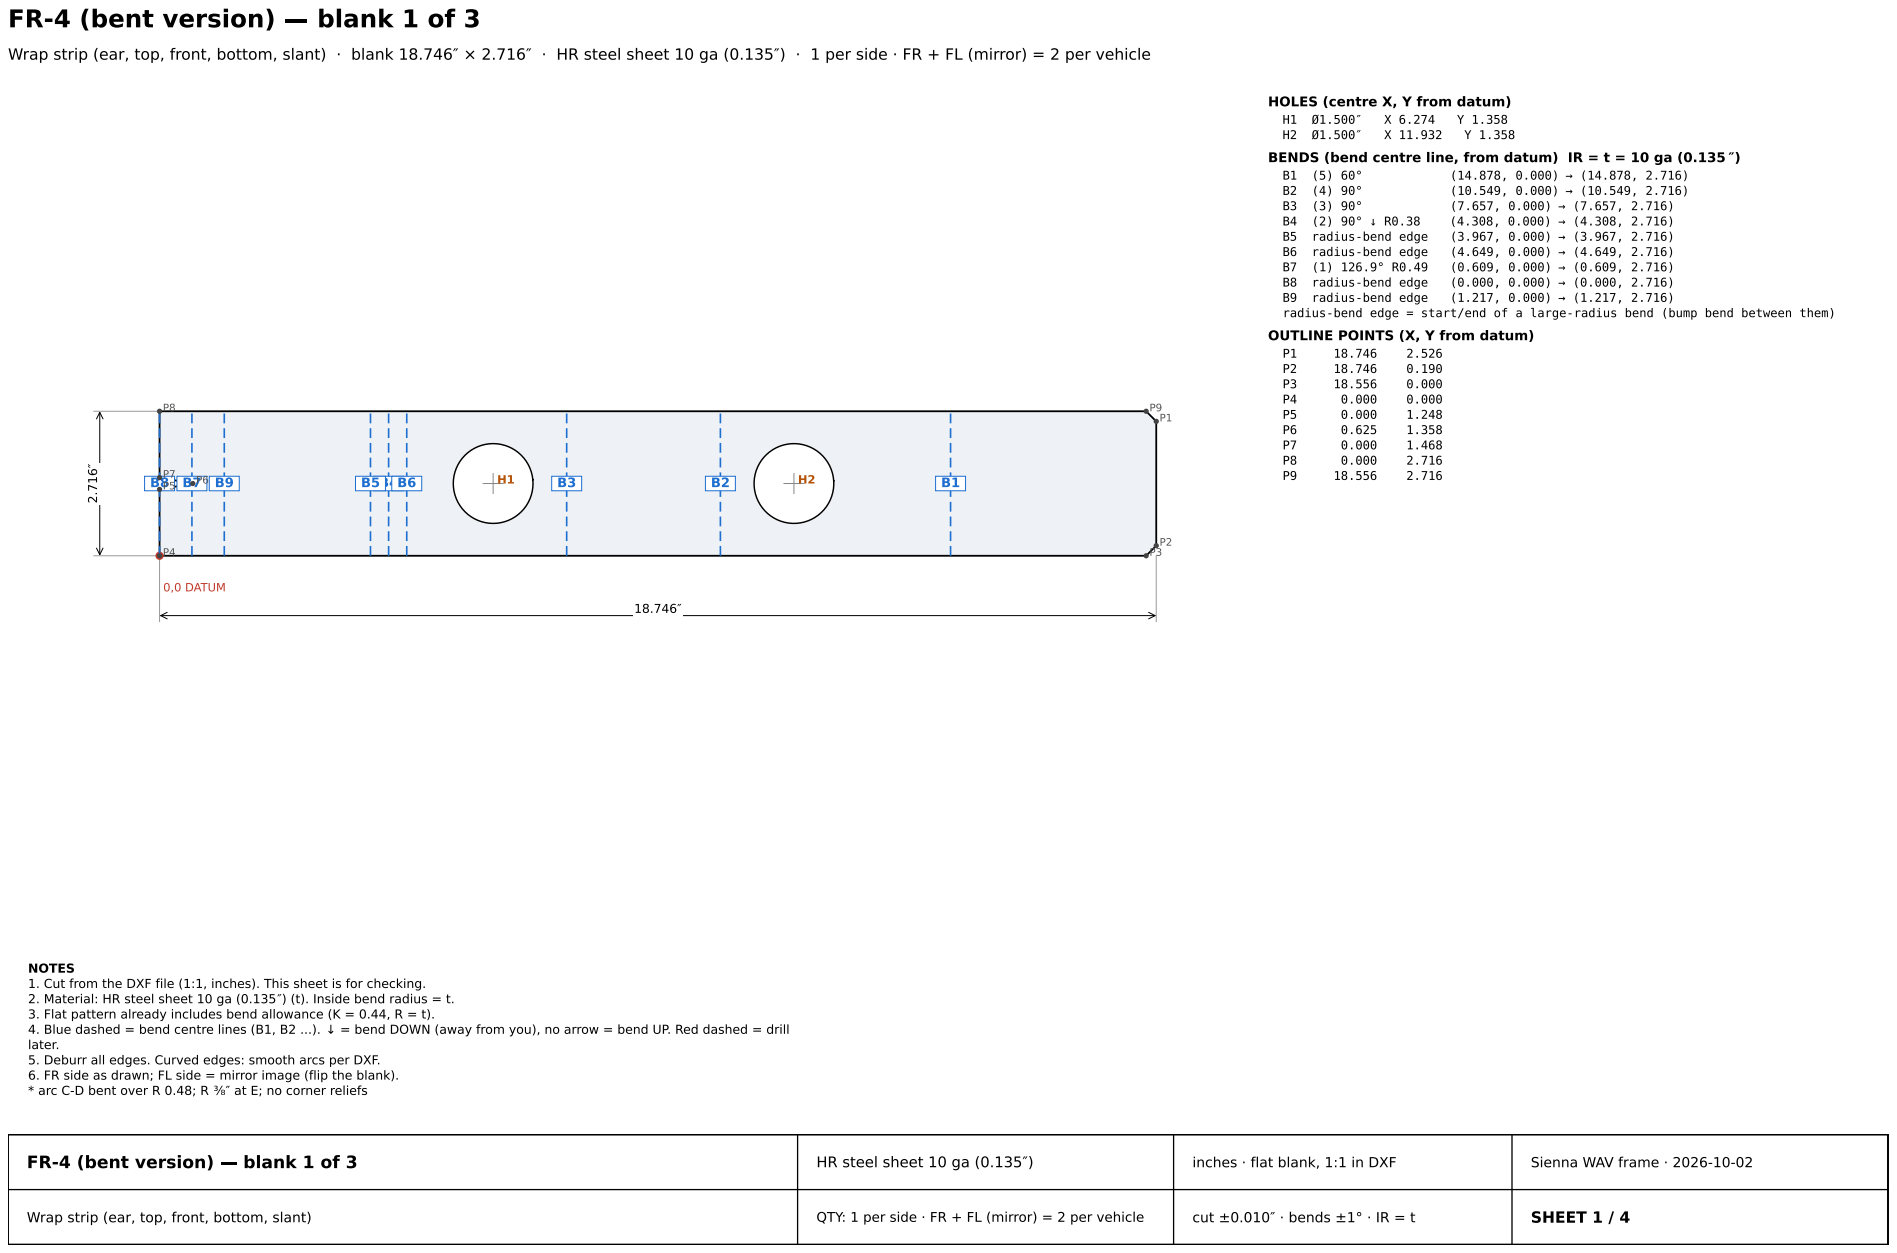
[picture p164: page 28]

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

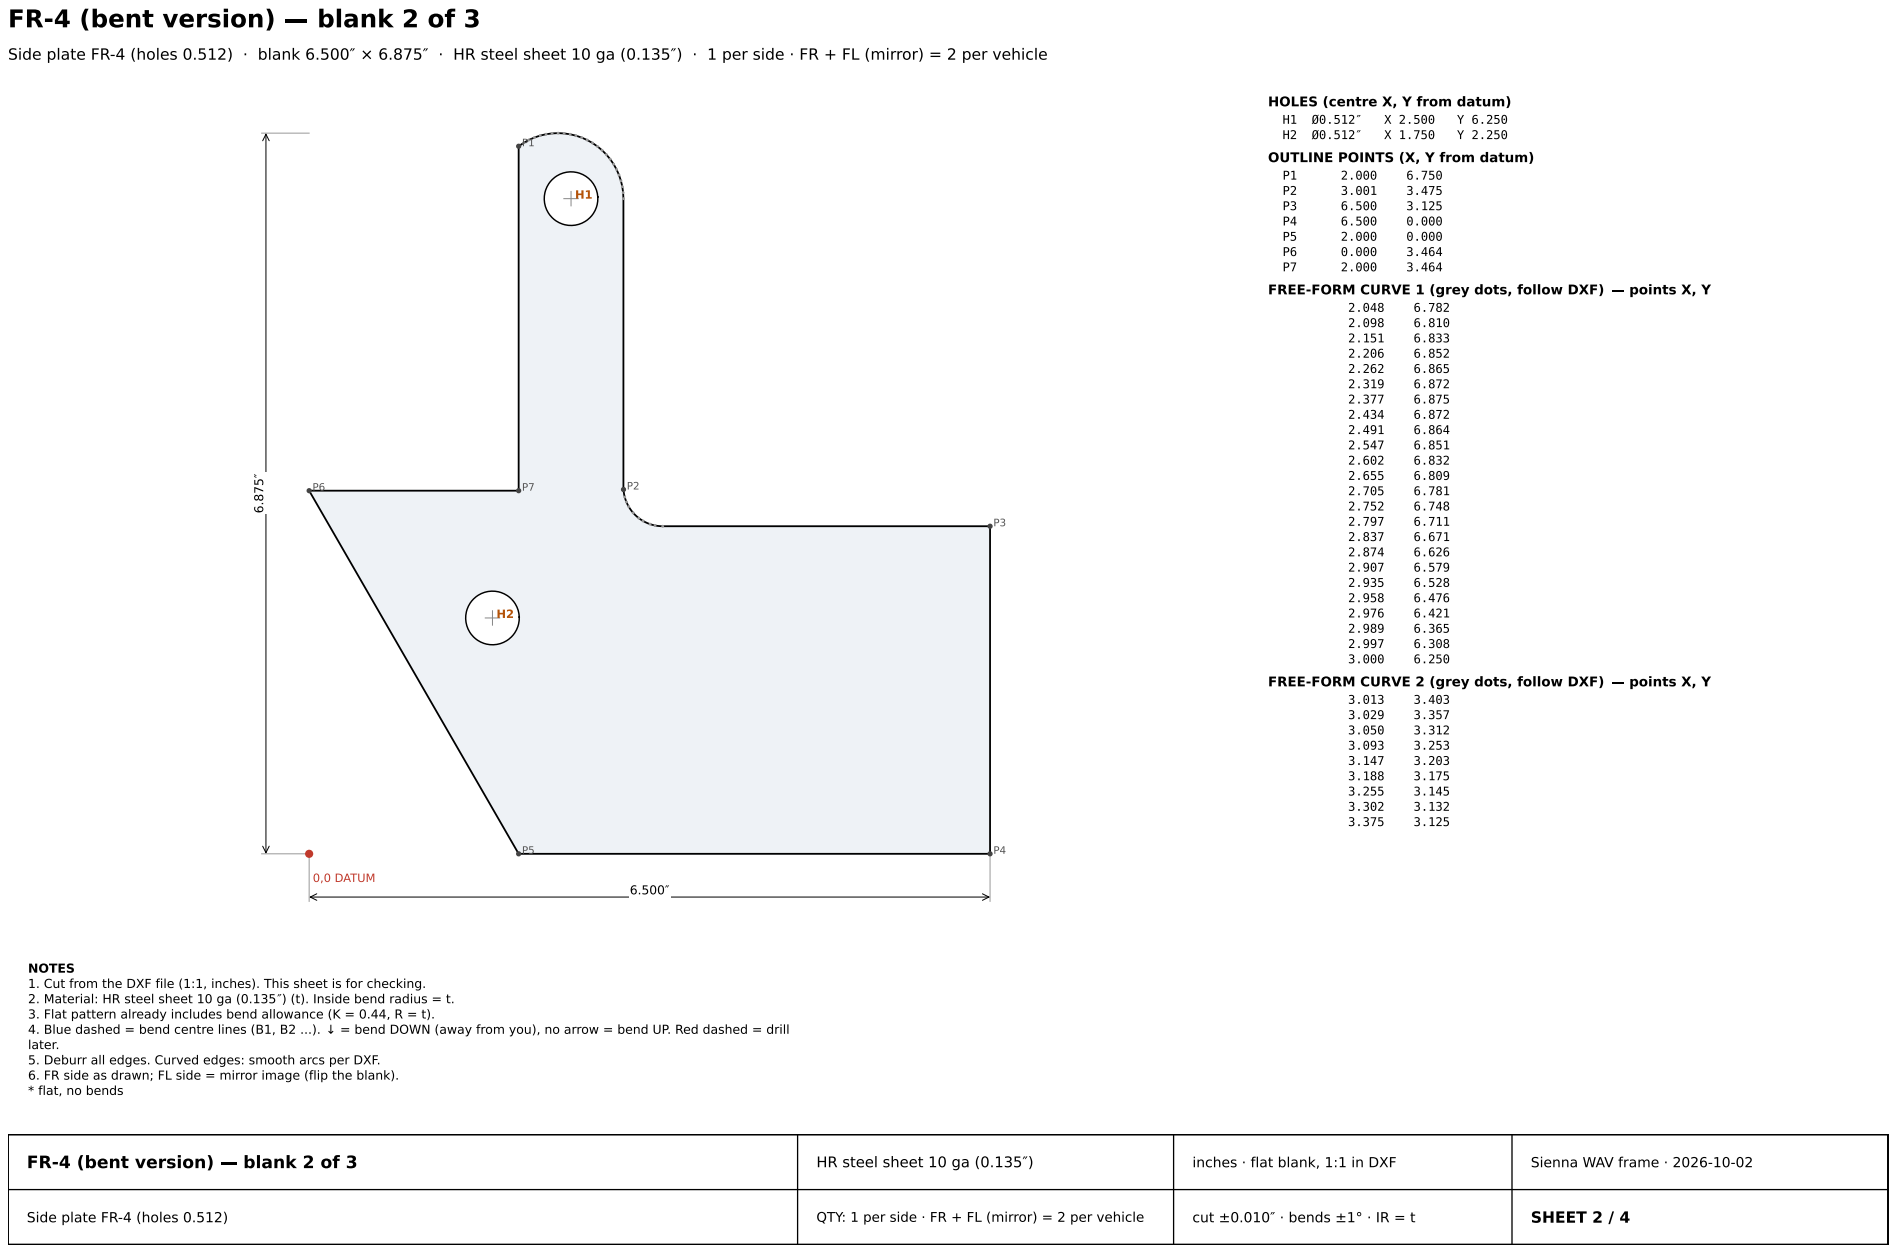
[picture p165: page 29]

H1

# FR-4 (bent version) blank 3 of 3

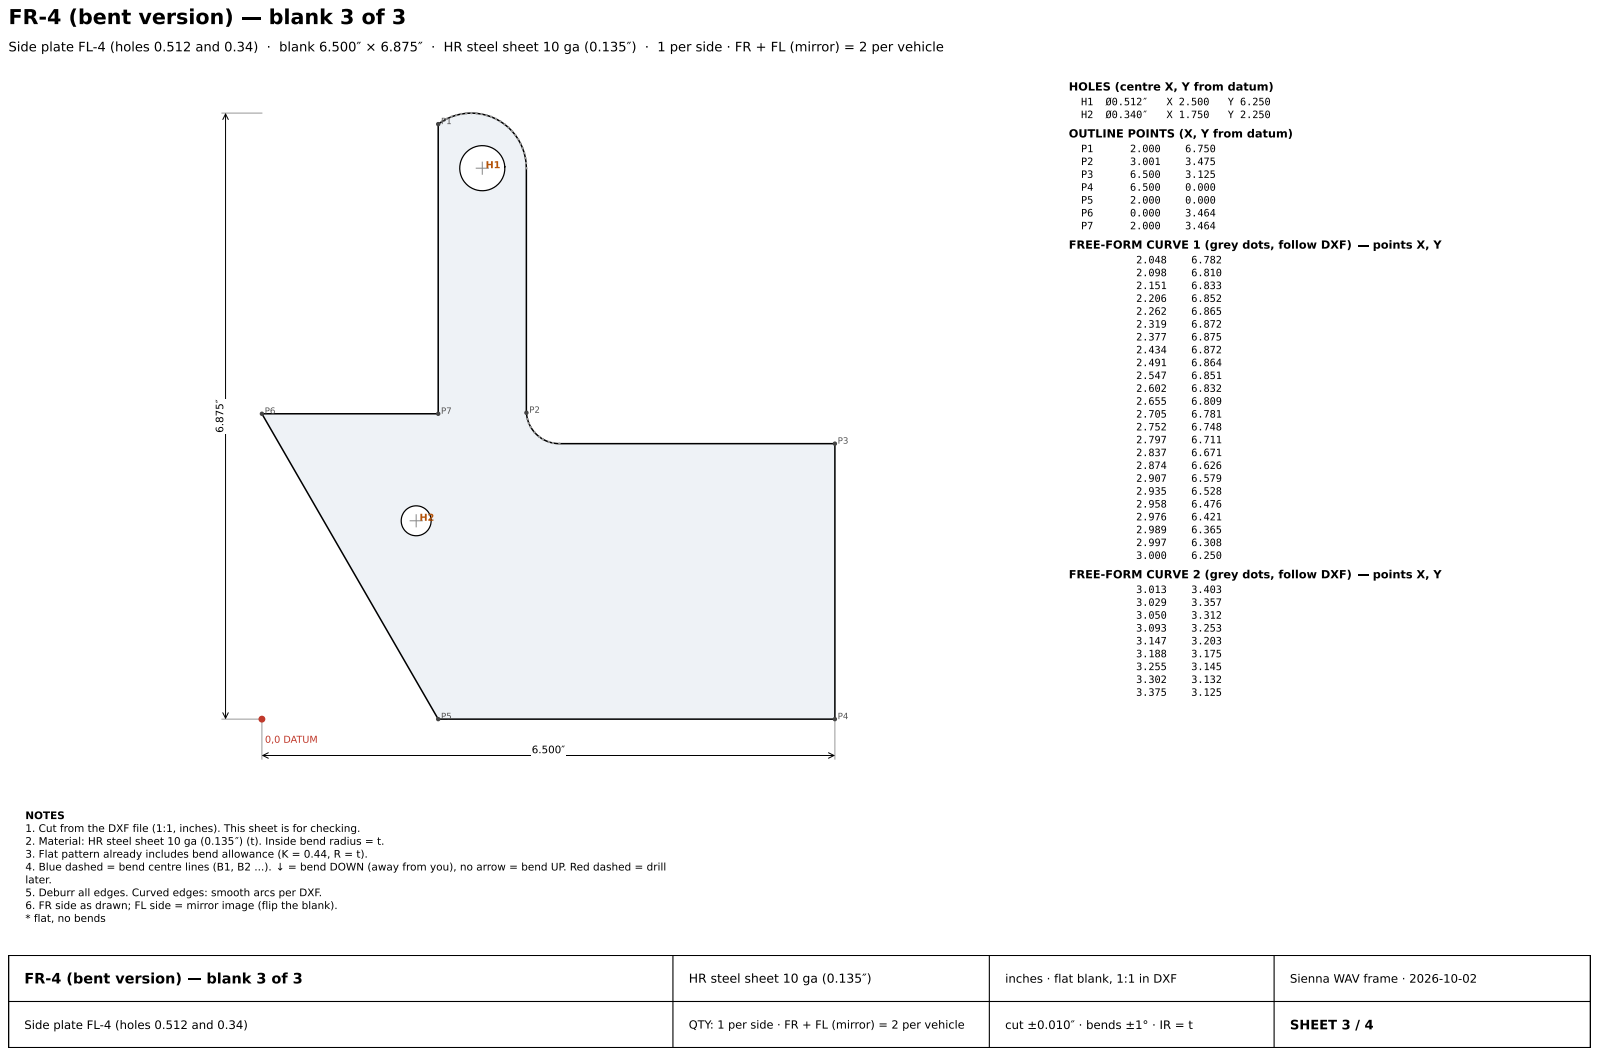
[picture p166: page 30]
0,0 DATUM; FR-4 (bent version); blank 3 of 3; SHEET 3 / 4; FREE-FORM CURVE 1 (grey dots, follow DXF); points X, Y; FREE-FORM CURVE 2 (grey dots, follow DXF); 4. Blue dashed = bend centre lines (B1, B2 ...).; = bend DOWN (away from you), no arrow = bend UP. Red dashed = drill

Side plate FL-4 (holes 0.512 and 0.34) · blank 6.500 × 6.875 · HR steel sheet 10 ga (0.135 ) · 1 per side · FR + FL (mirror) = 2 per vehicle

HOLES (centre X, Y from datum)
OUTLINE POINTS (X, Y from datum)

NOTES
1. Cut from the DXF file (1:1, inches). This sheet is for checking.
2. Material: HR steel sheet 10 ga (0.135 ) (t). Inside bend radius = t.
3. Flat pattern already includes bend allowance (K = 0.44, R = t).
later.
5. Deburr all edges. Curved edges: smooth arcs per DXF.
6. FR side as drawn; FL side = mirror image (flip the blank).
* flat, no bends

HR steel sheet 10 ga (0.135 )

inches · flat blank, 1:1 in DXF

Sienna WAV frame · 2026-10-02

Side plate FL-4 (holes 0.512 and 0.34)

FR-4 tubes | | inches · flat blank, 1:1 in DXF | Sienna WAV frame · 2026-10-02
Tube OD 1.5 / ID 1.181 cut 3.689 (through bottom and top) | QTY: 1 per side · FR + FL (mirror) = 2 per vehicle | | SHEET 4 / 4
FR-4 (bent version) | cut list (tubes)
Tube OD 1.5 / ID 1.181 | cut 3.689 (through bottom and top)
Stock: DOM round tube · cut length 3.689 | · QTY 1 per side · FR + FL (mirror) = 2 per vehicle

Cut square, ±1/32 . Deburr. Lengths in inches.

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

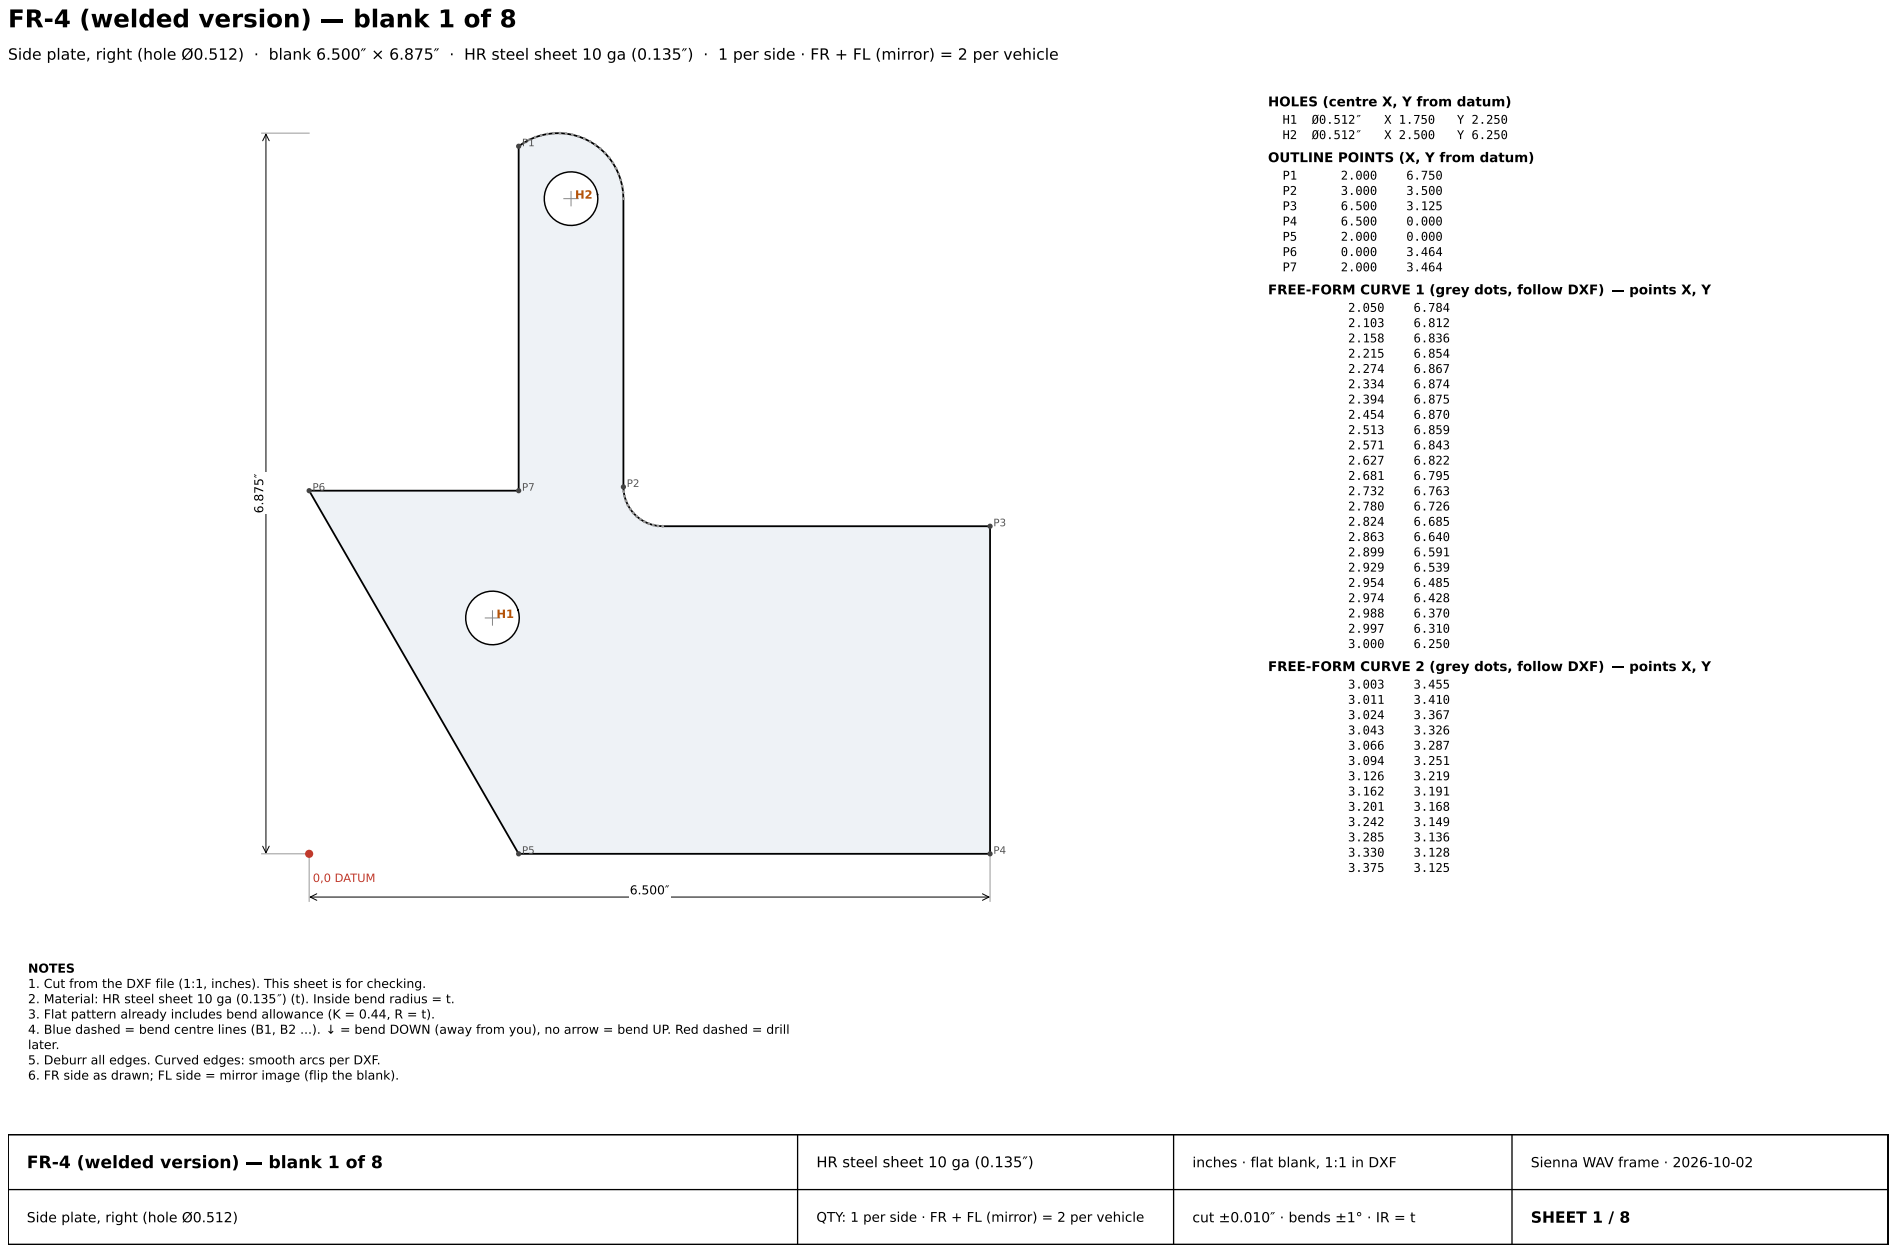
[picture p167: page 32]

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

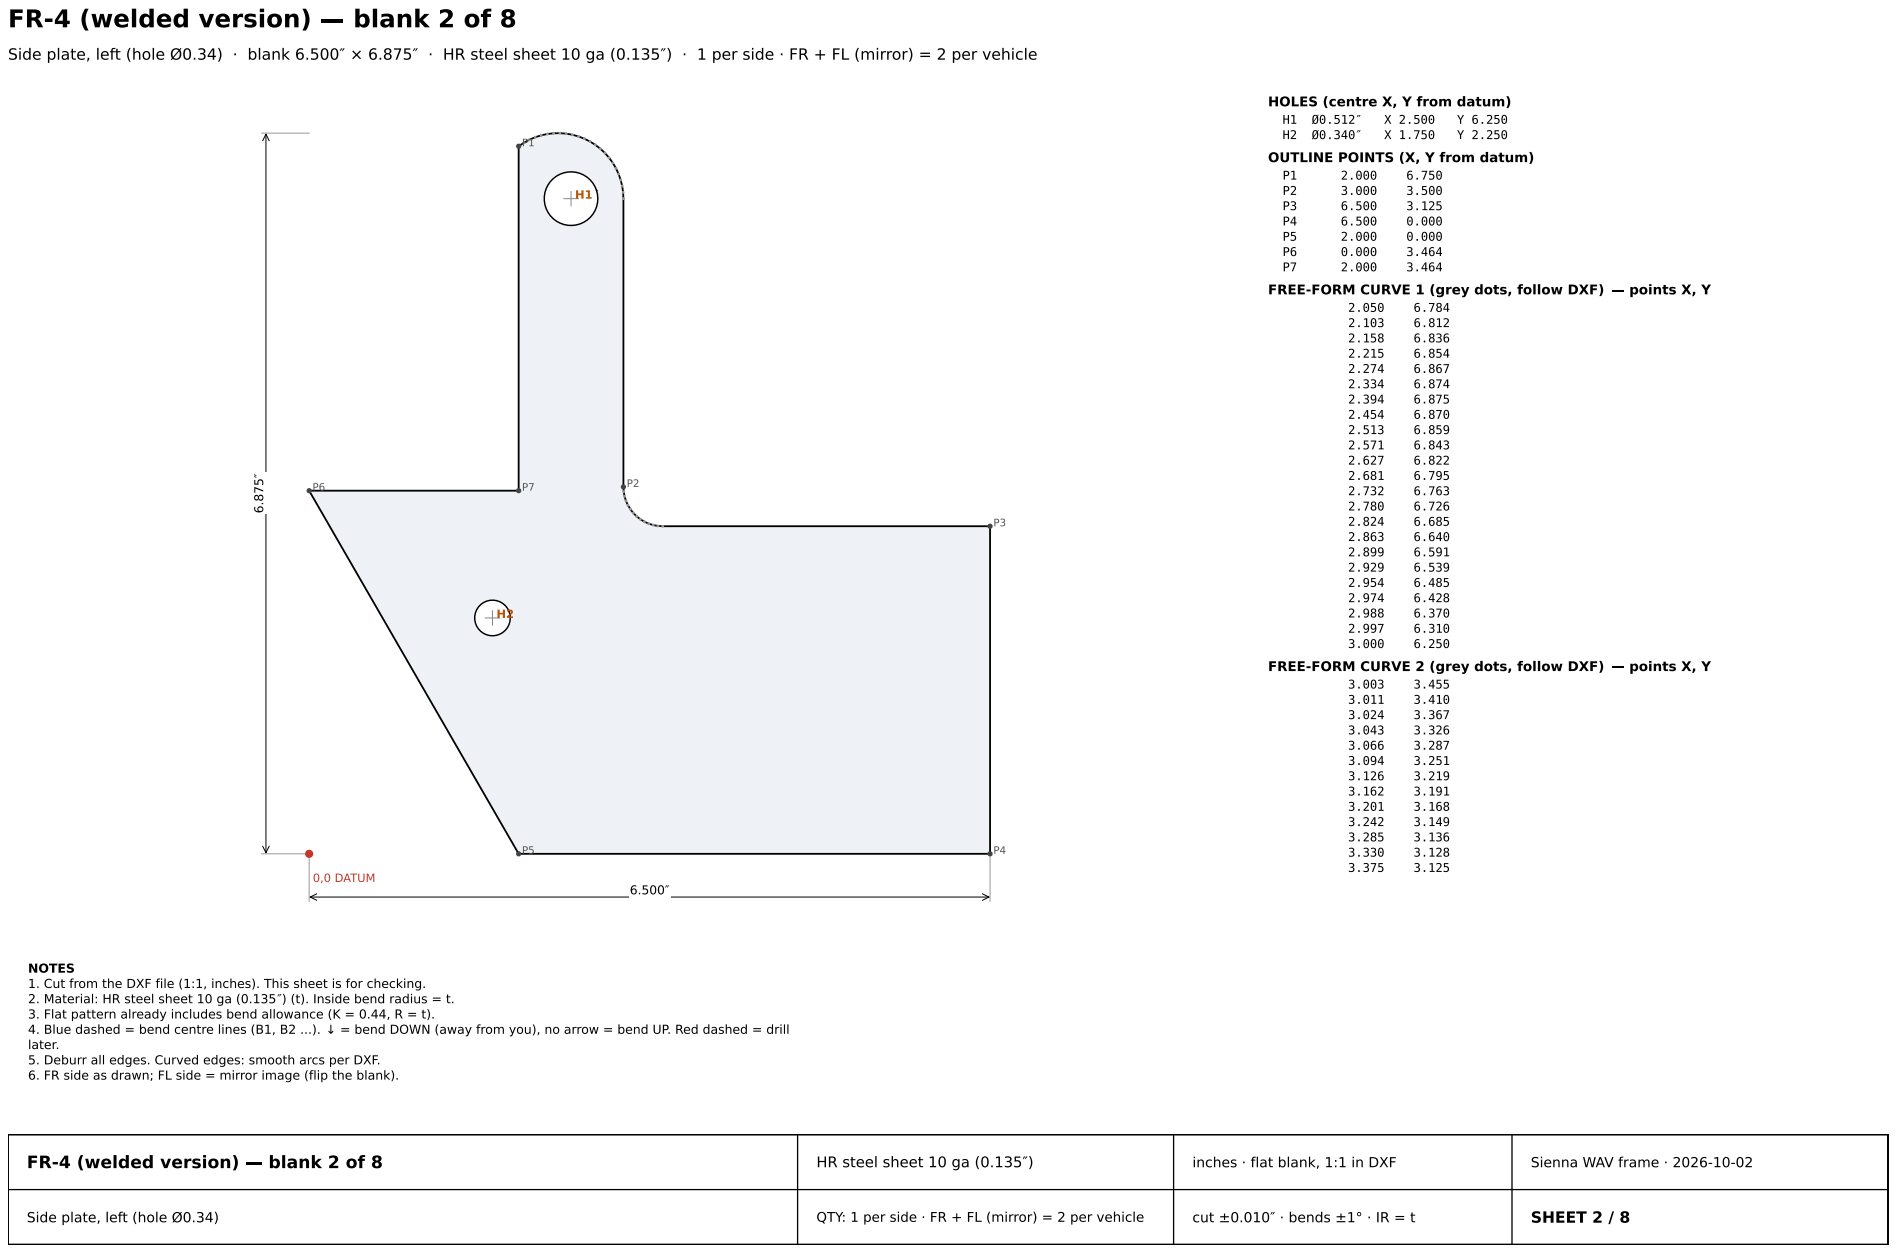
[picture p168: page 33]

# FR-4 (welded version) blank 3 of 8

Front plate · blank 2.731 × 3.125 · HR steel sheet 10 ga (0.135 ) · 1 per side · FR + FL (mirror) = 2 per vehicle

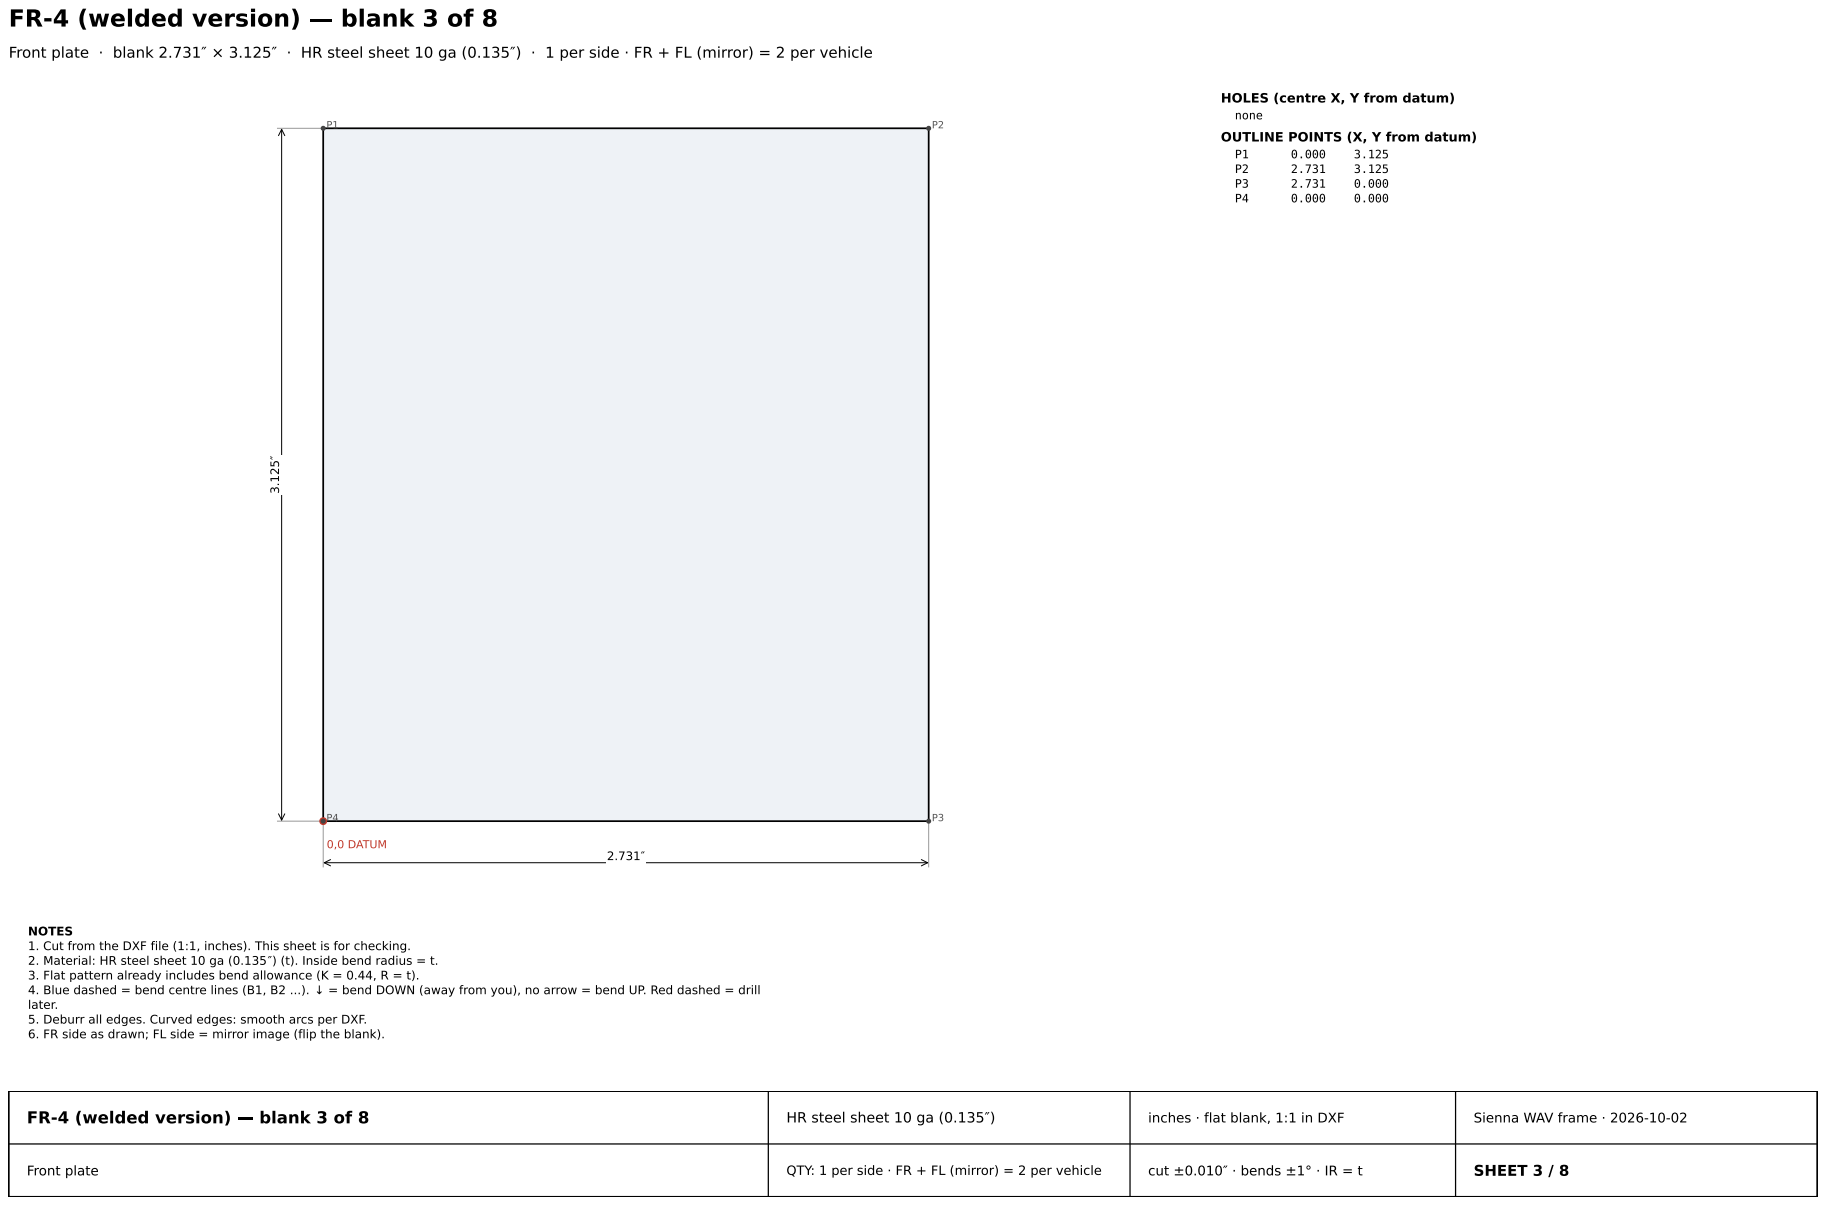
[picture p169: page 34]
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

HOLES (centre X, Y from datum)
none
OUTLINE POINTS (X, Y from datum)

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

FR-4 (welded version) blank 3 of 8 | HR steel sheet 10 ga (0.135 ) | inches · flat blank, 1:1 in DXF | Sienna WAV frame · 2026-10-02

Front plate | | | SHEET 3 / 8

# FR-4 (welded version) blank 4 of 8

Slanted plate · blank 4.000 × 2.731 · HR steel sheet 10 ga (0.135 ) · 1 per side · FR + FL (mirror) = 2 per vehicle

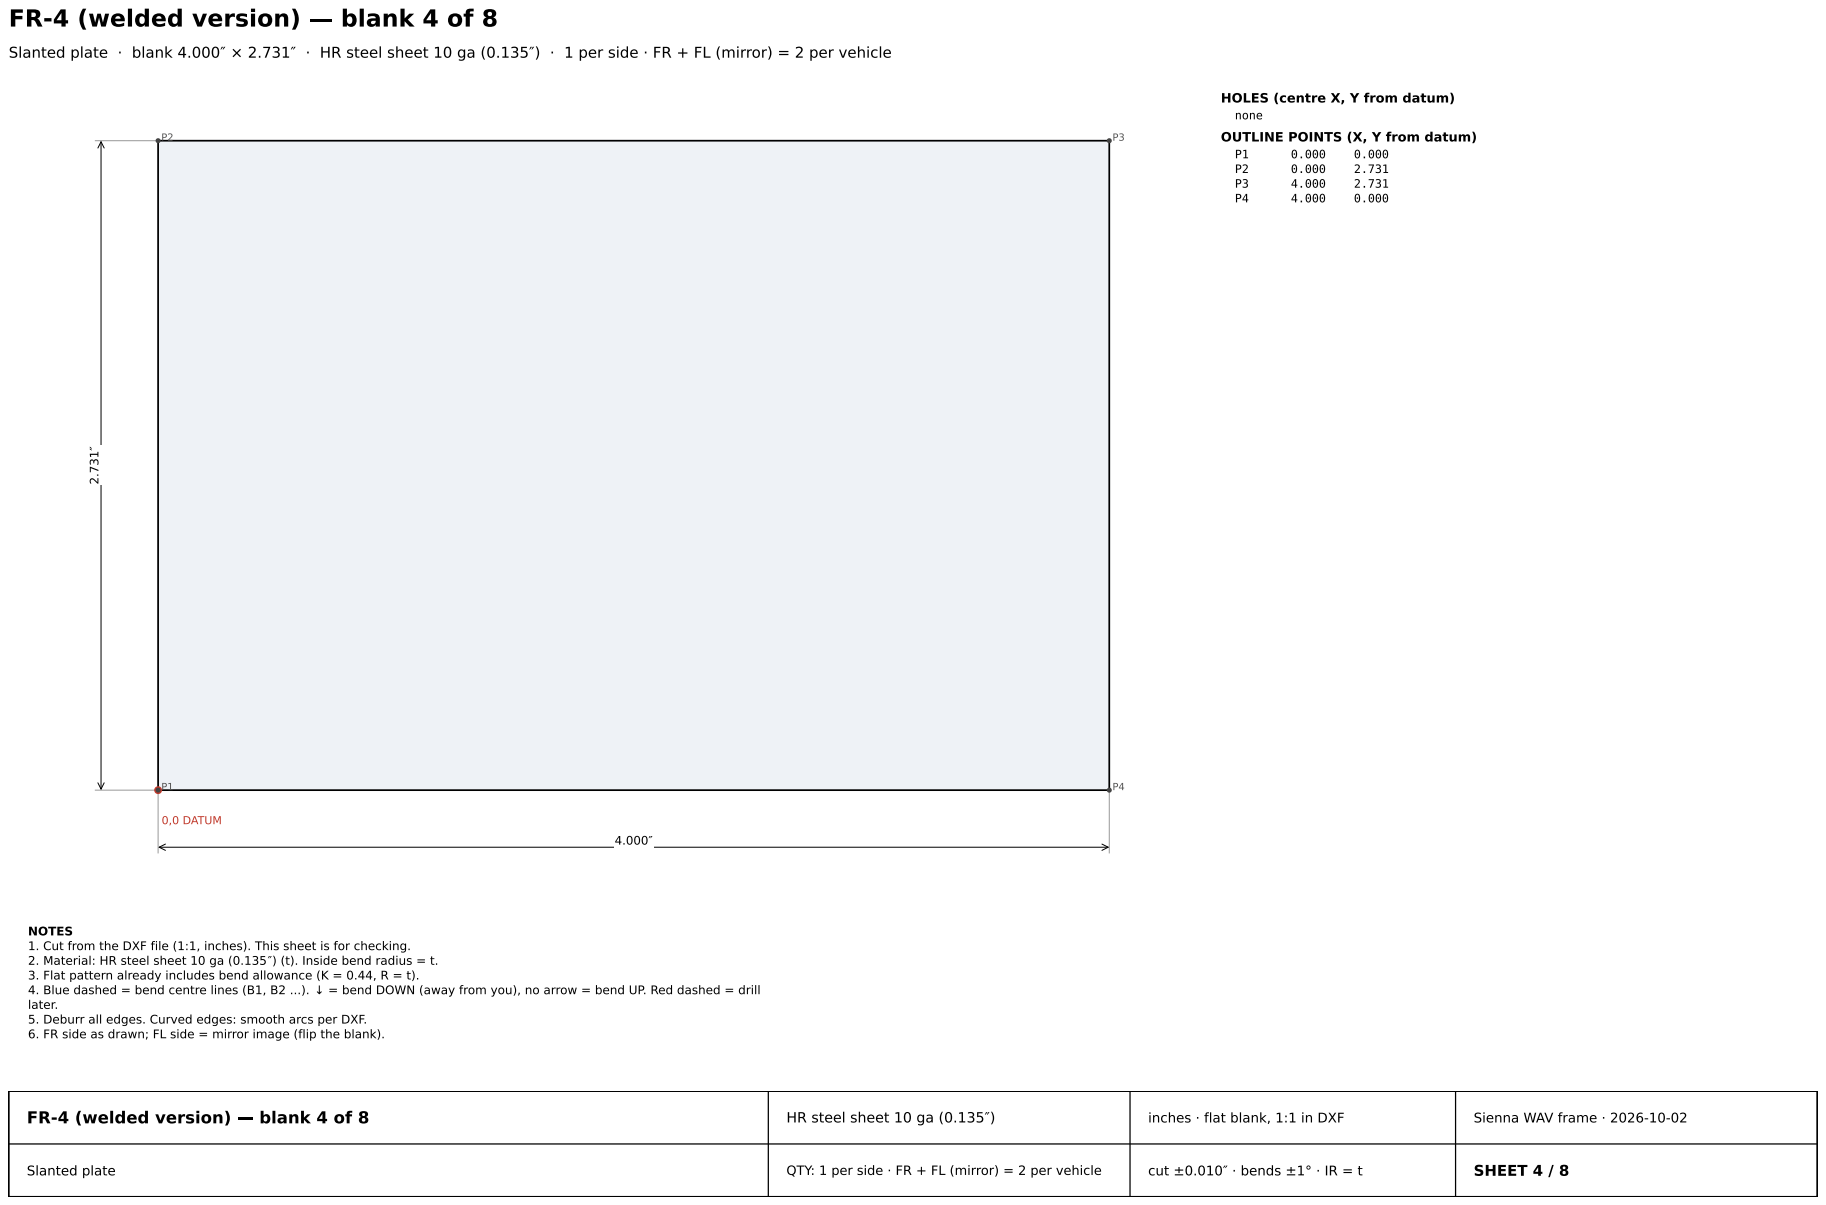
[picture p170: page 35]
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

HOLES (centre X, Y from datum)
none
OUTLINE POINTS (X, Y from datum)

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

FR-4 (welded version) blank 4 of 8 | HR steel sheet 10 ga (0.135 ) | inches · flat blank, 1:1 in DXF | Sienna WAV frame · 2026-10-02

Slanted plate | | | SHEET 4 / 8

# FR-4 (welded version) blank 5 of 8

Bottom plate (hole Ø1.5 for the tube) · blank 2.731 × 4.210 · HR steel sheet 10 ga (0.135 ) · 1 per side · FR + FL (mirror) = 2 per vehicle

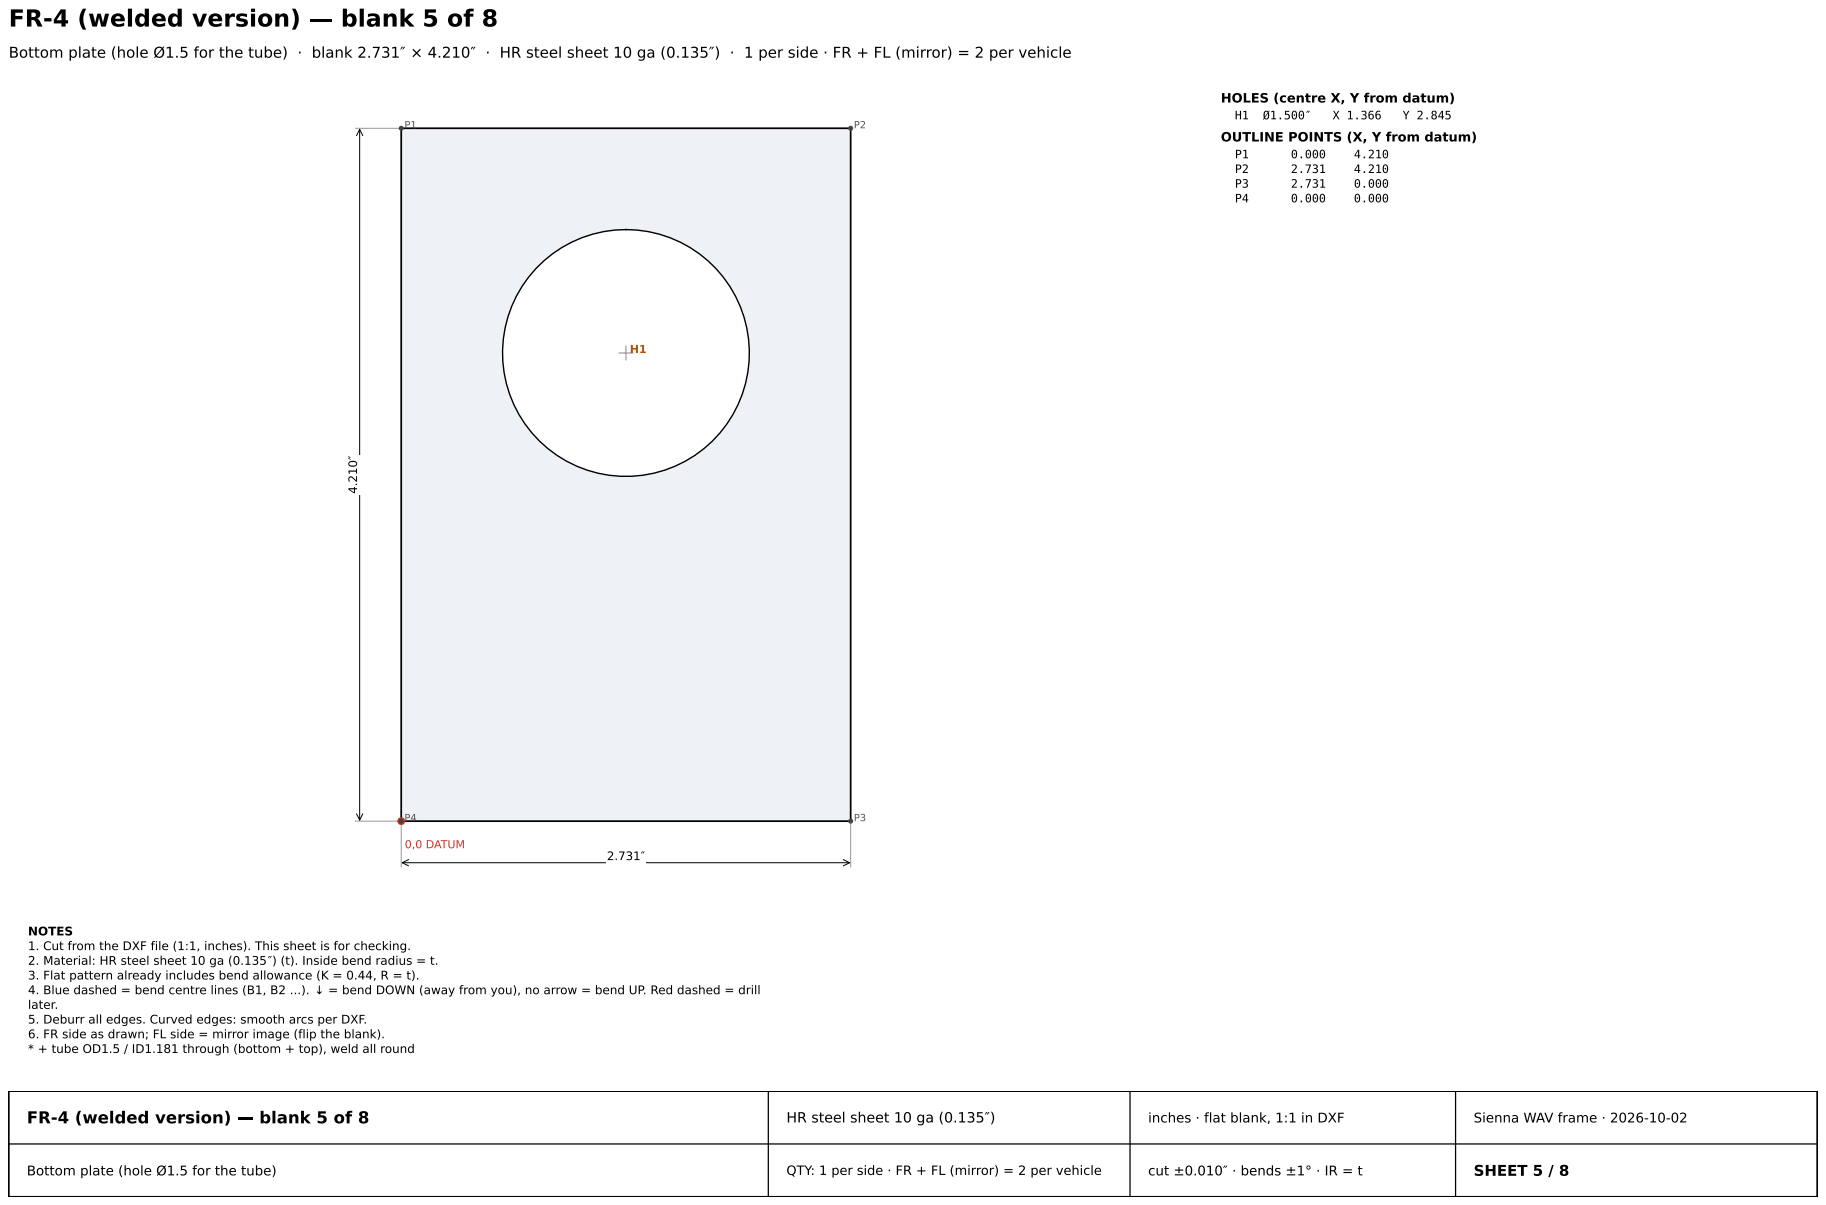
[picture p171: page 36]
0,0 DATUM; FR-4 (welded version); blank 5 of 8; SHEET 5 / 8; 4. Blue dashed = bend centre lines (B1, B2 ...).; = bend DOWN (away from you), no arrow = bend UP. Red dashed = drill

HOLES (centre X, Y from datum)
OUTLINE POINTS (X, Y from datum)

NOTES
1. Cut from the DXF file (1:1, inches). This sheet is for checking.
2. Material: HR steel sheet 10 ga (0.135 ) (t). Inside bend radius = t.
3. Flat pattern already includes bend allowance (K = 0.44, R = t).
later.
5. Deburr all edges. Curved edges: smooth arcs per DXF.
6. FR side as drawn; FL side = mirror image (flip the blank).
* + tube OD1.5 / ID1.181 through (bottom + top), weld all round

HR steel sheet 10 ga (0.135 )

inches · flat blank, 1:1 in DXF

Sienna WAV frame · 2026-10-02

Bottom plate (hole Ø1.5 for the tube)

# FR-4 (welded version) blank 6 of 8

Top plate (hole Ø1.5 for the tube) · blank 2.731 × 3.365 · HR steel sheet 10 ga (0.135 ) · 1 per side · FR + FL (mirror) = 2 per vehicle

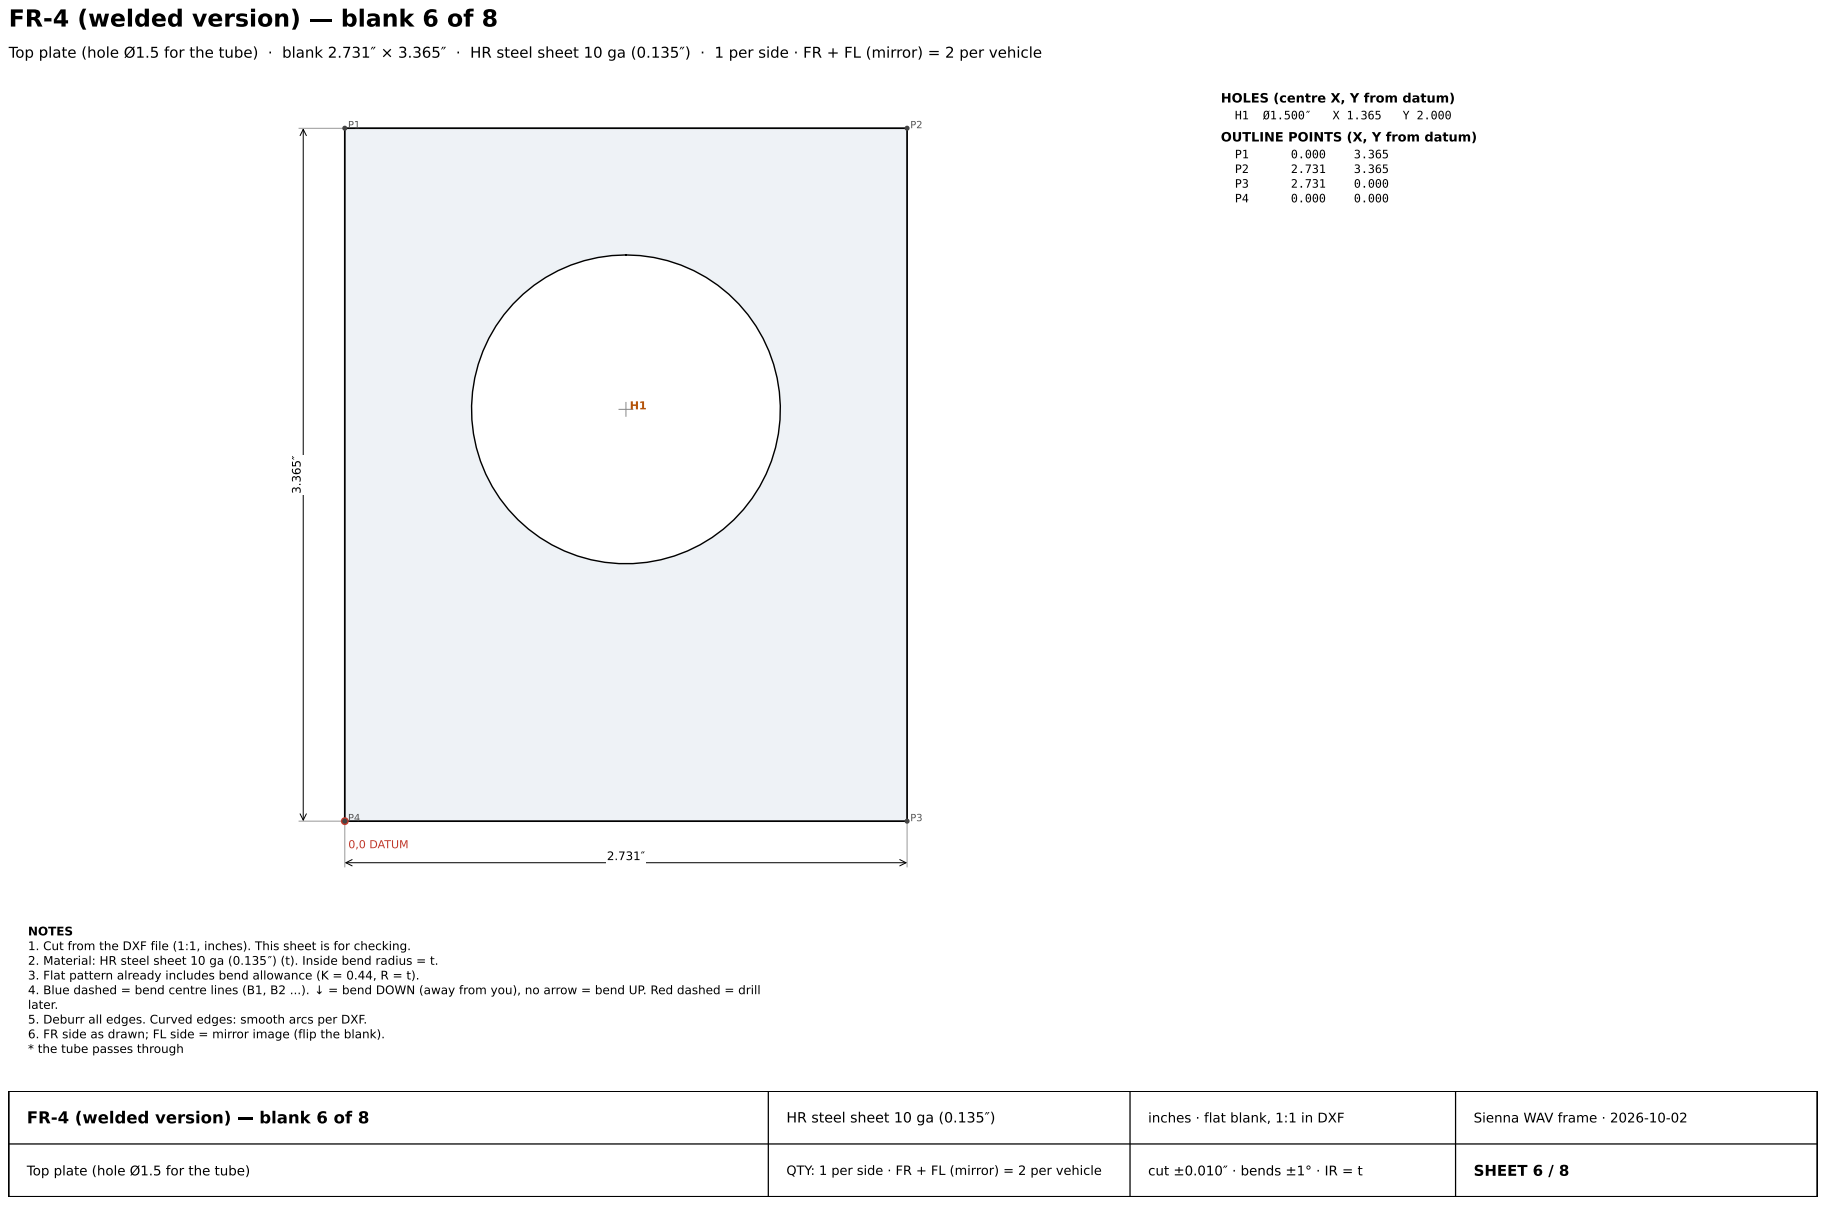
[picture p172: page 37]
0,0 DATUM; FR-4 (welded version); blank 6 of 8; SHEET 6 / 8; 4. Blue dashed = bend centre lines (B1, B2 ...).; = bend DOWN (away from you), no arrow = bend UP. Red dashed = drill

HOLES (centre X, Y from datum)
OUTLINE POINTS (X, Y from datum)

NOTES
1. Cut from the DXF file (1:1, inches). This sheet is for checking.
2. Material: HR steel sheet 10 ga (0.135 ) (t). Inside bend radius = t.
3. Flat pattern already includes bend allowance (K = 0.44, R = t).
later.
5. Deburr all edges. Curved edges: smooth arcs per DXF.
6. FR side as drawn; FL side = mirror image (flip the blank).
* the tube passes through

HR steel sheet 10 ga (0.135 )

inches · flat blank, 1:1 in DXF

Sienna WAV frame · 2026-10-02

Top plate (hole Ø1.5 for the tube)

# FR-4 (welded version) blank 7 of 8

Ear plate · blank 2.731 × 3.259 · HR steel sheet 10 ga (0.135 ) · 1 per side · FR + FL (mirror) = 2 per vehicle

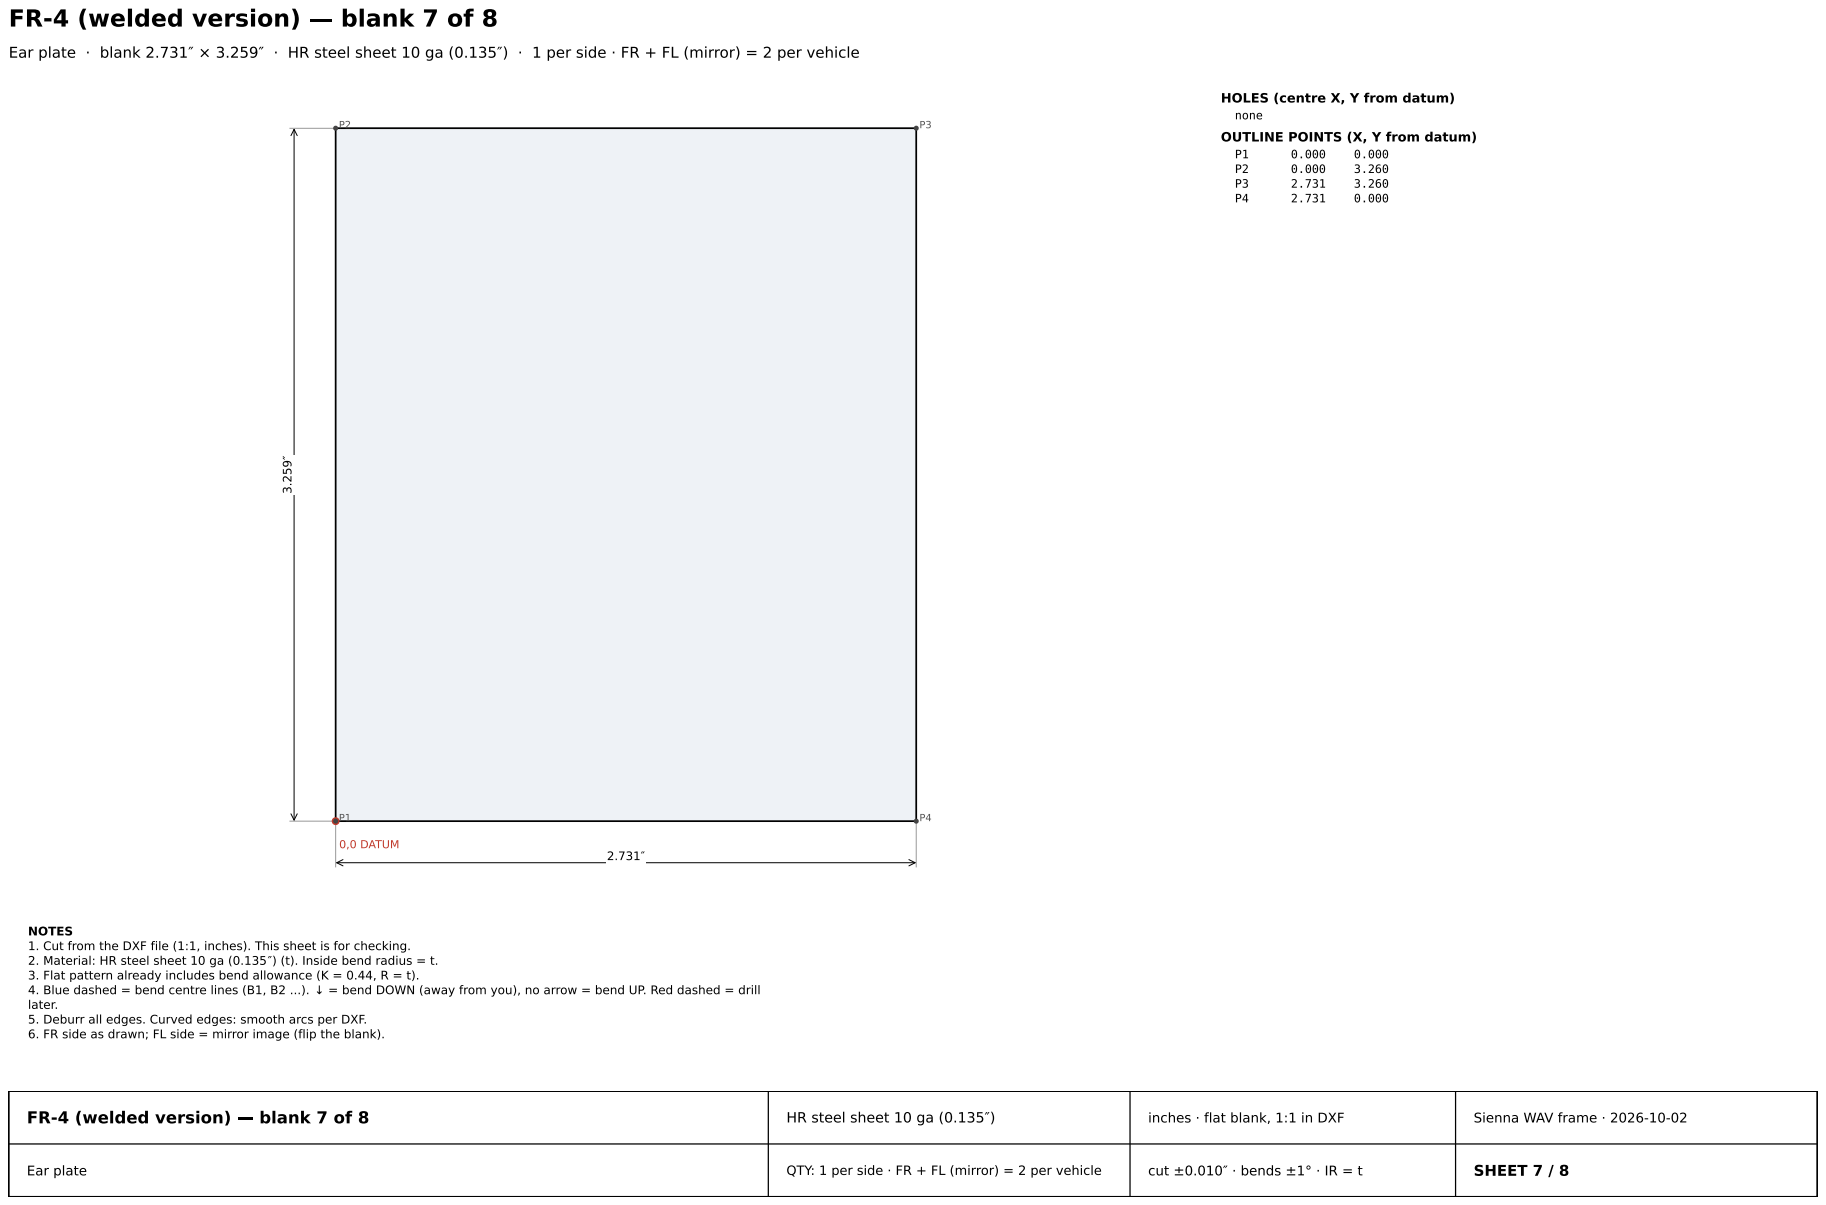
[picture p173: page 38]
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

HOLES (centre X, Y from datum)
none
OUTLINE POINTS (X, Y from datum)

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

FR-4 (welded version) blank 7 of 8 | HR steel sheet 10 ga (0.135 ) | inches · flat blank, 1:1 in DXF | Sienna WAV frame · 2026-10-02

Ear plate | | | SHEET 7 / 8
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
