diademal/nyc-tlc-wav/drawings/FR-5.pdf

# FR-5 (welded version) blank 1 of 2

Side plate · blank 4.849 × 6.483 · HR steel sheet 10 ga (0.135 ) · 2 per side · FR + FL (mirror) = 4 per vehicle

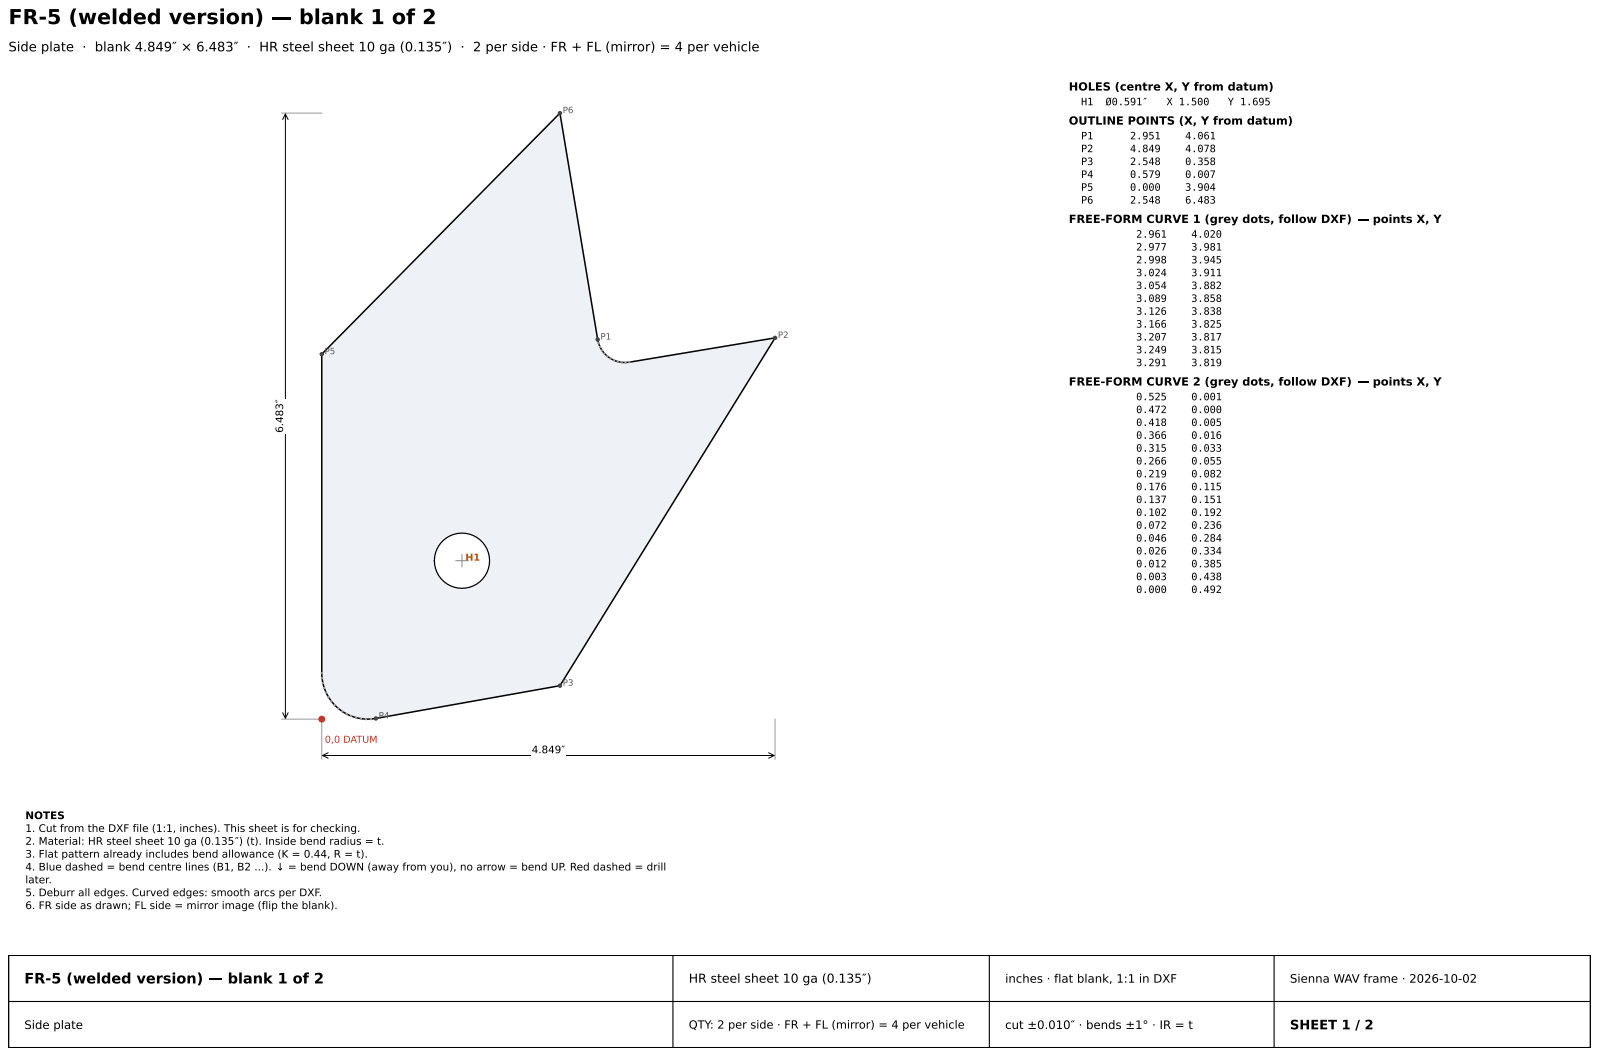
[picture p174: page 1]
0,0 DATUM; FR-5 (welded version); blank 1 of 2; Side plate; SHEET 1 / 2; FREE-FORM CURVE 1 (grey dots, follow DXF); points X, Y; FREE-FORM CURVE 2 (grey dots, follow DXF); 4. Blue dashed = bend centre lines (B1, B2 ...).; = bend DOWN (away from you), no arrow = bend UP. Red dashed = drill

HOLES (centre X, Y from datum)
OUTLINE POINTS (X, Y from datum)

NOTES
1. Cut from the DXF file (1:1, inches). This sheet is for checking.
2. Material: HR steel sheet 10 ga (0.135 ) (t). Inside bend radius = t.
3. Flat pattern already includes bend allowance (K = 0.44, R = t).
later.
5. Deburr all edges. Curved edges: smooth arcs per DXF.
6. FR side as drawn; FL side = mirror image (flip the blank).

HR steel sheet 10 ga (0.135 )

inches · flat blank, 1:1 in DXF

Sienna WAV frame · 2026-10-02

QTY: 2 per side · FR + FL (mirror) = 4 per vehicle

cut ±0.010 · bends ±1° · IR = t

# FR-5 (welded version) blank 2 of 2

Plate on edge A-C · blank 3.625 × 2.231 · HR steel sheet 10 ga (0.135 ) · 1 per side · FR + FL (mirror) = 2 per vehicle

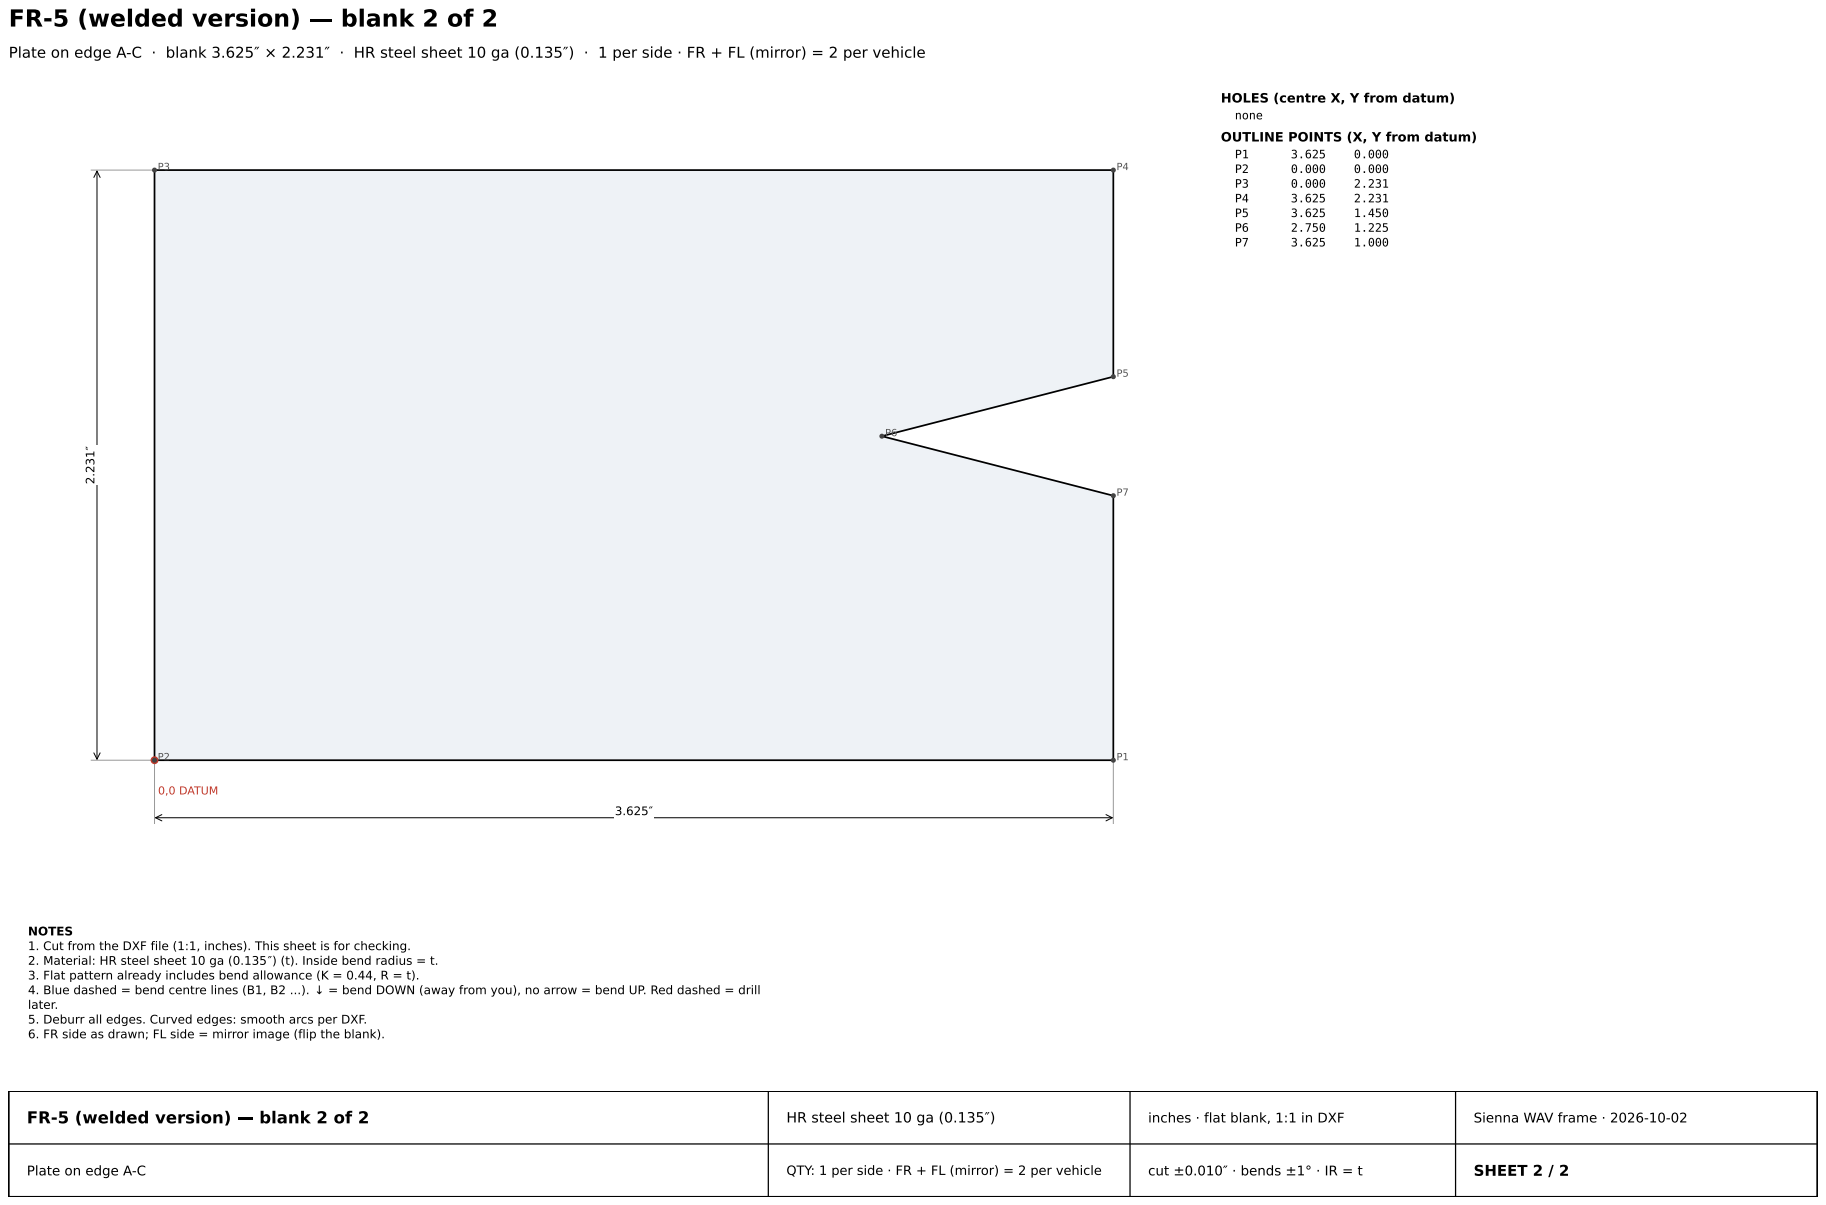
[picture p175: page 2]
0,0 DATUM; 4. Blue dashed = bend centre lines (B1, B2 ...).; = bend DOWN (away from you), no arrow = bend UP. Red dashed = drill

HOLES (centre X, Y from datum)
none
OUTLINE POINTS (X, Y from datum)

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

FR-5 (welded version) blank 2 of 2 | HR steel sheet 10 ga (0.135 ) | inches · flat blank, 1:1 in DXF | Sienna WAV frame · 2026-10-02

Plate on edge A-C | QTY: 1 per side · FR + FL (mirror) = 2 per vehicle | cut ±0.010 · bends ±1° · IR = t | SHEET 2 / 2
