diademal/nyc-tlc-wav/drawings/FR-7.pdf

# FR-7 (welded version) blank 1 of 3

Side plate with tab · blank 3.750 × 5.000 · HR steel sheet 10 ga (0.135 ) · 2 per side · FR + FL (mirror) = 4 per vehicle

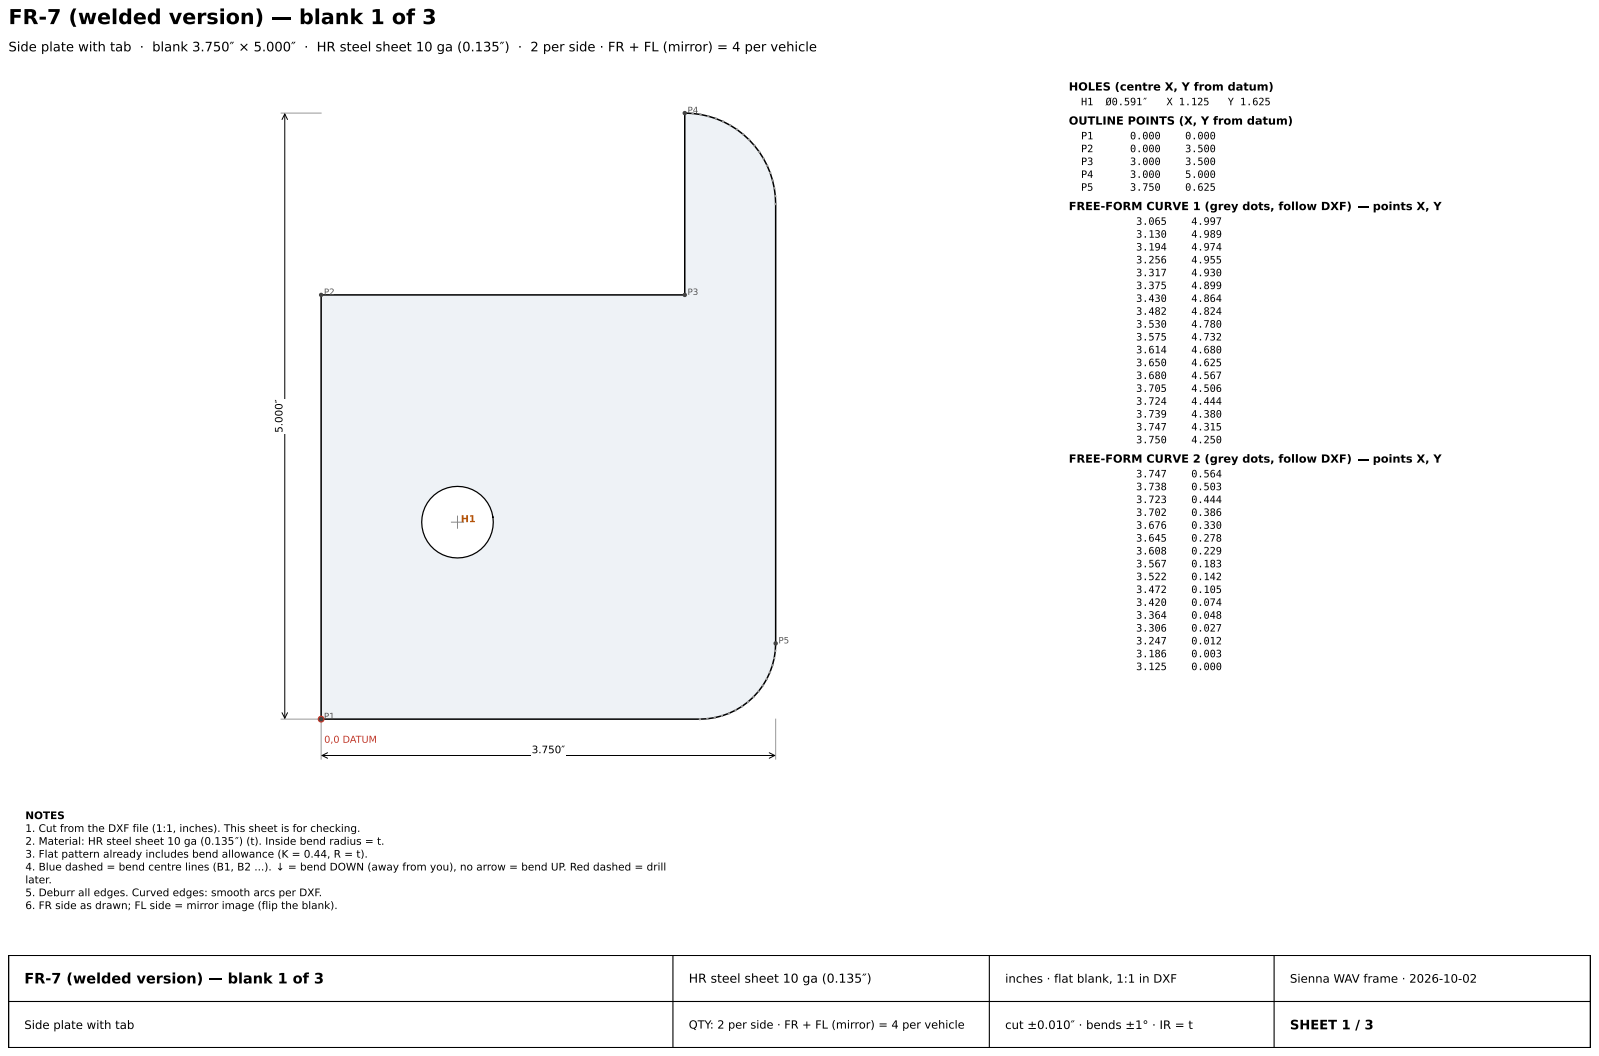
[picture p176: page 1]
0,0 DATUM; FR-7 (welded version); blank 1 of 3; SHEET 1 / 3; FREE-FORM CURVE 1 (grey dots, follow DXF); points X, Y; FREE-FORM CURVE 2 (grey dots, follow DXF); 4. Blue dashed = bend centre lines (B1, B2 ...).; = bend DOWN (away from you), no arrow = bend UP. Red dashed = drill

HOLES (centre X, Y from datum)
OUTLINE POINTS (X, Y from datum)

NOTES
1. Cut from the DXF file (1:1, inches). This sheet is for checking.
2. Material: HR steel sheet 10 ga (0.135 ) (t). Inside bend radius = t.
3. Flat pattern already includes bend allowance (K = 0.44, R = t).
later.
5. Deburr all edges. Curved edges: smooth arcs per DXF.
6. FR side as drawn; FL side = mirror image (flip the blank).

HR steel sheet 10 ga (0.135 )

inches · flat blank, 1:1 in DXF

Sienna WAV frame · 2026-10-02

Side plate with tab

QTY: 2 per side · FR + FL (mirror) = 4 per vehicle

cut ±0.010 · bends ±1° · IR = t

# FR-7 (welded version) blank 2 of 3

Bottom plate · blank 2.231 × 3.125 · HR steel sheet 10 ga (0.135 ) · 1 per side · FR + FL (mirror) = 2 per vehicle

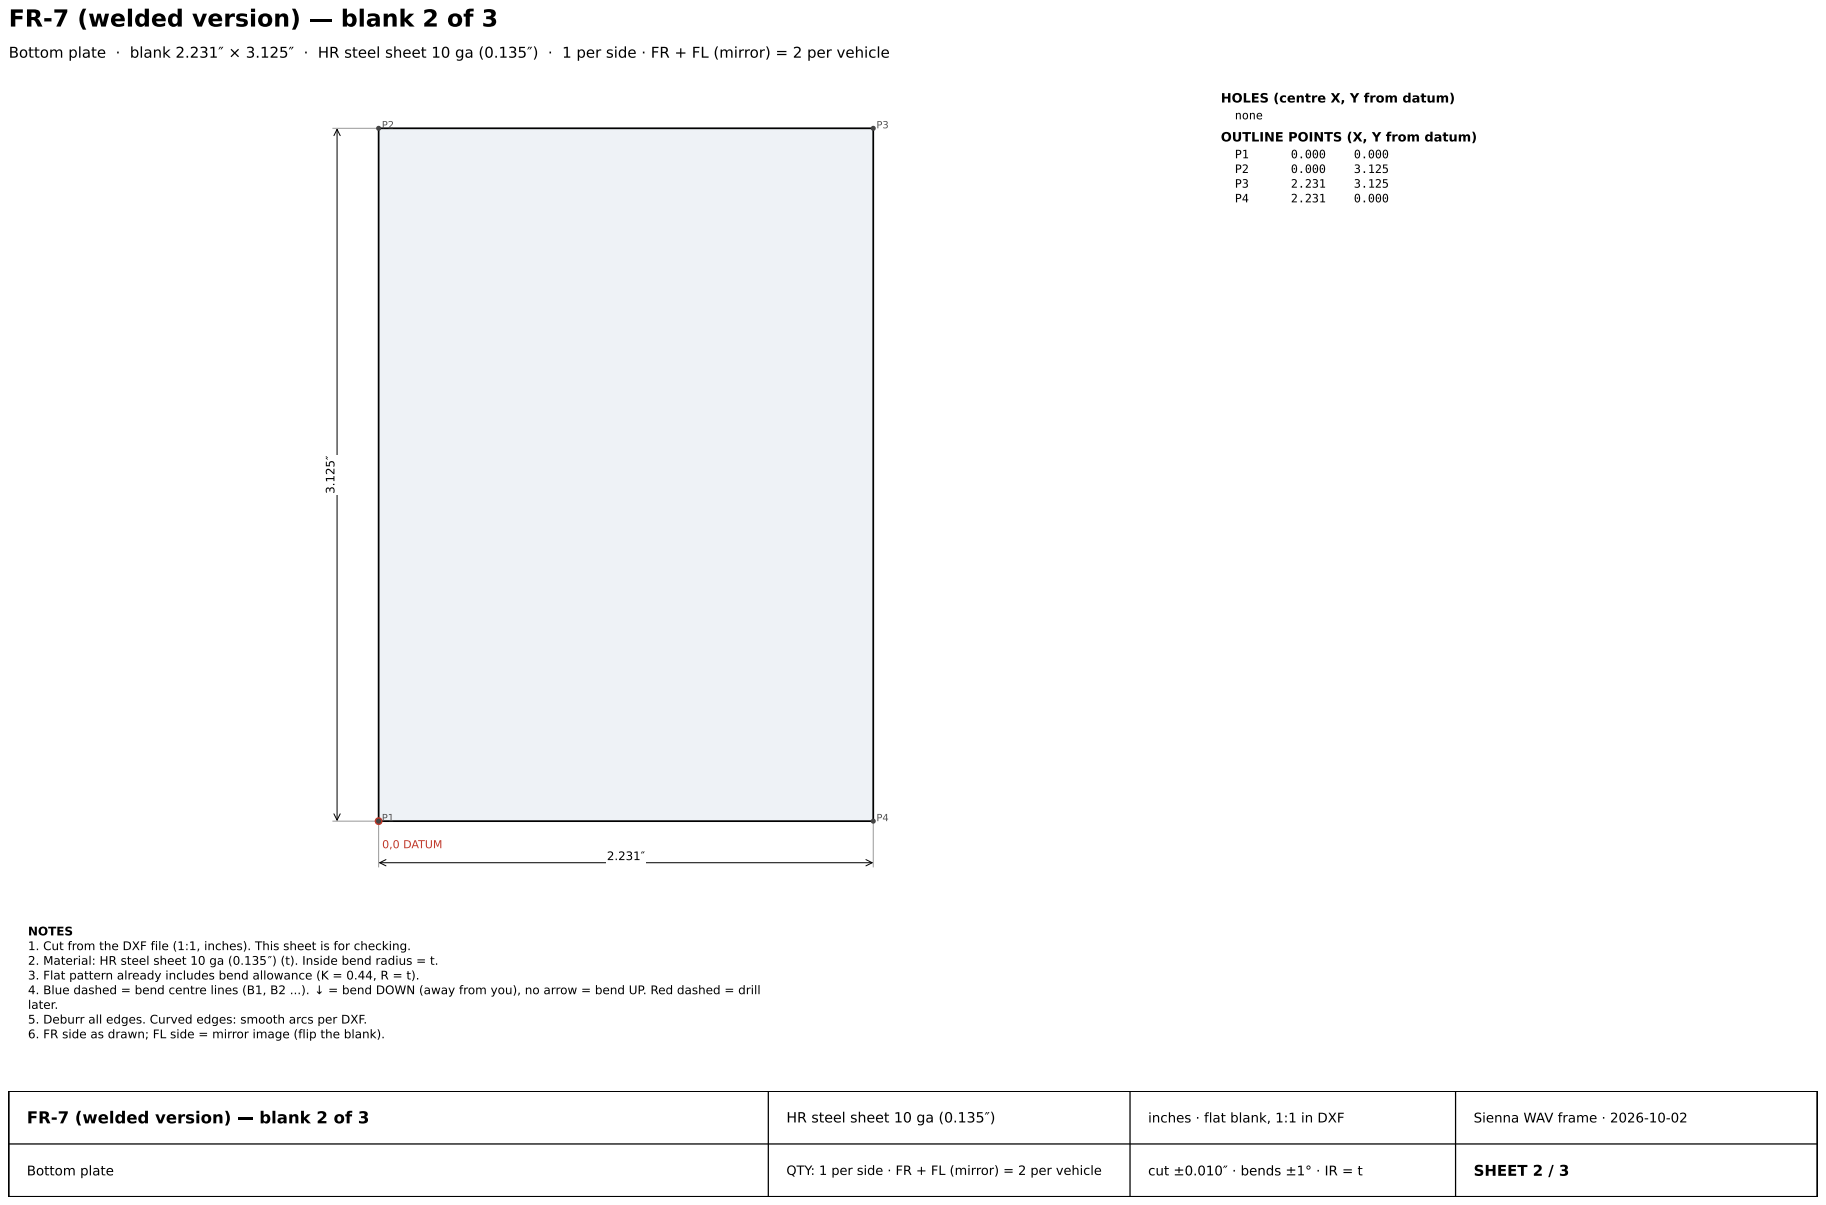
[picture p177: page 2]
0,0 DATUM; 4. Blue dashed = bend centre lines (B1, B2 ...).; = bend DOWN (away from you), no arrow = bend UP. Red dashed = drill

HOLES (centre X, Y from datum)
none
OUTLINE POINTS (X, Y from datum)

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

FR-7 (welded version) blank 2 of 3 | HR steel sheet 10 ga (0.135 ) | inches · flat blank, 1:1 in DXF | Sienna WAV frame · 2026-10-02

Bottom plate | QTY: 1 per side · FR + FL (mirror) = 2 per vehicle | | SHEET 2 / 3

# FR-7 (welded version) blank 3 of 3

Back plate (hole Ø0.5) · blank 2.231 × 3.625 · HR steel sheet 10 ga (0.135 ) · 1 per side · FR + FL (mirror) = 2 per vehicle

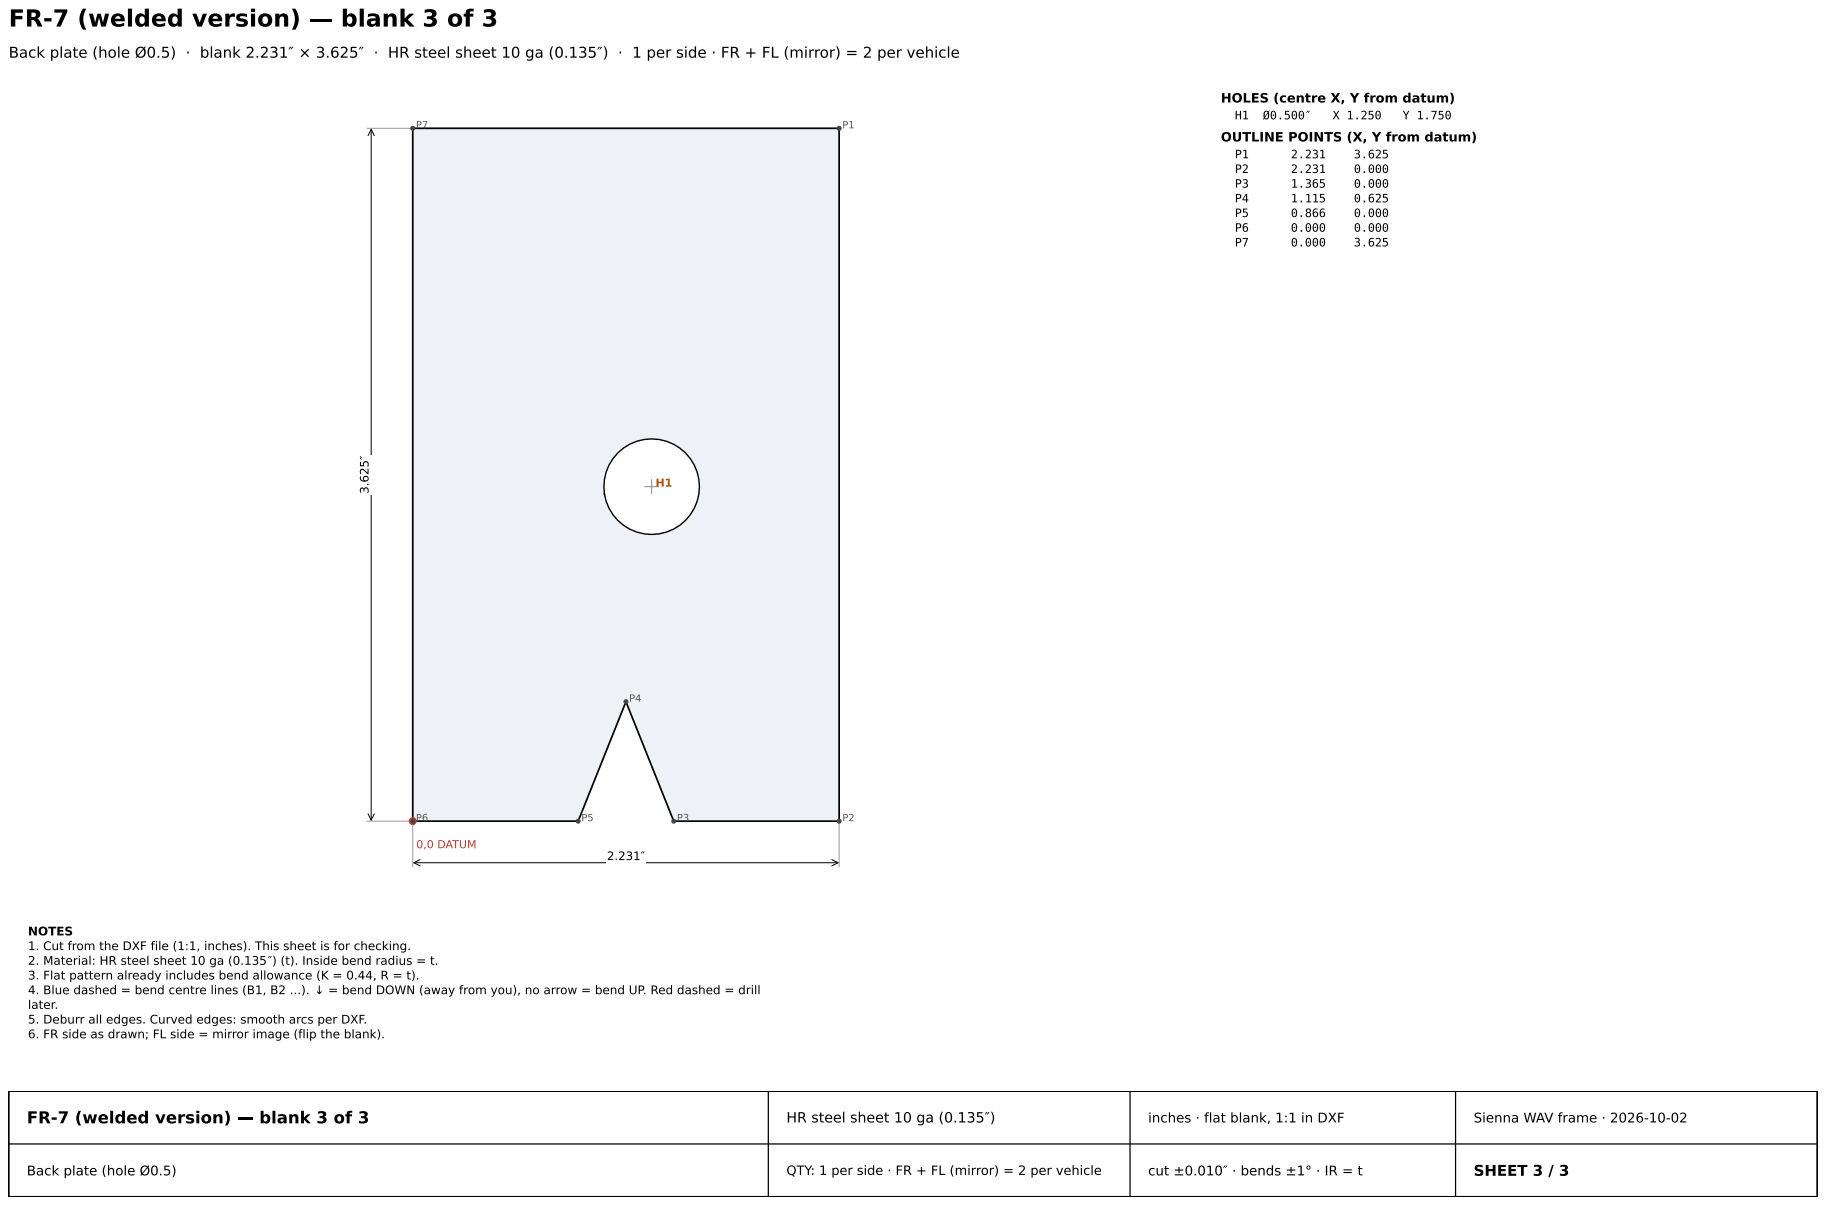
[picture p178: page 3]
0,0 DATUM; FR-7 (welded version); blank 3 of 3; SHEET 3 / 3; 4. Blue dashed = bend centre lines (B1, B2 ...).; = bend DOWN (away from you), no arrow = bend UP. Red dashed = drill

HOLES (centre X, Y from datum)
OUTLINE POINTS (X, Y from datum)

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

HR steel sheet 10 ga (0.135 )

inches · flat blank, 1:1 in DXF

Sienna WAV frame · 2026-10-02

Back plate (hole Ø0.5)

QTY: 1 per side · FR + FL (mirror) = 2 per vehicle
