diademal/nyc-tlc-wav/drawings/FR-8.pdf

# FR-8 (welded version) blank 1 of 2

Side plate with arc · blank 12.000 × 1.875 · HR steel sheet 11 ga (0.120 ) · 2 per side · FR + FL (mirror) = 4 per vehicle

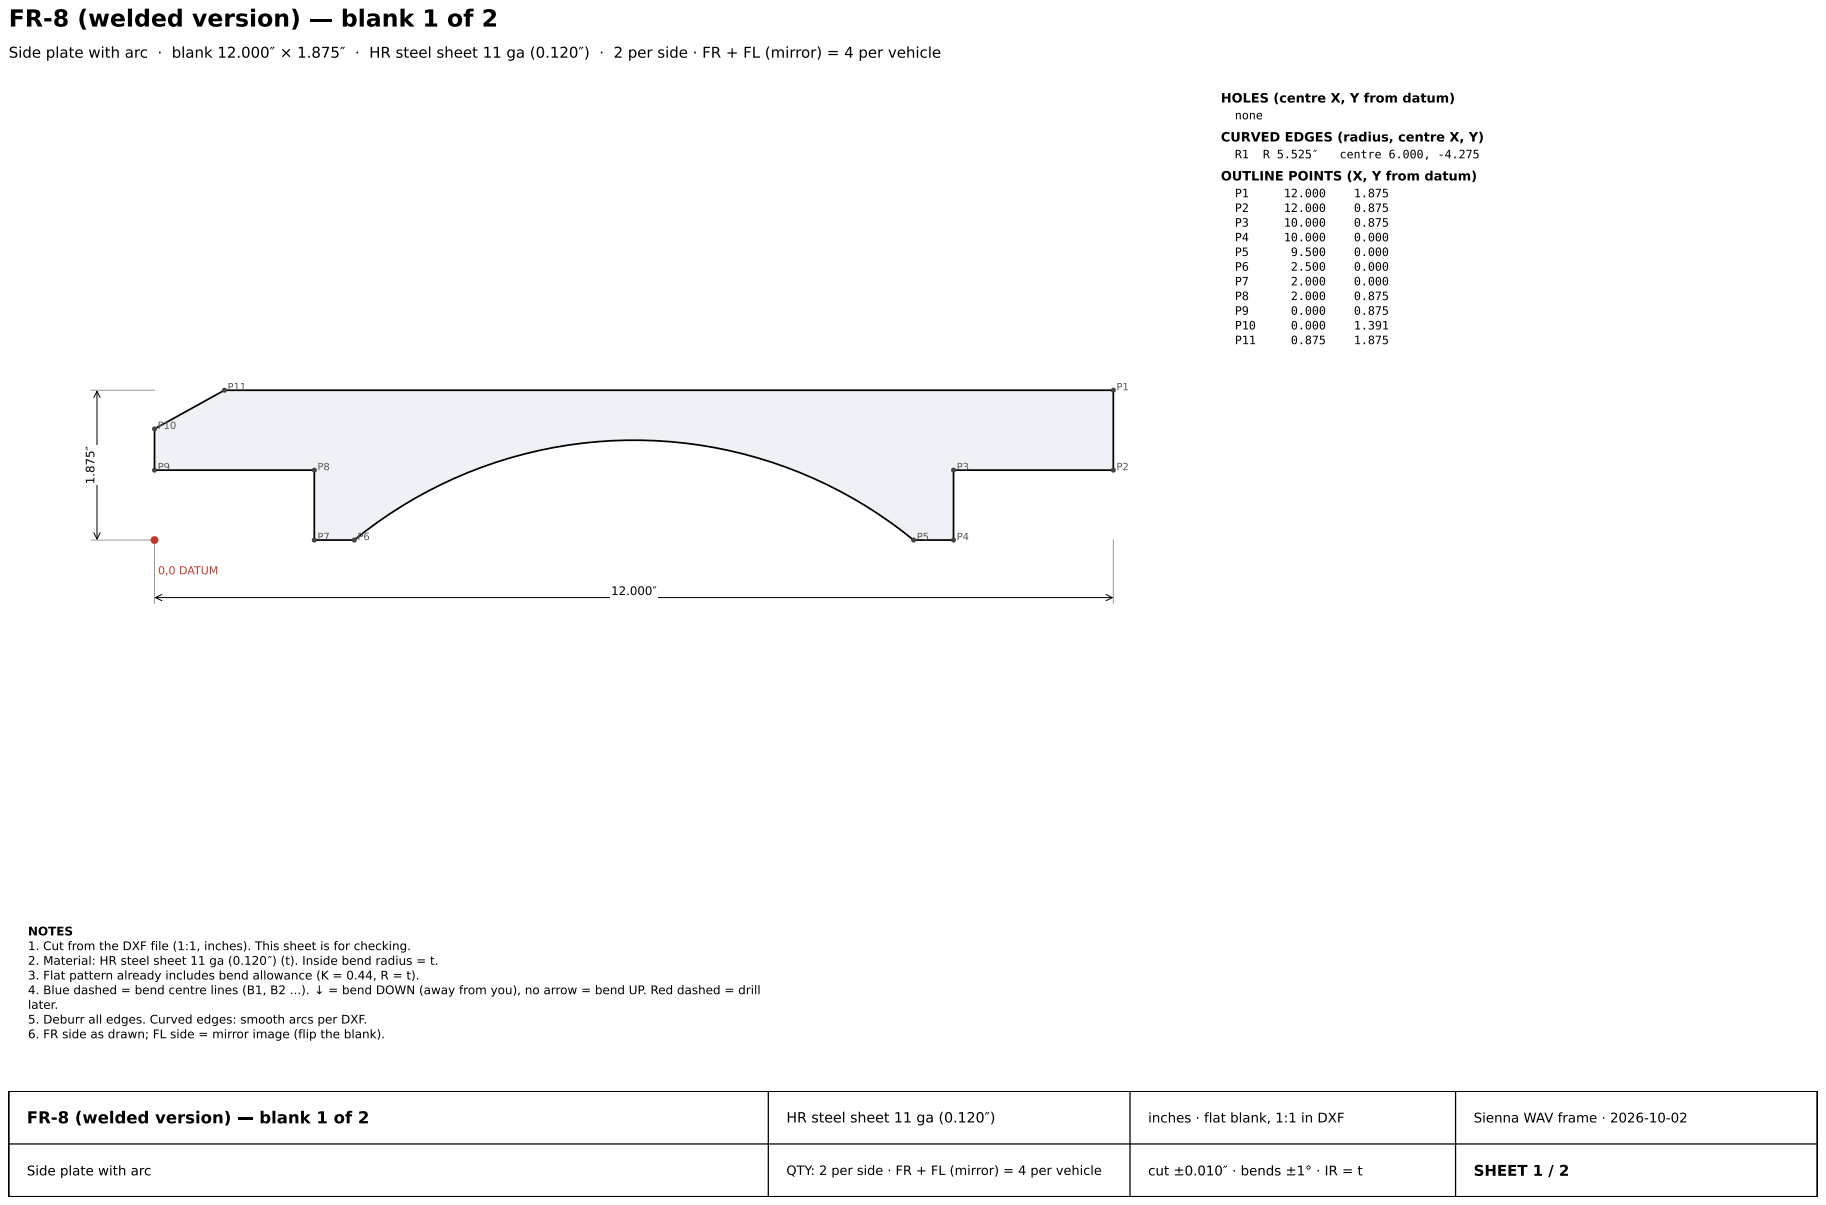
[picture p179: page 1]

HOLES (centre X, Y from datum)
none
CURVED EDGES (radius, centre X, Y)
OUTLINE POINTS (X, Y from datum)

NOTES
1. Cut from the DXF file (1:1, inches). This sheet is for checking.
2. Material: HR steel sheet 11 ga (0.120 ) (t). Inside bend radius = t.
3. Flat pattern already includes bend allowance (K = 0.44, R = t).
later.
5. Deburr all edges. Curved edges: smooth arcs per DXF.
6. FR side as drawn; FL side = mirror image (flip the blank).

FR-8 (welded version) blank 1 of 2 | HR steel sheet 11 ga (0.120 ) | inches · flat blank, 1:1 in DXF | Sienna WAV frame · 2026-10-02

Side plate with arc | QTY: 2 per side · FR + FL (mirror) = 4 per vehicle | cut ±0.010 · bends ±1° · IR = t | SHEET 1 / 2

# FR-8 (welded version) blank 2 of 2

Top plate · blank 2.636 × 11.125 · HR steel sheet 11 ga (0.120 ) · 1 per side · FR + FL (mirror) = 2 per vehicle

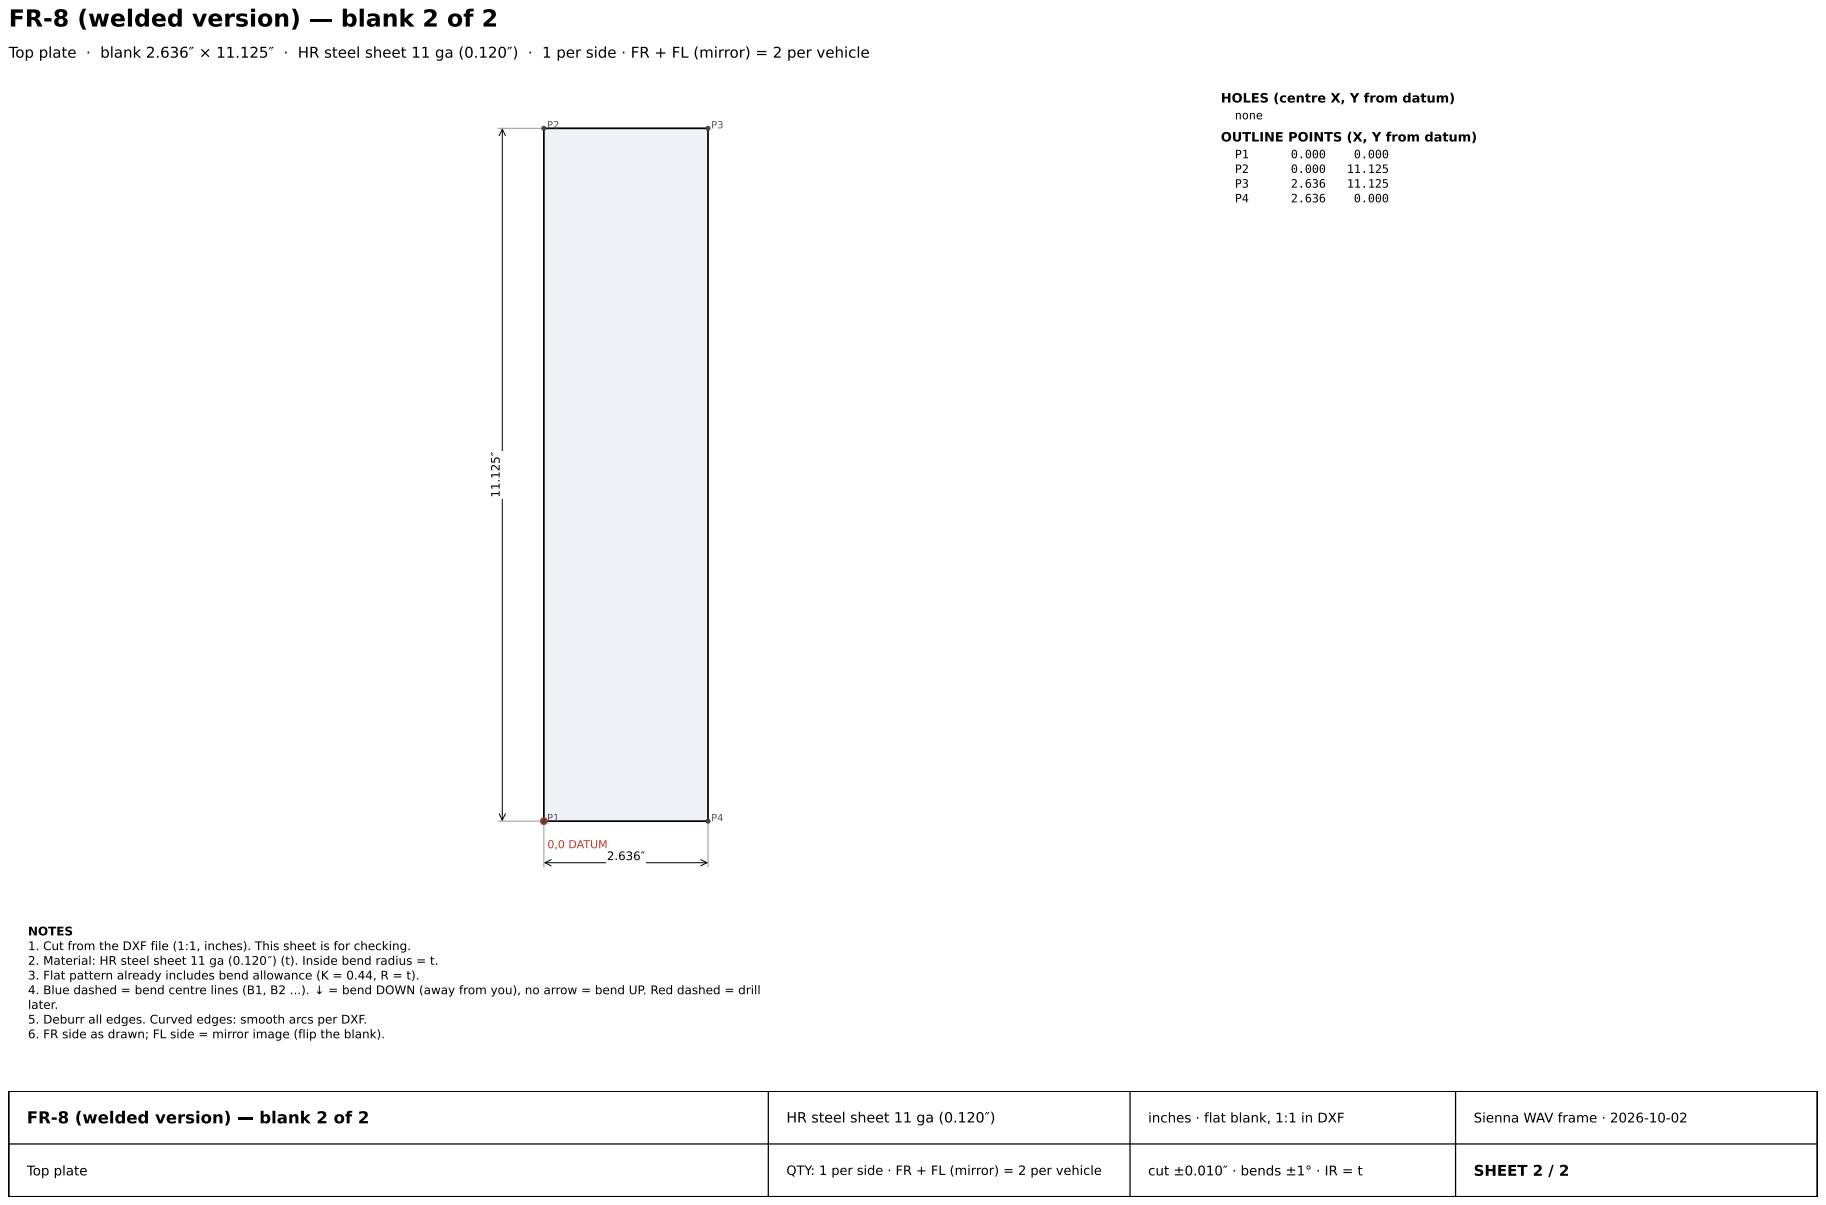
[picture p180: page 2]
0,0 DATUM; 4. Blue dashed = bend centre lines (B1, B2 ...).; = bend DOWN (away from you), no arrow = bend UP. Red dashed = drill

HOLES (centre X, Y from datum)
none
OUTLINE POINTS (X, Y from datum)

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

FR-8 (welded version) blank 2 of 2 | HR steel sheet 11 ga (0.120 ) | inches · flat blank, 1:1 in DXF | Sienna WAV frame · 2026-10-02

Top plate | QTY: 1 per side · FR + FL (mirror) = 2 per vehicle | cut ±0.010 · bends ±1° · IR = t | SHEET 2 / 2
