diademal/nyc-tlc-wav/drawings/LASER/ALUMINUM_0.125_sheet1_of1_48x96.pdf

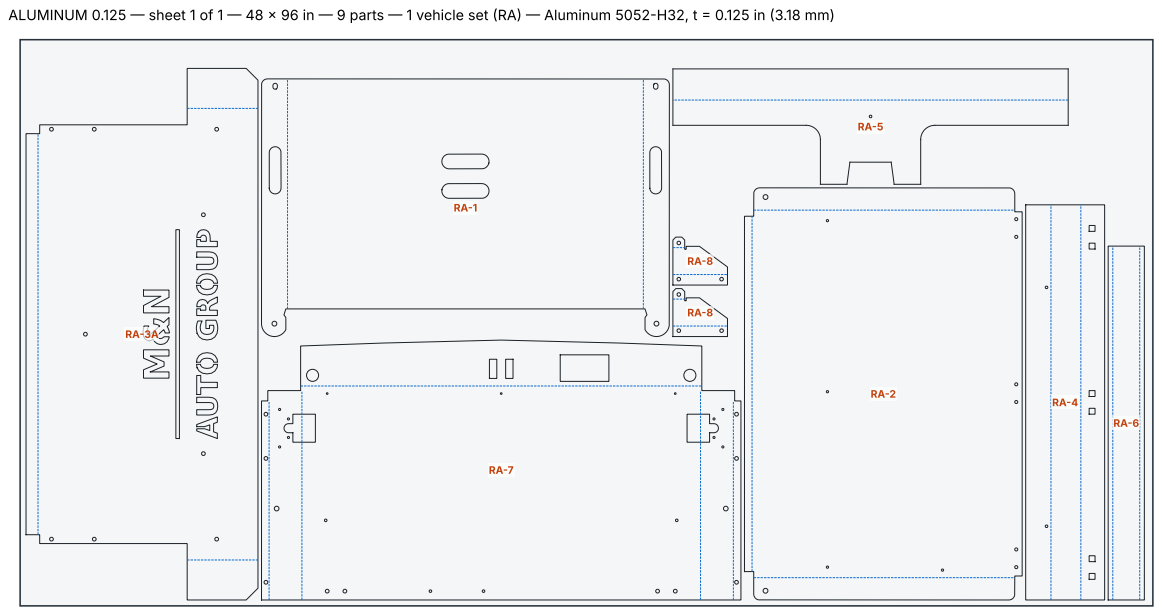
[picture p181: page 1]

ALUMINUM 0.125 — sheet 1 of 1 — 48 x 96 in — 9 parts — 1 vehicle set (RA) — Aluminum 5052-H32, t = 0.125 in (3.18 mm)
