diademal/nyc-tlc-wav/drawings/LASER/STEEL_11ga_sheet1_of1_48x96.pdf

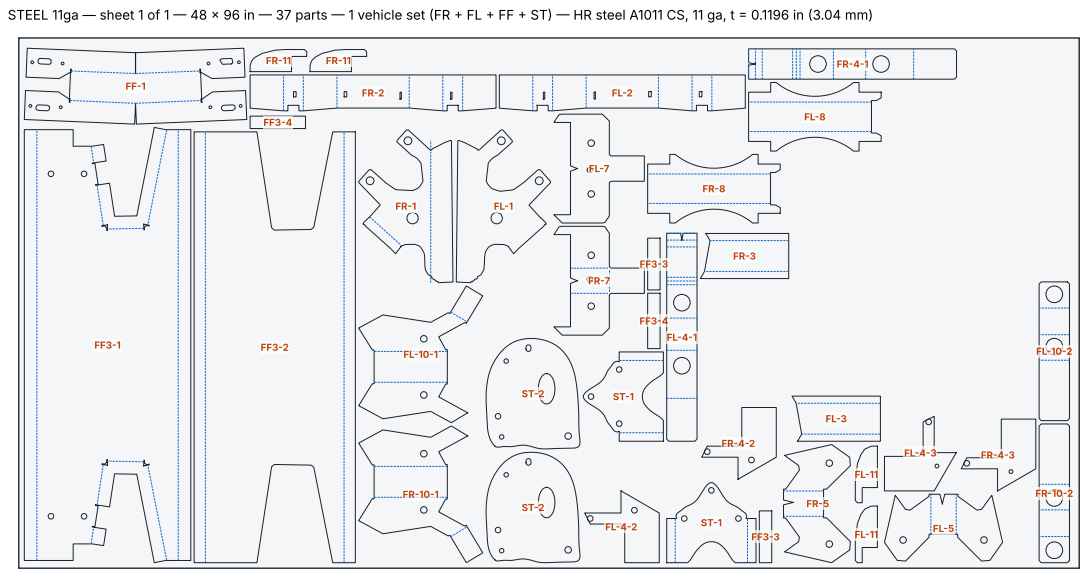
[picture p182: page 1]

STEEL 11ga — sheet 1 of 1 — 48 x 96 in — 37 parts — 1 vehicle set (FR + FL + FF + ST) — HR steel A1011 CS, 11 ga, t = 0.1196 in (3.04 mm)
