diademal/nyc-tlc-wav/drawings/MFG/RA-3A_drawing.pdf

FLAT PATTERN (laser) — bend lines dashed | Finished part (outside dims)

## RA-3A — RA-3 plate with the M&N / AUTO GROUP text cut (reads from the street, ears down)

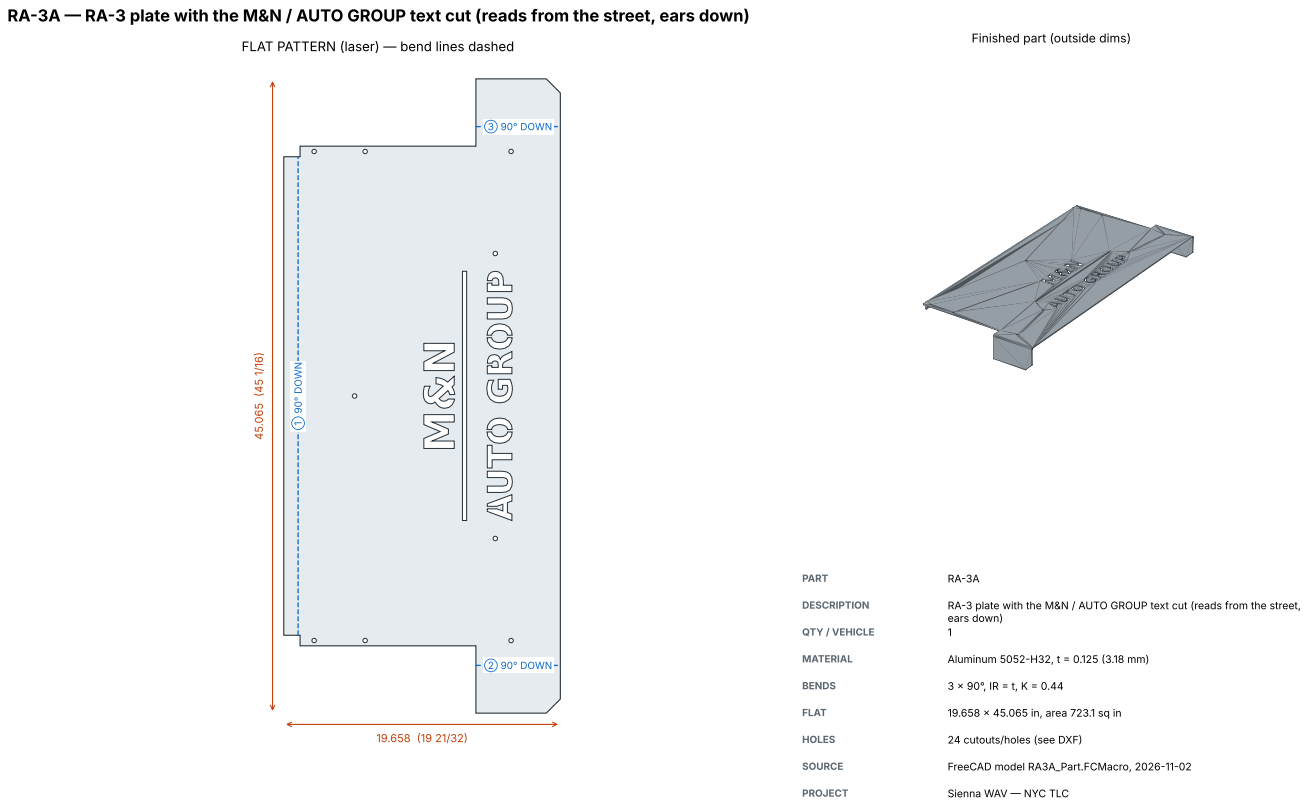
[picture p183: page 1]
① 90° DOWN; ② 90° DOWN; ③ 90° DOWN; PART; DESCRIPTION; RA-3 plate with the M&N / AUTO GROUP text cut (reads from the street,; ears down); QTY / VEHICLE; MATERIAL; Aluminum 5052-H32, t = 0.125 (3.18 mm); BENDS; FLAT; 19.658 x 45.065 in, area 723.1 sq in; HOLES; 24 cutouts/holes (see DXF); SOURCE; FreeCAD model RA3A_Part.FCMacro, 2026-11-02; PROJECT; Sienna WAV — NYC TLC
