diademal/nyc-tlc-wav/drawings/MFG/RA-3B_drawing.pdf

FLAT PATTERN (laser) — bend lines dashed | Finished part (outside dims)

## RA-3B — RA-3 plate with the M&N / AUTO GROUP text + wheelchair cut (ears down)

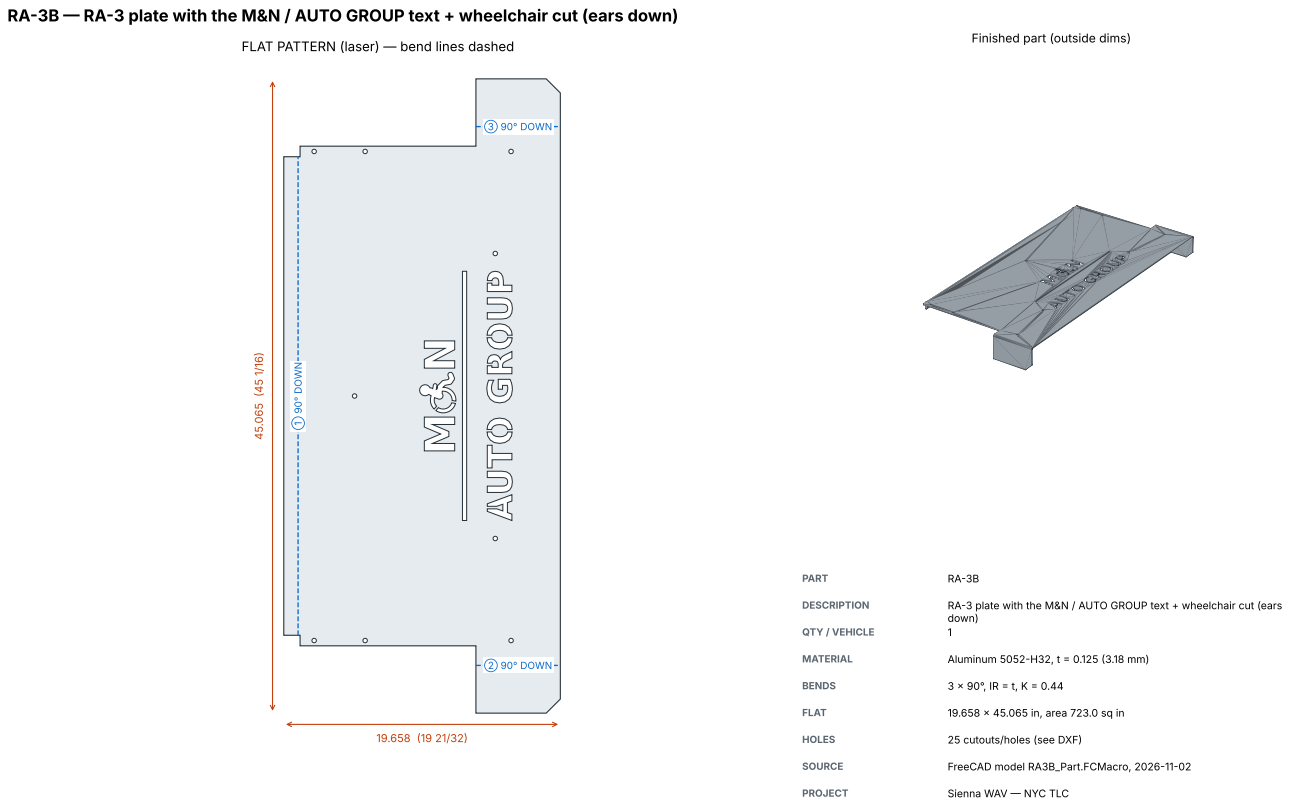
[picture p184: page 1]
① 90° DOWN; ② 90° DOWN; ③ 90° DOWN; PART; DESCRIPTION; RA-3 plate with the M&N / AUTO GROUP text + wheelchair cut (ears; down); QTY / VEHICLE; MATERIAL; Aluminum 5052-H32, t = 0.125 (3.18 mm); BENDS; FLAT; 19.658 x 45.065 in, area 723.0 sq in; HOLES; 25 cutouts/holes (see DXF); SOURCE; FreeCAD model RA3B_Part.FCMacro, 2026-11-02; PROJECT; Sienna WAV — NYC TLC
