diademal/nyc-tlc-wav/drawings/MFG/RA-9_drawing.pdf

### FLAT PATTERN (laser) — bend lines dashed

RA-9 — Stainless backing plate behind the RA-3L logo cut, 18 ga 304 brushed, on the two RA-3 8 mm bolts below the name

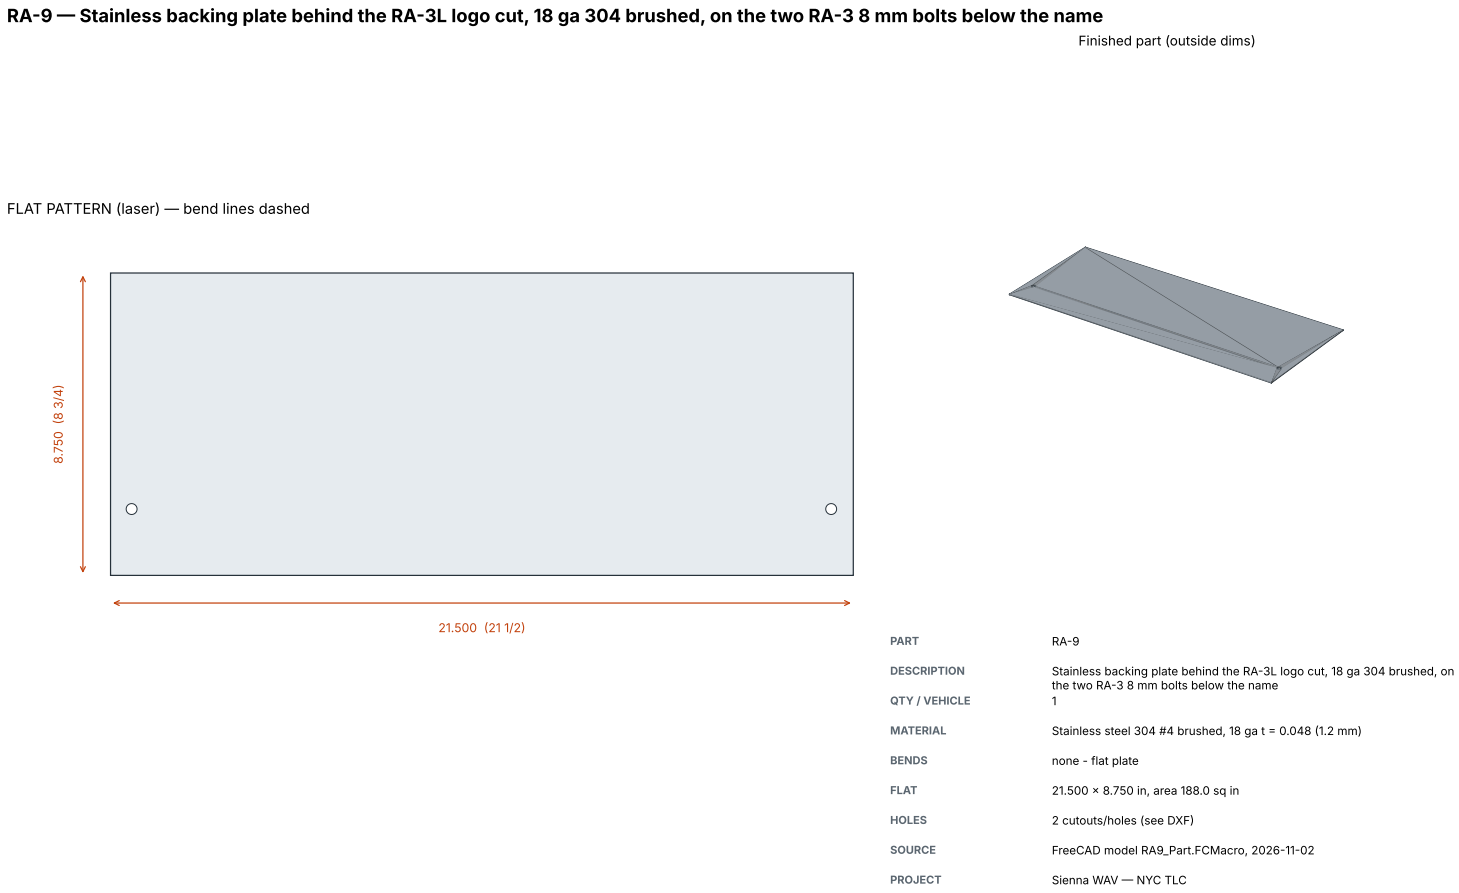
[picture p185: page 1]
PART; DESCRIPTION; Stainless backing plate behind the RA-3L logo cut, 18 ga 304 brushed, on; QTY / VEHICLE; MATERIAL; Stainless steel 304 #4 brushed, 18 ga t = 0.048 (1.2 mm); BENDS; none - flat plate; FLAT; 21.500 x 8.750 in, area 188.0 sq in; HOLES; 2 cutouts/holes (see DXF); SOURCE; FreeCAD model RA9_Part.FCMacro, 2026-11-02; PROJECT; Sienna WAV — NYC TLC

Finished part (outside dims)

the two RA-3 8 mm bolts below the name
