diademal/nyc-tlc-wav/drawings/MFG/RA-1_drawing.pdf

FLAT PATTERN (laser) — bend lines dashed | Finished part (outside dims)

## RA-1 — Ramp plate with ears (hinge lugs R 1 3/32)

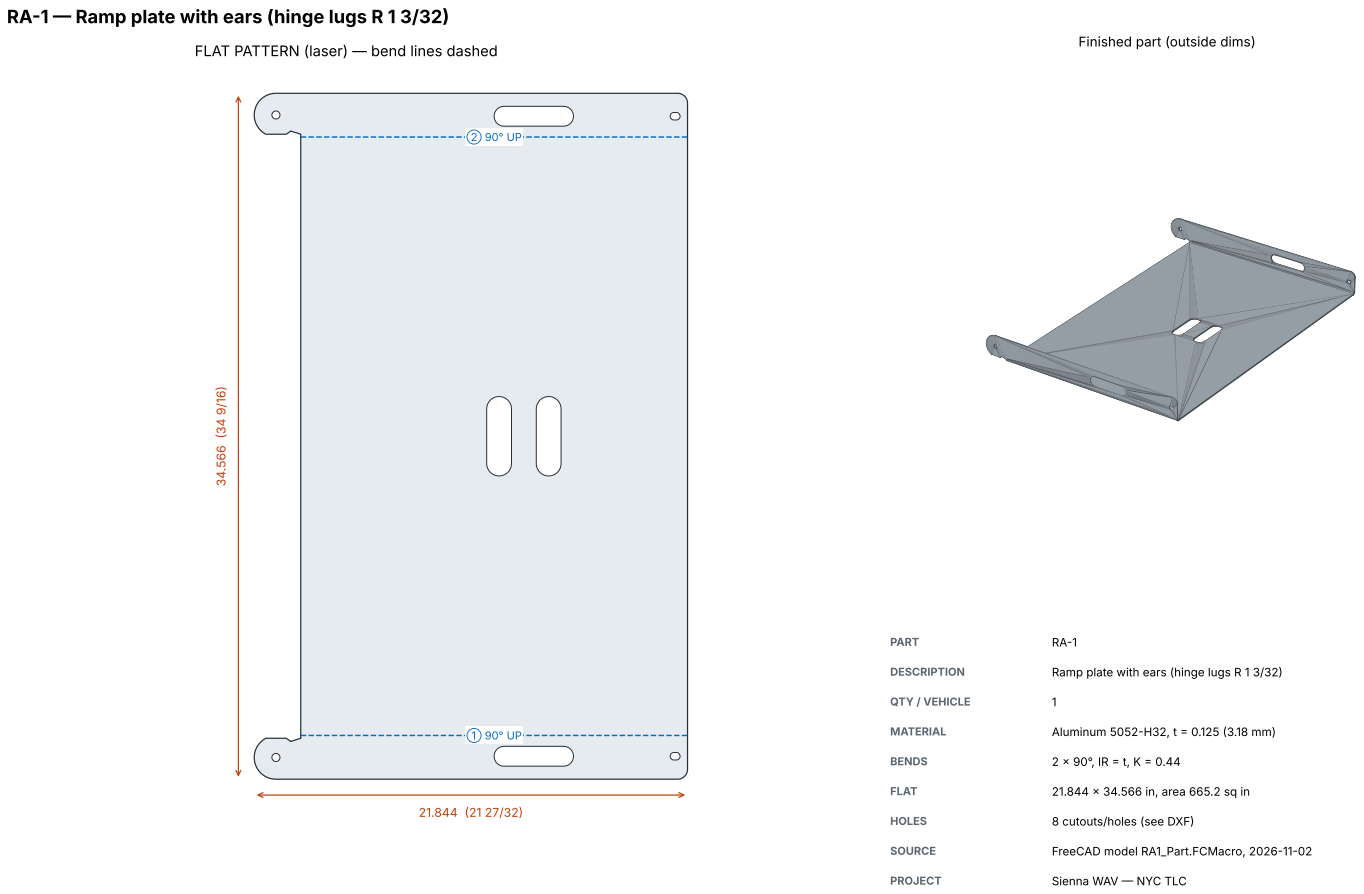
[picture p187: page 1]
PART; DESCRIPTION; Ramp plate with ears (hinge lugs R 1 3/32); QTY / VEHICLE; MATERIAL; Aluminum 5052-H32, t = 0.125 (3.18 mm); BENDS; FLAT; 21.844 x 34.566 in, area 665.2 sq in; HOLES; 8 cutouts/holes (see DXF); SOURCE; FreeCAD model RA1_Part.FCMacro, 2026-11-02; PROJECT; Sienna WAV — NYC TLC
