diademal/nyc-tlc-wav/drawings/MFG/RA-2_drawing.pdf

FLAT PATTERN (laser) — bend lines dashed | Finished part (outside dims)

## RA-2 — Ramp plate: flange 3/4 + 2 ears 2, all bends down

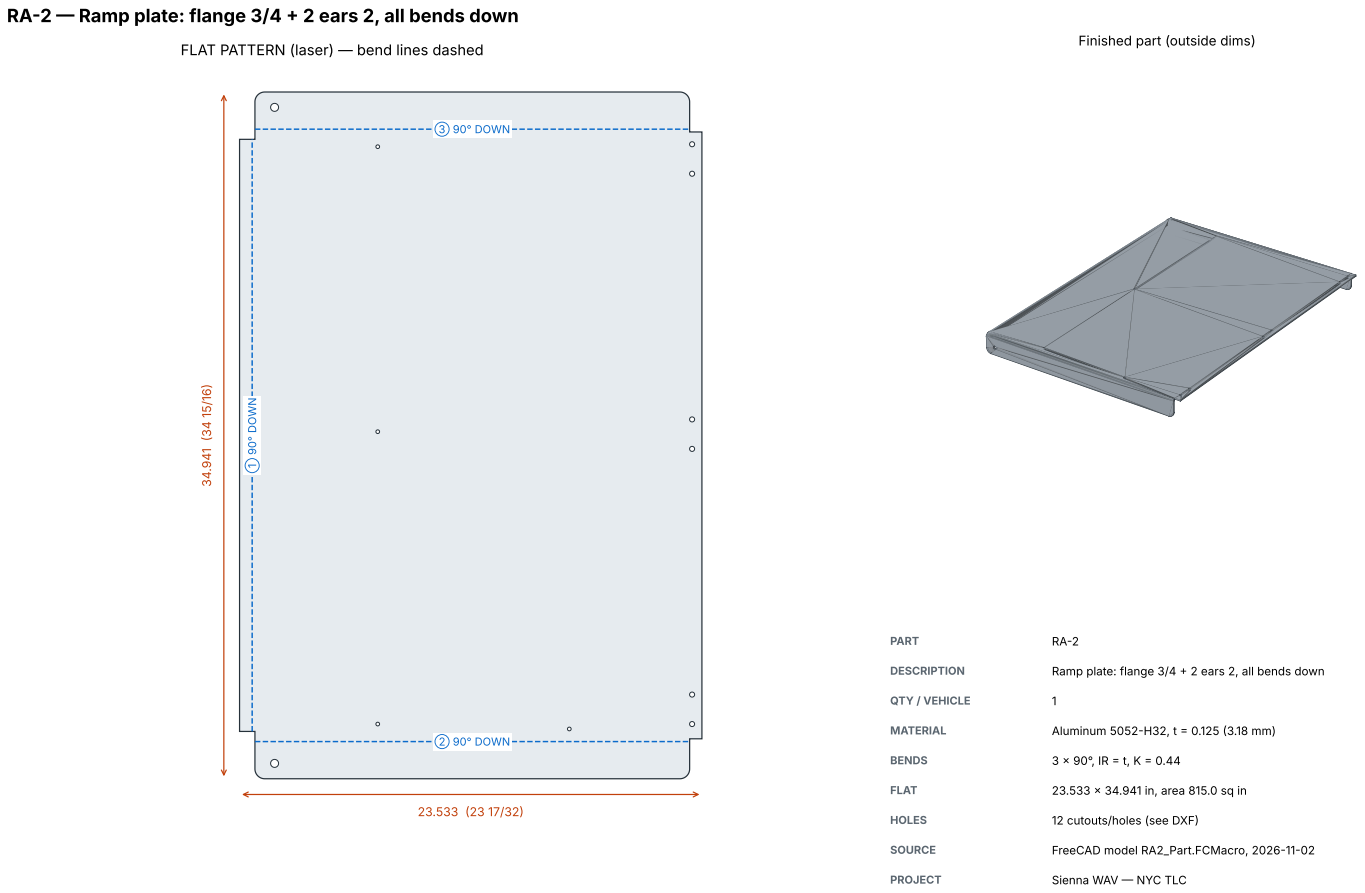
[picture p188: page 1]
① 90° DOWN; ② 90° DOWN; ③ 90° DOWN; PART; DESCRIPTION; Ramp plate: flange 3/4 + 2 ears 2, all bends down; QTY / VEHICLE; MATERIAL; Aluminum 5052-H32, t = 0.125 (3.18 mm); BENDS; FLAT; 23.533 x 34.941 in, area 815.0 sq in; HOLES; 12 cutouts/holes (see DXF); SOURCE; FreeCAD model RA2_Part.FCMacro, 2026-11-02; PROJECT; Sienna WAV — NYC TLC
