diademal/nyc-tlc-wav/drawings/MFG/RA-4_drawing.pdf

FLAT PATTERN (laser) — bend lines dashed | Finished part (outside dims)

## RA-4 — Z-section 2 1/4 / 2 3/4 / 2 1/8, L 33 1/2: 2 1/8 (squares) UP, 2 1/4 (bolts) DOWN

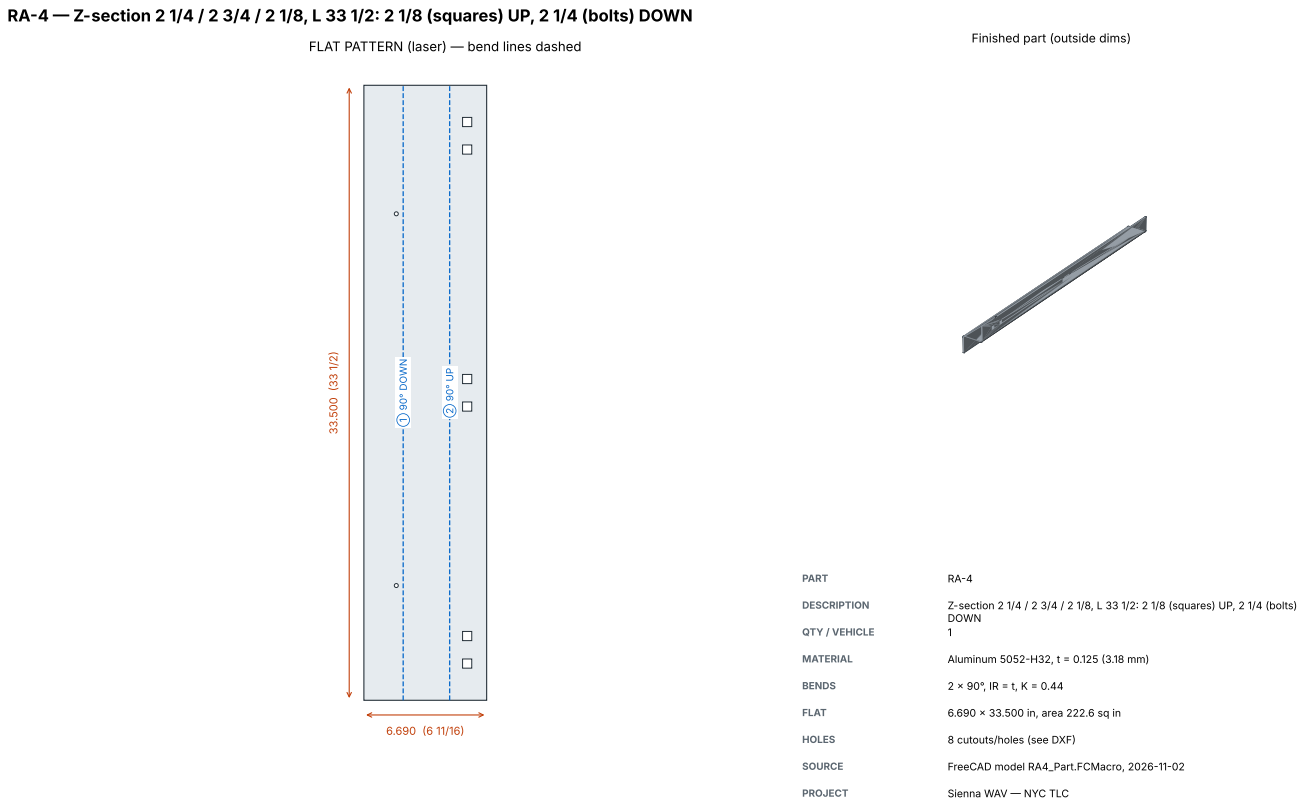
[picture p189: page 1]
① 90° DOWN; PART; DESCRIPTION; Z-section 2 1/4 / 2 3/4 / 2 1/8, L 33 1/2: 2 1/8 (squares) UP, 2 1/4 (bolts); DOWN; QTY / VEHICLE; MATERIAL; Aluminum 5052-H32, t = 0.125 (3.18 mm); BENDS; FLAT; 6.690 x 33.500 in, area 222.6 sq in; HOLES; 8 cutouts/holes (see DXF); SOURCE; FreeCAD model RA4_Part.FCMacro, 2026-11-02; PROJECT; Sienna WAV — NYC TLC
