diademal/nyc-tlc-wav/drawings/MFG/RA-7_drawing.pdf

### FLAT PATTERN (laser) — bend lines dashed

## RA-7 — Box 34 x 18 1/4: 2 side walls 3 + lips 3/4 outward, front wall; no front lip

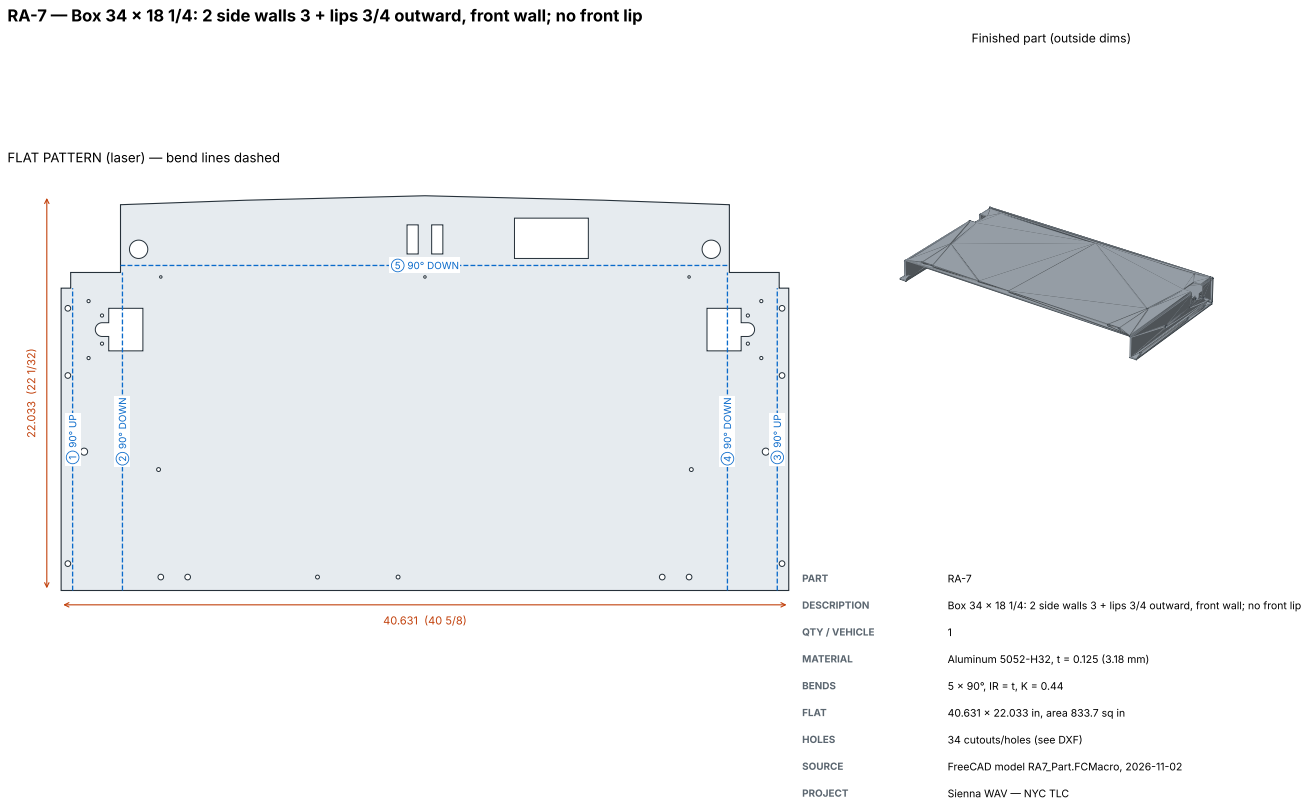
[picture p190: page 1]
② 90° DOWN; ④ 90° DOWN; ⑤ 90° DOWN; PART; DESCRIPTION; Box 34 x 18 1/4: 2 side walls 3 + lips 3/4 outward, front wall; no front lip; QTY / VEHICLE; MATERIAL; Aluminum 5052-H32, t = 0.125 (3.18 mm); BENDS; FLAT; 40.631 x 22.033 in, area 833.7 sq in; HOLES; 34 cutouts/holes (see DXF); SOURCE; FreeCAD model RA7_Part.FCMacro, 2026-11-02; PROJECT; Sienna WAV — NYC TLC

Finished part (outside dims)
