diademal/nyc-tlc-wav/drawings/MFG/ALL_drawings.pdf

Item | Material / thickness | Flat (in) | Bend lines | Qty / vehicle | lb each | Process
FR-1 | HR steel A1011 CS, 11 ga 0.1196″ (3.04 mm) | 8.538 × 13.853 | 2 | 1 FR + 1 FL | 2.04 | laser + 2 bends
FR-2 | HR steel A1011 CS, 11 ga 0.1196″ (3.04 mm) | 22.264 × 3.250 | 6 | 1 FR + 1 FL | 2.27 | laser + 6 bends + weld
FR-3 | HR steel A1011 CS, 11 ga 0.1196″ (3.04 mm) | 4.084 × 8.000 | 2 | 1 FR + 1 FL | 1.03 | laser + 2 bends
FR-4-1 strip | HR steel A1011 CS, 11 ga 0.1196″ (3.04 mm) | 18.827 × 2.746 | 9 | 1 FR + 1 FL | 1.63 | laser + 5 bends (2 radius)
FR-4-2 side A | HR steel A1011 CS, 11 ga 0.1196″ (3.04 mm) | 6.500 × 6.875 | 0 | 1 FR + 1 FL | 0.71 | laser
FR-4-3 side B | HR steel A1011 CS, 11 ga 0.1196″ (3.04 mm) | 6.500 × 6.875 | 0 | 1 FR + 1 FL | 0.71 | laser
FR-5 | HR steel A1011 CS, 11 ga 0.1196″ (3.04 mm) | 10.694 × 6.198 | 2 | 1 FR + 1 FL | 1.41 | laser + 2 bends
FR-7 | HR steel A1011 CS, 11 ga 0.1196″ (3.04 mm) | 9.853 × 8.186 | 3 | 1 FR + 1 FL | 1.45 | laser + 3 bends + weld
FR-8 | HR steel A1011 CS, 11 ga 0.1196″ (3.04 mm) | 6.209 × 12.000 | 2 | 1 FR + 1 FL | 1.79 | laser + 2 bends
FR-10-1 U-body | HR steel A1011 CS, 11 ga 0.1196″ (3.04 mm) | 12.374 × 11.235 | 3 | 1 FR + 1 FL | 2.29 | laser + 3 bends + drill
FR-10-2 strip | HR steel A1011 CS, 11 ga 0.1196″ (3.04 mm) | 12.560 × 2.746 | 3 | 1 FR + 1 FL | 1.05 | laser + 3 bends
FR-11 | HR steel A1011 CS, 11 ga 0.1196″ (3.04 mm) | 5.125 × 2.000 | 0 | 2 FR + 2 FL | 0.25 | laser
FF-1 | HR steel A1011 CS, 11 ga 0.1196″ (3.04 mm) | 20.142 × 6.870 | 4 | 1 | 3.89 | laser + 4 bends + weld
FF-3-1 top | HR steel A1011 CS, 11 ga 0.1196″ (3.04 mm) | 39.403 × 15.073 | 10 | 1 | 17.70 | laser + 10 bends
FF-3-2 lower | HR steel A1011 CS, 11 ga 0.1196″ (3.04 mm) | 39.000 × 14.595 | 2 | 1 | 16.12 | laser + 2 bends
FF-3-3 wall | HR steel A1011 CS, 11 ga 0.1196″ (3.04 mm) | 4.687 × 1.125 | 0 | 2 | 0.18 | laser
FF-3-4 wall | HR steel A1011 CS, 11 ga 0.1196″ (3.04 mm) | 5.013 × 1.125 | 0 | 2 | 0.19 | laser
RA-1 | Aluminum 5052-H32, 0.125″ (3.18 mm) | 22.000 × 34.566 | 2 | 1 | 8.07 | laser + bends
RA-2 | Aluminum 5052-H32, 0.125″ (3.18 mm) | 23.533 × 34.941 | 3 | 1 | 9.87 | laser + bends
RA-3 | Aluminum 5052-H32, 0.125″ (3.18 mm) | 19.658 × 45.066 | 3 | 1 | 9.10 | laser + bends
RA-4 | Aluminum 5052-H32, 0.125″ (3.18 mm) | 6.691 × 33.500 | 2 | 1 | 2.69 | laser + bends
RA-5 | Aluminum 5052-H32, 0.125″ (3.18 mm) | 9.783 × 33.500 | 1 | 1 | 2.37 | laser + bends
RA-6 | Aluminum 5052-H32, 0.125″ (3.18 mm) | 3.066 × 30.000 | 2 | 1 | 1.11 | laser + bends
RA-7 | Aluminum 5052-H32, 0.125″ (3.18 mm) | 40.631 × 22.556 | 4 | 1 | 10.30 | laser + bends
RA-8 | Aluminum 5052-H32, 0.125″ (3.18 mm) | 4.625 × 4.066 | 2 | 2 | 0.18 | laser + bends
FR-4 tube | DOM OD 1.500 × ID 1.181 (wall 0.160″) | cut 3.689 | — | 1 FR + 1 FL | | saw
FR-6 | Sq. tube 3×3 A500, wall 11 ga 0.120″ | cut 14.250 | — | 1 FR + 1 FL | | saw
FR-9 | Sq. tube 3×3 A500, wall 11 ga 0.120″ | cut 8.000 | — | 1 FR + 1 FL | | saw
FR-10 tube | DOM OD 1.500 × ID 1.181 (wall 0.160″) | cut 3.407 | — | 1 FR + 1 FL | | saw
FF-4 | Sq. tube 1½×1½ A500, wall 11 ga 0.120″ | cut 39.000 | — | 1 | | saw

# Sienna WAV — manufacturing package REV B (2026-10-31): frame + ramp

Frame: everything that was 10 ga is now 11 ga (0.1196″); square tubes 11 ga wall. Ramp: aluminum 5052-H32 0.125″. Units inch. Inside bend radius = t, K = 0.44.

## MATERIAL: HR steel sheet A1011 CS THICKNESS: 11 ga t = 0.1196″ (3.04 mm)


### FR-1 · 11 ga 0.120″ (3.04 mm) · HR steel sheet A1011 CS


(shape; thickness now 11 ga 0.120″)

FR-1 | Side plate with ears and 2 flanges

FR-1 · Plate with ears flat pattern (2 bends 90°)

HR steel sheet A1011 CS 11 ga 0.120″ (3.04 mm)

QTY 1 FR + 1 FL = 2 per vehicle

Units: inch · NOT TO SCALE

Tol.: cut ±0.010″ · bend ±1° · IR = t

Sienna WAV frame

2026-10-31

## REV B

### SHEET 1/1

# FR-1 · Plate with ears flat pattern (2 bends 90°)

11 ga 0.120″ (3.04 mm) · HR steel sheet A1011 CS · flat blank 8.538″ × 13.853″ · ≈ 2.04 lb each · QTY 1 FR + 1 FL = 2 per vehicle

FLAT PATTERN (as laser-cut, marked side up) | FORMED PART (after bending)

## BEND TABLE

Bend | Angle | Direction | Inside R | Order | Bend line position
B1 | 90.0° | UP (toward) | R=t 0.120 | 1 | X = 6.526
B2 | 90.0° | UP (toward) | R=t 0.120 | 2 | (0.993, 5.959) (3.900, 3.331)

## HOLES (centre from 0,0)

Hole | Size | X | Y | Made by
H1 | Ø0.709 | 1.031 | 9.226 | laser
H2 | Ø0.709 | 4.461 | 12.845 | laser
H3 | Ø1.024 | 4.880 | 5.842 | laser

## FILES

- FR-1_FR_cut.dxf (right, qty 1 / vehicle)
- FR-1_FL_cut.dxf (left = mirror, qty 1 / vehicle)
- FR-1_ref.dxf (reference: + bend lines, drill-later, material notes)

## NOTES

1. Laser cut from the *_cut.dxf file (1:1, inch). The DXF governs the geometry; dimensions here are for checking.
2. MATERIAL HR steel sheet A1011 CS, 11 ga t = 0.1196″ (3.04 mm). Bend allowance (K = 0.44, inside radius = t) is already in the flat.

Bend on the orange lines; UP = toward you when the part lies as drawn.
3. Holes marked DRILL LATER (red dashed) are not laser cut - drill after bending/welding.
4. Deburr all edges, remove dross.
5. Right part (FR) shown. Left part (FL) = mirror: cut *_FL_cut.dxf, bend the same UP/DOWN. * bend 90° up on dashed lines

B1 DOWN 90°; B2 DOWN 90°; B3 DOWN 90°; B5 DOWN 90°; B4 DOWN 90°; B6 DOWN 90°

### FR-2 · 11 ga 0.120″ (3.04 mm) · HR steel sheet A1011 CS


(shape; thickness now 11 ga 0.120″)

FR-2 | Bridge bracket (top + 2 U legs)

FR-2 · FR-2 one piece (top + 2 U legs)

HR steel sheet A1011 CS 11 ga 0.120″ (3.04 mm)

QTY 1 FR + 1 FL = 2 per vehicle

Tol.: cut ±0.010″ · bend ±1° · IR = t

### SHEET 1/1

# FR-2 · FR-2 one piece (top + 2 U legs)

11 ga 0.120″ (3.04 mm) · HR steel sheet A1011 CS · flat blank 22.264″ × 3.250″ · ≈ 2.27 lb each · QTY 1 FR + 1 FL = 2 per vehicle

FLAT PATTERN (as laser-cut, marked side up) | FORMED PART (after bending)

## BEND TABLE

Bend | Angle | Direction | Inside R | Order | Bend line position
B1 | 90.0° | DOWN (away) | R=t 0.120 | 1 | X = 3.026
B2 | 90.0° | DOWN (away) | R=t 0.120 | 3 | X = 4.819
B3 | 90.0° | DOWN (away) | R=t 0.120 | 5 | X = 7.861
B4 | 90.0° | DOWN (away) | R=t 0.120 | 2 | X = 19.237
B5 | 90.0° | DOWN (away) | R=t 0.120 | 4 | X = 17.445
B6 | 90.0° | DOWN (away) | R=t 0.120 | 6 | X = 14.403

## HOLES (centre from 0,0)

Hole | Size | X | Y | Made by
H1 | cut-out 0.708×0.472 | 4.048 | 1.500 | laser
H2 | cut-out 0.709×0.472 | 8.632 | 1.500 | laser
H3 | cut-out 0.750×0.625 | 13.632 | 1.375 | laser
H4 | cut-out 0.750×0.625 | 18.216 | 1.375 | laser

## FILES

- FR-2_FR_cut.dxf (right, qty 1 / vehicle)
- FR-2_FL_cut.dxf (left = mirror, qty 1 / vehicle)
- FR-2_ref.dxf (reference: + bend lines, drill-later, material notes)

## NOTES

1. Laser cut from the *_cut.dxf file (1:1, inch). The DXF governs the geometry; dimensions here are for checking.
2. MATERIAL HR steel sheet A1011 CS, 11 ga t = 0.1196″ (3.04 mm). Bend allowance (K = 0.44, inside radius = t) is already in the flat.

Bend on the orange lines; UP = toward you when the part lies as drawn.
3. Holes marked DRILL LATER (red dashed) are not laser cut - drill after bending/welding.
4. Deburr all edges, remove dross.
5. Right part (FR) shown. Left part (FL) = mirror: cut *_FL_cut.dxf, bend the same UP/DOWN.
* one blank, 6 bends 90° the same way (R = t): inner walls first, then the bottoms, then the outer walls; all ovals (top and leg bottoms) laser cut;

½" notch at the front edge of each bottom; inner walls reach the underside of the top (11 ga)

FR-3 · Channel | flat pattern (2 bends 90°)
11 ga 0.120 (3.04 mm) · HR steel sheet A1011 CS · flat blank 4.084 × 8.000 | · | 1.03 lb each · QTY 1 FR + 1 FL = 2 per vehicle

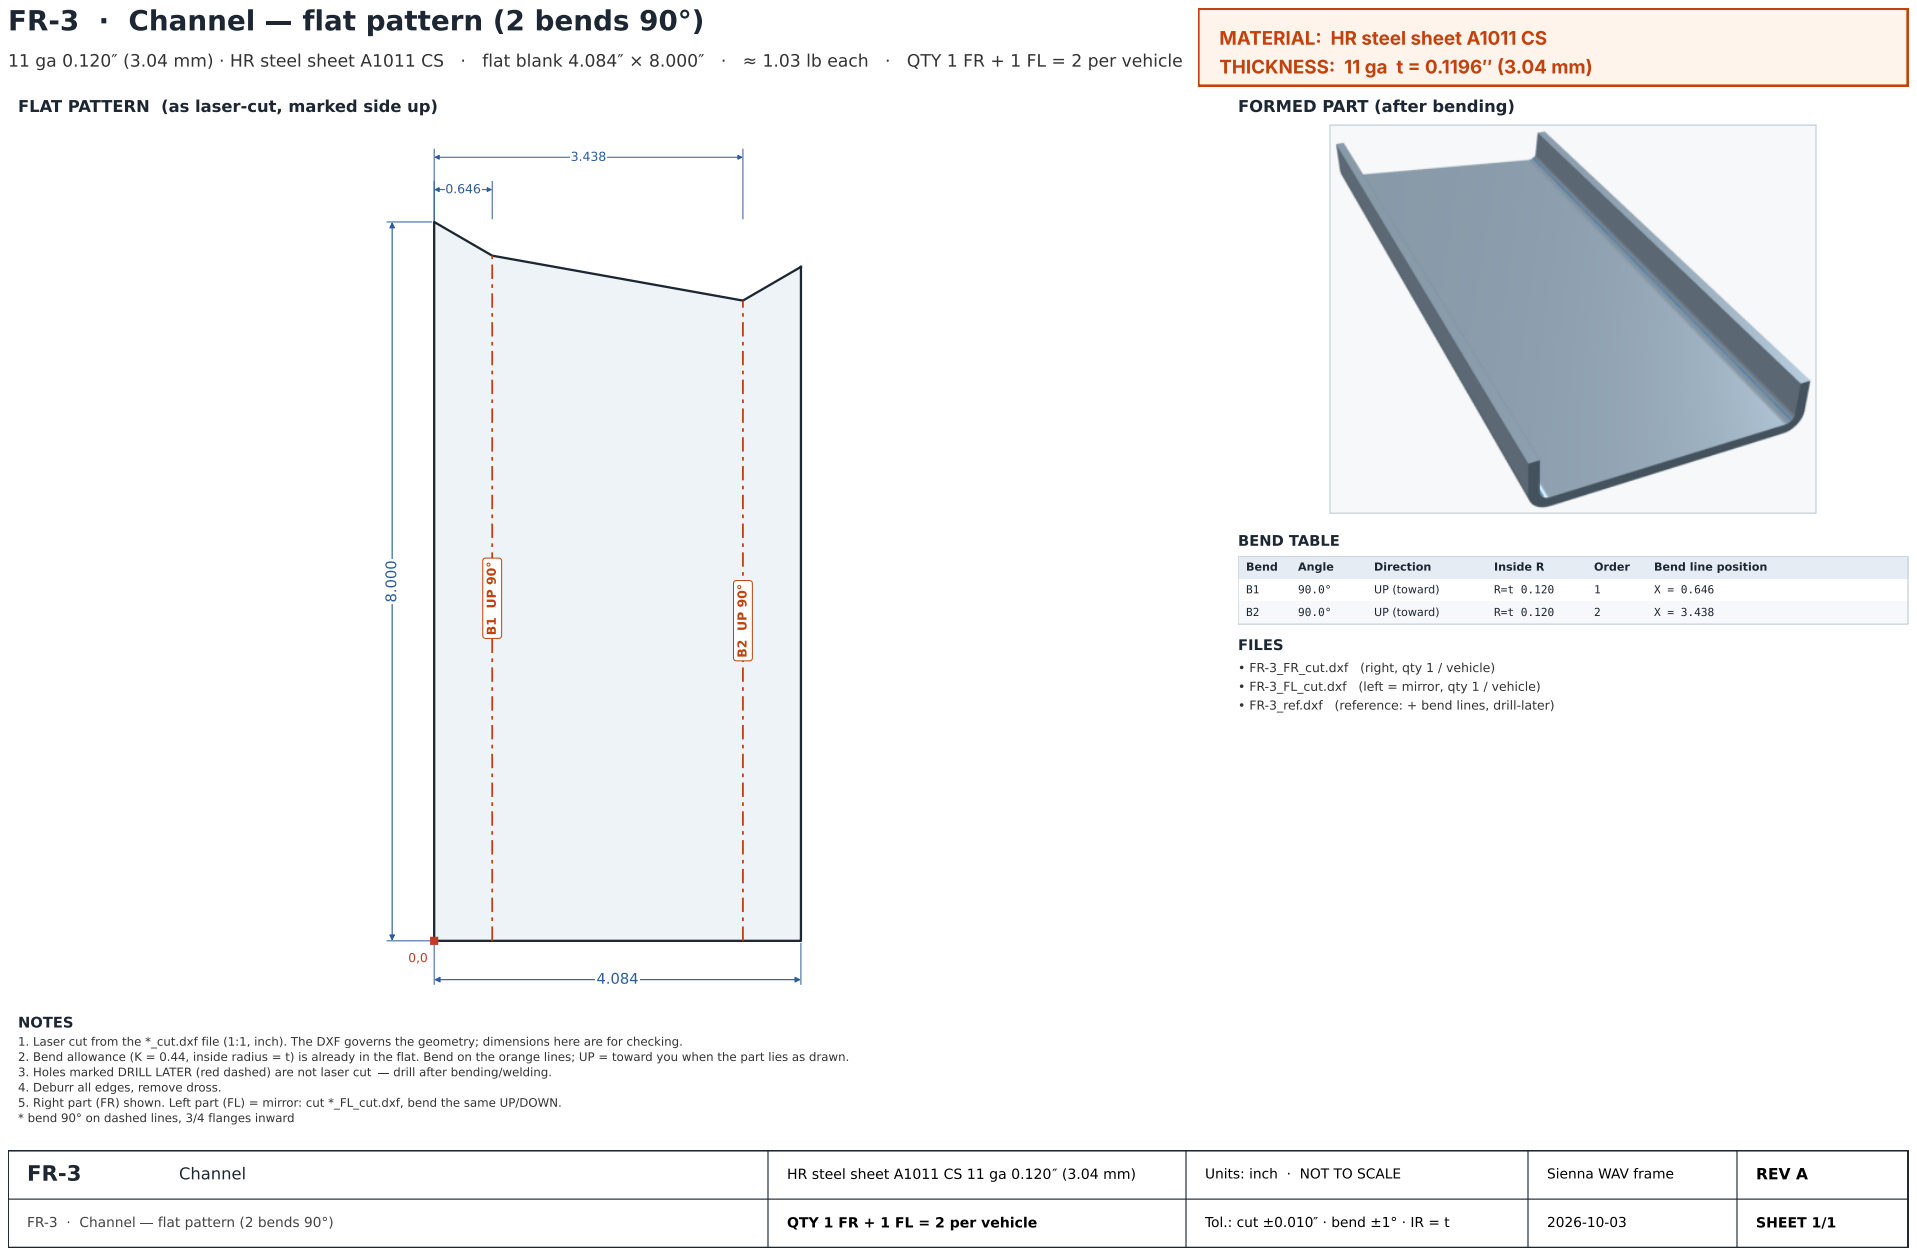
[picture p191: page 4]
Bend; Angle; Direction; Inside R; Order; Bend line position; UP (toward); Channel; FR-3 · Channel; flat pattern (2 bends 90°); REV A; SHEET 1/1; FLAT PATTERN (as laser-cut, marked side up); FORMED PART (after bending); BEND TABLE; FILES; 3. Holes marked DRILL LATER (red dashed) are not laser cut; drill after bending/welding.

FR-3_FR_cut.dxf (right, qty 1 / vehicle)
FR-3_FL_cut.dxf (left = mirror, qty 1 / vehicle)
FR-3_ref.dxf (reference: + bend lines, drill-later)

NOTES
1. Laser cut from the *_cut.dxf file (1:1, inch). The DXF governs the geometry; dimensions here are for checking.
2. Bend allowance (K = 0.44, inside radius = t) is already in the flat. Bend on the orange lines; UP = toward you when the part lies as drawn.
4. Deburr all edges, remove dross.
5. Right part (FR) shown. Left part (FL) = mirror: cut *_FL_cut.dxf, bend the same UP/DOWN.
* bend 90° on dashed lines, 3/4 flanges inward

HR steel sheet A1011 CS 11 ga 0.120 (3.04 mm)

QTY 1 FR + 1 FL = 2 per vehicle

Tol.: cut ±0.010 · bend ±1° · IR = t

B4 DOWN 90°

### FR-4-1 · 11 ga 0.120″ (3.04 mm) · HR steel sheet A1011 CS


(shape; thickness now 11 ga 0.120″)

FR-4 | Bracket: wrap strip + 2 side plates + tube

FR-4-1 · Wrap strip (ear, top, front, bottom, slant)

HR steel sheet A1011 CS 11 ga 0.120″ (3.04 mm)

QTY 1 FR + 1 FL = 2 per vehicle

Tol.: cut ±0.010″ · bend ±1° · IR = t

### SHEET 1/4

# FR-4-1 · Wrap strip (ear, top, front, bottom, slant)

11 ga 0.120″ (3.04 mm) · HR steel sheet A1011 CS · flat blank 18.827″ × 2.746″ · ≈ 1.63 lb each · QTY 1 FR + 1 FL = 2 per vehicle

FLAT PATTERN (as laser-cut, marked side up) | FORMED PART (after bending)

## BEND TABLE

Bend | Angle | Direction | Inside R | Order | Bend line position
B1 | 60.0° | UP (toward) | R=t 0.120 | 5 | X = 14.944
B2 | 90.0° | UP (toward) | R=t 0.120 | 4 | X = 10.596
B3 | 90.0° | UP (toward) | R=t 0.120 | 3 | X = 7.678
B4 | 90.0° | DOWN (away) | R 0.375 | 2 | X = 4.321
| | radius zone | edges | | X = 3.986 / 4.657
B7 | 126.9° | UP (toward) | R 0.505 | 1 | X = 0.618
| | radius zone | edges | | X = 0.000 / 1.236

## HOLES (centre from 0,0)

Hole | Size | X | Y | Made by
H1 | Ø1.500 | 6.282 | 1.373 | laser
H2 | Ø1.500 | 11.992 | 1.373 | laser

## FILES

- FR-4-1_FR_cut.dxf (right, qty 1 / vehicle)
- FR-4-1_FL_cut.dxf (left = mirror, qty 1 / vehicle)
- FR-4-1_ref.dxf (reference: + bend lines, drill-later, material notes)

## NOTES

1. Laser cut from the *_cut.dxf file (1:1, inch). The DXF governs the geometry; dimensions here are for checking.
2. MATERIAL HR steel sheet A1011 CS, 11 ga t = 0.1196″ (3.04 mm). Bend allowance (K = 0.44, inside radius = t) is already in the flat.

Bend on the orange lines; UP = toward you when the part lies as drawn.
3. Holes marked DRILL LATER (red dashed) are not laser cut - drill after bending/welding.
4. Deburr all edges, remove dross.
5. Right part (FR) shown. Left part (FL) = mirror: cut *_FL_cut.dxf, bend the same UP/DOWN.
* arc C-D bent over R 0.505 (outer R 0.625 = side plate arc); R 0.375 at E (concave, opposite way); no corner reliefs; strip width = 3" - 2t - 0.015


### FR-4-2 · 11 ga 0.120″ (3.04 mm) · HR steel sheet A1011 CS

FR-4 | Bracket: wrap strip + 2 side plates + tube

FR-4-2 · Side plate A (2 holes Ø0.512)

HR steel sheet A1011 CS 11 ga 0.120″ (3.04 mm)

QTY 1 FR + 1 FL = 2 per vehicle

Tol.: cut ±0.010″ · bend ±1° · IR = t

### SHEET 2/4

# FR-4-2 · Side plate A (2 holes Ø0.512)

11 ga 0.120″ (3.04 mm) · HR steel sheet A1011 CS · flat blank 6.500″ × 6.875″ · ≈ 0.71 lb each · QTY 1 FR + 1 FL = 2 per vehicle

FLAT PATTERN (as laser-cut, marked side up) | FORMED PART (after bending)

## flat part - no bends

## HOLES (centre from 0,0)

Hole | Size | X | Y | Made by
H1 | Ø0.512 | 1.750 | 2.250 | laser
H2 | Ø0.512 | 2.500 | 6.250 | laser

## FILES

- FR-4-2_FR_cut.dxf (right, qty 1 / vehicle)
- FR-4-2_FL_cut.dxf (left = mirror, qty 1 / vehicle)
- FR-4-2_ref.dxf (reference: + bend lines, drill-later, material notes)

## NOTES

1. Laser cut from the *_cut.dxf file (1:1, inch). The DXF governs the geometry; dimensions here are for checking.
2. MATERIAL HR steel sheet A1011 CS, 11 ga t = 0.1196″ (3.04 mm). Bend allowance (K = 0.44, inside radius = t) is already in the flat.

Bend on the orange lines; UP = toward you when the part lies as drawn.
3. Holes marked DRILL LATER (red dashed) are not laser cut - drill after bending/welding.
4. Deburr all edges, remove dross.
5. Right part (FR) shown. Left part (FL) = mirror: cut *_FL_cut.dxf, bend the same UP/DOWN. * flat, no bends


### FR-4-3 · 11 ga 0.120″ (3.04 mm) · HR steel sheet A1011 CS

FR-4 | Bracket: wrap strip + 2 side plates + tube

FR-4-3 · Side plate B (holes Ø0.512 + Ø0.34)

HR steel sheet A1011 CS 11 ga 0.120″ (3.04 mm)

QTY 1 FR + 1 FL = 2 per vehicle

Tol.: cut ±0.010″ · bend ±1° · IR = t

### SHEET 3/4

# FR-4-3 · Side plate B (holes Ø0.512 + Ø0.34)

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

FLAT PATTERN (as laser-cut, marked side up) | FORMED PART (after bending)

## flat part - no bends

## HOLES (centre from 0,0)

Hole | Size | X | Y | Made by
H1 | Ø0.340 | 1.750 | 2.250 | laser
H2 | Ø0.512 | 2.500 | 6.250 | laser

## FILES

- FR-4-3_FR_cut.dxf (right, qty 1 / vehicle)
- FR-4-3_FL_cut.dxf (left = mirror, qty 1 / vehicle)
- FR-4-3_ref.dxf (reference: + bend lines, drill-later, material notes)

## NOTES

1. Laser cut from the *_cut.dxf file (1:1, inch). The DXF governs the geometry; dimensions here are for checking.
2. MATERIAL HR steel sheet A1011 CS, 11 ga t = 0.1196″ (3.04 mm). Bend allowance (K = 0.44, inside radius = t) is already in the flat.

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

## MATERIAL: DOM round steel tube A513

## WALL THICKNESS: OD 1.500 × ID 1.181 (wall 0.160″)

section, wall 0.1595″

FR-4 · tube cut list

Tube OD 1.5 / ID 1.181 cut 3.689″ (through bottom and top)

Stock: DOM round steel tube OD 1.500 × ID 1.181 (wall 0.160″)

Cut length 3.689″ ±1/32″, square ends, deburr

QTY 1 per side × 2 (FR + FL) = 2 per vehicle

FR-4 Bracket: wrap strip + 2 side plates + tube | DOM round steel tube A513

Tube cut list | QTY 1 per side × 2 (FR + FL) = 2 per vehicle | Tol.: cut ±1/32″ | SHEET 4/4

2.056


### FR-5 · 11 ga 0.120″ (3.04 mm) · HR steel sheet A1011 CS


(shape; thickness now 11 ga 0.120″)

FR-5 | U-body bracket

FR-5 · U-body (2 sides + plate A-C)

HR steel sheet A1011 CS 11 ga 0.120″ (3.04 mm)

QTY 1 FR + 1 FL = 2 per vehicle

Tol.: cut ±0.010″ · bend ±1° · IR = t

### SHEET 1/1

# FR-5 · U-body (2 sides + plate A-C)

11 ga 0.120″ (3.04 mm) · HR steel sheet A1011 CS · flat blank 10.694″ × 6.198″ · ≈ 1.41 lb each · QTY 1 FR + 1 FL = 2 per vehicle

FLAT PATTERN (as laser-cut, marked side up) | FORMED PART (after bending)

## BEND TABLE

Bend | Angle | Direction | Inside R | Order | Bend line position
B1 | 90.0° | UP (toward) | R=t 0.120 | 1 | X = 4.201
B2 | 90.0° | UP (toward) | R=t 0.120 | 2 | X = 6.493

## HOLES (centre from 0,0)

Hole | Size | X | Y | Made by
H1 | Ø0.591 | 1.685 | 2.056 | laser
H2 | Ø0.591 | 9.009 | 2.056 | laser

## FILES

- FR-5_FR_cut.dxf (right, qty 1 / vehicle)
- FR-5_FL_cut.dxf (left = mirror, qty 1 / vehicle)
- FR-5_ref.dxf (reference: + bend lines, drill-later, material notes)

## NOTES

1. Laser cut from the *_cut.dxf file (1:1, inch). The DXF governs the geometry; dimensions here are for checking.
2. MATERIAL HR steel sheet A1011 CS, 11 ga t = 0.1196″ (3.04 mm). Bend allowance (K = 0.44, inside radius = t) is already in the flat.

Bend on the orange lines; UP = toward you when the part lies as drawn.
3. Holes marked DRILL LATER (red dashed) are not laser cut - drill after bending/welding.
4. Deburr all edges, remove dross.
5. Right part (FR) shown. Left part (FL) = mirror: cut *_FL_cut.dxf, bend the same UP/DOWN. * 90° bends, R = t

## MATERIAL: Square steel tube A500, 3 × 3

## WALL THICKNESS: 11 ga 0.120″ (3.04 mm)

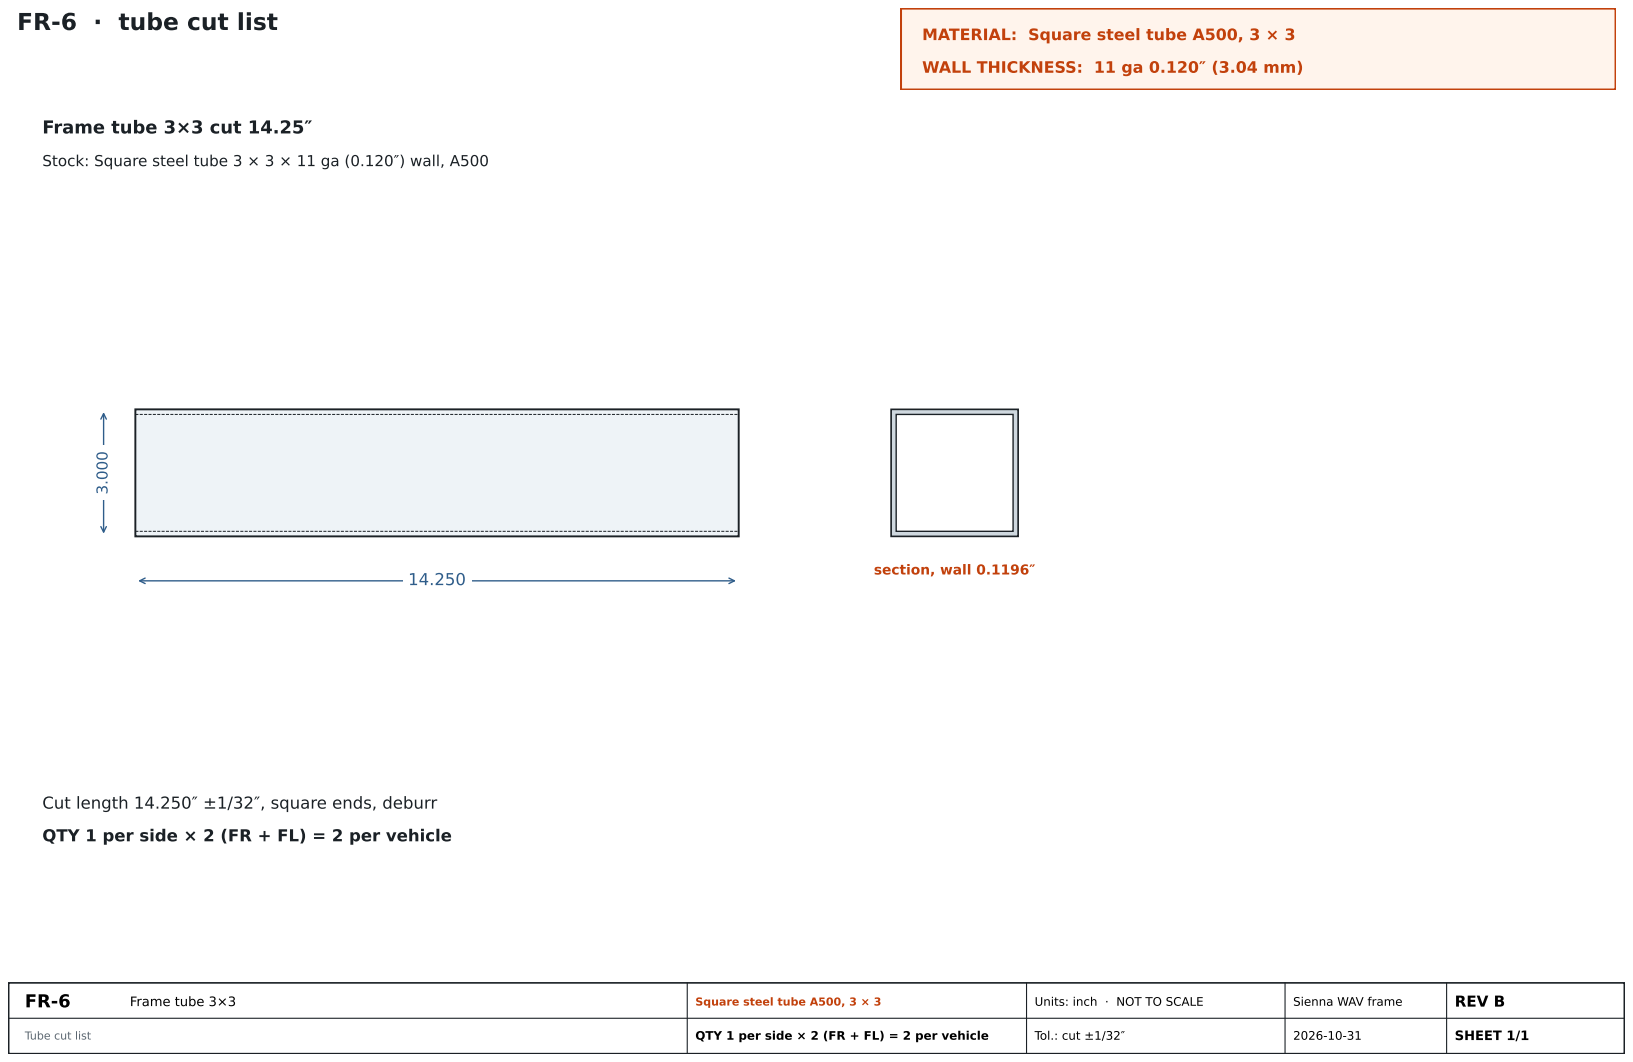
[picture p192: page 10]
section, wall 0.1196″

FR-6 · tube cut list

Frame tube 3×3 cut 14.25″

Stock: Square steel tube 3 × 3 × 11 ga (0.120″) wall, A500

Cut length 14.250″ ±1/32″, square ends, deburr

QTY 1 per side × 2 (FR + FL) = 2 per vehicle

FR-6 Frame tube 3×3 | Square steel tube A500, 3 × 3

Tube cut list | QTY 1 per side × 2 (FR + FL) = 2 per vehicle | Tol.: cut ±1/32″ | SHEET 1/1


### FR-7 · 11 ga 0.120″ (3.04 mm) · HR steel sheet A1011 CS


(shape; thickness now 11 ga 0.120″)

FR-7 | Tray bracket (back + bottom + 2 sides)

FR-7 · FR-7 one piece (back + bottom + 2 sides)

HR steel sheet A1011 CS 11 ga 0.120″ (3.04 mm)

QTY 1 FR + 1 FL = 2 per vehicle

Tol.: cut ±0.010″ · bend ±1° · IR = t

### SHEET 1/1

# FR-7 · FR-7 one piece (back + bottom + 2 sides)

11 ga 0.120″ (3.04 mm) · HR steel sheet A1011 CS · flat blank 9.853″ × 8.186″ · ≈ 1.45 lb each · QTY 1 FR + 1 FL = 2 per vehicle

FLAT PATTERN (as laser-cut, marked side up) | FORMED PART (after bending)

## BEND TABLE

Bend | Angle | Direction | Inside R | Order | Bend line position
B1 | 90.0° | UP (toward) | R=t 0.120 | 1 | Y = 3.156
B2 | 90.0° | UP (toward) | R=t 0.120 | 2 | X = 3.781
B3 | 90.0° | UP (toward) | R=t 0.120 | 3 | X = 6.073

## HOLES (centre from 0,0)

Hole | Size | X | Y | Made by
H1 | Ø0.591 | 2.625 | 4.811 | laser
H2 | Ø0.500 | 5.061 | 4.927 | laser
H3 | Ø0.591 | 7.228 | 4.811 | laser

## FILES

- FR-7_FR_cut.dxf (right, qty 1 / vehicle)
- FR-7_FL_cut.dxf (left = mirror, qty 1 / vehicle)
- FR-7_ref.dxf (reference: + bend lines, drill-later, material notes)

## NOTES

1. Laser cut from the *_cut.dxf file (1:1, inch). The DXF governs the geometry; dimensions here are for checking.
2. MATERIAL HR steel sheet A1011 CS, 11 ga t = 0.1196″ (3.04 mm). Bend allowance (K = 0.44, inside radius = t) is already in the flat.

Bend on the orange lines; UP = toward you when the part lies as drawn.
3. Holes marked DRILL LATER (red dashed) are not laser cut - drill after bending/welding.
4. Deburr all edges, remove dross.
5. Right part (FR) shown. Left part (FL) = mirror: cut *_FL_cut.dxf, bend the same UP/DOWN.
* one blank, 3 bends 90° the same way (R = t): bottom first, then the sides; Ø0.3 round reliefs in the two corners; after bending weld the side-to-

bottom seams; V notch and Ø0.5 hole in the back, Ø0.591 holes in the sides

# FR-8 · Channel (top + 2 sides)

11 ga 0.120 (3.04 mm) · HR steel sheet A1011 CS · flat blank 6.209 × 12.000 | · | 1.79 lb each · QTY 1 FR + 1 FL = 2 per vehicle

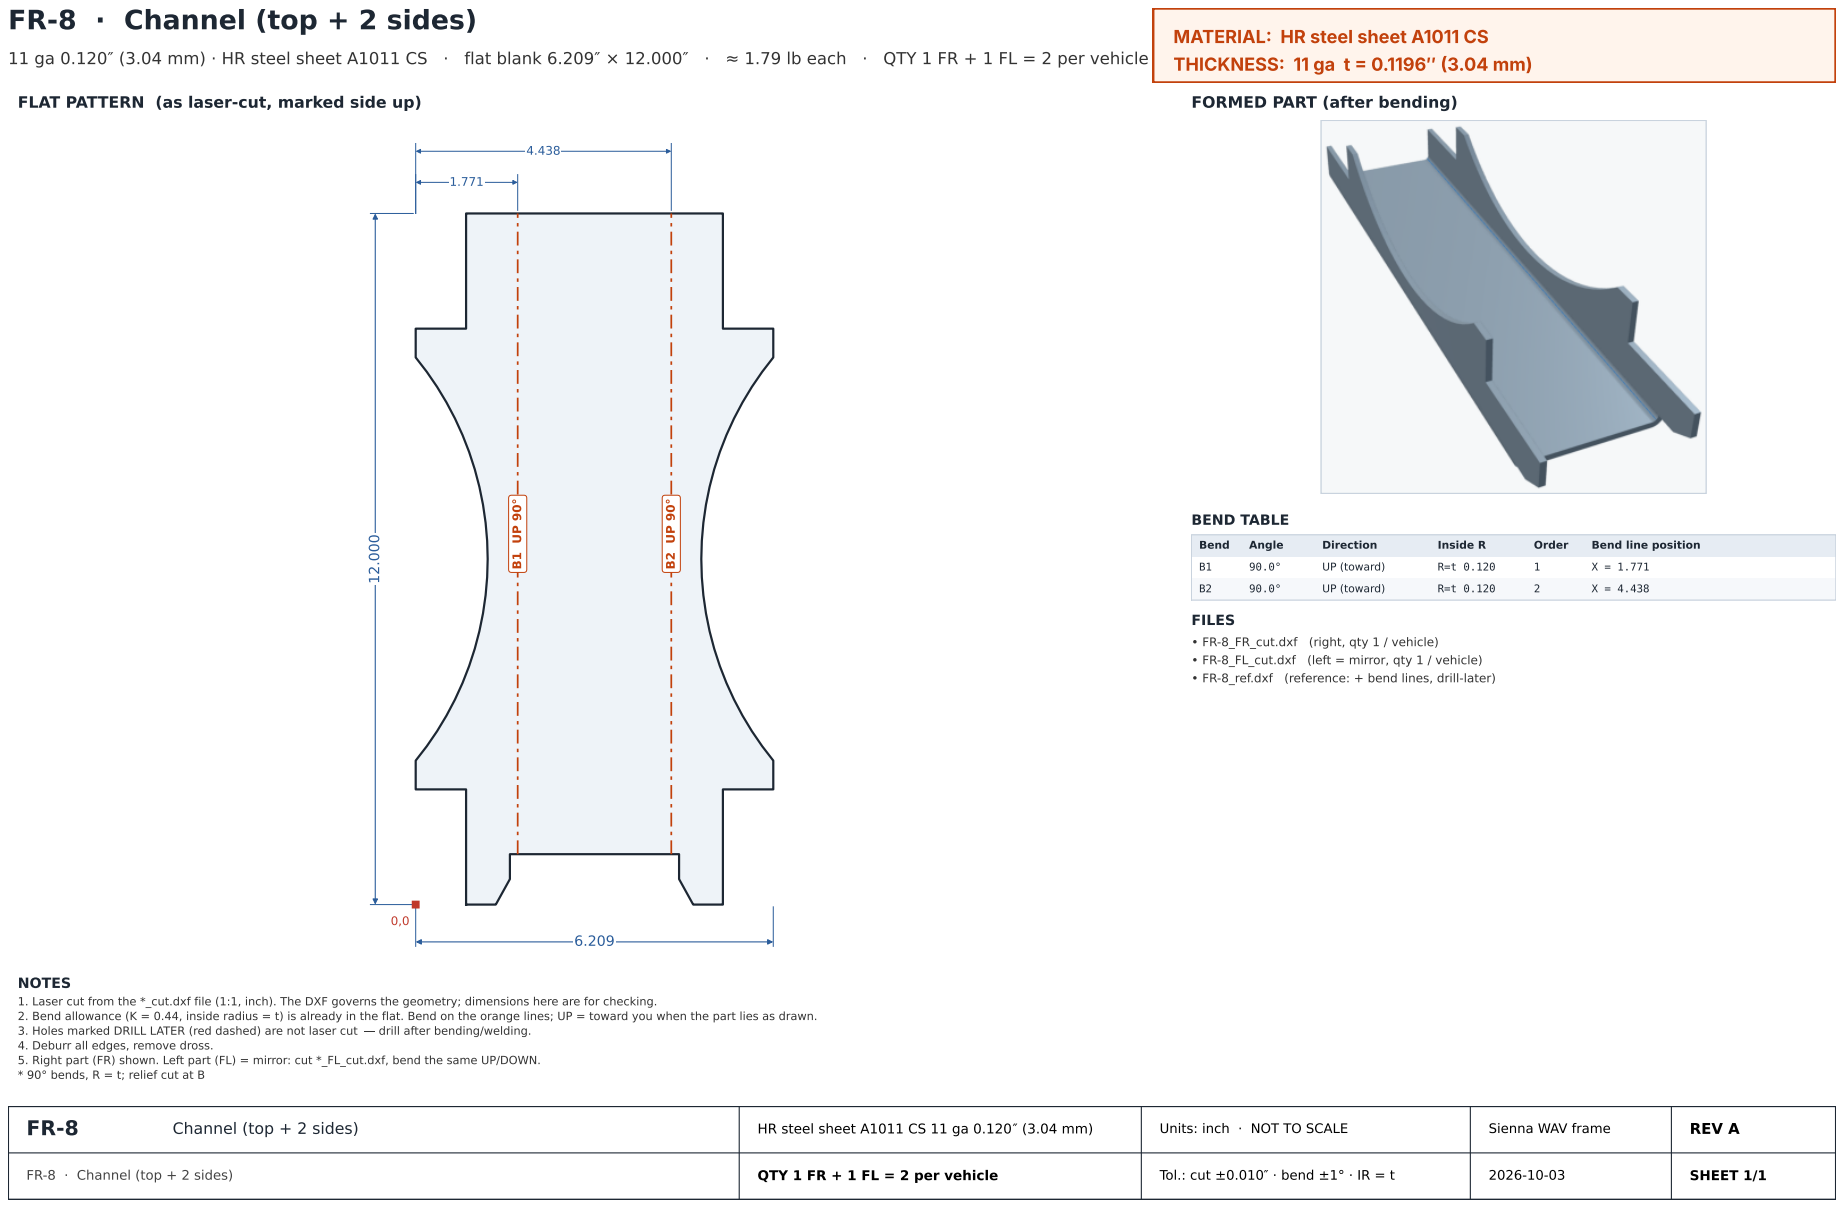
[picture p193: page 12]
Bend; Angle; Direction; Inside R; Order; Bend line position; UP (toward); Channel (top + 2 sides); REV A; SHEET 1/1; FLAT PATTERN (as laser-cut, marked side up); FORMED PART (after bending); BEND TABLE; FILES; 3. Holes marked DRILL LATER (red dashed) are not laser cut; drill after bending/welding.

FR-8_FR_cut.dxf (right, qty 1 / vehicle)
FR-8_FL_cut.dxf (left = mirror, qty 1 / vehicle)
FR-8_ref.dxf (reference: + bend lines, drill-later)

NOTES
1. Laser cut from the *_cut.dxf file (1:1, inch). The DXF governs the geometry; dimensions here are for checking.
2. Bend allowance (K = 0.44, inside radius = t) is already in the flat. Bend on the orange lines; UP = toward you when the part lies as drawn.
4. Deburr all edges, remove dross.
5. Right part (FR) shown. Left part (FL) = mirror: cut *_FL_cut.dxf, bend the same UP/DOWN.
* 90° bends, R = t; relief cut at B

HR steel sheet A1011 CS 11 ga 0.120 (3.04 mm)

FR-8 · Channel (top + 2 sides)

QTY 1 FR + 1 FL = 2 per vehicle

Tol.: cut ±0.010 · bend ±1° · IR = t

## MATERIAL: Square steel tube A500, 3 × 3

## WALL THICKNESS: 11 ga 0.120″ (3.04 mm)

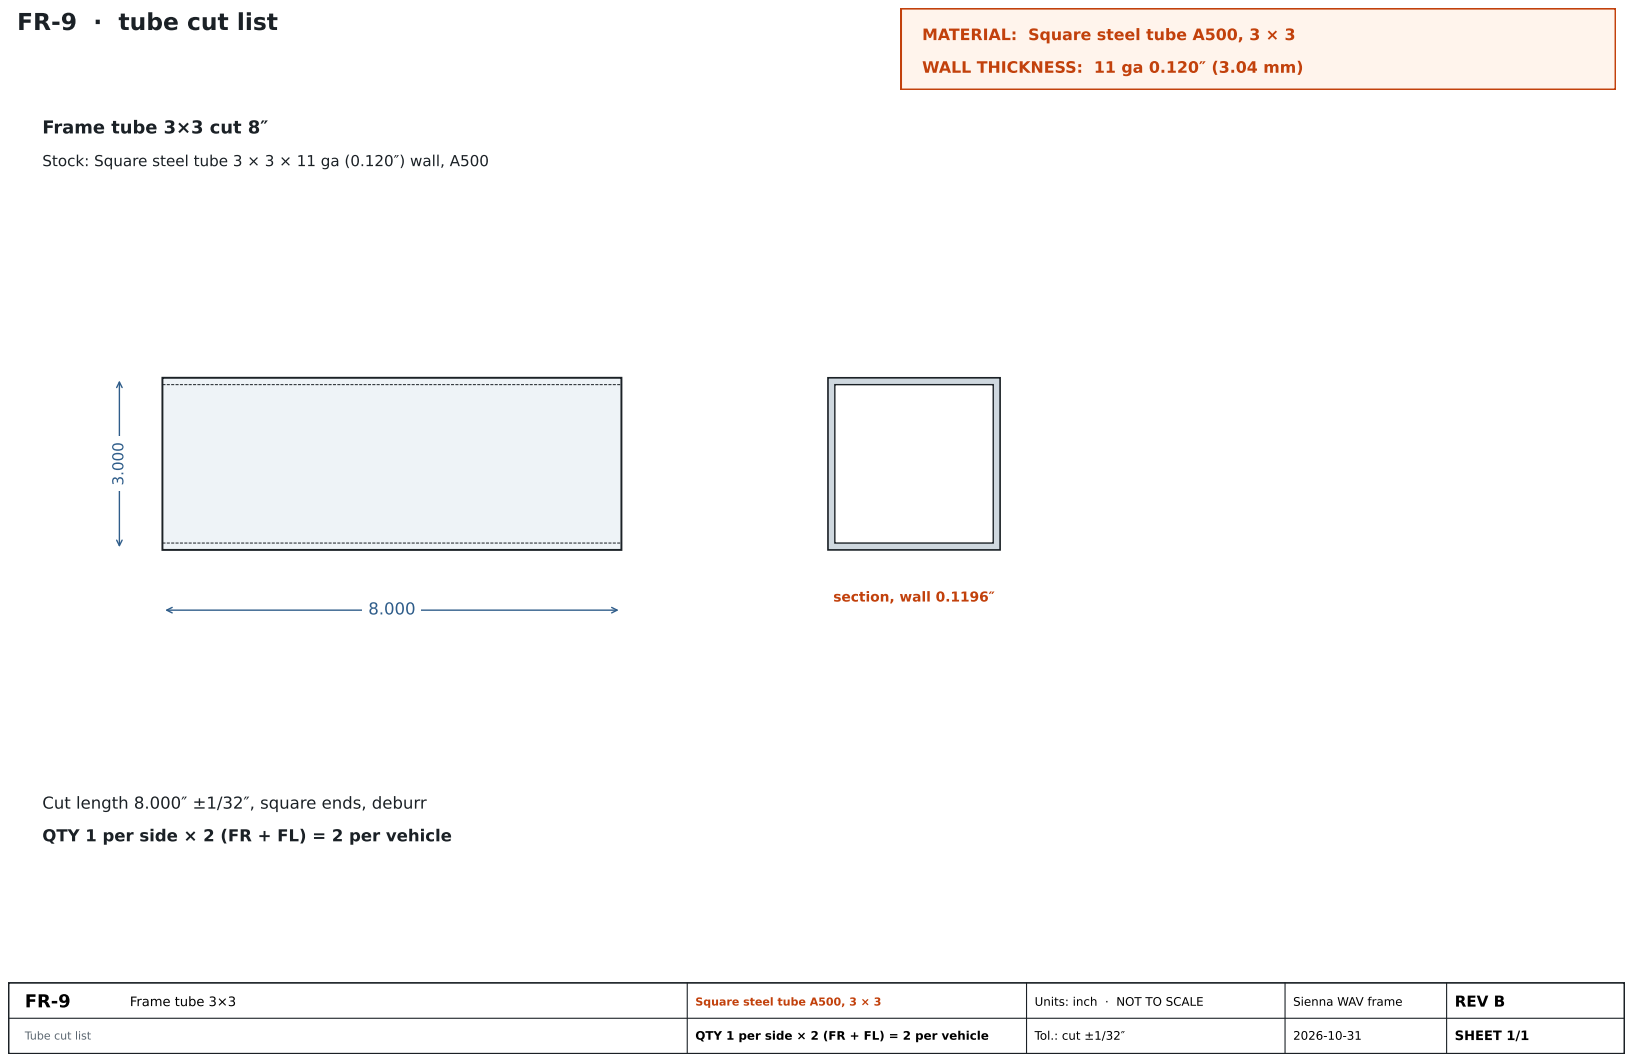
[picture p194: page 13]
section, wall 0.1196″

FR-9 · tube cut list

Frame tube 3×3 cut 8″

Stock: Square steel tube 3 × 3 × 11 ga (0.120″) wall, A500

Cut length 8.000″ ±1/32″, square ends, deburr

QTY 1 per side × 2 (FR + FL) = 2 per vehicle

FR-9 Frame tube 3×3 | Square steel tube A500, 3 × 3

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


### FR-10-1 · 11 ga 0.120″ (3.04 mm) · HR steel sheet A1011 CS


(shape; thickness now 11 ga 0.120″)

FR-10 | Bracket: U-body + strip + tube

FR-10-1 · Part 1 "U-body" 2 sides + wall A-H + flange E-F (3 bends)

HR steel sheet A1011 CS 11 ga 0.120″ (3.04 mm)

QTY 1 FR + 1 FL = 2 per vehicle

Tol.: cut ±0.010″ · bend ±1° · IR = t

### SHEET 1/3

# FR-10-1 · Part 1 "U-body" 2 sides + wall A-H + flange E-F (3 bends)

11 ga 0.120″ (3.04 mm) · HR steel sheet A1011 CS · flat blank 12.374″ × 11.235″ · ≈ 2.29 lb each · QTY 1 FR + 1 FL = 2 per vehicle

FLAT PATTERN (as laser-cut, marked side up) | FORMED PART (after bending)

## BEND TABLE

Bend | Angle | Direction | Inside R | Order | Bend line position
B1 | 90.0° | UP (toward) | R=t 0.120 | 2 | X = 5.924
B2 | 90.0° | UP (toward) | R=t 0.120 | 3 | X = 8.716
B3 | 90.0° | UP (toward) | R=t 0.120 | 1 | (2.354, 2.903) (3.249, 1.413)

## HOLES (centre from 0,0)

Hole | Size | X | Y | Made by
H1 | Ø0.591 | 4.778 | 5.334 | laser
H2 | Ø0.591 | 9.862 | 5.334 | laser
D1 | Ø0.591 | 5.403 | 9.637 | DRILL LATER
D2 | Ø0.591 | 9.237 | 9.637 | DRILL LATER

## FILES

- FR-10-1_FR_cut.dxf (right, qty 1 / vehicle)
- FR-10-1_FL_cut.dxf (left = mirror, qty 1 / vehicle)
- FR-10-1_ref.dxf (reference: + bend lines, drill-later, material notes)

## NOTES

1. Laser cut from the *_cut.dxf file (1:1, inch). The DXF governs the geometry; dimensions here are for checking.
2. MATERIAL HR steel sheet A1011 CS, 11 ga t = 0.1196″ (3.04 mm). Bend allowance (K = 0.44, inside radius = t) is already in the flat.

Bend on the orange lines; UP = toward you when the part lies as drawn.
3. Holes marked DRILL LATER (red dashed) are not laser cut - drill after bending/welding.
4. Deburr all edges, remove dross.
5. Right part (FR) shown. Left part (FL) = mirror: cut *_FL_cut.dxf, bend the same UP/DOWN.
* bends 90° up, R = t; the 2 Ø0.591 holes near A (½" from A-B) are not in the flat - drill after bending (DRILL LATER)

B3 DOWN 79.2°

### FR-10-2 · 11 ga 0.120″ (3.04 mm) · HR steel sheet A1011 CS

FR-10 | Bracket: U-body + strip + tube

FR-10-2 · Part 2 "strip" A-B · B-C · shelf · inner plate (3 bends)

HR steel sheet A1011 CS 11 ga 0.120″ (3.04 mm)

QTY 1 FR + 1 FL = 2 per vehicle


Tol.: cut ±0.010″ · bend ±1° · IR = t

### SHEET 2/3

# FR-10-2 · Part 2 "strip" A-B · B-C · shelf · inner plate (3 bends)

11 ga 0.120″ (3.04 mm) · HR steel sheet A1011 CS · flat blank 12.560″ × 2.746″ · ≈ 1.05 lb each · QTY 1 FR + 1 FL = 2 per vehicle

FLAT PATTERN (as laser-cut, marked side up) | FORMED PART (after bending)

## BEND TABLE

Bend | Angle | Direction | Inside R | Order | Bend line position
B1 | 93.9° | UP (toward) | R=t 0.120 | 5 | X = 2.369
B2 | 86.1° | UP (toward) | R=t 0.120 | 6 | X = 4.779
B3 | 79.2° | DOWN (away) | R=t 0.120 | 4 | X = 7.095

## HOLES (centre from 0,0)

Hole | Size | X | Y | Made by
H1 | Ø1.510 | 1.127 | 1.373 | laser
H2 | Ø1.510 | 5.864 | 1.373 | laser

## FILES

- FR-10-2_FR_cut.dxf (right, qty 1 / vehicle)
- FR-10-2_FL_cut.dxf (left = mirror, qty 1 / vehicle)
- FR-10-2_ref.dxf (reference: + bend lines, drill-later, material notes)

## NOTES

1. Laser cut from the *_cut.dxf file (1:1, inch). The DXF governs the geometry; dimensions here are for checking.
2. MATERIAL HR steel sheet A1011 CS, 11 ga t = 0.1196″ (3.04 mm). Bend allowance (K = 0.44, inside radius = t) is already in the flat.

Bend on the orange lines; UP = toward you when the part lies as drawn.
3. Holes marked DRILL LATER (red dashed) are not laser cut - drill after bending/welding.
4. Deburr all edges, remove dross.
5. Right part (FR) shown. Left part (FL) = mirror: cut *_FL_cut.dxf, bend the same UP/DOWN.
* X 79.2° opposite way; B 93.9°, C 86.1° up; corners 3/16"×45°; strip width = 3" - 2t - 0.015 (11 ga), from FR10_Bent model

## MATERIAL: DOM round steel tube A513

## WALL THICKNESS: OD 1.500 × ID 1.181 (wall 0.160″)

section, wall 0.1595″

FR-10 · tube cut list

Tube OD 1.5 / ID 1.181 cut 3.407″ (through A-B and the shelf)

Stock: DOM round steel tube OD 1.500 × ID 1.181 (wall 0.160″)

Cut length 3.407″ ±1/32″, square ends, deburr

QTY 1 per side × 2 (FR + FL) = 2 per vehicle

FR-10 Bracket: U-body + strip + tube | DOM round steel tube A513

Tube cut list | QTY 1 per side × 2 (FR + FL) = 2 per vehicle | Tol.: cut ±1/32″ | SHEET 3/3

# FR-11 · FR-11 plate (flat)

11 ga 0.120 (3.04 mm) · HR steel sheet A1011 CS · flat blank 5.125 × 2.000 | · | 0.25 lb each · QTY 2 FR + 2 FL = 4 per vehicle

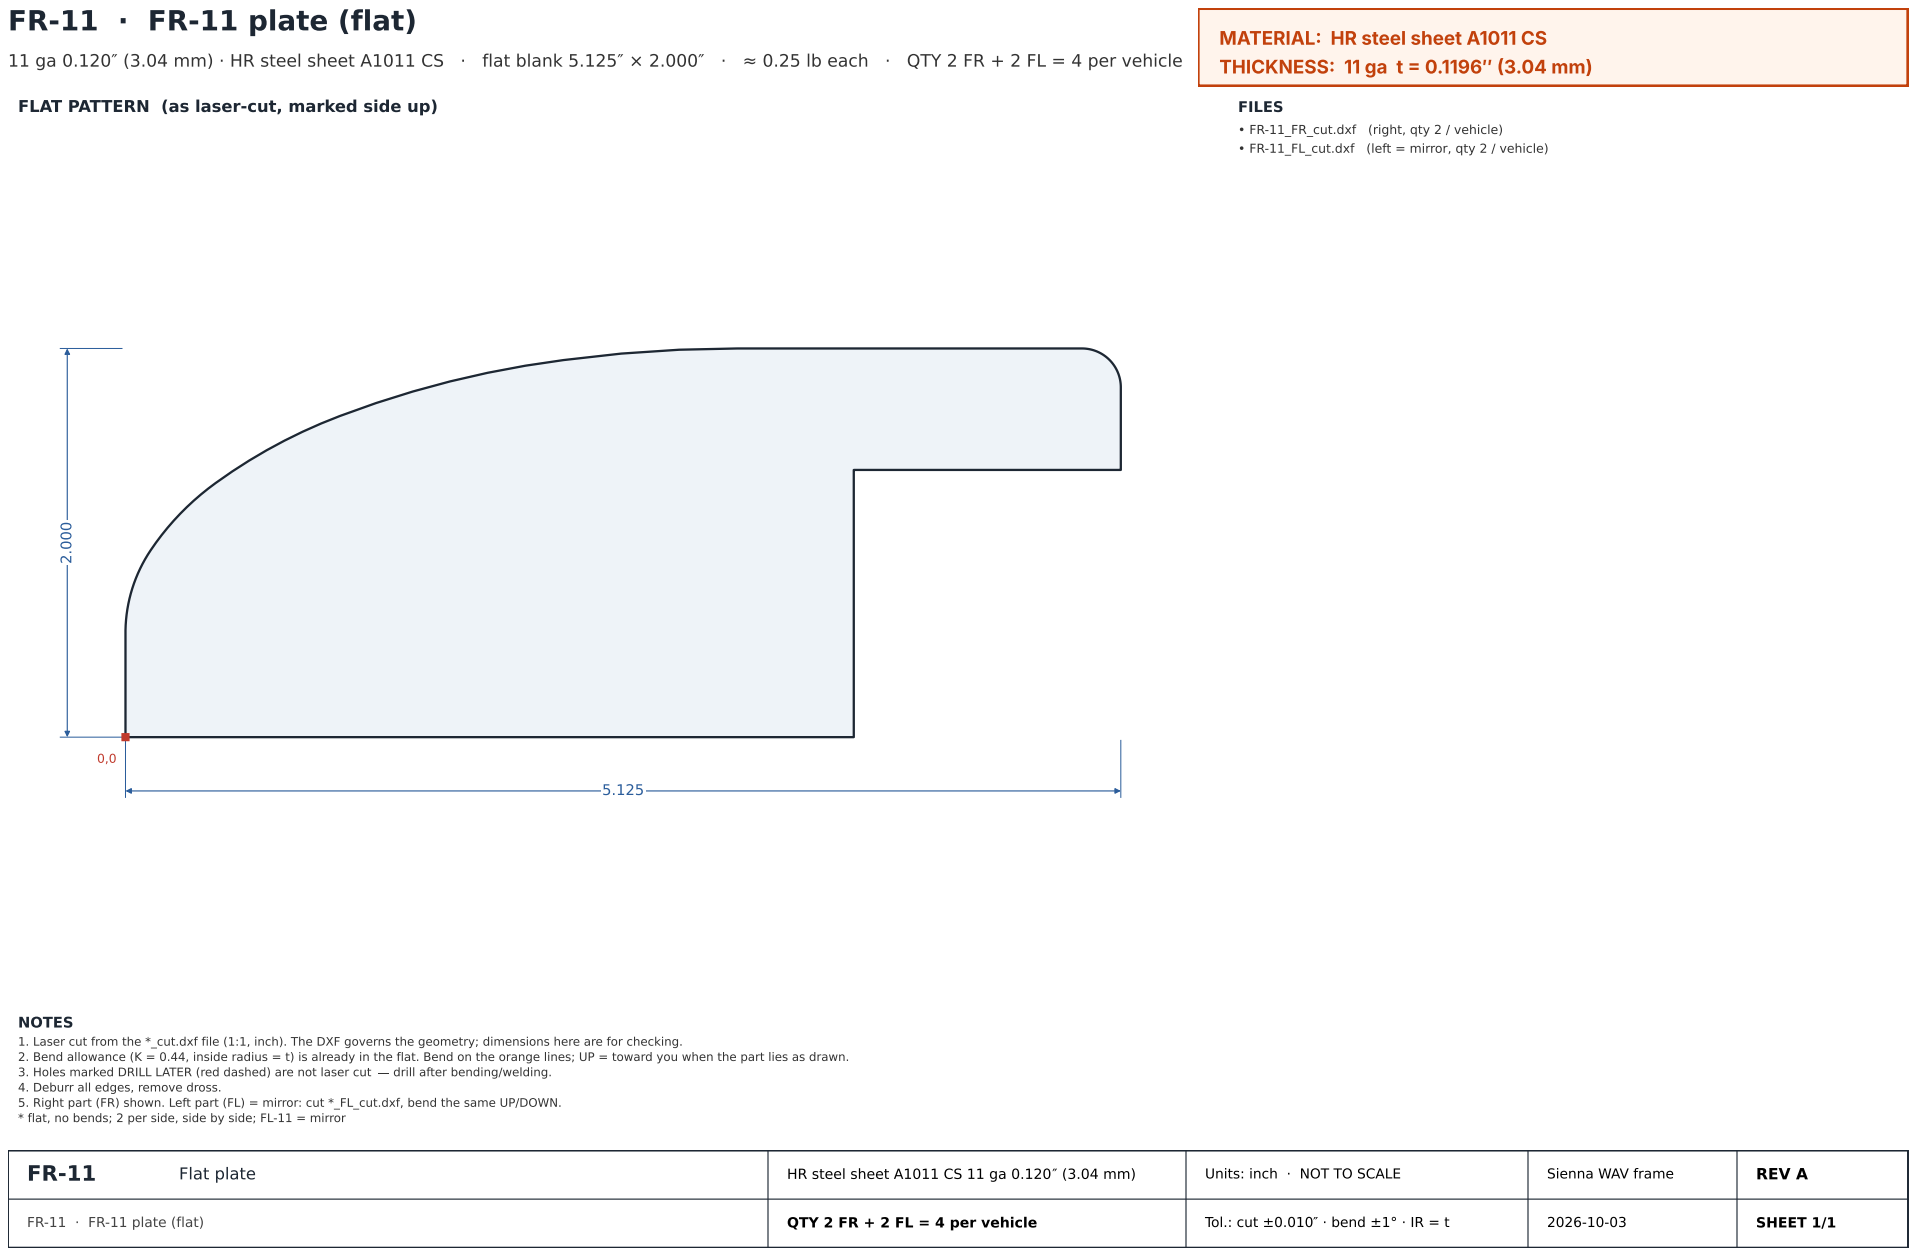
[picture p195: page 17]
Flat plate; REV A; SHEET 1/1; FLAT PATTERN (as laser-cut, marked side up); FILES; 3. Holes marked DRILL LATER (red dashed) are not laser cut; drill after bending/welding.

FR-11_FR_cut.dxf (right, qty 2 / vehicle)
FR-11_FL_cut.dxf (left = mirror, qty 2 / vehicle)

NOTES
1. Laser cut from the *_cut.dxf file (1:1, inch). The DXF governs the geometry; dimensions here are for checking.
2. Bend allowance (K = 0.44, inside radius = t) is already in the flat. Bend on the orange lines; UP = toward you when the part lies as drawn.
4. Deburr all edges, remove dross.
5. Right part (FR) shown. Left part (FL) = mirror: cut *_FL_cut.dxf, bend the same UP/DOWN.
* flat, no bends; 2 per side, side by side; FL-11 = mirror

HR steel sheet A1011 CS 11 ga 0.120 (3.04 mm)

FR-11 · FR-11 plate (flat)

QTY 2 FR + 2 FL = 4 per vehicle

Tol.: cut ±0.010 · bend ±1° · IR = t

B1 DOWN 90° B2 DOWN 90°; B3 DOWN 90° B4 DOWN 90°

### FF-1 · 11 ga 0.120″ (3.04 mm) · HR steel sheet A1011 CS


(shape; thickness now 11 ga 0.120″)

FF-1 | Front channel with ears (chevron 6"+6")

FF-1 · Channel with ears flat pattern, one piece (4 bends 90°, web on top)

HR steel sheet A1011 CS 11 ga 0.120″ (3.04 mm)

QTY 1 per vehicle

Tol.: cut ±0.010″ · bend ±1° · IR = t

### SHEET 1/1

# FF-1 · Channel with ears flat pattern, one piece (4 bends 90°, web on top)

11 ga 0.120″ (3.04 mm) · HR steel sheet A1011 CS · flat blank 20.142″ × 6.870″ · ≈ 3.89 lb each · QTY 1 per vehicle

FLAT PATTERN (as laser-cut, marked side up) | FORMED PART (after bending)

## BEND TABLE

Bend | Angle | Direction | Inside R | Order | Bend line position
B1 | 90.0° | DOWN (away) | R=t 0.120 | 1 | (3.389, 1.616) (16.004, 2.142)
B2 | 90.0° | DOWN (away) | R=t 0.120 | 2 | (4.137, 2.142) (16.752, 1.616)
B3 | 90.0° | DOWN (away) | R=t 0.120 | 3 | (4.166, 4.318) (15.893, 4.806)
B4 | 90.0° | DOWN (away) | R=t 0.120 | 4 | (4.248, 4.806) (15.976, 4.318)

## HOLES (centre from 0,0)

Hole | Size | X | Y | Made by
H1 | Ø0.250 | 0.552 | 1.644 | laser
H2 | Ø0.250 | 0.716 | 5.600 | laser
H3 | Ø0.250 | 3.299 | 1.530 | laser
H4 | Ø0.250 | 3.464 | 5.486 | laser
H5 | Ø0.250 | 16.678 | 5.486 | laser
H6 | Ø0.250 | 16.842 | 1.530 | laser
H7 | Ø0.250 | 19.425 | 5.600 | laser
H8 | Ø0.250 | 19.590 | 1.644 | laser
H9 | cut-out 1.249×0.531 | 1.670 | 1.473 | laser
H10 | cut-out 1.249×0.531 | 1.846 | 5.678 | laser
H11 | cut-out 1.249×0.531 | 18.296 | 5.678 | laser
H12 | cut-out 1.249×0.531 | 18.471 | 1.473 | laser

## FILES

- FF-1_cut.dxf (qty 1 / vehicle)
- FF-1_ref.dxf (reference: + bend lines, material notes)

## NOTES

1. Laser cut from the *_cut.dxf file (1:1, inch). The DXF governs the geometry; dimensions here are for checking.
2. MATERIAL HR steel sheet A1011 CS, 11 ga t = 0.1196″ (3.04 mm). Bend allowance (K = 0.44, inside radius = t) is already in the flat.

Bend on the orange lines; UP = toward you when the part lies as drawn.
3. Holes marked DRILL LATER (red dashed) are not laser cut - drill after bending/welding.
4. Deburr all edges, remove dross.
* one blank: the web is a chevron 6"+6" (ends ¼" out); bend the walls 90° down on the dashed lines, each in 2 hits (6" to the middle); outer wall has a V-notch - closes after bending, weld it; inner wall has a slit - opens after bending, weld it; the ears reach past the bend line; 1/16" relief slit
at the bend end

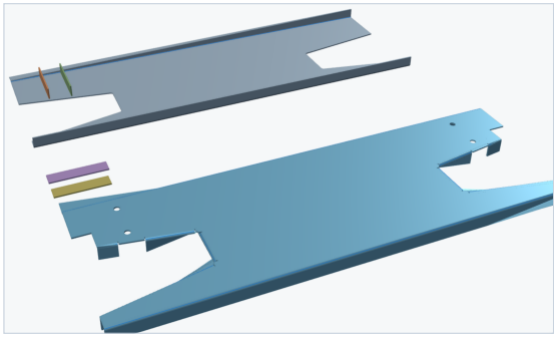
[picture p196: figure]
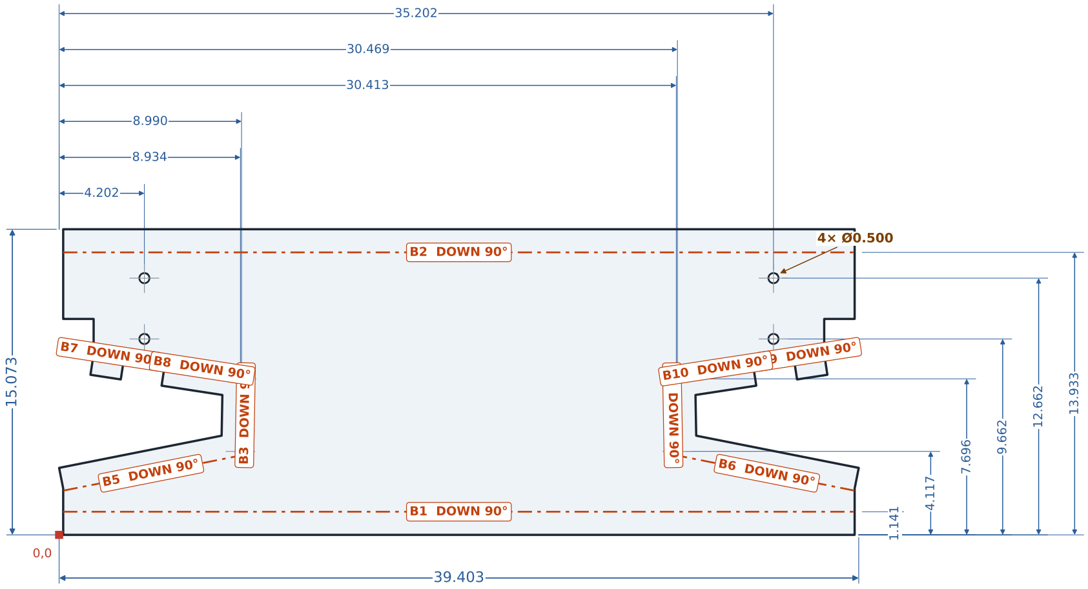
[picture p197: figure]
B1 DOWN 90°; B2 DOWN 90°; B3 DOWN 90°; B4 DOWN 90°; B5 DOWN 90°; B6 DOWN 90°; B7 DOWN 90°B8 DOWN 90°; B9 DOWN 90° B10 DOWN 90°

Bend | Angle | Direction | Inside R | Order | Bend line position
B1 | 90.0° | DOWN (away) | R=t 0.120 | 3 | Y = 1.141
B2 | 90.0° | DOWN (away) | R=t 0.120 | 4 | Y = 13.933
B3 | 90.0° | DOWN (away) | R=t 0.120 | 5 | (9.138, 4.256) (9.197, 7.546)
B4 | 90.0° | DOWN (away) | R=t 0.120 | 6 | (30.265, 4.256) (30.206, 7.546)
B5 | 90.0° | DOWN (away) | R=t 0.120 | 7 | (0.222, 2.185) (8.833, 3.892)
B6 | 90.0° | DOWN (away) | R=t 0.120 | 8 | (39.181, 2.185) (30.570, 3.892)
B7 | 90.0° | DOWN (away) | R=t 0.120 | 9 | (1.717, 9.022) (3.212, 8.793)
B8 | 90.0° | DOWN (away) | R=t 0.120 | 10 | (5.223, 8.486) (8.878, 7.926)
B9 | 90.0° | DOWN (away) | R=t 0.120 | 11 | (37.686, 9.022) (36.191, 8.793)
B10 | 90.0° | DOWN (away) | R=t 0.120 | 12 | (34.180, 8.486) (30.526, 7.926)
Hole | Size | X | Y | Made by
H1 | cut-out 0.513×0.516 | 30.326 | 7.802 | laser
H2 | Ø0.500 | 35.202 | 12.662 | laser
H3 | Ø0.500 | 35.202 | 9.662 | laser
H4 | cut-out 0.514×0.504 | 30.387 | 4.011 | laser
H5 | cut-out 0.513×0.516 | 9.077 | 7.802 | laser
H6 | cut-out 0.514×0.504 | 9.016 | 4.011 | laser
H7 | Ø0.500 | 4.202 | 12.662 | laser
H8 | Ø0.500 | 4.202 | 9.662 | laser
FF-3 | Cross box: top plate + lower plate + 4 passage walls
FF-3-1 · FF3-1 top plate | flat pattern, 10 bends 90° down

HR steel sheet A1011 CS 11 ga 0.120 (3.04 mm)

QTY 1 per vehicle

Tol.: cut ±0.010 · bend ±1° · IR = t

### REV A

SHEET 1/4

FF-3-1 · FF3-1 top plate | flat pattern, 10 bends 90° down
11 ga 0.120 (3.04 mm) · HR steel sheet A1011 CS · flat blank 39.403 × 15.073 | · | 17.70 lb each · QTY 1 per vehicle
FLAT PATTERN (as laser-cut, marked side up) | FORMED PART (after bending)

### BEND TABLE
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
