diademal/nyc-tlc-wav/drawings/MFG/FF-4_drawing.pdf

## MATERIAL: Square steel tube A500, 1 ½ × 1 ½

## WALL THICKNESS: 11 ga 0.120″ (3.04 mm)

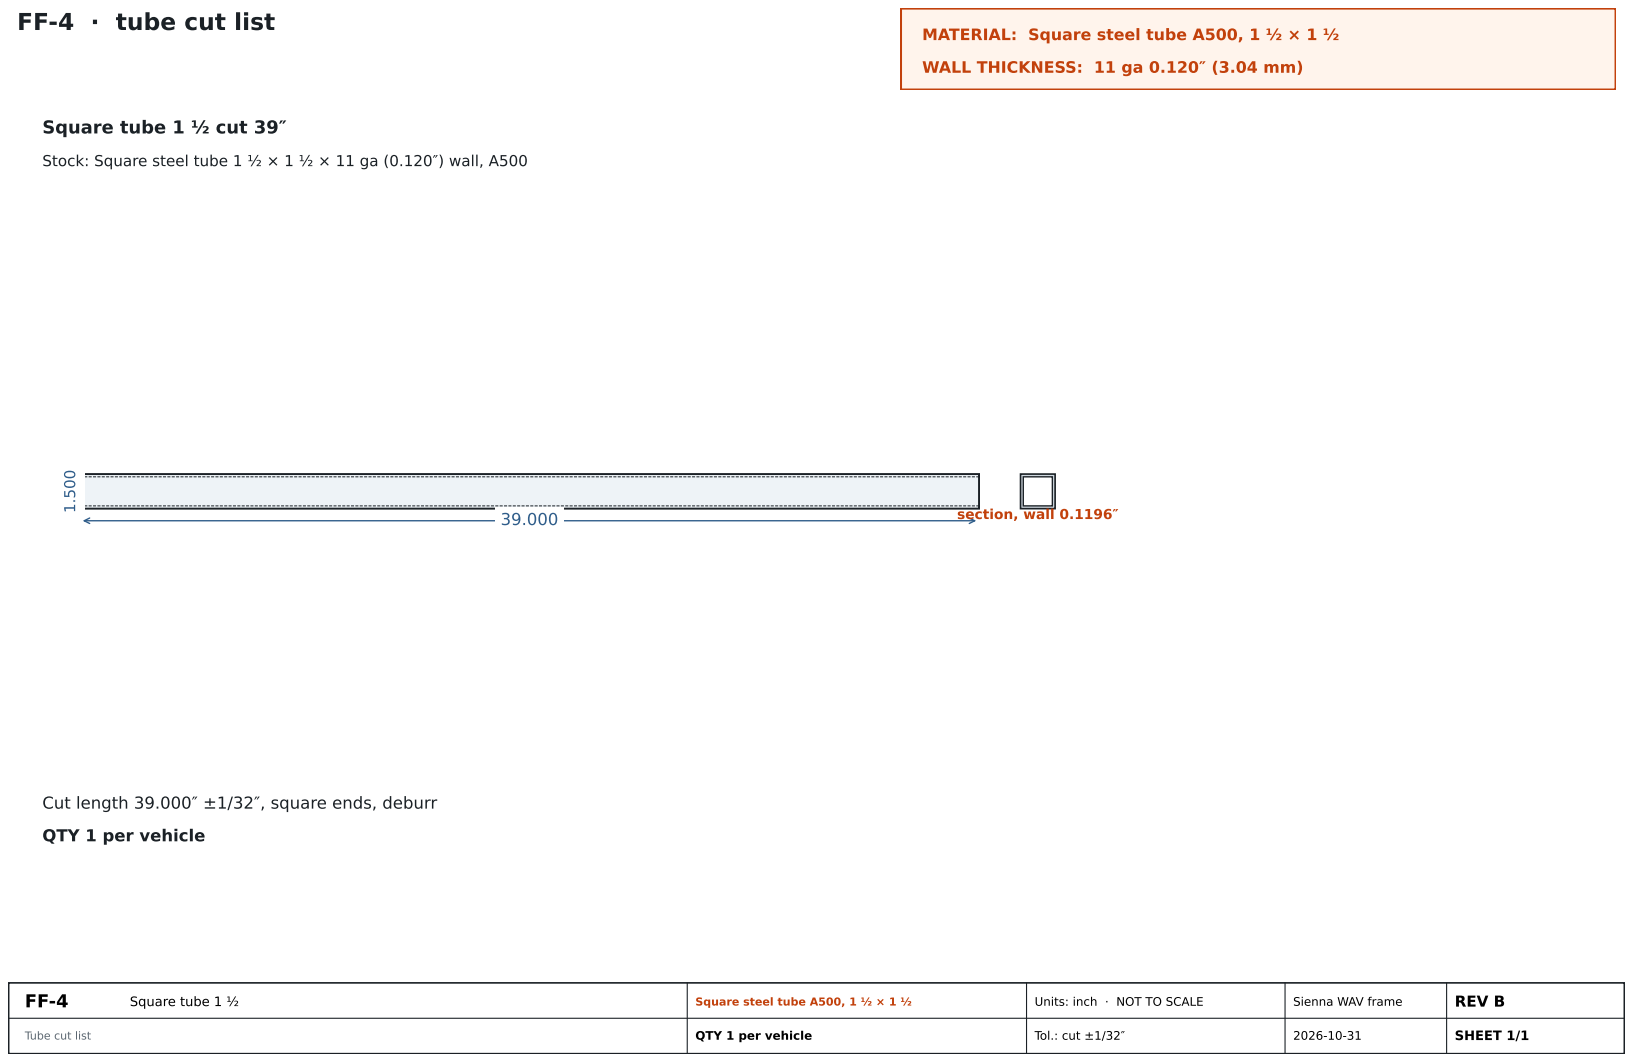
[picture p201: page 1]
section, wall 0.1196″

FF-4 · tube cut list

Square tube 1 ½ cut 39″

Stock: Square steel tube 1 ½ × 1 ½ × 11 ga (0.120″) wall, A500

Cut length 39.000″ ±1/32″, square ends, deburr

QTY 1 per vehicle

FF-4 Square tube 1 ½ | Square steel tube A500, 1 ½ × 1 ½ | Units: inch · NOT TO SCALE | Sienna WAV frame | REV B

Tube cut list | QTY 1 per vehicle | Tol.: cut ±1/32″ | 2026-10-31 | SHEET 1/1
