diademal/nyc-tlc-wav/drawings/MFG/RA-3_drawing.pdf

# RA-3 RAMP PLATE (Sienna WAV)

## BEND TABLE (all 90°, DOWN as drawn, IR 0.125)

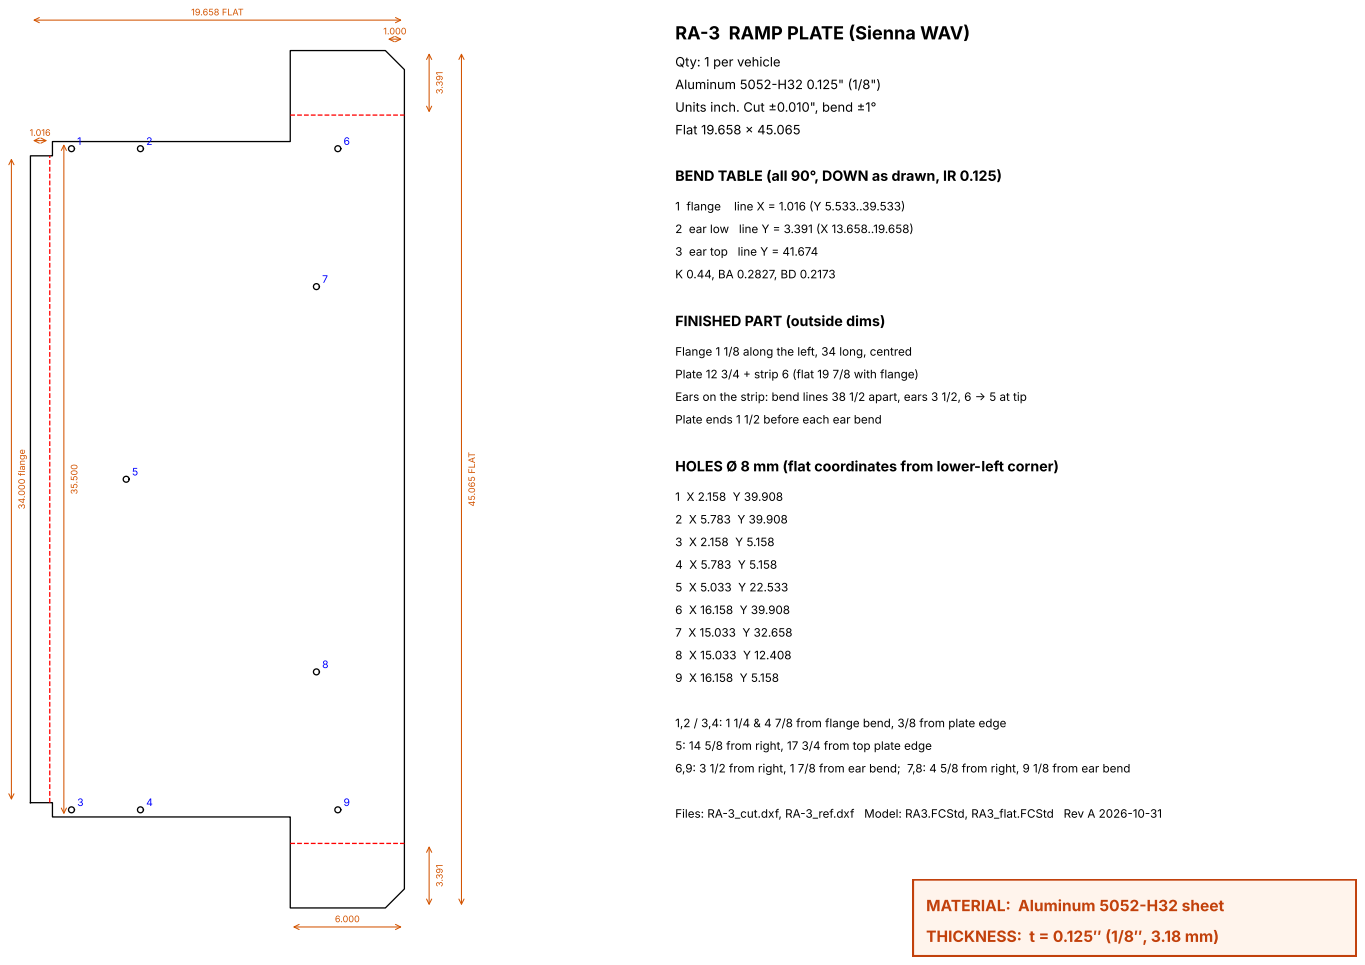
[picture p202: page 1]
19.658 FLAT; 45.065 FLAT; 34.000 flange; 1 flange line X = 1.016 (Y 5.533..39.533)

Qty: 1 per vehicle
Aluminum 5052-H32 0.125" (1/8")

Units inch. Cut ±0.010", bend ±1°
Flat 19.658 x 45.065

2 ear low line Y = 3.391 (X 13.658..19.658)

3 ear top line Y = 41.674

FINISHED PART (outside dims)

Flange 1 1/8 along the left, 34 long, centred
Plate 12 3/4 + strip 6 (flat 19 7/8 with flange)

Ears on the strip: bend lines 38 1/2 apart, ears 3 1/2, 6 -> 5 at tip

Plate ends 1 1/2 before each ear bend

HOLES Ø 8 mm (flat coordinates from lower-left corner)

1,2 / 3,4: 1 1/4 & 4 7/8 from flange bend, 3/8 from plate edge

5: 14 5/8 from right, 17 3/4 from top plate edge

6,9: 3 1/2 from right, 1 7/8 from ear bend; 7,8: 4 5/8 from right, 9 1/8 from ear bend

Files: RA-3_cut.dxf, RA-3_ref.dxf Model: RA3.FCStd, RA3_flat.FCStd Rev A 2026-10-31

MATERIAL: Aluminum 5052-H32 sheet
THICKNESS: t = 0.125″ (1/8″, 3.18 mm)
