diademal/nyc-tlc-wav/drawings/MFG/RA-5_drawing.pdf

# RA-5 RAMP ANGLE WITH TAB (Sienna WAV)

## BEND TABLE

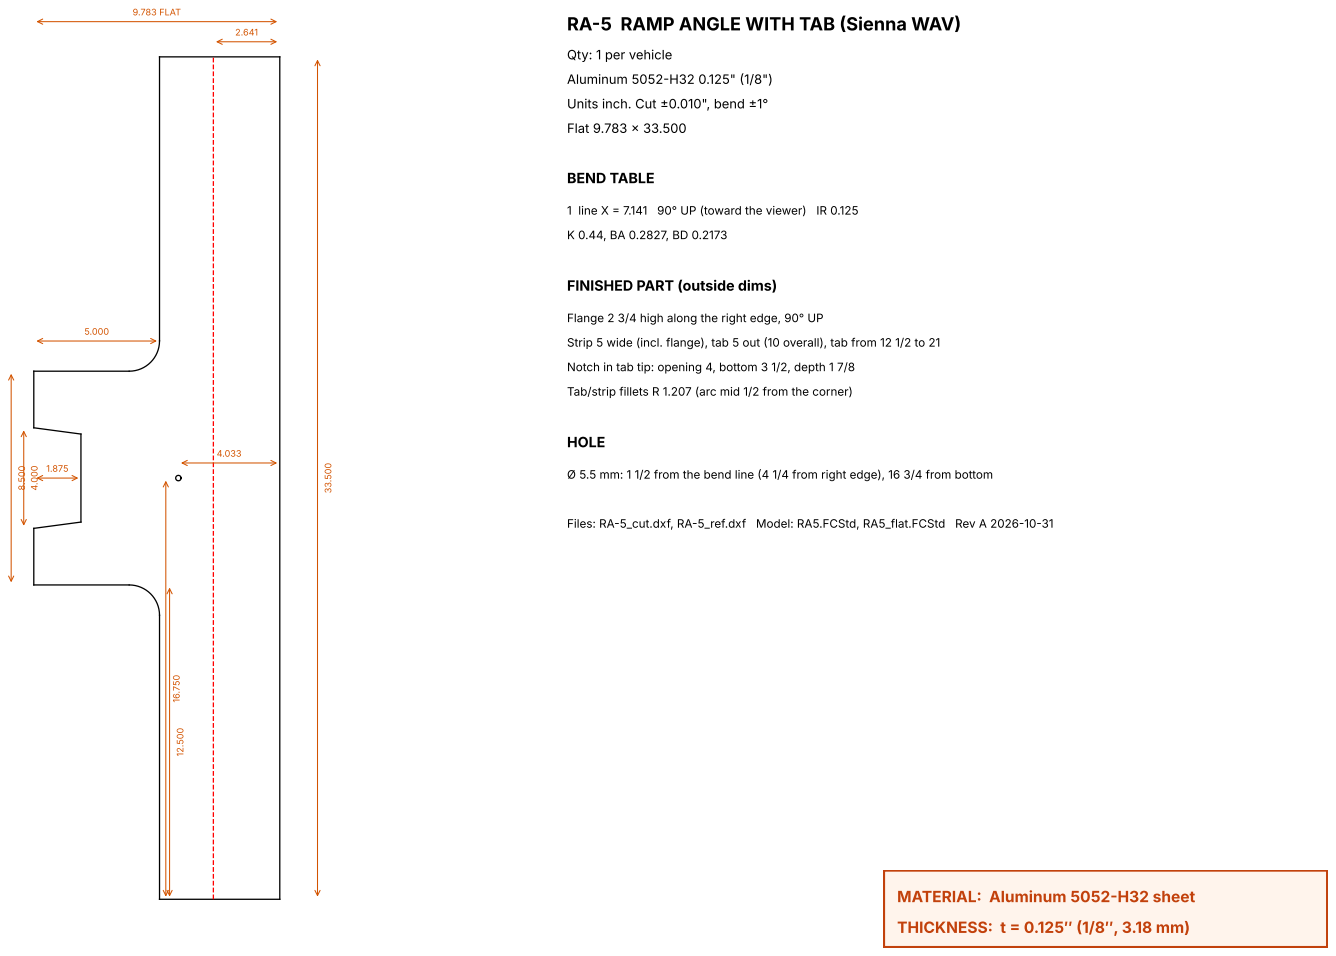
[picture p203: page 1]
9.783 FLAT; Aluminum 5052-H32 0.125" (1/8"); Flat 9.783 x 33.500; HOLE

Qty: 1 per vehicle

Units inch. Cut ±0.010", bend ±1°

1 line X = 7.141 90° UP (toward the viewer) IR 0.125

FINISHED PART (outside dims)

Flange 2 3/4 high along the right edge, 90° UP
Strip 5 wide (incl. flange), tab 5 out (10 overall), tab from 12 1/2 to 21

Notch in tab tip: opening 4, bottom 3 1/2, depth 1 7/8
Tab/strip fillets R 1.207 (arc mid 1/2 from the corner)

Ø 5.5 mm: 1 1/2 from the bend line (4 1/4 from right edge), 16 3/4 from bottom

Files: RA-5_cut.dxf, RA-5_ref.dxf Model: RA5.FCStd, RA5_flat.FCStd Rev A 2026-10-31

MATERIAL: Aluminum 5052-H32 sheet
THICKNESS: t = 0.125″ (1/8″, 3.18 mm)
