diademal/nyc-tlc-wav/drawings/MFG/RA-6_drawing.pdf

## RA-6 RAMP SPACER CHANNEL (Sienna WAV)

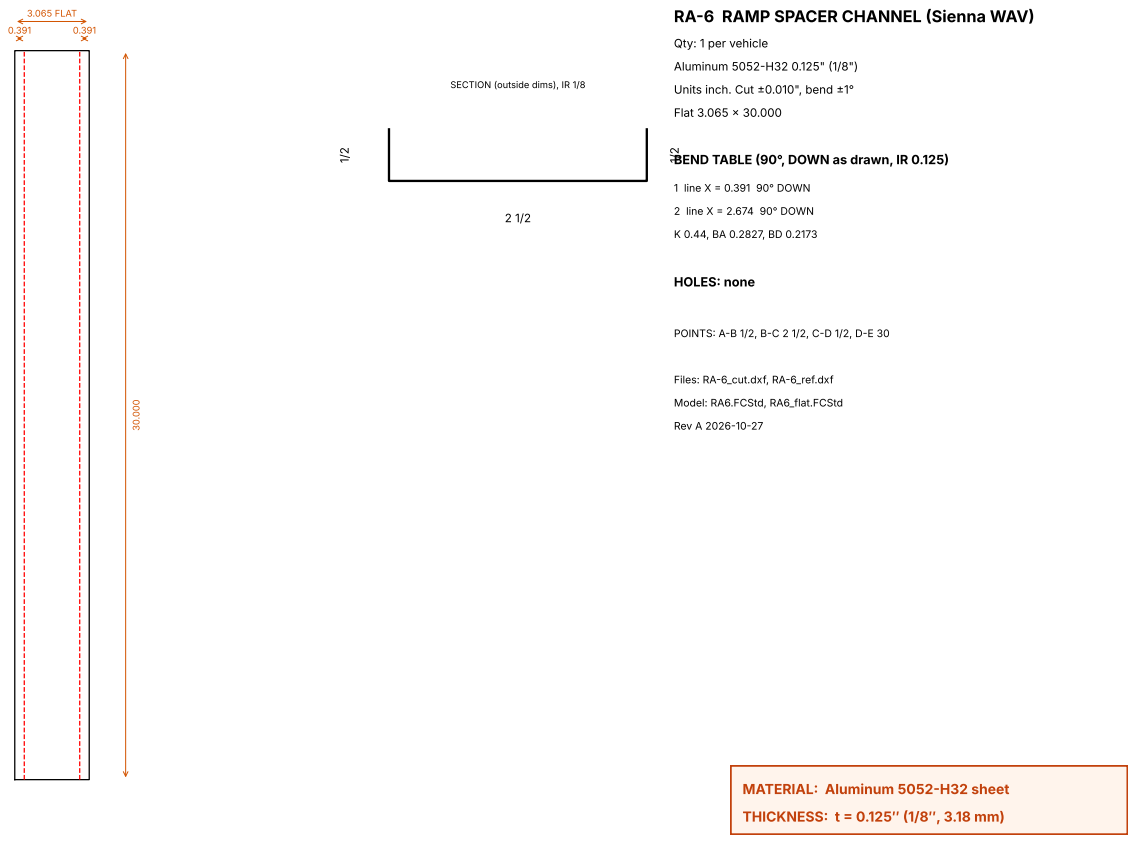
[picture p204: page 1]
3.065 FLAT; Flat 3.065 x 30.000; 1 line X = 0.391 90° DOWN; 2 line X = 2.674 90° DOWN; HOLES: none; POINTS: A-B 1/2, B-C 2 1/2, C-D 1/2, D-E 30; Rev A 2026-10-27

Qty: 1 per vehicle
Aluminum 5052-H32 0.125" (1/8")

SECTION (outside dims), IR 1/8

Units inch. Cut ±0.010", bend ±1°

BEND TABLE (90°, DOWN as drawn, IR 0.125)

Files: RA-6_cut.dxf, RA-6_ref.dxf

Model: RA6.FCStd, RA6_flat.FCStd

MATERIAL: Aluminum 5052-H32 sheet
THICKNESS: t = 0.125″ (1/8″, 3.18 mm)
