diademal/nyc-tlc-wav/drawings/MFG/RA-8_drawing.pdf

# RA-8 RAMP BRACKET (Sienna WAV)

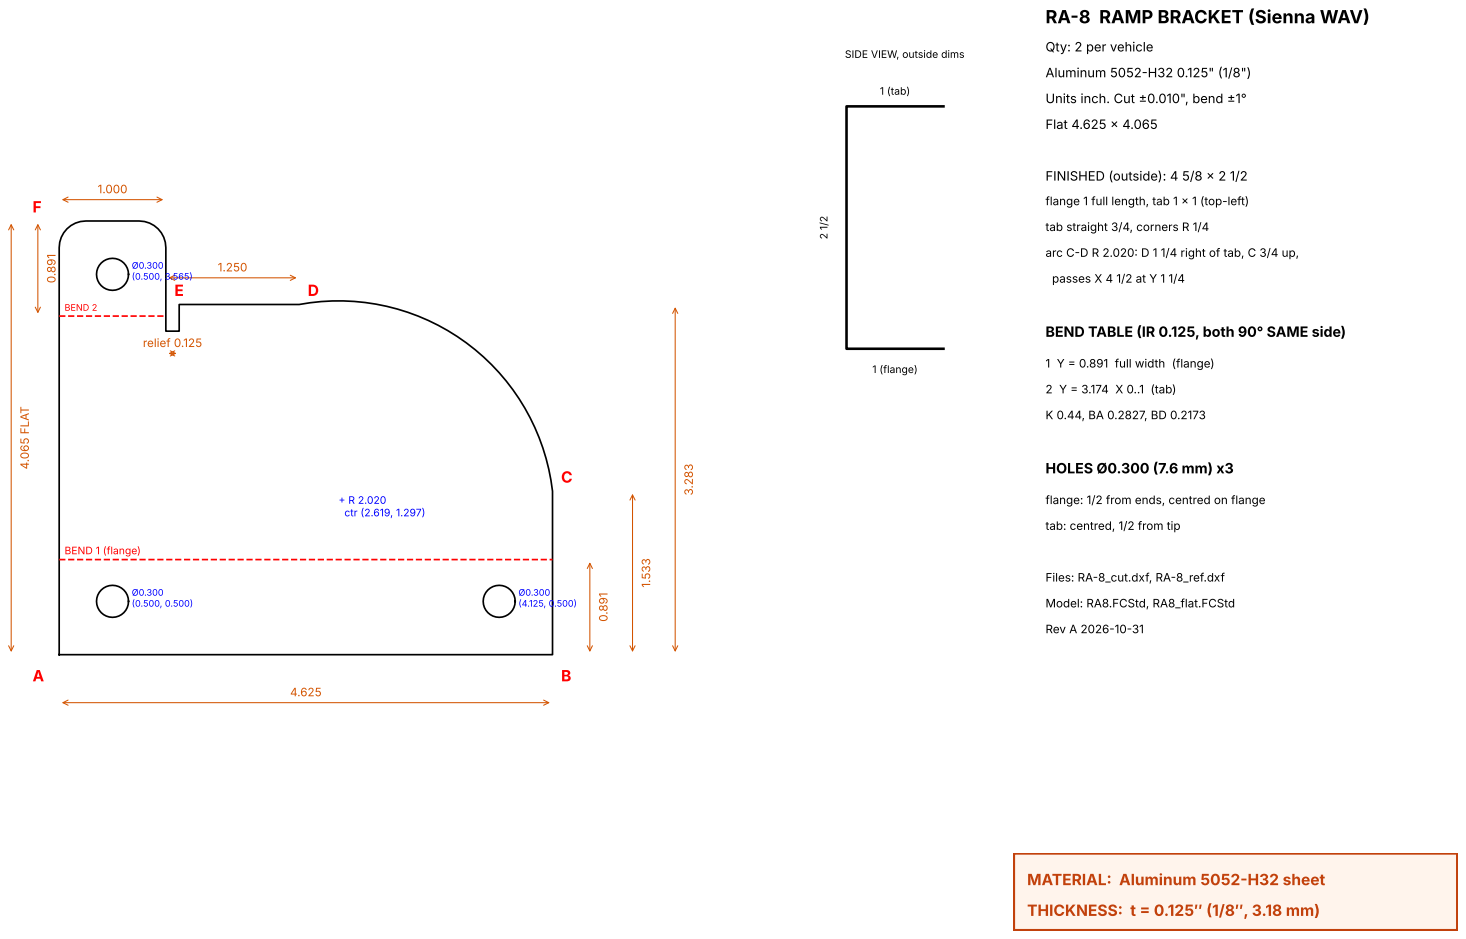
[picture p205: page 1]
4.065 FLAT; relief 0.125; + R 2.020 ctr (2.619, 1.297); BEND 1 (flange); BEND 2; 1 (flange); 1 (tab); Flat 4.625 x 4.065; FINISHED (outside): 4 5/8 x 2 1/2; passes X 4 1/2 at Y 1 1/4; 2 Y = 3.174 X 0..1 (tab); HOLES Ø0.300 (7.6 mm) x3; Rev A 2026-10-31

Qty: 2 per vehicle
Aluminum 5052-H32 0.125" (1/8")

SIDE VIEW, outside dims

Units inch. Cut ±0.010", bend ±1°

flange 1 full length, tab 1 x 1 (top-left)

tab straight 3/4, corners R 1/4

arc C-D R 2.020: D 1 1/4 right of tab, C 3/4 up,

BEND TABLE (IR 0.125, both 90° SAME side)

1 Y = 0.891 full width (flange)

flange: 1/2 from ends, centred on flange

tab: centred, 1/2 from tip

Files: RA-8_cut.dxf, RA-8_ref.dxf

Model: RA8.FCStd, RA8_flat.FCStd

MATERIAL: Aluminum 5052-H32 sheet
THICKNESS: t = 0.125″ (1/8″, 3.18 mm)
