diademal/nyc-tlc-wav/(commit log)

2026-08-28 Section-by-section navigation, back button, mobile layout
2026-08-28 Fixed top-right RU/EN and PDF buttons, compact left-aligned Back
2026-08-28 Add codes and standards glossary; pinned back button; menu counters
2026-09-26 Add assembled frame tab
2026-09-26 Frame: add FR-4 under FR-6
2026-09-26 Frame: FR-4 on top of FR-6
2026-09-26 Frame: FR-4 on top of FR-6 (mesh from FreeCAD)
2026-09-28 Frame: sketch spacing, FR-3, FR-2, FR-1
2026-09-28 FR-9 length 8; frame updated
2026-09-28 Frame: hide dimensions with hidden parts
2026-09-29 FF-1: holes 1-4 at 1 1/4 from bottom
2026-09-30 FF-3: parts FF3-1..4, take apart button
2026-09-30 FF-3: right frame on the plate
2026-09-30 Assemblies: Frame (whole), FR, FF; FF-3 page = FF-3 only
2026-09-30 FL (left side, FR mirrored); Frame = FF + FR + FL
2026-09-30 Flat patterns, cost for N vehicles, Frame link on main page
2026-09-30 FF-4 cross tube: part page, frame, flat, cost
2026-09-30 Parts menu: Home button to the main page
2026-09-30 Home button label in English
2026-09-30 Main page: Frame link at the end of the menu
2026-10-01 FR-10 bending plan in Flat, Frame part numbers
2026-10-01 FR/FL/FF assemblies: part numbers
2026-10-01 Drill-after-bending marks (FR-2, FR-10)
2026-10-01 FF-3: bent tabbed bands + slotted plates plan
2026-10-01 Frame: only FF/FR/FL blocks; FF3-1..4 parts in the menu
2026-10-01 FF-3 v10: rims instead of FF3-3 tubes / FF3-4 strips; FF-1 web on top; flats + bend plans
2026-10-02 v25: new thicknesses 0.138/0.118/0.197, new holes, FR-4 tube (1/4)
2026-10-02 v25: new thicknesses 0.138/0.118/0.197, new holes, FR-4 tube (2/2)
2026-10-03 v26: shop drawings (PDF + DXF) for all flat blanks
    [FF-1_1.dxf, FF-3_1.dxf, FF-3_2.dxf, FF-3_3.dxf, FF-3_4.dxf, FR-10-bent_1.dxf, FR-10-bent_2.dxf, FR-10_1.dxf]
2026-10-03 v27 drawings: 10 ga / 11 ga / 3/16 wall
    [FF-1_1.dxf, FF-3_1.dxf, FF-3_2.dxf, FF-3_3.dxf, FF-3_4.dxf, FR-10-bent_1.dxf, FR-10-bent_2.dxf, FR-10_1.dxf]
2026-10-03 v28: one-piece FF-1, FR-2, FR-7; FR-10 one tube instead of rings
2026-10-03 v28 drawings: FF-1, FR-2, FR-7 one piece; FR-10 tube
    [FF-1_1.dxf, FR-10-bent_1.dxf, FR-10-bent_2.dxf, FR-10_1.dxf, FR-10_2.dxf, FR-10_3.dxf, FR-10_4.dxf, FR-10_5.dxf]
2026-10-04 v29: MFG drawings + DXF (production set)
    [FF-1_cut.dxf, FF-1_ref.dxf, FF-3-1_cut.dxf, FF-3-1_ref.dxf, FF-3-2_cut.dxf, FF-3-2_ref.dxf, FF-3-3_cut.dxf, FF-3-4_cut.dxf]
2026-10-31 v30: frame flats recalculated for 11 ga (MFG rev B), ramp RA-1..RA-8 page, material + thickness on every page
    Claude-Session: https://claude.ai/code/session_015y7nuqeLJoNen84cqwZ5np
2026-10-31 v31: 3D pages for ramp parts RA-1..RA-8 (finished part + flat, points, dimensions, material)
    Claude-Session: https://claude.ai/code/session_015y7nuqeljonen84cqwz5np
2026-10-31 v32: ramp works like frame - RA overview in 3D, top 3D/Flat toggle, RA flats with bend labels
    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
2026-11-01 v33: ramp assembly 3D (RA-7 + RA-5 + RA-3 + RA-2 + RA-1 + hinge bolts), step-by-step, take apart, per-part on/off
    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
2026-11-01 v34: RA Assembly in the parts menu (Ramp group)
    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
2026-11-01 v35: RA-1+2 hinge player (ra12-player.html) in the Ramp menu
    Claude-Session: https://claude.ai/code/session_01RMGEWsz5UtdhXrqBxiGoUb
2026-11-01 v35: RA-1 + RA-2 hinge block page with opening player (0-180 deg), in the parts menu
    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
2026-11-01 v36: RA-1+2 Hinge (ra-hinge.html) in the Ramp menu next to RA-1+2 Player
2026-11-02 v37: Strut (ST) group - ST-1 shock plate, ST-2 strut plate, ST-3 tube (3D + flat)
    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
2026-11-02 v38: same 3D / Flat interface for every menu item - ST flats (ST-1, ST-2, ST-3 tube) in flat.html, Flat for RA Assembly / RA-1+2 blocks, st3d uses the top 3D/Flat switch
    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
2026-11-02 v39: RA parts rebuilt from FreeCAD (RA-1 lug, RA-2, RA-4 Z-section, RA-7 no front lip), RA-4 in the assembly + assembly video, 'Video' inside the 3D tab for every part (bend.html generic bending / tu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
2026-11-02 v40: ramp assembly video - RA-7, RA-5 + RA-4 inside (4 bolts), RA-3 under the lips, RA-2 on top, RA-1 joins opened 180 deg and folds onto RA-2; new RA-4 / RA-5 positions
    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
2026-11-02 v41: video players inside the 3D pages (video-card.js, same player as the frame bending plans); ramp assembly video ra-video.html in order RA-7, RA-4, RA-5, RA-3, RA-2, RA-1 (opens and folds); Englis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
2026-11-02 v42: Laser sheets page - 1 vehicle set nested on 48x96 sheets (steel 11 ga: FR+FL+FF+ST, aluminum 0.125: RA), CUT / MARKED DXF + PDF + CSV + ZIP, tube cut list; ST-1/ST-2 DXF; RA DXF holes as true ci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
2026-11-02 v43: RA-8 brackets in the ramp assembly (page + video, 2x 8 mm bolts), RA-3L = RA-3 with the M&N WAV + wheelchair logo cut (part page, flat, DXF/PDF, bend video), RA-3 plain/logo switch in the assemb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
2026-11-02 v44: RA-9 stainless backing plate behind the RA-3L logo (part page, flat, DXF/PDF, in the assembly + video); video players: part-name toggle (off by default) and 'Keep centred' checkbox on every bend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
2026-11-02 v45: RA-9 stainless plate 21 1/2 x 8 3/4 clamped by the two RA-3 8 mm bolts below the name (FreeCAD geometry, hole offset 0.004)
    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
2026-11-02 v46: assembly video - RA-9 is bolted to RA-3 below the box first (2 bolts), then RA-3 + RA-9 go up under the RA-7 lips
    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
2026-11-02 v47: RA-3A (M&N / AUTO GROUP text) and RA-3B (wheelchair instead of &) — 3D, flat, bend video, PDF/DXF; 4-way RA-3 version switch in assembly and video; material badge fix for generic player
    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
2026-11-02 v48: RA-3 on the site = RA-3A / RA-3B only (2-way switch, RA-3A default); RA-3L removed from menu and lists; laser nesting unchanged
    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
2026-11-02 v49: RA-3 A/B selector moved next to the view buttons on the assembly page; 3D label reads RA-3A / RA-3B; model and video stay in sync
    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
2026-11-02 v50: laser sheets — RA-3 replaced by RA-3A (M&N / AUTO GROUP stencil); RA-9 stainless 18 ga on a 12 x 24 piece; laser.json, CSVs, ZIP, README updated
    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
